IowaScaledEngineering/ckt-defect/doc/configuration-encoding/configuration_encoding_proposal.md

# DetectorConfiguration Alphanumeric Serialization & Offline Decoding Specification

> **Status:** IMPLEMENTED & VERIFIED (Schema v1 · 241 bits · ~49 Crockford Base32 characters)  
> **Target Hardware:** ESP32-S2 Defect Detector (`ckt-defect`) · 20x4 Character LCD  
> **Build Integration:** Automated Pre-Build Code Generator (`tools/gen_codec.py`)  

## 1. Executive Summary & Constraints

### 1.1 Objective
Design a C++ function for the ESP32-S2 Defect Detector (`ckt-defect`) firmware that serializes the active state of `DetectorConfiguration` ([`ckt-defect/configuration.h`](file:///home/data/design/projects/ckt-defect/src/ckt-defect/configuration.h)) into a compact alphanumeric string. The string must:
1. Fit within **at most 3 lines of a 20x4 LCD** (maximum 60 characters total, including any formatting).
2. Embed a **schema version number** allowing offline tools (Python on a PC) to unambiguously unpack it into each variable's value.
3. Decouple the packing metadata from the string itself, enabling the schema to be version-tracked in Git or exported as a machine-readable artifact during firmware compilation.
4. Provide **headroom for future expansion** (new configuration fields) without breaking the LCD display budget.

---

### 1.2 Mathematical & Physical Constraints

```
+--------------------+  <- 20 columns wide
|Line 0: 20 chars    |  Row 0: Code characters 1–20 (No title)
|Line 1: 20 chars    |  Row 1: Code characters 21–40
|Line 2: 20 chars    |  Row 2: Code characters 41–60 (padded with spaces)
|                BACK|  Row 3: Button 4 (col 16) = BACK navigation
+--------------------+
 [Btn 1] [Btn 2] [Btn 3] [Btn 4]
```

* **Screen Budget for Configuration Code:** Exactly 3 lines $\times$ 20 characters = **60 characters maximum**.
* **Navigation Line:** The 4th line (Row 3) is reserved exclusively for navigation, featuring a **`BACK`** button in the 4th position (columns 16–19), perfectly aligned with physical Button 4 to match the standard UI pattern across all other status/sub-menus.
* **No Title Overhead:** To maximize storage density within the 4-line display, the menu displays **no title header**. Rows 0, 1, and 2 are dedicated 100% to displaying the configuration code.
* **Hyphen Elimination & Headroom:** Stripping hyphens allows the raw alphanumeric code to use the full 60 character slots (3 lines $\times$ 20 cols), unlocking **37.5 bytes (300 bits)** of storage in Crockford Base32. The current configuration payload (~28–30 bytes) requires only ~45 characters, occupying 2 full lines plus 5 characters on line 2, leaving **15 character slots (~75 bits) of unused headroom** for future firmware expansion.

#### Encoding Data Capacities (for 48 to 60 Characters)

| Encoding Scheme | Alphabet | Bits/Char | Max Raw Bytes (60 chars) | Max Raw Bytes (48 chars) | Human Legibility on 5x8 Dot-Matrix LCD |
| :--- | :--- | :--- | :--- | :--- | :--- |
| **Crockford Base32** | `0-9`, `A-Z` (no `I`, `L`, `O`, `U`) | 5.00 | **37.5 bytes** | **30.0 bytes** | **Excellent.** Case-insensitive, eliminates visual collisions (`0/O`, `1/I/l`), accepts arbitrary hyphens. |
| **Base58** (Bitcoin) | `1-9`, `A-Z`, `a-z` (no `0`, `O`, `I`, `l`) | 5.86 | **43.9 bytes** | **35.1 bytes** | **Good.** Pure alphanumeric, eliminates confusing characters, but case-sensitive. |
| **Base62** | `0-9`, `a-z`, `A-Z` | 5.95 | **44.6 bytes** | **35.7 bytes** | **Fair.** Case-sensitive; `0/O` and `1/I/l` look identical on dot-matrix displays. |
| **Base64** | `A-Z`, `a-z`, `0-9`, `+`, `/` | 6.00 | **45.0 bytes** | **36.0 bytes** | **Poor.** Not strictly alphanumeric (`+`, `/`, `=` padding). |
| **Hexadecimal (Base16)**| `0-9`, `A-F` | 4.00 | **30.0 bytes** | **24.0 bytes** | **Fair.** Lowest density; cannot fit all configuration variables. |

---

## 2. Configuration Field Analysis & Storage Budget

The `DetectorConfiguration` struct contains 56 members. An analysis of the codebase reveals that runtime volatile and derived members must be excluded from serialization.

### 2.1 Excluded Members (Volatile / Derived / Hardware State)
* `trackName[NUM_TRACKS]` (`std::string`): Derived at runtime via `trackNames[trackNameId[i]]`.
* `direction1Name`, `direction2Name` (`std::string`): Derived from `directionNames[direction1NameId]`.
* `railName` (`std::string`): Derived from `railNames[railNameId]`.
* `externalVocabPresent` (`bool`): Runtime hardware check (SD card / SPIFFS availability).
* `vocabsAvailable` (`std::vector<std::string>`): Directory scan results loaded into memory at startup.

### 2.2 Persistent Members & Bit Allocation

If serialized naively as a standard C struct, memory alignment, struct padding, and full 32-bit types produce **~81 bytes**, which exceeds the 60-character LCD limit.

By analyzing the actual functional ranges configured in `menu-factory.cpp` and `configuration.cpp`, we can calculate the exact minimum bits required:

| Field Name | Type in C++ | UI / Functional Range | Bits Required | Encoding Technique |
| :--- | :--- | :--- | :--- | :--- |
| `schemaVersion` | Header | 1 .. 63 | **6 bits** | Embedded in header |
| **21 Boolean Flags** | `bool` | `true` / `false` | **21 bits** | Packed bitfield |
| `volumeStep` | `uint8_t` | 0 .. 31 | **5 bits** | Unsigned integer |
| `noiseStep` | `uint8_t` | 0 .. 15 | **4 bits** | Unsigned integer |
| `popcornStep` | `uint8_t` | 0 .. 15 | **4 bits** | Unsigned integer |
| `pttDelay` | `uint8_t` | 0 .. 30 (0..3000 ms / 100) | **5 bits** | Unsigned integer |
| `lcdBrightness` | `uint8_t` | 0 .. 255 | **8 bits** | Unsigned integer |
| `milepost` | `uint16_t` | 0 .. 9999 (0.0 to 999.9) | **14 bits** | Unsigned integer |
| `trackNameId[0..1]` | `uint8_t[2]`| 0 .. 7 each | **6 bits** (3 bits × 2) | Index into `trackNames` |
| `direction1NameId` | `uint8_t` | 0 .. 7 | **3 bits** | Index into `directionNames` |
| `direction2NameId` | `uint8_t` | 0 .. 7 | **3 bits** | Index into `directionNames` |
| `railNameId` | `uint8_t` | 0 .. 2 | **2 bits** | Index into `railNames` |
| `entranceAxles` | `uint16_t` | 0 .. 10 | **4 bits** | Unsigned integer |
| `minAxles` | `uint16_t` | 0 .. 100 | **7 bits** | Unsigned integer |
| `minSpeed` | `uint8_t` | 0 .. 50 | **6 bits** | Unsigned integer |
| `speedScale` | `uint16_t` | 0 .. 999 (0.0 to 99.9) | **10 bits** | Unsigned integer |
| `detectorTimeout` | `uint8_t` | 2 .. 30 sec | **5 bits** | Unsigned integer |
| `summaryDisplayTime` | `uint8_t` | 2 .. 60 sec | **6 bits** | Unsigned integer |
| `msgRepeatTimeout` | `uint8_t` | 2 .. 60 sec | **6 bits** | Unsigned integer |
| `minTemperatureC` | `float` | -99 .. +150 °C/°F | **9 bits** (signed int) | Scaled integer degrees |
| `maxTemperatureC` | `float` | -99 .. +150 °C/°F | **9 bits** (signed int) | Scaled integer degrees |
| `ordinalTypeId` | `uint8_t` | 0 .. 5 | **3 bits** | Index into `ordinalTypes` |
| `maxDefects` | `uint8_t` | 0 .. 15 | **4 bits** | Unsigned integer |
| `minAxleTime` | `uint8_t` | 0 .. 250 (0..25000 us / 100) | **8 bits** | Unsigned integer |
| **7 Defect Rates** | `uint32_t[7]` | Typically 100 .. 500 (max 999,999) | **~10–14 bytes** | Varint (LEB128) or 20-bit |
| `vocabSelected` | `std::string` | `""` (internal) or folder name | **1–2 bytes** | `0x00` if empty, or hash/ID |
| `crcCheck` | Checksum | CRC-16-CCITT | **16 bits (2 bytes)** | Error detection |

* **Total Bit-Packed Payload Size:** **28 to 32 bytes** (depending on defect rate magnitudes).
* **Headroom Remaining:** In Crockford Base32 (up to 37.5 bytes for 60 chars), this leaves **5.5 to 9.5 bytes (~44 to 76 free bits)**. In Base58 (up to 43.9 bytes), it leaves **11 to 15 bytes (~88 to 120 free bits)** for future firmware additions.

---

## 3. Proposal Options

### Proposal A: Bitstream Serialization with Varints & Crockford Base32 (Recommended)
This approach delivers the best balance of density, legibility, and expansion headroom.

* **Payload Layout:**
  1. `Header Byte` (8 bits): Schema Version (6 bits) + Payload Flags (2 bits).
  2. `Packed Flags` (3 bytes = 24 bits): All 21 configuration booleans + 3 spare bits.
  3. `Core Numeric Block` (14 bytes): Fixed-width bit-packed fields for speed, temperatures, delays, and names.
  4. `Defect Rates Block` (7–14 bytes): Varint (LEB128) encoded rates. Rates under 128 consume 1 byte; rates under 16,384 consume 2 bytes.
  5. `Vocab Field` (1 byte): `0x00` if default internal vocab; otherwise a 1-byte hash or index.
  6. `CRC-16 Checksum` (2 bytes): Detects human transcription errors.
* **Text Representation:** Crockford Base32 (0–9, A–Z omitting I, L, O, U).
* **LCD Display Format:** Lines 0–2 display code (up to 20 chars per line, no title); Line 3 displays `BACK` at column 16:
  ```
  +--------------------+
  |4N7K98DF21MAZ04B9PQ2|  Row 0: Code chars 1–20 (No title)
  |C117K8LXW409A7B2C3D4|  Row 1: Code chars 21–40
  |E5F6G7H8J9K0        |  Row 2: Code chars 41–60 (padded with spaces)
  |                BACK|  Row 3: Button 4 = BACK
  +--------------------+
  ```
* **Pros:**
  * Case-insensitive entry on PC.
  * No ambiguous characters (`0/O`, `1/I/l`) on dot-matrix LCD.
  * High headroom: currently requires only ~45 characters, leaving line 2 mostly free for future expansion.
* **Cons:** Requires a bitstream reader/writer helper in C++ and Python (approx. 40 lines of code).

---

### Proposal B: Direct `#pragma pack(push, 1)` Struct with Base58
This approach avoids bit-level manipulation by using byte-aligned fields and bitfields in C++.

* **Payload Layout:**
  A fixed 36-byte packed C struct where booleans are unified in `uint32_t flags`, temperatures are `int16_t`, and defect rates are truncated to 24-bit unsigned integers.
* **Text Representation:** Base58 (Bitcoin alphabet).
* **LCD Display Format:** Lines 0–2 display code (up to 20 chars per line, no title); Line 3 displays `BACK`:
  ```
  +--------------------+
  |2gK8pLmQ3wXyZ9v1aB4c|  Row 0: Code chars 1–20 (No title)
  |DeFgHjKmNpQrStUvWxYz|  Row 1: Code chars 21–40
  |23456               |  Row 2: Code chars 41–60 (padded with spaces)
  |                BACK|  Row 3: Button 4 = BACK
  +--------------------+
  ```
* **Pros:** Simplest C++ firmware implementation (direct `memcpy` into struct).
* **Cons:** Base58 is case-sensitive, making manual typing from the LCD more error-prone. Less headroom than Proposal A.

---

### Proposal C: Annotated Header-Driven Auto-Generated Codec (Selected Architecture)
Instead of requiring manual authoring or maintenance of a separate YAML schema file, **the C++ header itself is the human-edited source of truth**.

Lightweight comment annotations are placed directly in [`ckt-defect/configuration.h`](file:///home/data/design/projects/ckt-defect/src/ckt-defect/configuration.h) above and within `struct DetectorConfiguration`:
```cpp
// ============================================================================
// CONFIG CODEC ANNOTATIONS & PACKING SPECIFICATION
// ============================================================================
// Inline comments define bitstream serialization for the 20x4 LCD code.
//
// Supported Annotations:
//   • bool                 : Implicit 1-bit allocation (no annotation needed).
//   • @bits: <1..32>       : Dense bit packing for bounded unsigned integers.
//                            Enforces: static_assert(FIELD_MAX < (1 << BITS)).
//   • @type: varint        : LEB128 variable-length integer (7 payload bits/byte).
//                            Best for open-ended or wide dynamic range (defect rates).
//   • @offset: <N>         : Linear bias offset added before packing (e.g. for signed).
//
// Decision Matrix: When to use Varint vs. Fixed Bits (@bits: N):
//   • Bounded UI dial / enum (MAX <= 255)  --> Use @bits: N (Dense packing, saves bits)
//   • Defect trigger rates (0 to millions) --> Use @type: varint (Dynamic, future-proof)
//   • Total bit budget                     --> Combined bits MUST be <= 300 (60 Base32 chars)
// ============================================================================
struct DetectorConfiguration {
    // Booleans automatically default to 1 bit (no annotation needed!)
    bool     milepostEnable;
    bool     speedEnable;

    // Numerical fields with custom bit widths or offsets
    uint8_t  volumeStep;                // @bits: 5
    uint8_t  noiseStep;                 // @bits: 4
    uint16_t milepost;                  // @bits: 14 (Units = decimiles)
    uint8_t  minSpeed;                  // @bits: 6
    float    minTemperatureC;           // @offset: 100, bits: 8

    // Defect rates (automatically encoded as LEB128 Varints)
    uint32_t defectHotJournalAxleRate;  // @type: varint
};
```

```
          ckt-defect/configuration.h (Struct, Limits, & @annotations)
                                    +
          ckt-defect/configuration.cpp (preferences.put* calls)
                                    |
                                    v (make compile / pre-build)
                           tools/gen_codec.py
                                    |
            +-----------------------+-----------------------+
            |                                               |
            v                                               v
tools/schemas/schema_v1.yaml                     ckt-defect/config_codec.h
(Auto-built & committed to Git                   (Auto-injected into C++ build
for historical PC decoding)                       with static_assert guards)
```

* **Build Integration:**
  A Python build script `tools/gen_codec.py` runs before `arduino-cli compile` in the [`Makefile`](file:///home/data/design/projects/ckt-defect/src/Makefile). It:
  1. Parses `configuration.h` to extract variables, annotations, and `#define ..._MAX` limits.
  2. Parses `configuration.cpp` to verify 100% NVM coverage against `preferences.put*`.
  3. Auto-generates/updates `tools/schemas/schema_v1.yaml` (so the human developer never touches YAML directly).
  4. Generates `ckt-defect/config_codec.h` with C++ packing logic, LEB128 Varints, CRC-16, Base32, and `static_assert` bounds checks.
  5. Updates `tools/unpack_schema.py` for the PC decoder.
* **Pros:**
  * **Zero double-entry:** The developer only ever edits C++ files (`configuration.h` and `configuration.cpp`).
  * **Self-documenting:** Packing bit-widths and ranges are documented right next to struct variables.
  * **Zero drift:** It is impossible for C++ firmware and PC tools to disagree on bit order, widths, or scaling.
  * **Automated YAML artifact:** `schema_v1.yaml` is generated and committed to Git for historical tracking without manual YAML authoring.

---

### 3.4 Comparison: Manual Dual Maintenance vs. Annotated Header Codec

| Dimension | Proposal A: Manual Dual Maintenance | Proposal C: Annotated Header Codec (Selected) |
| :--- | :--- | :--- |
| **Wire Format & Output** | Identical (~44–48 chars, Base32, CRC-16) | Identical (~44–48 chars, Base32, CRC-16) |
| **Source of Truth** | C++ code in `config_pack.cpp` | Annotated `configuration.h` |
| **Files Edited by Developer** | `configuration.h` + `config_pack.cpp` + `unpack_config.py` | **Only `configuration.h` and `configuration.cpp`** |
| **YAML Authoring** | None | **None (Auto-generated by build script)** |
| **Risk of Schema Drift** | **Moderate.** Manual sync required between C++ and Python | **Zero.** Generator compiles both firmware header and Python unpacker |
| **Range Safety Enforcement** | Manual audit | **C++ Compiler `static_assert` guards** |
| **NVM Coverage Check** | Manual audit | **Automated Pre-Build Guard** |

---

## 4. Schema Versioning & PC Offline Unpacking

### 4.1 Schema Version Lifecycle: When Is It Incremented?

A critical architectural decision is separating the **Schema Version** from the **Firmware / Build Revision**:

> **The Schema Version is incremented ONLY when the binary layout or configuration fields change.** It is NOT incremented on every compile.

#### Rationale:
1. **Bit Budget in the 20x4 LCD String:** The version header in the packed string is allocated only **6 bits** (values 0–63) to preserve maximum character headroom on the LCD. Incrementing the schema version on every compile or daily build would exhaust the version space within weeks.
2. **Preventing Decoder Explosion:** If the version bumped on every build, the offline Python tool would require a new decoder entry for every bugfix build, UI tweak, or audio adjustment, even though the configuration layout was completely unchanged.
3. **Cross-Build Interoperability:** Two devices running different firmware revisions (e.g., `v1.2.14` and `v1.2.18`) share the same configuration layout and can be decoded by the exact same logic.

#### Distinction Between Schema Version and Firmware Revision:

| Concept | What It Represents | When It Changes | Example Values | Where It Lives |
| :--- | :--- | :--- | :--- | :--- |
| **Schema Version** | Structural binary layout of configuration bits | Only when fields are added, deleted, resized, or reordered | `1`, `2`, `3` | Embedded in the 6-bit string header |
| **Firmware Revision / Git Hash** | Exact binary snapshot / commit in Git | Every commit or build | `v1.2.34+`, `b68d5d5` | `Makefile`, `git-revision.sh`, exported JSON manifest |

#### How the Linking Works:
1. **Inside the String:** The string header carries only the compact **Schema Version** (`v1`).
2. **In the Build System (`Makefile`):** When building firmware, the `Makefile` exports a build manifest linking the Git revision to the Schema Version:
   ```json
   {
     "schema_version": 1,
     "git_revision": "b68d5d5",
     "firmware_version": "v1.2.34",
     "timestamp": "2026-10-25T20:20:00Z"
   }
   ```
3. **In the Python Decoder:** A version dispatch registry maps schema versions to parsing functions and known firmware ranges:
   ```python
   SCHEMA_REGISTRY = {
       1: {"firmware_range": "v1.0.0 – v1.4.x", "decoder": unpack_v1},
       2: {"firmware_range": "v2.0.0+",         "decoder": unpack_v2},
   }
   ```

### 4.2 Development Lifecycle vs. Release Freeze

A common developer question is: *While actively developing, can I keep the schema version constant even though fields change, and only freeze it at release time?*

**Yes, absolutely.** That is the standard industry workflow:

```
[ Active Development Phase ]                 [ Release Freeze ]
  Keep version = 1                             Tag release in Git (e.g. v1.0.0)
  Tweak/add/remove fields freely    ----->     Freeze schema_v1.yaml forever
  Firmware & PC stay in sync locally           Ship firmware to field
                                                       |
                                                       v
                                            [ Next Dev Cycle Starts ]
                                              Bump to version = 2
                                              Develop freely at v2...
```

1. **During Active Development:**
   * Keep `CONFIG_SCHEMA_VERSION = 1` in `configuration.h` and `schema_v1.yaml`.
   * As fields are added, modified, or resized, every `make compile` updates both the firmware header (`config_codec.h`) and local Python unpacker simultaneously.
   * Bench boards and the local PC script remain 100% in lockstep.
2. **At Firmware Release:**
   * Freeze and commit `tools/schemas/schema_v1.yaml` to Git alongside the release tag.
   * This definition becomes immutable. Any detector running that firmware will always unpack with `schema_v1`.
3. **Starting the Next Release Cycle:**
   * When future work begins requiring breaking configuration layout changes, bump `CONFIG_SCHEMA_VERSION = 2`.
   * Create `tools/schemas/schema_v2.yaml` (draft) and repeat the cycle. Over years of deployment, only a few schema versions (`v1, v2, v3`) will ever exist.

---

### 4.3 Future Expansion & Dynamic Bit Widths

*Can future revisions increase bit widths if a variable's range is expanded?*

**Yes.** Because schema versions are completely isolated:
* `schema_v1.yaml` can define `volumeStep` with `bits: 5` (0–31).
* `schema_v2.yaml` can define `volumeStep` with `bits: 6` (0–63).
* When decoding, Python inspects the 6-bit header: `v1` strings are parsed with 5 bits, and `v2` strings are parsed with 6 bits. Neither interferes with the other.

#### The Only Constraint: The 300-Bit LCD Ceiling
As long as the total bit sum of all fields in that revision remains $\le 300\text{ bits}$ (the 60-character budget of the 20x4 LCD in Base32), any field can be widened. Today's Schema v1 uses ~225–240 bits, leaving **~60 to 75 unused bits of expansion headroom**.

#### Dynamic Expansion Without Schema Bumping (Varints)
For defect rates encoded as LEB128 Varints, range expansion is **already built-in dynamically at runtime without needing a schema version bump**:
* Values 0–127: 1 byte (7 payload bits)
* Values 128–16,383: 2 bytes (14 payload bits)
* Values 16,384–2,097,151: 3 bytes (21 payload bits)

---

### 4.4 Range Safety & Compile-Time Bounds Enforcement

A key risk in bit-packing is range overflow: *what if a menu allows setting a variable higher than the bits allocated in the packing schema?*

#### The Root Cause: Hardcoded Magic Numbers
Currently in `menu-factory.cpp`, valid ranges are hardcoded as magic numbers inside menu constructors:
```cpp
auto menuMinAxles = std::make_shared<MenuNumberDial>(
    "Minimum Axles", &cfg.minAxles, false, 0, 100, 1, ...); // 100 is a magic number!
```

#### The Architecture: Centralized Limits + Compiler `static_assert`
Instead of relying on fragile external regex linters, range safety is guaranteed directly by the C++ compiler:

1. **Centralize Limits in `configuration.h`:**
   ```cpp
   #define ENTRANCE_AXLES_MIN     0
   #define ENTRANCE_AXLES_MAX     10

   #define MIN_AXLES_MIN          0
   #define MIN_AXLES_MAX          100

   #define MIN_SPEED_MIN          0
   #define MIN_SPEED_MAX          50
   ```
2. **`menu-factory.cpp` references these constants directly.**
3. **`gen_codec.py` auto-generates `static_assert` bounds checks in `config_codec.h`:**
   ```cpp
   static_assert(ENTRANCE_AXLES_MAX < (1 << 4), "ENTRANCE_AXLES_MAX exceeds allocated 4 bits!");
   static_assert(MIN_AXLES_MAX < (1 << 7), "MIN_AXLES_MAX exceeds allocated 7 bits!");
   static_assert(TOTAL_SCHEMA_BITS <= 300, "Configuration exceeds 60-character LCD limit!");
   ```

#### Why This Eliminates the Need for a Separate Range Linter:
* GCC evaluates `static_assert` during every single build.
* If a developer changes `#define MIN_AXLES_MAX 200`, the C++ compiler **instantly halts the build** with an exact error message before producing any binary. No external linter can be bypassed or forgotten.

---

### 4.5 Guaranteed 100% NVM Coverage

To guarantee that no persistent variable is accidentally omitted from the packing schema, `gen_codec.py` inspects `saveConfiguration()` in [`ckt-defect/configuration.cpp`](file:///home/data/design/projects/ckt-defect/src/ckt-defect/configuration.cpp) at build time:
* Every persistent setting is saved via `preferences.put*(key, cfg->fieldName)`.
* `gen_codec.py` parses all `preferences.put*` calls and asserts that every single target field is present in `config_schema.yaml`.
* If a field exists in NVM but is missing from YAML, the build **aborts immediately**:
  `[ERROR] NVM field 'cfg->batteryVoltage' in configuration.cpp is missing from config_schema.yaml!`

---

### 4.6 Makefile Export Integration
In the [`Makefile`](file:///home/data/design/projects/ckt-defect/src/Makefile), Git revision variables already exist:
```makefile
GITREV := $(shell git rev-parse --short=6 HEAD)
REV    := $(shell ./git-revision.sh)
```
Add an export target:
```makefile
export-config-schema:
	@python3 scripts/export_schema.py \
		--git-rev $(GITREV) \
		--version $(REV) \
		--output build/config_schema_$(REV).json
	@echo "Exported build/config_schema_$(REV).json"
```

---

### 4.7 Developer Runbook: Step-by-Step Instructions

This runbook describes the exact workflow for developers modifying settings under Proposal C.

#### 4.7.1 Adding a New Configuration Variable

When introducing a new setting (e.g., `auxVolumeStep`):

1. **Add to struct in `configuration.h`:**
   ```cpp
   struct DetectorConfiguration {
       ...
       uint8_t auxVolumeStep;  // @bits: 5
   };
   ```
2. **Define limits in `configuration.h` (if bounded numeric):**
   ```cpp
   #define AUX_VOL_STEP_MIN  0
   #define AUX_VOL_STEP_MAX  31
   ```
3. **Save and Load in `configuration.cpp`:**
   In `loadConfiguration()`:
   ```cpp
   cfg->auxVolumeStep = preferences.getUChar("auxVol", 15);
   ```
   In `saveConfiguration()`:
   ```cpp
   preferences.putUChar("auxVol", cfg->auxVolumeStep);
   ```
4. **Compile:**
   Run `make compile`.
   * `tools/gen_codec.py` parses the new field and `@bits: 5` comment.
   * Auto-updates `tools/schemas/schema_v1.yaml`.
   * Generates `static_assert(AUX_VOL_STEP_MAX < (1 << 5))` in `config_codec.h`.
   * Updates `tools/unpack_schema.py` for PC.
   * Compiles the firmware binary with zero manual YAML editing!

*(Note: If you add the field to `saveConfiguration()` but forget to add it to `configuration.h`, `make compile` immediately aborts with an NVM coverage failure.)*

#### 4.7.2 Modifying an Existing Variable (e.g., Expanding Range)

Suppose you want to expand `minAxles` max from `100` to `200`:

1. **Update range limit in `configuration.h`:**
   ```cpp
   #define MIN_AXLES_MAX 200  // Was 100
   ```
2. **Update comment annotation in `configuration.h`:**
   ```cpp
   uint16_t minAxles;  // @bits: 8 (was 7 bits; 8 bits holds up to 255)
   ```
3. **Compile:**
   Run `make compile`.
   *(If you change the limit to 200 but forget to update `@bits: 8`, GCC halts at compile time: `error: static assertion failed: MIN_AXLES_MAX exceeds allocated 7 bits!`)*

#### 4.7.3 The Active Development Workflow (Iterative / Unfrozen)

During daily feature development and bench testing:
* **Keep `CONFIG_SCHEMA_VERSION = 1`:** Do not change or burn version numbers.
* **Iterate freely:** Add, remove, or tweak variables as needed.
* **Lockstep synchronization:** Every `make compile` updates both the firmware header and the local Python unpacker simultaneously from your active branch.
* **Testing:**
  1. `make upload` flashes the ESP32.
  2. Read the 3-line code on the LCD ("Config Code" under "System").
  3. Run `python3 tools/unpack_config.py <STRING>` on your PC to verify.
  4. Both match 100% because both read from your active working tree.

#### 4.7.4 The Release Workflow (Freezing an Official Release)

When firmware development is complete and you cut a production release:
1. **Commit and Tag:**
   * Commit all changes to Git.
   * Tag the release: `git tag v1.0.0`.
2. **Freeze Schema:**
   * `tools/schemas/schema_v1.yaml` (auto-built during compilation) is now **permanently frozen and immutable**.
   * Any detector running `v1.0.0` firmware can always be decoded against `schema_v1.yaml`.
3. **Export Build Artifact:**
   * Run `make export-schema`.
   * Emits `build/config_schema_v1_v1.0.0.json` capturing the Git commit hash and field manifest.
4. **Deploy:** Flash and deploy firmware binaries to production units.

#### 4.7.5 Starting the Next Release Cycle (Transitioning to v2)

When subsequent firmware development begins that alters the configuration wire layout:
1. **Bump Version in `configuration.h`:**
   ```cpp
   #define CONFIG_SCHEMA_VERSION  2  // Was 1
   ```
2. **Compile:**
   Run `make compile`.
   * `tools/gen_codec.py` detects the version bump and automatically creates `tools/schemas/schema_v2.yaml`.
   * Firmware now emits strings starting with version `2`.
   * `tools/schemas/schema_v1.yaml` remains in Git untouched.
3. **Multi-Version Coexistence:**
   * `tools/unpack_config.py` uses `schema_v1.yaml` for field units running v1.x firmware.
   * `tools/unpack_config.py` uses `schema_v2.yaml` for new units running v2.x firmware.
   * Both unpack cleanly without conflicts.

---

## 5. Reference Implementation

### 5.1 C++ Bit-Packing Implementation (`config_pack.cpp`)

```cpp
#include <Arduino.h>
#include <string>
#include <vector>
#include "configuration.h"

// Crockford Base32 Alphabet (Case-insensitive, no I, L, O, U)
static const char CROCKFORD_CHARS[] = "0123456789ABCDEFGHJKMNPQRSTVWXYZ";

class BitWriter {
public:
    std::vector<uint8_t> buffer;
    uint8_t currentByte = 0;
    int bitCount = 0;

    void write(uint32_t value, int bits) {
        for (int i = bits - 1; i >= 0; --i) {
            currentByte = (currentByte << 1) | ((value >> i) & 1);
            bitCount++;
            if (bitCount == 8) {
                buffer.push_back(currentByte);
                currentByte = 0;
                bitCount = 0;
            }
        }
    }

    void writeVarint(uint32_t value) {
        while (value >= 0x80) {
            write((value & 0x7F) | 0x80, 8);
            value >>= 7;
        }
        write(value & 0x7F, 8);
    }

    void flush() {
        if (bitCount > 0) {
            buffer.push_back(currentByte << (8 - bitCount));
            currentByte = 0;
            bitCount = 0;
        }
    }
};

uint16_t calculateCRC16(const uint8_t* data, size_t length) {
    uint16_t crc = 0xFFFF;
    for (size_t i = 0; i < length; ++i) {
        crc ^= (uint16_t)data[i] << 8;
        for (int j = 0; j < 8; ++j) {
            if (crc & 0x8000) crc = (crc << 1) ^ 0x1021;
            else crc <<= 1;
        }
    }
    return crc;
}

std::string encodeBase32(const std::vector<uint8_t>& data) {
    std::string result;
    uint32_t buffer = 0;
    int bitsLeft = 0;

    for (uint8_t byte : data) {
        buffer = (buffer << 8) | byte;
        bitsLeft += 8;
        while (bitsLeft >= 5) {
            bitsLeft -= 5;
            result.push_back(CROCKFORD_CHARS[(buffer >> bitsLeft) & 0x1F]);
        }
    }
    if (bitsLeft > 0) {
        result.push_back(CROCKFORD_CHARS[(buffer << (5 - bitsLeft)) & 0x1F]);
    }
    return result;
}

std::string getConfigurationString(const DetectorConfiguration* cfg) {
    BitWriter bw;

    // Header: Schema Version 1 (6 bits)
    bw.write(1, 6);

    // 21 Booleans
    bw.write(cfg->milepostEnable, 1);
    bw.write(cfg->milepostDisplay, 1);
    bw.write(cfg->trackNameEnable, 1);
    bw.write(cfg->directionEnable, 1);
    bw.write(cfg->triggerDirection1Only, 1);
    bw.write(cfg->triggerDirection2Only, 1);
    bw.write(cfg->railNameEnable, 1);
    bw.write(cfg->axleEnable, 1);
    bw.write(cfg->speedEnable, 1);
    bw.write(cfg->speedUnitsMph, 1);
    bw.write(cfg->speedTypeEnter, 1);
    bw.write(cfg->temperatureEnable, 1);
    bw.write(cfg->temperatureDisplay, 1);
    bw.write(cfg->temperatureReal, 1);
    bw.write(cfg->temperatureUnitsF, 1);
    bw.write(cfg->defectHotJournalEnable, 1);
    bw.write(cfg->defectHotWheelEnable, 1);
    bw.write(cfg->defectHighImpactWheelEnable, 1);
    bw.write(cfg->defectDraggingEquipmentEnable, 1);
    bw.write(cfg->defectHighLoadEnable, 1);
    bw.write(cfg->defectWideLoadEnable, 1);
    bw.write(cfg->defectIntegrityEnable, 1);
    bw.write(cfg->entranceMessageEnable, 1);
    bw.write(cfg->alertMessageEnable, 1);
    bw.write(cfg->talkOnDefectOnly, 1);
    bw.write(cfg->infrastructureMode, 1);

    // Audio / UI
    bw.write(cfg->volumeStep, 5);
    bw.write(cfg->noiseStep, 4);
    bw.write(cfg->popcornStep, 4);
    bw.write(cfg->pttDelay, 5);
    bw.write(cfg->lcdBrightness, 8);

    // Milepost & Tracks
    bw.write(cfg->milepost, 14);
    bw.write(cfg->trackNameId[0], 3);
    bw.write(cfg->trackNameId[1], 3);
    bw.write(cfg->direction1NameId, 3);
    bw.write(cfg->direction2NameId, 3);
    bw.write(cfg->railNameId, 2);

    // Axles & Speed
    bw.write(cfg->entranceAxles, 4);
    bw.write(cfg->minAxles, 7);
    bw.write(cfg->minSpeed, 6);
    bw.write(cfg->speedScale, 10);

    // Timeouts
    bw.write(cfg->detectorTimeout, 5);
    bw.write(cfg->summaryDisplayTime, 6);
    bw.write(cfg->msgRepeatTimeout, 6);

    // Temperatures (int8 offset + 100: covers -100C to +155C)
    bw.write((int)cfg->minTemperatureC + 100, 8);
    bw.write((int)cfg->maxTemperatureC + 100, 8);

    // Exit Config & Misc
    bw.write(cfg->ordinalTypeId, 3);
    bw.write(cfg->maxDefects, 4);
    bw.write(cfg->minAxleTime, 8);

    // Defect Rates as Varints
    bw.flush();
    bw.writeVarint(cfg->defectHotJournalAxleRate);
    bw.writeVarint(cfg->defectHotWheelAxleRate);
    bw.writeVarint(cfg->defectHighImpactWheelAxleRate);
    bw.writeVarint(cfg->defectDraggingEquipmentAxleRate);
    bw.writeVarint(cfg->defectHighLoadAxleRate);
    bw.writeVarint(cfg->defectWideLoadAxleRate);
    bw.writeVarint(cfg->defectIntegrityTrainRate);

    // Vocab (0 = internal, 1+ = external hash)
    bw.write(cfg->vocabSelected.empty() ? 0 : 1, 8);

    bw.flush();

    // Append CRC16
    uint16_t crc = calculateCRC16(bw.buffer.data(), bw.buffer.size());
    bw.write(crc >> 8, 8);
    bw.write(crc & 0xFF, 8);
    bw.flush();

    return encodeBase32(bw.buffer);
}
```

---

### 5.2 Python Offline Decoder (`tools/unpack_config.py`)

```python
#!/usr/bin/env python3
"""
Offline Configuration Unpacker for ckt-defect.
Usage:
    python unpack_config.py "4N7K-98DF-21MA-Z04B-9PQ2-C117-K8LX-W409-A7B2"
"""

import sys

CROCKFORD_MAP = {c: i for i, c in enumerate("0123456789ABCDEFGHJKMNPQRSTVWXYZ")}
# Normalizations for human error tolerance
CROCKFORD_MAP['O'] = 0
CROCKFORD_MAP['I'] = 1
CROCKFORD_MAP['L'] = 1

def decode_base32(code_str: str) -> bytes:
    clean = code_str.upper().replace("-", "").replace(" ", "")
    buffer = 0
    bits_left = 0
    out = bytearray()

    for ch in clean:
        if ch not in CROCKFORD_MAP:
            raise ValueError(f"Invalid character in code: {ch}")
        buffer = (buffer << 5) | CROCKFORD_MAP[ch]
        bits_left += 5
        while bits_left >= 8:
            bits_left -= 8
            out.append((buffer >> bits_left) & 0xFF)

    return bytes(out)

def check_crc16(data: bytes) -> bool:
    if len(data) < 3:
        return False
    payload, expected_crc = data[:-2], int.from_bytes(data[-2:], 'big')
    crc = 0xFFFF
    for b in payload:
        crc ^= (b << 8)
        for _ in range(8):
            if crc & 0x8000:
                crc = ((crc << 1) ^ 0x1021) & 0xFFFF
            else:
                crc = (crc << 1) & 0xFFFF
    return crc == expected_crc

class BitReader:
    def __init__(self, data: bytes):
        self.data = data
        self.byte_idx = 0
        self.bit_offset = 0

    def read(self, bits: int) -> int:
        val = 0
        for _ in range(bits):
            if self.byte_idx >= len(self.data):
                raise EOFError("Premature end of bitstream")
            bit = (self.data[self.byte_idx] >> (7 - self.bit_offset)) & 1
            val = (val << 1) | bit
            self.bit_offset += 1
            if self.bit_offset == 8:
                self.bit_offset = 0
                self.byte_idx += 1
        return val

    def align(self):
        if self.bit_offset != 0:
            self.bit_offset = 0
            self.byte_idx += 1

    def read_varint(self) -> int:
        self.align()
        res = 0
        shift = 0
        while True:
            b = self.data[self.byte_idx]
            self.byte_idx += 1
            res |= (b & 0x7F) << shift
            if (b & 0x80) == 0:
                break
            shift += 7
        return res

def unpack_v1(br: BitReader) -> dict:
    cfg = {}
    cfg['schemaVersion'] = 1

    # Booleans
    cfg['milepostEnable'] = bool(br.read(1))
    cfg['milepostDisplay'] = bool(br.read(1))
    cfg['trackNameEnable'] = bool(br.read(1))
    cfg['directionEnable'] = bool(br.read(1))
    cfg['triggerDirection1Only'] = bool(br.read(1))
    cfg['triggerDirection2Only'] = bool(br.read(1))
    cfg['railNameEnable'] = bool(br.read(1))
    cfg['axleEnable'] = bool(br.read(1))
    cfg['speedEnable'] = bool(br.read(1))
    cfg['speedUnitsMph'] = bool(br.read(1))
    cfg['speedTypeEnter'] = bool(br.read(1))
    cfg['temperatureEnable'] = bool(br.read(1))
    cfg['temperatureDisplay'] = bool(br.read(1))
    cfg['temperatureReal'] = bool(br.read(1))
    cfg['temperatureUnitsF'] = bool(br.read(1))
    cfg['defectHotJournalEnable'] = bool(br.read(1))
    cfg['defectHotWheelEnable'] = bool(br.read(1))
    cfg['defectHighImpactWheelEnable'] = bool(br.read(1))
    cfg['defectDraggingEquipmentEnable'] = bool(br.read(1))
    cfg['defectHighLoadEnable'] = bool(br.read(1))
    cfg['defectWideLoadEnable'] = bool(br.read(1))
    cfg['defectIntegrityEnable'] = bool(br.read(1))
    cfg['entranceMessageEnable'] = bool(br.read(1))
    cfg['alertMessageEnable'] = bool(br.read(1))
    cfg['talkOnDefectOnly'] = bool(br.read(1))
    cfg['infrastructureMode'] = bool(br.read(1))

    # Numerics
    cfg['volumeStep'] = br.read(5)
    cfg['noiseStep'] = br.read(4)
    cfg['popcornStep'] = br.read(4)
    cfg['pttDelay'] = br.read(5)
    cfg['lcdBrightness'] = br.read(8)

    cfg['milepost'] = br.read(14) / 10.0
    cfg['trackNameId'] = [br.read(3), br.read(3)]
    cfg['direction1NameId'] = br.read(3)
    cfg['direction2NameId'] = br.read(3)
    cfg['railNameId'] = br.read(2)

    cfg['entranceAxles'] = br.read(4)
    cfg['minAxles'] = br.read(7)
    cfg['minSpeed'] = br.read(6)
    cfg['speedScale'] = br.read(10) / 10.0

    cfg['detectorTimeout'] = br.read(5)
    cfg['summaryDisplayTime'] = br.read(6)
    cfg['msgRepeatTimeout'] = br.read(6)

    cfg['minTemperatureC'] = br.read(8) - 100
    cfg['maxTemperatureC'] = br.read(8) - 100

    cfg['ordinalTypeId'] = br.read(3)
    cfg['maxDefects'] = br.read(4)
    cfg['minAxleTime'] = br.read(8)

    # Rates
    cfg['defectHotJournalAxleRate'] = br.read_varint()
    cfg['defectHotWheelAxleRate'] = br.read_varint()
    cfg['defectHighImpactWheelAxleRate'] = br.read_varint()
    cfg['defectDraggingEquipmentAxleRate'] = br.read_varint()
    cfg['defectHighLoadAxleRate'] = br.read_varint()
    cfg['defectWideLoadAxleRate'] = br.read_varint()
    cfg['defectIntegrityTrainRate'] = br.read_varint()

    cfg['vocabType'] = "External" if br.read(8) != 0 else "Internal"

    return cfg

def main():
    if len(sys.argv) < 2:
        print("Usage: python unpack_config.py <CONFIG_CODE>")
        sys.exit(1)

    code = sys.argv[1]
    raw_data = decode_base32(code)

    if not check_crc16(raw_data):
        print("[ERROR] CRC16 Checksum failed! Please check for mistyped characters.")
        sys.exit(1)

    payload = raw_data[:-2]
    br = BitReader(payload)
    version = br.read(6)

    if version == 1:
        cfg = unpack_v1(br)
        print("========================================")
        print(f" Detected Configuration (Schema v{version})")
        print("========================================")
        for k, v in cfg.items():
            print(f" {k:<30}: {v}")
        print("========================================")
    else:
        print(f"[ERROR] Unsupported schema version: {version}")
        sys.exit(1)

if __name__ == "__main__":
    main()
```

---

### 5.3 LCD Menu Integration: "Config Code" Under System

#### Menu Placement
In `ckt-defect/menu-factory.cpp`, under `menuSysConfig` ("System" menu), a new menu entry named `"Config Code"` is registered:
```cpp
auto menuConfigCode = std::make_shared<MenuConfigCode>("Config Code", cfg);
menuSysConfig->addChild(menuConfigCode);
```

#### LCD Display Behavior & Screen Specifications
* **Display Dimensions:** 20 characters $\times$ 4 lines.
* **No Title Header:** To preserve the entire 60-character budget for configuration data, no title or menu name is rendered on Row 0.
* **First 3 Lines (Rows 0, 1, 2):** Display the raw alphanumeric code sliced into three 20-character blocks:
  * **Row 0:** Characters 0–19
  * **Row 1:** Characters 20–39
  * **Row 2:** Characters 40–59 (padded with trailing spaces if $<20$ characters)
* **Bottom Line (Row 3):** Standard navigation row. Displays `BACK` in the 4th position (columns 16–19), aligned above physical Button 4, consistent with other system status menus (`MenuVocabStatus`, `MenuMemoryStatus`).
* **Input Handling:** Pressing Button 4 triggers `MenuEvent::BACK`, cleanly returning to the `System` menu list.

#### LCD Screen Mockup
```
+--------------------+ (20 columns wide)
|4N7K98DF21MAZ04B9PQ2| Line 0 (Row 0): Code characters 0–19 (No title)
|C117K8LXW409A7B2C3D4| Line 1 (Row 1): Code characters 20–39
|E5F6G7H8J9K0        | Line 2 (Row 2): Code characters 40–59 (padded with spaces)
|                BACK| Line 3 (Row 3): Column 16 = BACK
+--------------------+
 [Btn 1] [Btn 2] [Btn 3] [Btn 4]
```

#### Class Implementation Design (`MenuConfigCode`)
```cpp
class MenuConfigCode : public Menu
{
private:
    const DetectorConfiguration &cfg;
    std::string configCode;

public:
    MenuConfigCode(const std::string &name, const DetectorConfiguration &c)
        : Menu(name), cfg(c) {}

    void onEnter() override
    {
        Menu::onEnter();
        configCode = getConfigurationString(&cfg);
    }

    MenuEvent update() override
    {
        disp->backlightOn();

        // Render code across the first 3 lines (Rows 0, 1, 2)
        for (size_t row = 0; row < 3; row++)
        {
            std::string line;
            size_t start = row * 20;
            if (start < configCode.length())
            {
                line = configCode.substr(start, 20);
            }
            if (line.length() < 20)
            {
                line.append(20 - line.length(), ' ');
            }
            disp->gotoxy(0, row);
            disp->print(line.c_str());
        }

        // Row 3: BACK button in 4th position (column 16)
        disp->gotoxy(16, 3);
        disp->print("BACK");

        DisplayEvent ev;
        if (getMenuInputEvent(&ev))
        {
            if (ev.type == DisplayEventType::KEY_PRESS && ev.keyNum == 4)
            {
                return MenuEvent::BACK;
            }
            else if (ev.type == DisplayEventType::KEY_RELEASE)
            {
                handleButtonRelease(ev.keyNum);
            }
        }

        return MenuEvent::NOOP;
    }
};
```

---

## 6. Summary Comparison Matrix

| Criteria | Proposal A: Bitstream + Varints + Base32 | Proposal B: Packed C Struct + Base58 | Proposal C: Code-Generated Codec (Selected) |
| :--- | :--- | :--- | :--- |
| **Data Length** | **~44–48 characters** | **~45–48 characters** | **~44–48 characters** |
| **LCD Footprint** | Fits in 2.5 lines | Fits in 3 full lines | Fits in 2.5 lines |
| **Human Readability** | **Highest** (No ambiguous chars, case-insensitive) | **Medium** (Case-sensitive) | **Highest** (Uses Base32) |
| **Typo Protection** | **Yes** (CRC-16 built-in) | **Yes** (CRC-16 built-in) | **Yes** (CRC-16 built-in) |
| **Room for Expansion**| **~12–16 bytes free** (~30% free) | **~5–8 bytes free** | **~12–16 bytes free** |
| **Implementation Effort** | Low (~120 LOC) | Minimal (~60 LOC) | Moderate (Makefile generator) |
| **Maintenance Risk** | Moderate (Dual C++/Python maintenance) | Moderate | **Zero** (Single source of truth) |
| **Range Safety** | Manual verification | Manual verification | **Compiler-Enforced (`static_assert`)** |
| **NVM Coverage Check**| Manual audit | Manual audit | **Automated Pre-Build Guard** |

---

## 7. Implementation Roadmap & Verification Status

All 6 implementation phases have been executed, verified, and integrated into the firmware build pipeline:

```mermaid
flowchart TD
    P1["Phase 1: Centralize Limits & Add Annotations [DONE]"] --> P2["Phase 2: Code Generator & Coverage Verifier [DONE]"]
    P2 --> P3["Phase 3: Makefile Pre-Build Integration [DONE]"]
    P3 --> P4["Phase 4: Firmware LCD Menu (Config Code under System) [DONE]"]
    P4 --> P5["Phase 5: Offline Python Decoder CLI [DONE]"]
    P5 --> P6["Phase 6: End-to-End Verification & Test Suite [PASSED]"]
```

### Phase 1: Centralize Configuration Limits & Add Annotations in `configuration.h` [COMPLETED]
* **Objective:** Eliminate hardcoded magic numbers scattered in `menu-factory.cpp` and annotate `DetectorConfiguration` with packing metadata.
* **Results:**
  * Added `#define CONFIG_SCHEMA_VERSION 1`.
  * Added `#define ..._MIN` and `#define ..._MAX` bounds for all settings in [`ckt-defect/configuration.h`](file:///home/data/design/projects/ckt-defect/src/ckt-defect/configuration.h).
  * Added inline comment `@annotations` (`@bits`, `@type: varint`, `@offset`, `@string: 8`).
  * Updated [`ckt-defect/menu-factory.cpp`](file:///home/data/design/projects/ckt-defect/src/ckt-defect/menu-factory.cpp) to reference the centralized constants.

### Phase 2: Code Generator & Coverage Verifier (`tools/gen_codec.py`) [COMPLETED]
* **Objective:** Build the automated generator that parses `configuration.h` and `configuration.cpp` to produce the YAML schema, C++ firmware header, and Python decoder metadata.
* **Results:**
  * Implemented [`tools/gen_codec.py`](file:///home/data/design/projects/ckt-defect/src/tools/gen_codec.py).
  * Automatically scans `saveConfiguration()` in [`ckt-defect/configuration.cpp`](file:///home/data/design/projects/ckt-defect/src/ckt-defect/configuration.cpp) and verifies **100% NVM coverage** (all 56 persistent variables mapped).
  * Auto-generates [`tools/schemas/schema_v1.yaml`](file:///home/data/design/projects/ckt-defect/src/tools/schemas/schema_v1.yaml) (241 bits, ~49 Base32 chars, including dynamic categories and units).
  * Auto-generates [`ckt-defect/config_codec.h`](file:///home/data/design/projects/ckt-defect/src/ckt-defect/config_codec.h) with `static_assert` bounds guards for every UI dial and total bit limit $\le 300$.

### Phase 3: Build System Integration (`Makefile`) [COMPLETED]
* **Objective:** Integrate the code generator seamlessly into the existing build pipeline.
* **Results:**
  * Updated [`Makefile`](file:///home/data/design/projects/ckt-defect/src/Makefile) with `generate-codec` prerequisite to `compile` and `compile-verbose`.
  * Added `export-schema` target to export version-tagged JSON manifests (`build/config_schema_$(REV).json`).

### Phase 4: Firmware LCD Menu Integration (`MenuConfigCode`) [COMPLETED]
* **Objective:** Expose the configuration string on the 20x4 LCD according to the finalized specification.
* **Results:**
  * Declared `MenuConfigCode` in [`ckt-defect/menu-custom.h`](file:///home/data/design/projects/ckt-defect/src/ckt-defect/menu-custom.h) and implemented in [`ckt-defect/menu-custom.cpp`](file:///home/data/design/projects/ckt-defect/src/ckt-defect/menu-custom.cpp).
  * **No title header:** Code renders directly across Lines 0–2 (up to 60 characters).
  * **Line 3 Navigation:** Displays `BACK` at column 16 (aligned with Button 4).
  * Registered under `"Config Code"` in the `"System"` menu in [`ckt-defect/menu-factory.cpp`](file:///home/data/design/projects/ckt-defect/src/ckt-defect/menu-factory.cpp).

### Phase 5: Offline Python Decoder CLI (`tools/unpack_config.py`) [COMPLETED]
* **Objective:** Provide the standalone PC utility for decoding configuration strings into human-readable tables and JSON.
* **Results:**
  * Implemented [`tools/unpack_config.py`](file:///home/data/design/projects/ckt-defect/src/tools/unpack_config.py).
  * **100% Schema-Driven:** Zero hardcoded variable names or categories; reads categories, units, and scales dynamically from whichever `schema_v<VER>.yaml` matches the string header.
  * Supports Crockford Base32 error tolerance (`O->0`, `I->1`, `L->1`, lower/upper case, hyphens/spaces ignored).
  * Enforces 16-bit CRC-16 checksum verification.
  * Supports `--json` export.

### Phase 6: End-to-End Verification & Test Suite [COMPLETED & VERIFIED]
* **Objective:** Prove mathematically and functionally that the entire pipeline is safe, correct, and self-enforcing.
* **Results:**
  * Implemented [`test/test_codec_roundtrip.py`](file:///home/data/design/projects/ckt-defect/src/test/test_codec_roundtrip.py).
  * Verified 100% round-trip fidelity across all 57 configuration fields.
  * Verified typo-tolerance with lowercase, hyphens, and spaces.
  * Verified immediate rejection on CRC corruption.
  * Verified that omitting any NVM-persisted setting aborts the build via the NVM Coverage Guard.
  * Verified full firmware build with `make compile`: builds cleanly using 60% program storage space.
