IowaScaledEngineering/ckt-defect/doc/configuration-encoding/configuration_encoding_proposal.pdf

# DetectorConfiguration Serialization Proposal

### Proposal C: Code-Generated Architecture, 20x4 LCD Display, and Plan of Attack

Hardware: ESP32-S2 | Display: 20x4 Character LCD | Source: configuration.h | Project: ckt-defect

## 1. Problem Statement & Constraints

The objective is to implement a C++ function returning an alphanumeric string that fully encapsulates the active configuration of the Defect Detector (DetectorConfiguration in configuration.h). The string must be unpackable on a PC using Python, displayable on at most 3 lines of a 20x4 LCD, embed a schema version for offline decoding, and preserve substantial headroom for future firmware extensions.

- LCD Screen Budget: Lines 0–2 are dedicated 100% to the code (60 characters max). No title header is displayed.
- Navigation: Line 3 (Row 3) features a BACK button at column 16 (Button 4 position), consistent with other system menus.
- Information Budget Paradox: The raw unaligned struct comprises ~81 bytes. Even dense Base62 can only fit 44 bytes in 60 chars. Dense bit-packing is mandatory to reduce the payload to ~28–32 bytes.

## 2. Alphanumeric Encoding Comparison

Scheme | Alphabet | Bits/Ch | Max (60 ch) | Max (48 ch) | LCD Dot-Matrix Legibility & Human Usability
Crockford Base32 (Selected) | 0-9, A-Z (no I,L,O,U) | 5.00 | 37.5 B | 30.0 B | Highest. Case-insensitive; eliminates visual confusion (0/O, 1/I/l); hyphens/spaces ignored by decoder.
Base58 (Bitcoin) | 1-9, A-Z, a-z (no 0,O,I,l) | 5.86 | 43.9 B | 35.1 B | Good. High density, avoids 0/O/I/l, but case-sensitive manual entry.
Base62 | 0-9, a-z, A-Z | 5.95 | 44.6 B | 35.7 B | Fair. Case-sensitive; severe visual glyph confusion on dot-matrix displays.
Hexadecimal | 0-9, A-F | 4.00 | 30.0 B | 24.0 B | Poor. Cannot fit all configuration fields within the 60-character budget.

Hyphen Flexibility & Error Detection: Hyphens are purely visual formatting. Stripping hyphens expands capacity from 48 to 60 characters (+7.5 bytes in Base32). The Python decoder strips hyphens/spaces automatically. Appending a 2-byte CRC-16 guarantees that any mistyped character on the PC is immediately caught before decoding.

Confidential - Engineering Architectural Proposal | Page 1 of 4

## 3. Field Breakdown & Bit Allocation

Of the 56 members in DetectorConfiguration, runtime and derived members are excluded: trackName[], direction1Name, direction2Name, railName (derived from IDs), externalVocabPresent, and vocabsAvailable (loaded from storage at boot).

Category | Configuration Variables Included | Raw Size | Optimized Size | Optimization Technique
Booleans (21) | Milepost, Track, Dir, Rail, Axles, Spd, Temp, 7 Defects, Messages, Infra | 21 Bytes | 3 Bytes (21 bits) | Bitfield packing (saves 18 bytes)
UI & Audio | pttDelay, lcdBrightness volumeStep, noiseStep, popcornStep, | 5 Bytes | 3.5 Bytes (26 bits) | 5-bit & 4-bit range bounded values
Track / Rail IDs | trackNameId[2], direction1/2NameId, railNameId | 5 Bytes | 1.75 Bytes (14 bits) | 3-bit indices into 8-item lookup tables
Axles & Speed | milepost (0.1 mi), min/entranceAxles, minSpeed, speedScale | 9 Bytes | 5.25 Bytes (41 bits) | Bounded integers (milepost 14b, speedScale 10b)
Temperatures | minTemperatureC, maxTemperatureC (-99° to +150°) | 8 Bytes (float) | 2 Bytes (16 bits) | Signed integer degrees Celsius (offset +100)
Defect Rates (7) | Hot Journal, Hot Wheel, HIW, Dragging Equip, High/Wide Load, Integrity | 28 Bytes (uint32) | ~9–12 Bytes | LEB128 Varints (rates 100–500 use 1–2B each)
Header & CRC | Schema Version (6 bits) + CRC-16-CCITT checksum | — | 2.75 Bytes | Embedded versioning + mistype detection
TOTALS | Complete DetectorConfiguration State | ~81 Bytes | ~28–32 Bytes | Leaves ~12–16 Bytes Headroom for Future Use

## 4. Architectural Selection: Proposal C

Proposal C (Code-Generated from Declarative Schema) was selected as the optimal architecture. A declarative YAML file serves as the single source of truth, from which the pre-build script generates both the C++ firmware encoder (config_codec.h) and the Python offline decoder (unpack_schema.py).

Why Proposal C vs. Proposal A: Both produce identical wire output (~44–48 chars, Base32, CRC-16). In Proposal A, packing is hand-coded in C++ and manually mirrored in Python (dual-maintenance risk of silent drift). In Proposal C, packing is defined declaratively before compilation (config_schema.yaml) and injected into both C++ and Python, guaranteeing zero schema drift and automatic build exports.
- Initial Bootstrapping: You do not write YAML manually; a script generates it from configuration.h.
- 100% NVM Coverage Guarantee: The generator verifies all preferences.put* calls in configuration.cpp.
Defect Detector | Configuration Serialization & Offline Decoding Proposal (Proposal C)
Confidential - Engineering Architectural Proposal | Page 2 of 4

### Proposals Comparison Matrix

Feature / Metric | Proposal A (Bitstream/Base32) | Proposal B (Packed/Base58) | Proposal C (Selected: Schema Code-Gen)
Encoded Length | 44–48 chars (2.5 lines) | 46–50 chars (3 full lines) | 44–48 chars (2.5 lines)
Readability & Entry | Highest (Case-insensitive, no I/L/O/U) | Medium (Case-sensitive) | Highest (Uses Base32)
Typo Protection | CRC-16-CCITT (Instant alert) | CRC-16-CCITT | CRC-16-CCITT
Expansion Headroom | High (~14 Bytes free) | Medium (~6 Bytes free) | High (~14 Bytes free)
Maintenance Risk | Moderate (Dual C++/Python edits) | Moderate | Zero (Single source of truth)
Range Safety | Manual check | Manual check | Compiler Enforced (static_assert)
NVM Coverage Check | Manual check | Manual check | Automated Pre-Build Guard

## 5. 20x4 LCD Layout & Schema Versioning

'Config Code' LCD Menu Interface:
- Location: Submenu named 'Config Code' registered under System.
- Display Format (No Title): Displays no title header. Code is placed across the first 3 lines (Rows 0–2), up to 20 chars/line.
- Navigation: Bottom line (Row 3) displays BACK at column 16 (Button 4 position), consistent with other system status menus.

+--------------------+
|4N7K98DF21MAZ04B9PQ2|
|C117K8LXW409A7B2C3D4|
|E5F6G7H8J9K0 |
| BACK|
+--------------------+

### Schema Version Lifecycle & Compiler Bounds Safety

- Development vs. Release Lifecycle: The 6-bit Schema Version is kept constant (v1) during active development. Firmware and PC remain 100% in sync on every build. The schema is frozen permanently only at official release tags (e.g. v1.0.0).
- Dynamic Bit Widths: Future revisions can increase/decrease bit widths freely (e.g., volume 5b -> 6b). Python inspects the 6-bit header and dispatches to the matching schema version automatically.
- Compiler-Enforced Safety (static_assert): UI range limits are centralized as #define ..._MAX in configuration.h. The generator emits static_assert(MAX < (1 << BITS)) and static_assert(TOTAL <= 300) in C++. The C++ compiler itself stops the build on any overflow, making a separate runtime range linter redundant.
Confidential - Engineering Architectural Proposal | Page 3 of 4

## 6. Implementation Roadmap & Verification Status

All 6 implementation phases have been executed, verified, and integrated into the firmware build pipeline. Comment annotations in configuration.h serve as the single source of truth.
Phase 1: Centralize Limits & Add Annotations [COMPLETED]
- Added named constants for all bounded settings (e.g. ENTRANCE_AXLES_MAX 10, MIN_AXLES_MAX 100, MIN_SPEED_MAX 50, TEMPERATURE_MIN -99, TEMPERATURE_MAX 150) in configuration.h.
- Added comment annotations (// @bits: N, // @type: varint, // @string: 8) to struct members.
- Replaced hardcoded magic numbers in menu-factory.cpp with these constants.
Phase 2: Code Generator & Coverage Verifier [COMPLETED]
- NVM Coverage Check: Parses configuration.cpp for all preferences.put* calls and asserts 100% inclusion in the struct (verified all 56 settings).
- YAML Schema Generation: Auto-emits tools/schemas/schema_v1.yaml from configuration.h annotations with categories and units.
- C++ Codec: Emits ckt-defect/config_codec.h with getConfigurationString(), LEB128 Varints, CRC-16, Base32, and static_assert bounds checks.
Phase 3: Makefile Pre-Build Integration [COMPLETED]
- Added pre-compile rule in Makefile: generate-codec runs gen_codec.py before arduino-cli compile.
- Added make export-schema to export version-tagged build manifests (build/config_schema_$(REV).json).
Phase 4: Firmware LCD Menu Integration [COMPLETED]
- Declared class MenuConfigCode : public Menu in menu-custom.h.
- Implemented MenuConfigCode in menu-custom.cpp: Lines 0–2 code (no title), Line 3 column 16 BACK button (Button 4).
- Registered MenuConfigCode('Config Code', cfg) under menuSysConfig (System menu) in menu-factory.cpp.
Phase 5: Offline Python Decoder CLI [COMPLETED]
- Implemented tools/unpack_config.py: 100% schema-driven with zero hardcoded field names; dynamically formats categories and units directly from YAML.
- Validates Crockford Base32 with typo forgiveness, checks CRC-16, loads matching schema version, and prints formatted table or JSON.
Phase 6: End-to-End Verification & Test Suite [PASSED & VERIFIED]
- Round-Trip Fidelity: 100% match across all 57 configuration fields.
- Compile-Time Safety: Verified static_assert trips on bounds violation and NVM guard halts on unpersisted/omitted settings.
- Firmware Build: Clean compile with make compile (using 60% program flash).

Implementation Status & Verification Sign-Off:
- Status: FULLY IMPLEMENTED & VERIFIED (Schema v1 · 241 bits · ~49 Crockford Base32 characters).
- Zero-Maintenance PC Tool: Adding or modifying fields in configuration.h automatically propagates through schema_v1.yaml to unpack_config.py without editing python scripts.
- Release Workflow: Commit working tree at Git tag (v1.0.0) to freeze schema_v1.yaml.
Confidential - Engineering Architectural Proposal | Page 4 of 4
