IowaScaledEngineering/ckt-defect/src/ckt-defect/sfx/wav/PneumaticHornDouble3.pdf

## Pneumatic Horn, Double #3 Sound Effect - Free Download WAV, MP3 - BigSoundBank

Joseph SARDIN

Two presses on a pneumatic horn.

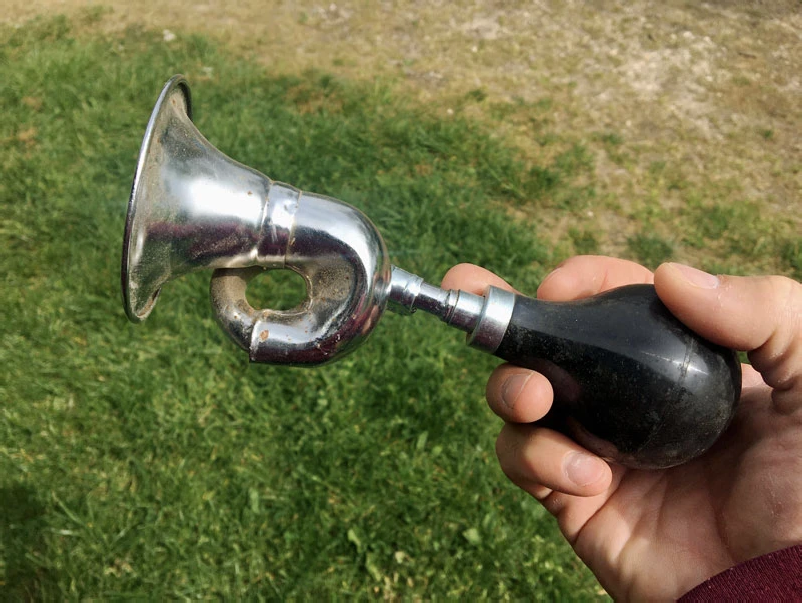
[picture p1: figure]

## Technical details

Length: 00:01
UCS Category: (https://bigsoundbank.com/categories.html) Cartoon / Horn (TOONHorn) (https://bigsoundbank.com/search?CatID=TOONHorn) Type: Alone sound (https://bigsoundbank.com/search?type=ss)
Channels: Monophonic (https://bigsoundbank.com/search?mode=m)
Conditions: Studio
Realism: Realistic
Sampling Rate: 48,000 Hz (https://bigsoundbank.com/search?frequence=48000)
Bit Depth: 24 bits (https://bigsoundbank.com/search?resolution=24)
Equipment: SoundDevices MixPre-3 (https://bigsoundbank.com/thomann/) + Sennheiser ME66 Author: Joseph SARDIN (https://josephsardin.fr/)

Sound number: 1,832

## Other interesting files

## FAQ about this sound

▸
Is this sound free?

Yes, because I intentionally release it under the CC0 license (public-domain equivalent). You can download and use it without paying, without creating an account, and without asking for permission.

In return, the site is funded by ads, donations, (https://bigsoundbank.com/donation.html) Thomann affiliate links, (https://bigsoundbank.com/thomann/) and a few sales (shop). (https://bigsoundbank.com/shop/) If you find this project useful, a small donation really helps keep it going.

▸
Can I edit or redistribute this sound?

Yes. You can edit, process, remix, transform, and redistribute this sound, including in your own music, podcasts, audiobooks, games, apps, or videos, without asking for permission.

▸
Is this sound free for commercial use?

Yes. You can use this sound in any project, including commercial ones, anywhere in the world, without paying a license fee.

▸
Do I have to credit LaSonotheque or the author?

No. Attribution isn't required, but it's always appreciated when your project includes a credits page or end credits. It costs nothing, and it's respectful of my work.

▸
What exactly is the license?

These sounds are released under a "public-domain equivalent" license (CC0 / WTFPL / public domain). For more details, see the licenses page. (https://bigsoundbank.com/licenses.html)

## Rate & Comment
