IowaScaledEngineering/ckt-defect/pg/ckt-defect-array-v1.2-b68d5d5/ckt-defect.pdf

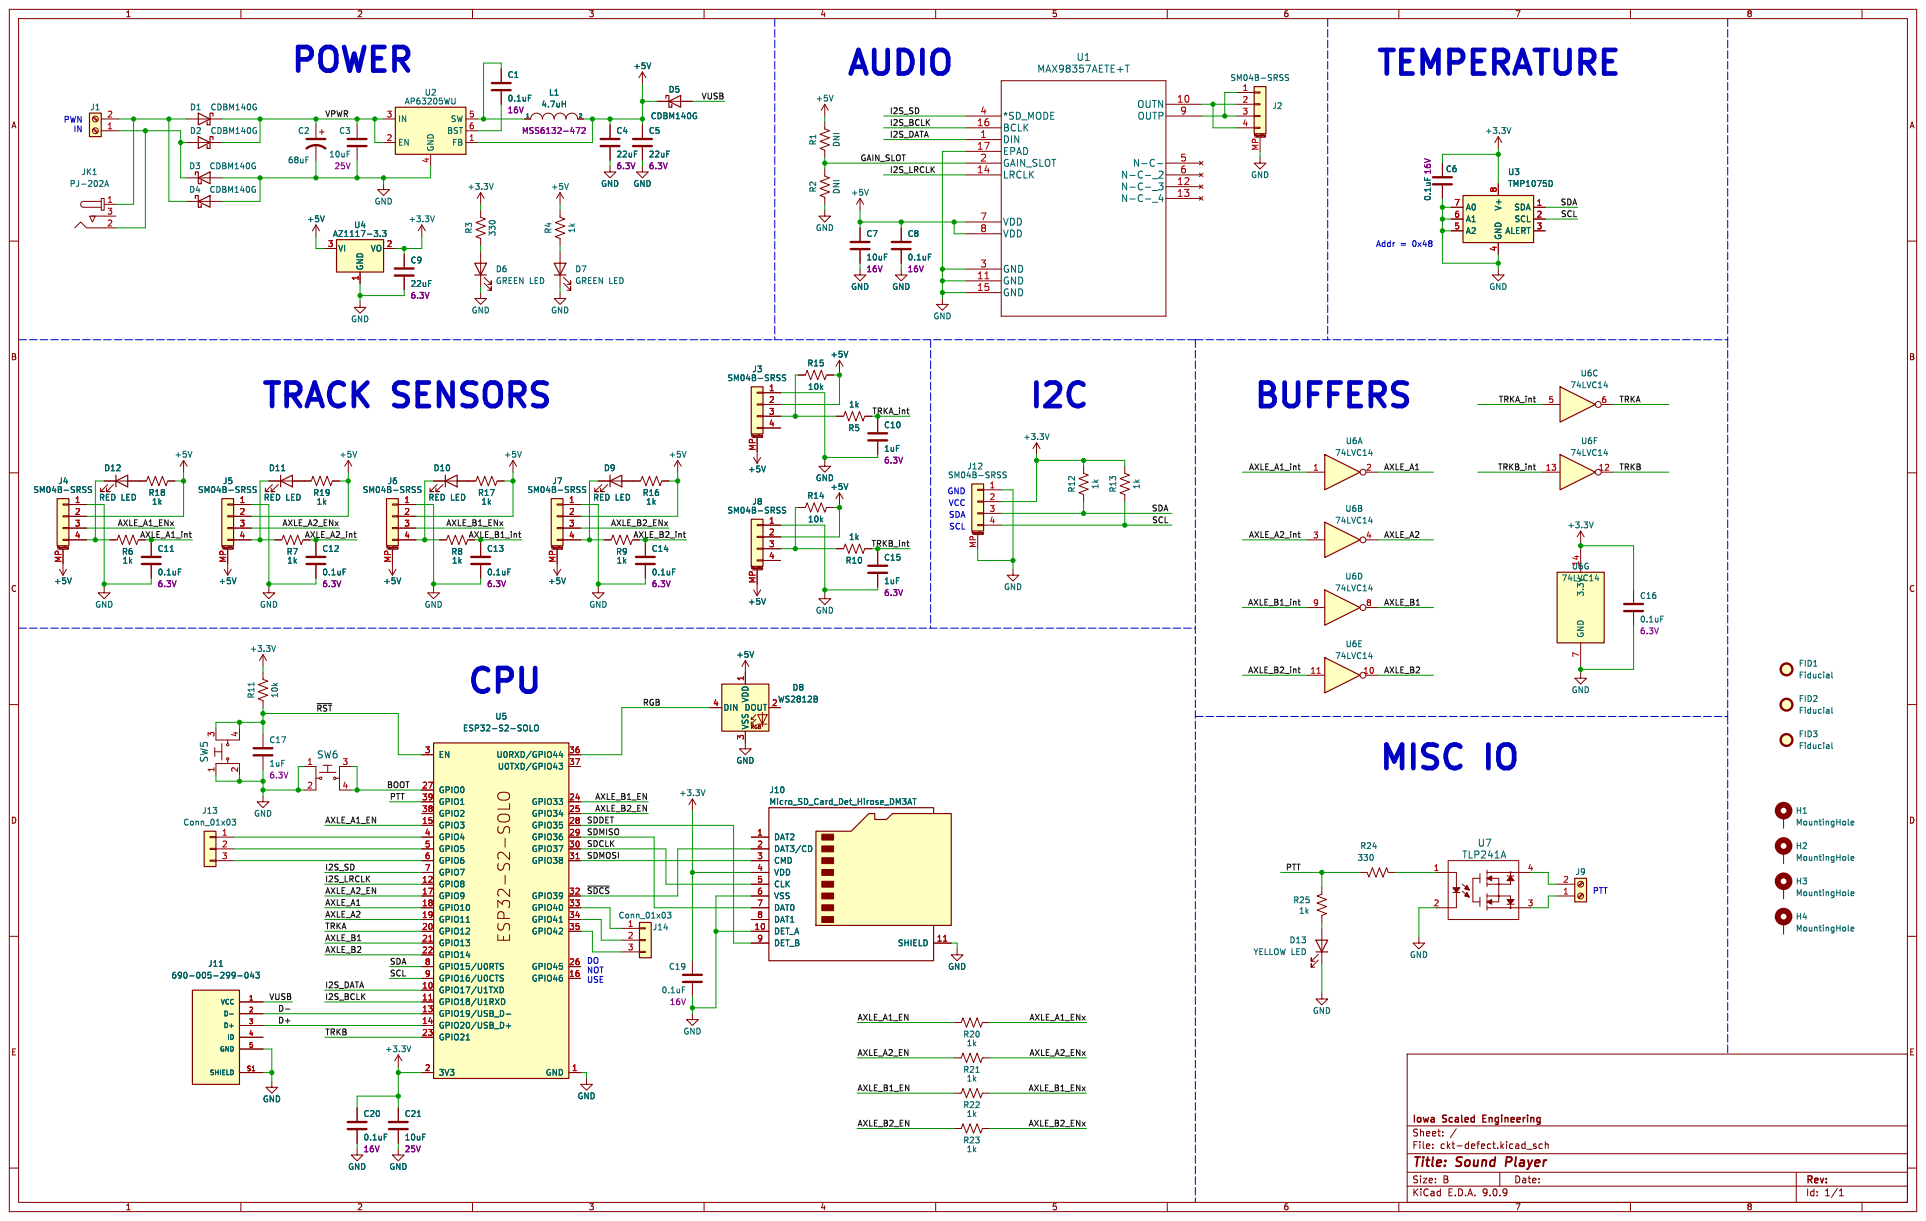
[picture p2: page 1]

H4 MountingHole FID2 Fiducial FID3 Fiducial FID1 Fiducial H2 MountingHole H3 MountingHole GND
EN 3 GPIO0 27 GPIO1 39 GPIO2 38 GPIO3 15 GPIO4 4 GPIO5 5 GPIO6 6 GPIO7 7 GPIO8 12 GPIO9 17 GPIO10 18 GPIO11 19 GPIO12 20 GPIO13 21 GPIO14 22 GPIO15/U0RTS 8 GPIO16/U0CTS 9 GPIO17/U1TXD 10 GPIO18/U1RXD 11 GPIO19/USB_D- 13 GPIO20/USB_D+ 14 GPIO21 23

Id: 1/1 Title: Sound Player File: ckt-defect.kicad_sch Sheet: /
