IowaScaledEngineering/ckt-defect/pg/ckt-defect-v1.1-272b43a/ckt-defect.pdf

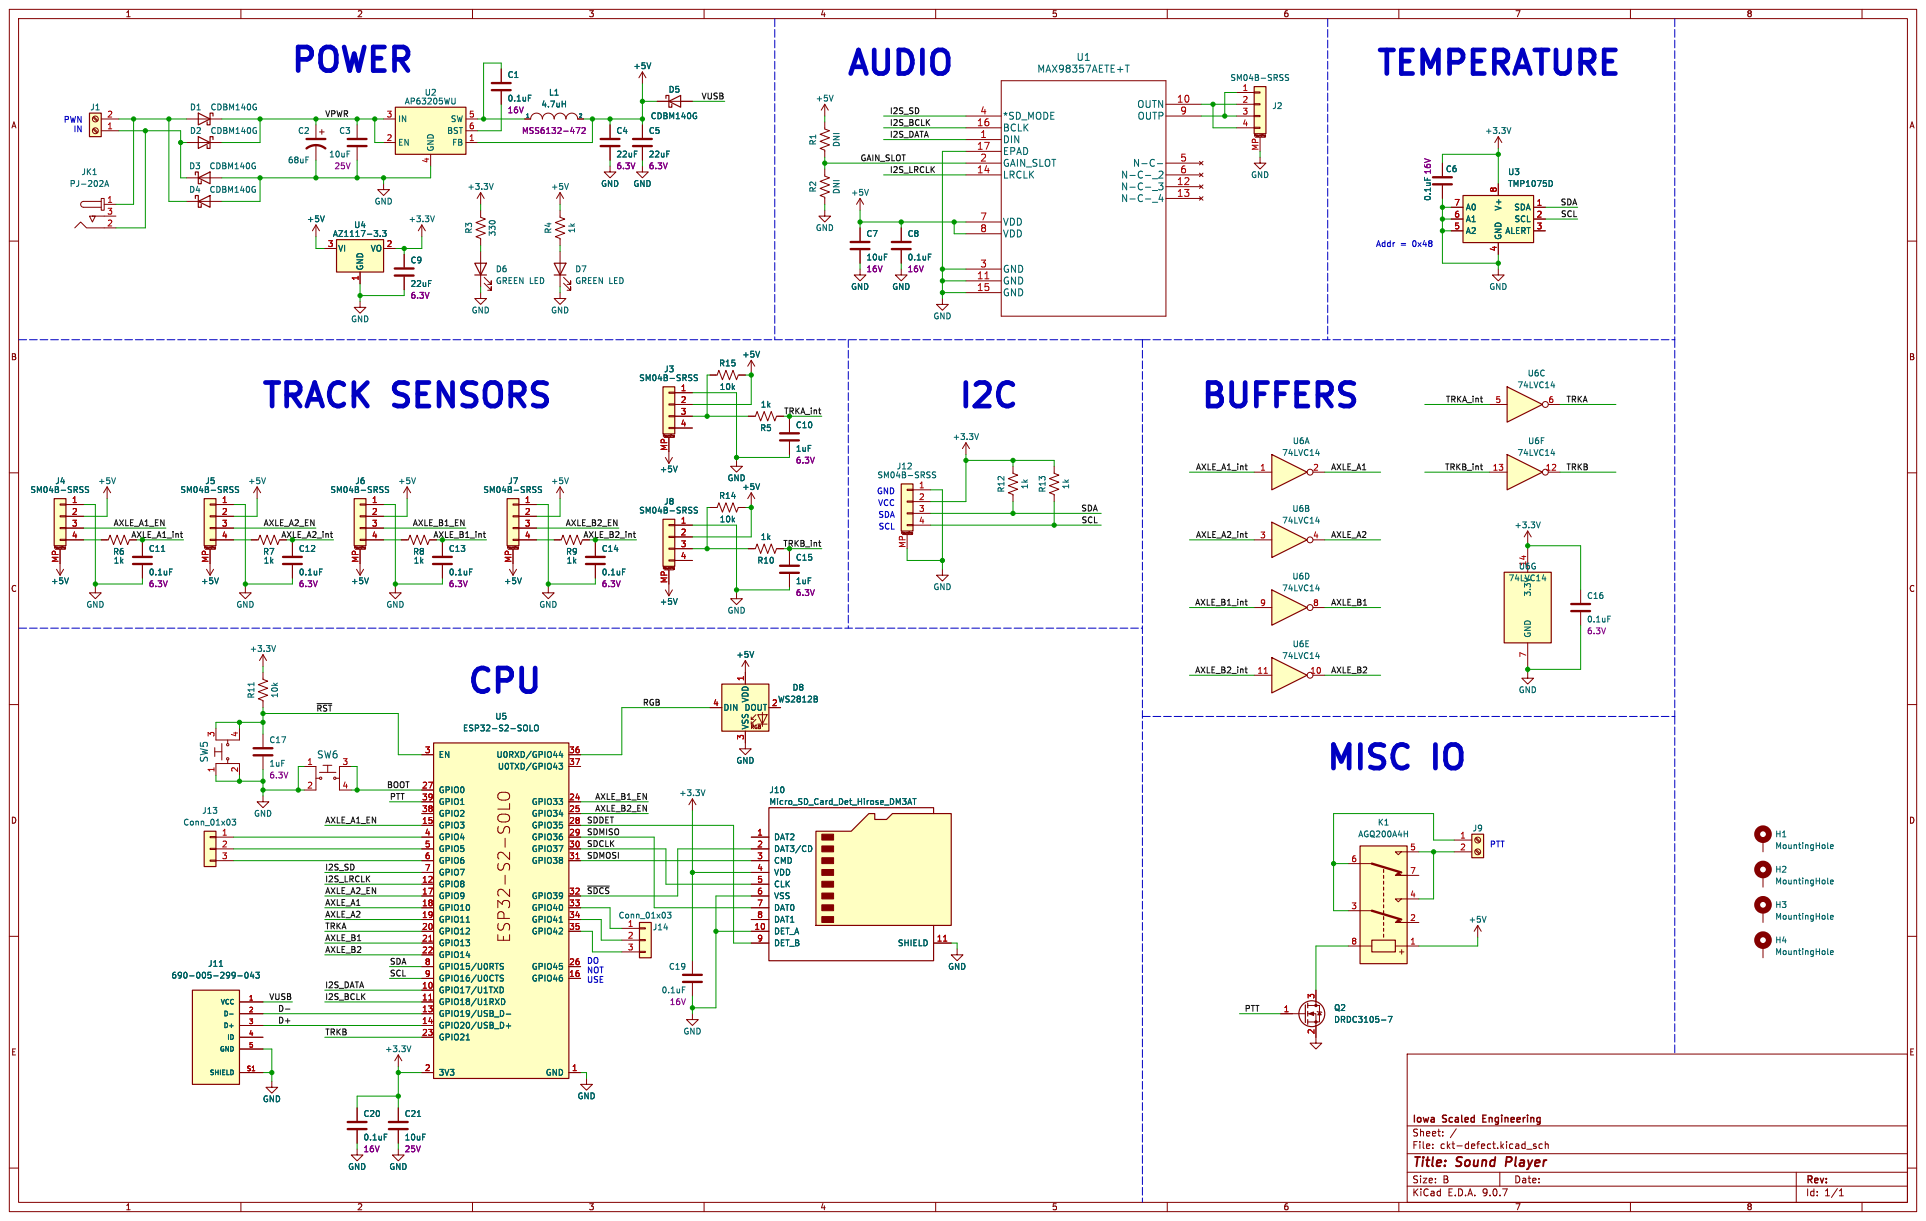
[picture p3: page 1]

Id: 1/1 Title: Sound Player File: ckt-defect.kicad_sch Sheet: /
