IowaScaledEngineering/ckt-defect/pg/snd-defect-v1.0-cc51602/snd-defect.pdf

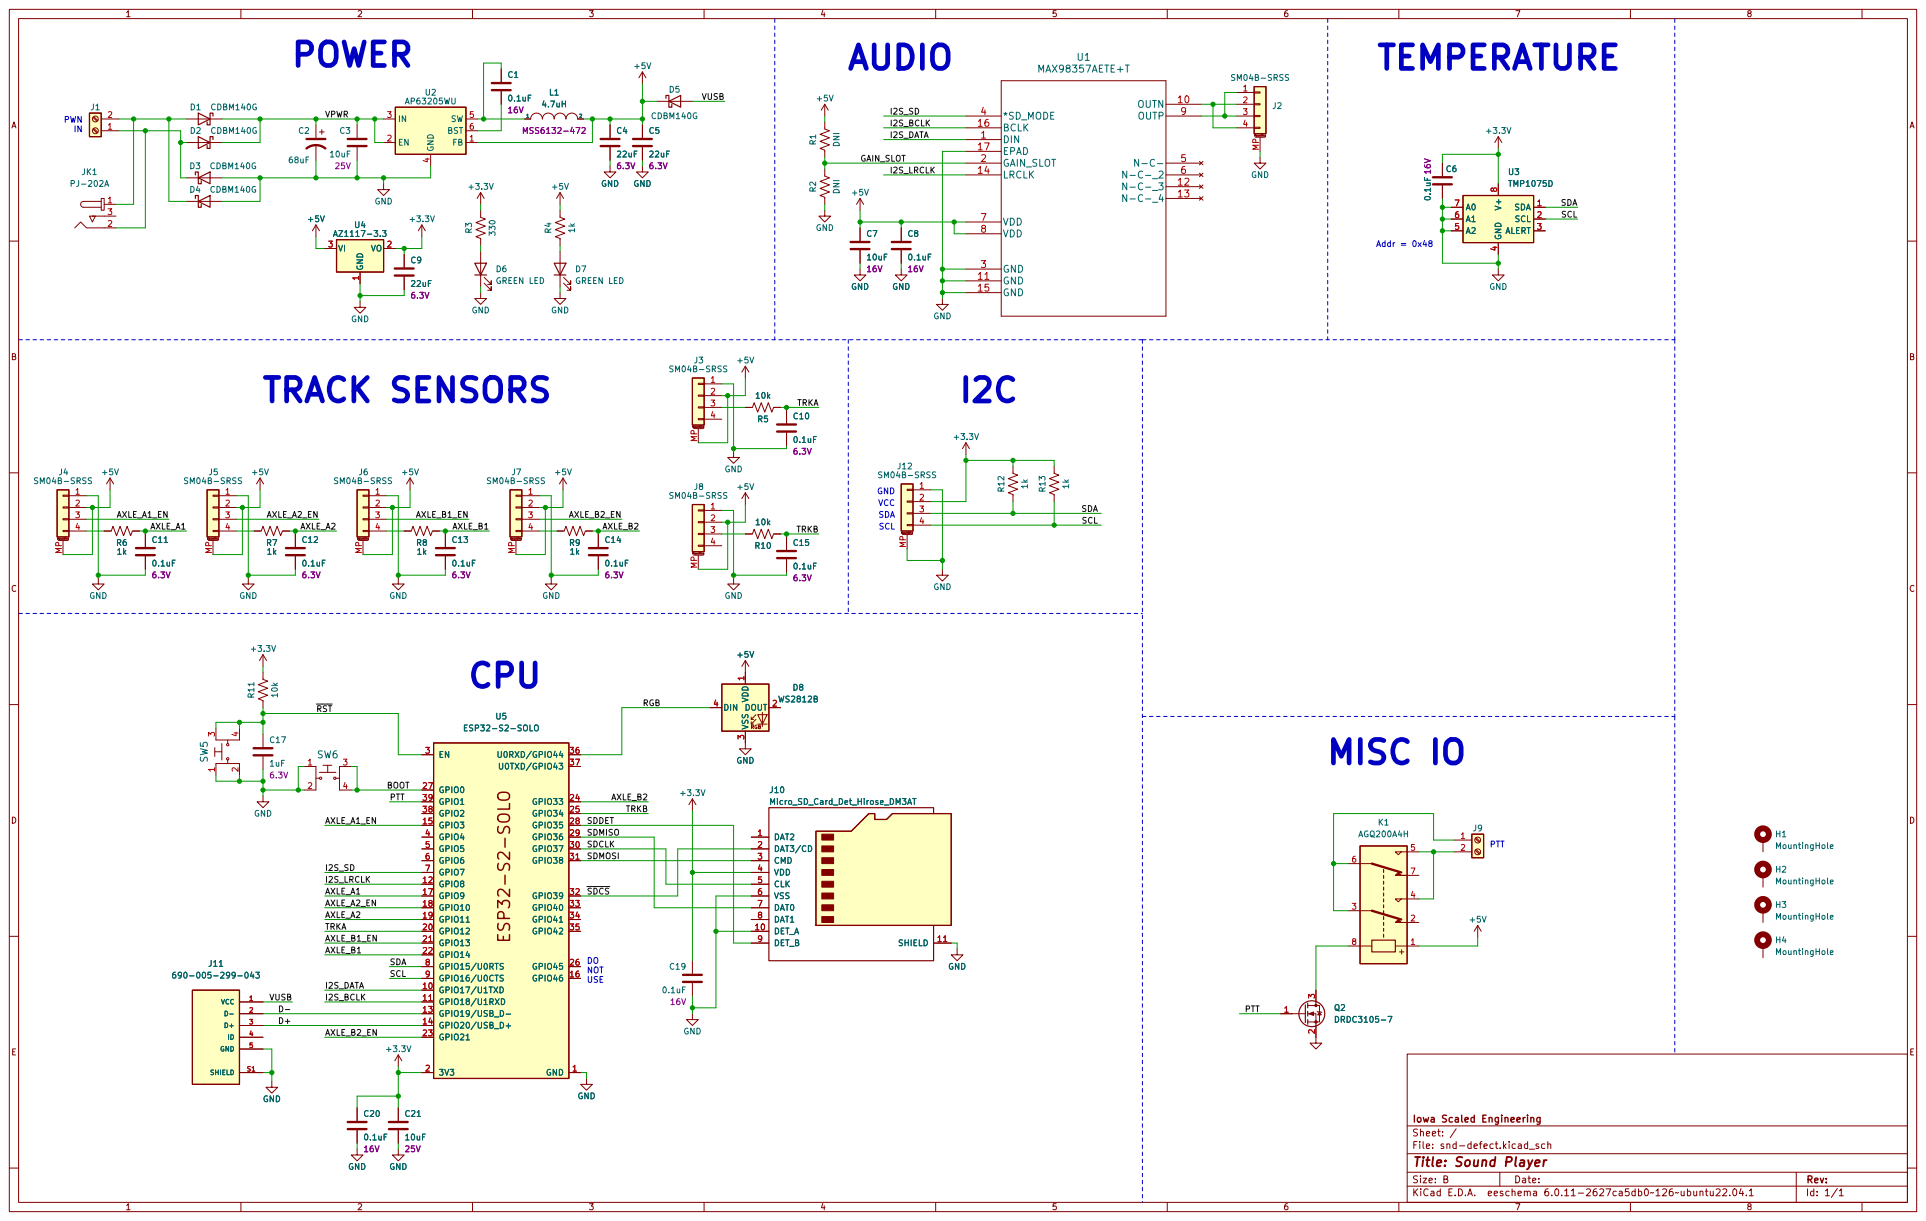
[picture p4: page 1]

1 VO 2 VI 3 U4 AZ1117-3.3 +5V R41k D7 GREEN LED GND GND

1 VO 2 VI 3 GND GND

Id: 1/1 Title: Sound Player File: snd-defect.kicad_sch Sheet: /
