IowaScaledEngineering/ckt-defect/src/ckt-defect/state-machine.cpp

/*************************************************************************
Title:    State Machine Functions
Authors:  Michael Petersen <railfan@drgw.net>
File:     state-machine.cpp
License:  GNU General Public License v3

LICENSE:
    Copyright (C) 2026 Michael Petersen & Nathan Holmes

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
*************************************************************************/

#include <Arduino.h>
#include "common.h"
#include "state-machine.h"

// ==========================================
// IrStateMachine Implementation
// ==========================================

IrStateMachine::IrStateMachine(DetectorConfiguration* config, DataBundle* dataBundle)
	: BaseStateMachine<IrState>(config, dataBundle, IrState::IDLE, "IR")
{ }

const char* IrStateMachine::getStateName(IrState state) const
{
	switch (state)
	{
		case IrState::IDLE:   return "IDLE";
		case IrState::DETECT: return "DETECT";
		case IrState::TIMER:  return "TIMER";
		default:              return "UNKNOWN";
	}
}

void IrStateMachine::update()
{
	currentState = nextState;
	switch (currentState)
	{
		case IrState::IDLE:
			data->irDetect = false;
			if (data->irInput)
			{
				transitionTo(IrState::DETECT);
			}
			break;

		case IrState::DETECT:
			data->irDetect = true;
			lastStateTime = millis();
			if (!data->irInput)
			{
				transitionTo(IrState::TIMER);
			}
			break;

		case IrState::TIMER:
			if (data->irInput)
			{
				transitionTo(IrState::DETECT);
			}
			else if (((millis() - lastStateTime) / 1000) >= cfg->detectorTimeout)
			{
				transitionTo(IrState::IDLE);
			}
			break;
		default:
			transitionTo(IrState::IDLE);
			break;
	}
}

// ==========================================
// AxleStateMachine Implementation
// ==========================================

AxleStateMachine::AxleStateMachine(DetectorConfiguration* config, DataBundle* dataBundle)
	: BaseStateMachine<AxleState>(config, dataBundle, AxleState::RESET, "Axle")
{ }

const char* AxleStateMachine::getStateName(AxleState state) const
{
	switch (state)
	{
		case AxleState::RESET:   return "RESET";
		case AxleState::IDLE:    return "IDLE";
		case AxleState::DETECT:  return "DETECT";
		case AxleState::TIMEOUT: return "TIMEOUT";
		default:                 return "UNKNOWN";
	}
}

void AxleStateMachine::update()
{
	currentState = nextState;
	switch (currentState)
	{
		case AxleState::RESET:
			data->axleCount = 0;
			data->newAxle = false;
			data->axleDetect = false;
			transitionTo(AxleState::IDLE);
			break;

		case AxleState::IDLE:
			data->newAxle = false;
			if (data->axleCountLive > data->axleCount)
			{
				// If this is the first axle, clear the previous speed/direction; used in main loop to detect first axle
				if (0 == data->axleCount)
				{
					data->speed = 0;
					data->direction = 0;
				}
				transitionTo(AxleState::DETECT);
			}
			else if (data->axleDetect && (((millis() - lastStateTime) / 1000) >= cfg->detectorTimeout))
			{
				transitionTo(AxleState::TIMEOUT);
			}
			break;

		case AxleState::DETECT:
			data->axleCount = data->axleCountLive;
			data->newAxle = true;
			data->axleDetect = true;
			lastStateTime = millis();
			transitionTo(AxleState::IDLE);
			break;

		case AxleState::TIMEOUT:
			data->totalAxles = data->axleCount;
			transitionTo(AxleState::RESET);
			break;
		default:
			transitionTo(AxleState::IDLE);
			break;
	}
}

// ==========================================
// DetectorStateMachine Implementation
// ==========================================

DetectorStateMachine::DetectorStateMachine(DetectorConfiguration* config, DataBundle* dataBundle, MessageBundle* messageBundle, uint8_t track)
	: BaseStateMachine<DetectorState>(config, dataBundle, DetectorState::RESET, "Detector"), msgs(messageBundle), trackNum(track)
{ }

const char* DetectorStateMachine::getStateName(DetectorState state) const
{
	switch (state)
	{
		case DetectorState::RESET:                   return "RESET";
		case DetectorState::IDLE:                    return "IDLE";
		case DetectorState::ENTRANCE_AXLES:          return "ENTRANCE_AXLES";
		case DetectorState::ENTRANCE_DEFECT:         return "ENTRANCE_DEFECT";
		case DetectorState::ENTRANCE_SPEED:          return "ENTRANCE_SPEED";
		case DetectorState::ENTRANCE_QUEUE:          return "ENTRANCE_QUEUE";
		case DetectorState::INFRASTRUCTURE_WAIT:     return "INFRASTRUCTURE_WAIT";
		case DetectorState::MINIMUM_AXLES:           return "MINIMUM_AXLES";
		case DetectorState::AXLE_COUNT:              return "AXLE_COUNT";
		case DetectorState::AXLE_DEFECT:             return "AXLE_DEFECT";
		case DetectorState::EXIT_SPEED:              return "EXIT_SPEED";
		case DetectorState::EXIT_QUEUE:              return "EXIT_QUEUE";
		case DetectorState::TOO_SLOW_QUEUE:          return "TOO_SLOW_QUEUE";
		case DetectorState::MIN_AXLE_QUEUE:          return "MIN_AXLE_QUEUE";
		case DetectorState::INTEGRITY_DEFECT_QUEUE:  return "INTEGRITY_DEFECT_QUEUE";
		case DetectorState::BLOCKED_DEFECT_QUEUE:    return "BLOCKED_DEFECT_QUEUE";
		case DetectorState::WAIT_NO_EXIT:            return "WAIT_NO_EXIT";
		default:                                     return "UNKNOWN";
	}
}

void DetectorStateMachine::enqueueMessageInternal(const std::string& spokenMsg, const std::string* dispMsg)
{
	ParserObject* obj = new ParserObject();
	
	// Spoken message processing
	transformMessage(spokenMsg, obj->msg, *cfg, *data, trackNum, true);
	toLowercase(obj->msg);  // lowercase before parsing

	// Save pre-transformed spoken message for RPT playback
	data->lastSpokenMsg = obj->msg;

	// Conditional display message processing
	if (dispMsg != nullptr)
	{
		transformMessage(*dispMsg, obj->displayMsg, *cfg, *data, trackNum, false);
	}

	parserQueuePush(obj);

	Serial.print("--> ");
	Serial.println(obj->msg.c_str());
	if (dispMsg != nullptr)
	{
		Serial.println("--------------------");
		Serial.println(obj->displayMsg.c_str());
		Serial.println("--------------------");
	}
	printMemoryUsage();
}

void DetectorStateMachine::enqueueMessage(const std::string& spokenMsg)
{
	enqueueMessageInternal(spokenMsg, nullptr);
}

void DetectorStateMachine::enqueueMessage(const std::string& spokenMsg, const std::string& dispMsg)
{
	enqueueMessageInternal(spokenMsg, &dispMsg);
}

void DetectorStateMachine::update()
{
	currentState = nextState;
	switch (currentState)
	{
		case DetectorState::RESET:
			// Cleanup
			data->defects.clear();
			defectCount = 0;
			transitionTo(DetectorState::IDLE);
			break;

		case DetectorState::IDLE:
			if( !cfg->infrastructureMode && data->axleDetect )
			{
				if(!cfg->triggerDirection1Only && !cfg->triggerDirection2Only)
				{
					// Trigger any direction
					transitionTo(DetectorState::ENTRANCE_AXLES);
				}
				else if((cfg->triggerDirection1Only) && (1 == data->direction))
				{
					// Trigger direction 1 only
					transitionTo(DetectorState::ENTRANCE_AXLES);
				}
				else if((cfg->triggerDirection2Only) && (2 == data->direction))
				{
					// Trigger direction 2 only
					transitionTo(DetectorState::ENTRANCE_AXLES);
				}
			}
			else if( cfg->infrastructureMode && data->irDetect )
			{
				transitionTo(DetectorState::ENTRANCE_DEFECT);
			}
			break;

		case DetectorState::ENTRANCE_AXLES:
			if( !data->axleDetect && !data->irDetect )
			{
				// We didn't get enough axles and everything has timed out (maybe a hand waved over the sensor)
				transitionTo(DetectorState::RESET);
			}
			else if( data->axleCount >= cfg->entranceAxles )
			{
				// We have enough axles, so let's continue
				transitionTo(DetectorState::ENTRANCE_DEFECT);
			}
			break;

		case DetectorState::ENTRANCE_DEFECT:
			// Roll the dice
			if( (cfg->defectIntegrityEnable) && (rollDice() < (PROBABILITY_MAX / (msgs->integrityTrainRate == 0 ? 1 : msgs->integrityTrainRate))) )
			{
				// Integrity defect
				transitionTo(DetectorState::INTEGRITY_DEFECT_QUEUE);
			}
			else
			{
				// No defect (or not enabled)
				if(!cfg->infrastructureMode && (cfg->speedTypeEnter))
				{
					// Not infrastructure mode and entrance speed enabled
					transitionTo(DetectorState::ENTRANCE_SPEED);
				}
				else
				{
					transitionTo(DetectorState::ENTRANCE_QUEUE);
				}
			}
			break;

		case DetectorState::ENTRANCE_SPEED:
			if(data->speed > 0)
			{
				// We have a valid speed
				if(data->speed >= cfg->minSpeed)
				{
					transitionTo(DetectorState::ENTRANCE_QUEUE);
				}
				else
				{
					transitionTo(DetectorState::TOO_SLOW_QUEUE);
				}
			}
			else if(!data->axleDetect && !data->irDetect)
			{
				// State machines have timed out.  IR is part of the logic to allow an IR sensor to keep the detector alive.
				if(data->axleInput1 || data->axleInput2)
				{
					// Debounced axle inputs are high, assume they are blocked
					transitionTo(DetectorState::BLOCKED_DEFECT_QUEUE);
				}
				else
				{
					transitionTo(DetectorState::TOO_SLOW_QUEUE);
				}
			}
			break;
			
		case DetectorState::ENTRANCE_QUEUE:
			enqueueMessage(msgs->entranceMsg);
			if(!cfg->infrastructureMode)
			{
				// Not infrastructure mode
				transitionTo(DetectorState::MINIMUM_AXLES);
			}
			else
			{
				// Infrastructure mode
				transitionTo(DetectorState::INFRASTRUCTURE_WAIT);
			}
			break;
			
		case DetectorState::MINIMUM_AXLES:
			if( data->axleCount >= cfg->minAxles )
			{
				// We have enough axles, so let's continue
				transitionTo(DetectorState::AXLE_COUNT);
			}
			else if(!data->axleDetect)
			{
				// Timed out before min axles
				if(data->axleInput1 || data->axleInput2)
				{
					// Something is blocking one of the axle counters
					transitionTo(DetectorState::BLOCKED_DEFECT_QUEUE);
				}
				else
				{
					transitionTo(DetectorState::MIN_AXLE_QUEUE);
				}
			}
			break;
			
		case DetectorState::AXLE_COUNT:
			if( data->newAxle )
			{
				Serial.print("Axle Count: ");
				Serial.print(data->axleCount);
				Serial.print(" - ");
				Serial.println(data->axleTime);
				transitionTo(DetectorState::AXLE_DEFECT);
			}
			else if(!data->axleDetect && !data->irDetect)
			{
				// Timed out
				if(data->axleInput1 || data->axleInput2)
				{
					// Something is blocking one of the axle counters
					transitionTo(DetectorState::BLOCKED_DEFECT_QUEUE);
				}
				else if(!cfg->speedTypeEnter)
				{
					// Exit speed enabled
					transitionTo(DetectorState::EXIT_SPEED);
				}
				else
				{
					transitionTo(DetectorState::EXIT_QUEUE);
				}
			}
			break;
			
		case DetectorState::AXLE_DEFECT:
			if(defectCount < MAX_DEFECTS)
			{
				for (uint32_t i = 0; i < msgs->defects.size(); i++)
				{
					if (rollDice() < (PROBABILITY_MAX / (msgs->defects[i].axleRate == 0 ? 1 : msgs->defects[i].axleRate)))
					{
						// We have a defect
						std::string temporaryMsg;
						
						data->rail = rollDice() % 2;  // Randomly pick a rail for the defect

						defectCount++;  // Yes, this can in theory roll over but we're not going to worry about 4 billion defects...
						Serial.print("\nDefect #");
						Serial.println(defectCount);
						if(defectCount <= cfg->maxDefects)
						{
							// Create and store detail message for listing later
							transformMessage(msgs->defects[i].detailMsg, temporaryMsg, *cfg, *data, trackNum, true);
							data->defects.push_back(temporaryMsg);
						}
						else if(defectCount == cfg->maxDefects + 1)
						{
							// On the next defect after max, insert excessive alarms message
							data->defects.push_back(msgs->excessAlarmsMsg);
						}
						
						// Play alert message (and send along display message)
						enqueueMessage(msgs->defects[i].alertMsg, msgs->defects[i].displayMsg);
						break;
					}
				}
			}
			transitionTo(DetectorState::AXLE_COUNT);
			break;
			
		case DetectorState::EXIT_SPEED:
			if(data->speed >= cfg->minSpeed)
			{
				transitionTo(DetectorState::EXIT_QUEUE);
			}
			else
			{
				transitionTo(DetectorState::TOO_SLOW_QUEUE);
			}
			break;
			
		case DetectorState::EXIT_QUEUE:
			if(data->defects.size() > 0)
			{
				// We have defects
				enqueueMessage(msgs->exitDefectMsg, msgs->exitDefectDisplayMsg);
			}
			else
			{
				enqueueMessage(msgs->exitCleanMsg, msgs->exitCleanDisplayMsg);
			}
			transitionTo(DetectorState::RESET);
			break;
			
		case DetectorState::INFRASTRUCTURE_WAIT:
			if(!data->irDetect)
			{
				transitionTo(DetectorState::EXIT_QUEUE);
			}
			break;
			
		case DetectorState::TOO_SLOW_QUEUE:
			enqueueMessage(msgs->tooSlowMsg, msgs->tooSlowDisplayMsg);
			transitionTo(DetectorState::WAIT_NO_EXIT);
			break;
			
		case DetectorState::MIN_AXLE_QUEUE:
			enqueueMessage(msgs->minAxleMsg, msgs->minAxleDisplayMsg);
			transitionTo(DetectorState::WAIT_NO_EXIT);
			break;
			
		case DetectorState::INTEGRITY_DEFECT_QUEUE:
			enqueueMessage(msgs->integrityMsg, msgs->integrityDisplayMsg);
			transitionTo(DetectorState::WAIT_NO_EXIT);
			break;
			
		case DetectorState::BLOCKED_DEFECT_QUEUE:
			enqueueMessage(msgs->detectorBlockedMsg, msgs->detectorBlockedDisplayMsg);
			transitionTo(DetectorState::WAIT_NO_EXIT);
			break;
			
		case DetectorState::WAIT_NO_EXIT:
			if(!data->axleDetect && !data->irDetect && !data->axleInput1 && !data->axleInput2)
			{
				transitionTo(DetectorState::RESET);
			}
			break;
		default:
			transitionTo(DetectorState::IDLE);
			break;
			
	}
}
