IowaScaledEngineering/ckt-defect/src/ckt-defect/configuration.cpp

/*************************************************************************
Title:    Defect Detector Configuration
Authors:  Michael Petersen <railfan@drgw.net>
File:     configuration.cpp
License:  GNU General Public License v3

LICENSE:
    Copyright (C) 2026 Michael Petersen & Nathan Holmes

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
*************************************************************************/

#include <Arduino.h>
#include <Preferences.h>
#include <math.h>
#include <string>

#include "common.h"
#include "configuration.h"

#define VOL_STEP_DEFAULT                  15
#define NOISE_STEP_DEFAULT                0
#define POPCORN_STEP_DEFAULT              0
#define PTT_DELAY_DEFAULT                 2

#define LCD_BRIGHT_DEFAULT                128

#define MILEPOST_EN_DEFAULT               true
#define MILEPOST_DISP_DEFAULT             true
#define MILEPOST_DEFAULT                  3469

#define TRACK_NAME_EN_DEFAULT             true
#define RAIL_NAME_EN_DEFAULT              true

#define AXLE_EN_DEFAULT                   true
#define ENTRANCE_AXLES_DEFAULT            4
#define MIN_AXLES_DEFAULT                 8

#define SPEED_EN_DEFAULT                  true
#define SPEED_UNITS_MPH_DEFAULT           true
#define SPEED_TYPE_ENTER_DEFAULT          true
#define MIN_SPEED_DEFAULT                 10
#define SPEED_SCALE_DEFAULT               871

#define DETECTOR_TIMEOUT_DEFAULT          5
#define SUMMARY_DISPLAY_TIME_DEFAULT      7
#define MSG_REPEAT_TIMEOUT_DEFAULT        30

#define TEMPERATURE_EN_DEFAULT            true
#define TEMPERATURE_DISP_DEFAULT          true
#define TEMPERATURE_REAL_DEFAULT          true
#define TEMPERATURE_UNITS_F_DEFAULT       true
#define MIN_TEMPERATURE_F_DEFAULT         50.0f
#define MAX_TEMPERATURE_F_DEFAULT         70.0f

#define DIRECTION_EN_DEFAULT              true
#define TRIGGER_DIR1_ONLY_DEFAULT         false
#define TRIGGER_DIR2_ONLY_DEFAULT         false

#define DEFECT_HJ_EN_DEFAULT              true
#define DEFECT_HJ_RATE_DEFAULT            125
#define DEFECT_HW_EN_DEFAULT              true
#define DEFECT_HW_RATE_DEFAULT            125
#define DEFECT_HIW_EN_DEFAULT             true
#define DEFECT_HIW_RATE_DEFAULT           150
#define DEFECT_DE_EN_DEFAULT              true
#define DEFECT_DE_RATE_DEFAULT            250
#define DEFECT_HL_EN_DEFAULT              false
#define DEFECT_HL_RATE_DEFAULT            500
#define DEFECT_WL_EN_DEFAULT              false
#define DEFECT_WL_RATE_DEFAULT            500
#define DEFECT_INTEGRITY_EN_DEFAULT       true
#define DEFECT_INTEGRITY_RATE_DEFAULT     100

#define ENTRANCE_MSG_EN_DEFAULT           true
#define ALERT_MSG_EN_DEFAULT              true
#define TALK_DEFECT_ONLY_DEFAULT          false

#define MAX_DEFECTS_DEFAULT               3
#define ORDINAL_TYPE_ID_DEFAULT           2

#define INFRASTRUCTURE_MODE_DEFAULT       false

#define VOCAB_IN_USE_DEFAULT              ""

#define MIN_AXLE_TIME_DEFAULT             50

#define PREF_NAMESPACE   "defectdetector"

Preferences preferences;

void loadConfiguration(DetectorConfiguration* cfg)
{
	std::string key;

	preferences.begin(PREF_NAMESPACE, true);  // Open in read-only mode

	cfg->volumeStep = preferences.getUChar("vol", VOL_STEP_DEFAULT);
	cfg->noiseStep = preferences.getUChar("noise", NOISE_STEP_DEFAULT);
	cfg->pttDelay = preferences.getUChar("pttDelay", PTT_DELAY_DEFAULT);
	cfg->popcornStep = preferences.getUChar("popcorn", POPCORN_STEP_DEFAULT);

	cfg->lcdBrightness = preferences.getUChar("lcd", LCD_BRIGHT_DEFAULT);

	cfg->milepostEnable = preferences.getBool("mpEn", MILEPOST_EN_DEFAULT);
	cfg->milepostDisplay = preferences.getBool("mpDisp", MILEPOST_DISP_DEFAULT);
	cfg->milepost = preferences.getUShort("mp", MILEPOST_DEFAULT);

	cfg->trackNameEnable = preferences.getBool("trkNameEn", TRACK_NAME_EN_DEFAULT);
	for(uint32_t i=0; i<NUM_TRACKS; i++)
	{
		key = "trkNameId" + std::to_string(i);
		uint8_t loadedId = preferences.getUChar(key.c_str(), i);
		
		// Bounds check protection against trackNames array size
		if (loadedId >= trackNames.size())
		{
			cfg->trackNameId[i] = 0; // Default fallback to index 0 safely
		}
		else
		{
			cfg->trackNameId[i] = loadedId;
		}
	}

	cfg->directionEnable = preferences.getBool("dirEn", DIRECTION_EN_DEFAULT);
	
	uint8_t loadedDir1Id = preferences.getUChar("dir1Id", 0);
	cfg->direction1NameId = (loadedDir1Id >= directionNames.size()) ? 0 : loadedDir1Id;
	
	uint8_t loadedDir2Id = preferences.getUChar("dir2Id", 1); // fallback default to 1 if available
	cfg->direction2NameId = (loadedDir2Id >= directionNames.size()) ? 0 : loadedDir2Id;

	cfg->triggerDirection1Only = preferences.getBool("trigDir1", TRIGGER_DIR1_ONLY_DEFAULT);
	cfg->triggerDirection2Only = preferences.getBool("trigDir2", TRIGGER_DIR2_ONLY_DEFAULT);

	cfg->railNameEnable = preferences.getBool("railNameEn", RAIL_NAME_EN_DEFAULT);

	uint8_t loadedRailId = preferences.getUChar("railId", 0);
	cfg->railNameId = (loadedRailId >= railNames.size()) ? 0 : loadedRailId;

	// Axles
	cfg->axleEnable = preferences.getBool("axleEn", AXLE_EN_DEFAULT);
	cfg->entranceAxles = preferences.getUShort("entAxle", ENTRANCE_AXLES_DEFAULT);
	cfg->minAxles = preferences.getUShort("minAxle", MIN_AXLES_DEFAULT);

	// Speed
	cfg->speedEnable = preferences.getBool("spdEn", SPEED_EN_DEFAULT);
	cfg->speedUnitsMph = preferences.getBool("spdUnit", SPEED_UNITS_MPH_DEFAULT);
	cfg->speedTypeEnter = preferences.getBool("spdTyp", SPEED_TYPE_ENTER_DEFAULT);
	cfg->minSpeed = preferences.getUChar("minSpd", MIN_SPEED_DEFAULT);
	cfg->speedScale = preferences.getUShort("spdScale", SPEED_SCALE_DEFAULT);

	// Other
	cfg->detectorTimeout = preferences.getUChar("detTo", DETECTOR_TIMEOUT_DEFAULT);
	cfg->summaryDisplayTime = preferences.getUChar("sumDispTime", SUMMARY_DISPLAY_TIME_DEFAULT);
	cfg->msgRepeatTimeout = preferences.getUChar("msgRepTo", MSG_REPEAT_TIMEOUT_DEFAULT);

	// Temperature
	cfg->temperatureEnable = preferences.getBool("tmpEn", TEMPERATURE_EN_DEFAULT);
	cfg->temperatureDisplay = preferences.getBool("tmpDisp", TEMPERATURE_DISP_DEFAULT);
	cfg->temperatureReal = preferences.getBool("tmpReal", TEMPERATURE_REAL_DEFAULT);
	cfg->temperatureUnitsF = preferences.getBool("tmpUnitF", TEMPERATURE_UNITS_F_DEFAULT);
	cfg->minTemperatureC = preferences.getFloat("tmpMin", (MIN_TEMPERATURE_F_DEFAULT - 32.0f) / 1.8f);
	cfg->maxTemperatureC = preferences.getFloat("tmpMax", (MAX_TEMPERATURE_F_DEFAULT - 32.0f) / 1.8f);

	// Defects
	cfg->defectHotJournalEnable = preferences.getBool("hjEn", DEFECT_HJ_EN_DEFAULT);
	cfg->defectHotJournalAxleRate = preferences.getUInt("hjRate", DEFECT_HJ_RATE_DEFAULT);

	cfg->defectHotWheelEnable = preferences.getBool("hwEn", DEFECT_HW_EN_DEFAULT);
	cfg->defectHotWheelAxleRate = preferences.getUInt("hwRate", DEFECT_HW_RATE_DEFAULT);

	cfg->defectHighImpactWheelEnable = preferences.getBool("hiwEn", DEFECT_HIW_EN_DEFAULT);
	cfg->defectHighImpactWheelAxleRate = preferences.getUInt("hiwRate", DEFECT_HIW_RATE_DEFAULT);

	cfg->defectDraggingEquipmentEnable = preferences.getBool("deEn", DEFECT_DE_EN_DEFAULT);
	cfg->defectDraggingEquipmentAxleRate = preferences.getUInt("deRate", DEFECT_DE_RATE_DEFAULT);

	cfg->defectHighLoadEnable = preferences.getBool("hlEn", DEFECT_HL_EN_DEFAULT);
	cfg->defectHighLoadAxleRate = preferences.getUInt("hlRate", DEFECT_HL_RATE_DEFAULT);

	cfg->defectWideLoadEnable = preferences.getBool("wlEn", DEFECT_WL_EN_DEFAULT);
	cfg->defectWideLoadAxleRate = preferences.getUInt("wlRate", DEFECT_WL_RATE_DEFAULT);

	cfg->defectIntegrityEnable = preferences.getBool("intgEn", DEFECT_INTEGRITY_EN_DEFAULT);
	cfg->defectIntegrityTrainRate = preferences.getUInt("intgRate", DEFECT_INTEGRITY_RATE_DEFAULT);

	// Messages
	cfg->entranceMessageEnable = preferences.getBool("entMsgEn", ENTRANCE_MSG_EN_DEFAULT);
	cfg->alertMessageEnable = preferences.getBool("altMsgEn", ALERT_MSG_EN_DEFAULT);
	cfg->talkOnDefectOnly = preferences.getBool("talkDefOnly", TALK_DEFECT_ONLY_DEFAULT);

	// Exit Config
	cfg->ordinalTypeId = preferences.getUChar("ordTypeId", ORDINAL_TYPE_ID_DEFAULT);
	cfg->maxDefects = preferences.getUChar("maxDef", MAX_DEFECTS_DEFAULT);

	// Operation Mode
	cfg->infrastructureMode = preferences.getBool("infra", INFRASTRUCTURE_MODE_DEFAULT);

	// Vocab
	String loadedVocab = preferences.getString("vocab", VOCAB_IN_USE_DEFAULT);
	cfg->vocabSelected = loadedVocab.c_str();

	// Misc. Stuff
	cfg->minAxleTime = preferences.getUChar("minAxTime", MIN_AXLE_TIME_DEFAULT);

	preferences.end();
}



void saveConfiguration(DetectorConfiguration* cfg)
{
	std::string key;

	preferences.begin(PREF_NAMESPACE, false);  // Open in read-write mode

	// Using inverted values as defaults forces
	// preferences.get*() to return a non-matching value if the key does not exist in NVS yet.

	if(cfg->volumeStep != preferences.getUChar("vol", ~cfg->volumeStep))
		preferences.putUChar("vol", cfg->volumeStep);

	if(cfg->noiseStep != preferences.getUChar("noise", ~cfg->noiseStep))
		preferences.putUChar("noise", cfg->noiseStep);

	if(cfg->pttDelay != preferences.getUChar("pttDelay", ~cfg->pttDelay))
		preferences.putUChar("pttDelay", cfg->pttDelay);

	if(cfg->popcornStep != preferences.getUChar("popcorn", ~cfg->popcornStep))
		preferences.putUChar("popcorn", cfg->popcornStep);

	if(cfg->lcdBrightness != preferences.getUChar("lcd", ~cfg->lcdBrightness))
		preferences.putUChar("lcd", cfg->lcdBrightness);

	if(cfg->milepostEnable != preferences.getBool("mpEn", !cfg->milepostEnable))
		preferences.putBool("mpEn", cfg->milepostEnable);

	if(cfg->milepostDisplay != preferences.getBool("mpDisp", !cfg->milepostDisplay))
		preferences.putBool("mpDisp", cfg->milepostDisplay);

	if(cfg->milepost != preferences.getUShort("mp", ~cfg->milepost))
		preferences.putUShort("mp", cfg->milepost);

	if(cfg->trackNameEnable != preferences.getBool("trkNameEn", !cfg->trackNameEnable))
		preferences.putBool("trkNameEn", cfg->trackNameEnable);

	for(uint32_t i=0; i<NUM_TRACKS; i++)
	{
		if (cfg->trackNameId[i] >= trackNames.size()) {
			cfg->trackNameId[i] = 0; 
		}

		key = "trkNameId" + std::to_string(i);
		if(cfg->trackNameId[i] != preferences.getUChar(key.c_str(), ~cfg->trackNameId[i]))
			preferences.putUChar(key.c_str(), cfg->trackNameId[i]);
	}

	if(cfg->directionEnable != preferences.getBool("dirEn", !cfg->directionEnable))
		preferences.putBool("dirEn", cfg->directionEnable);

	if (cfg->direction1NameId >= directionNames.size()) cfg->direction1NameId = 0;
	if(cfg->direction1NameId != preferences.getUChar("dir1Id", ~cfg->direction1NameId))
		preferences.putUChar("dir1Id", cfg->direction1NameId);

	if (cfg->direction2NameId >= directionNames.size()) cfg->direction2NameId = 0;
	if(cfg->direction2NameId != preferences.getUChar("dir2Id", ~cfg->direction2NameId))
		preferences.putUChar("dir2Id", cfg->direction2NameId);

	if(cfg->triggerDirection1Only != preferences.getBool("trigDir1", !cfg->triggerDirection1Only))
		preferences.putBool("trigDir1", cfg->triggerDirection1Only);

	if(cfg->triggerDirection2Only != preferences.getBool("trigDir2", !cfg->triggerDirection2Only))
		preferences.putBool("trigDir2", cfg->triggerDirection2Only);

	if(cfg->railNameEnable != preferences.getBool("railNameEn", !cfg->railNameEnable))
		preferences.putBool("railNameEn", cfg->railNameEnable);

	if (cfg->railNameId >= railNames.size()) cfg->railNameId = 0;
	if(cfg->railNameId != preferences.getUChar("railId", ~cfg->railNameId))
		preferences.putUChar("railId", cfg->railNameId);

	// Axles
	if(cfg->axleEnable != preferences.getBool("axleEn", !cfg->axleEnable))
		preferences.putBool("axleEn", cfg->axleEnable);

	if(cfg->entranceAxles != preferences.getUShort("entAxle", ~cfg->entranceAxles))
		preferences.putUShort("entAxle", cfg->entranceAxles);

	if(cfg->minAxles != preferences.getUShort("minAxle", ~cfg->minAxles))
		preferences.putUShort("minAxle", cfg->minAxles);

	// Speed
	if(cfg->speedEnable != preferences.getBool("spdEn", !cfg->speedEnable))
		preferences.putBool("spdEn", cfg->speedEnable);

	if(cfg->speedUnitsMph != preferences.getBool("spdUnit", !cfg->speedUnitsMph))
		preferences.putBool("spdUnit", cfg->speedUnitsMph);

	if(cfg->speedTypeEnter != preferences.getBool("spdTyp", !cfg->speedTypeEnter))
		preferences.putBool("spdTyp", cfg->speedTypeEnter);

	if(cfg->minSpeed != preferences.getUChar("minSpd", ~cfg->minSpeed))
		preferences.putUChar("minSpd", cfg->minSpeed);

	if(cfg->speedScale != preferences.getUShort("spdScale", ~cfg->speedScale))
		preferences.putUShort("spdScale", cfg->speedScale);

	// Other
	if(cfg->detectorTimeout != preferences.getUChar("detTo", ~cfg->detectorTimeout))
		preferences.putUChar("detTo", cfg->detectorTimeout);

	if(cfg->summaryDisplayTime != preferences.getUChar("sumDispTime", ~cfg->summaryDisplayTime))
		preferences.putUChar("sumDispTime", cfg->summaryDisplayTime);

	if(cfg->msgRepeatTimeout != preferences.getUChar("msgRepTo", ~cfg->msgRepeatTimeout))
		preferences.putUChar("msgRepTo", cfg->msgRepeatTimeout);

	// Temperature
	if(cfg->temperatureEnable != preferences.getBool("tmpEn", !cfg->temperatureEnable))
		preferences.putBool("tmpEn", cfg->temperatureEnable);

	if(cfg->temperatureDisplay != preferences.getBool("tmpDisp", !cfg->temperatureDisplay))
		preferences.putBool("tmpDisp", cfg->temperatureDisplay);

	if(cfg->temperatureReal != preferences.getBool("tmpReal", !cfg->temperatureReal))
		preferences.putBool("tmpReal", cfg->temperatureReal);

	if(cfg->temperatureUnitsF != preferences.getBool("tmpUnitF", !cfg->temperatureUnitsF))
		preferences.putBool("tmpUnitF", cfg->temperatureUnitsF);

	if(cfg->minTemperatureC != preferences.getFloat("tmpMin", NAN))
		preferences.putFloat("tmpMin", cfg->minTemperatureC);

	if(cfg->maxTemperatureC != preferences.getFloat("tmpMax", NAN))
		preferences.putFloat("tmpMax", cfg->maxTemperatureC);

	// Defects
	if(cfg->defectHotJournalEnable != preferences.getBool("hjEn", !cfg->defectHotJournalEnable))
		preferences.putBool("hjEn", cfg->defectHotJournalEnable);

	if(cfg->defectHotJournalAxleRate != preferences.getUInt("hjRate", ~cfg->defectHotJournalAxleRate))
		preferences.putUInt("hjRate", cfg->defectHotJournalAxleRate);

	if(cfg->defectHotWheelEnable != preferences.getBool("hwEn", !cfg->defectHotWheelEnable))
		preferences.putBool("hwEn", cfg->defectHotWheelEnable);

	if(cfg->defectHotWheelAxleRate != preferences.getUInt("hwRate", ~cfg->defectHotWheelAxleRate))
		preferences.putUInt("hwRate", cfg->defectHotWheelAxleRate);

	if(cfg->defectHighImpactWheelEnable != preferences.getBool("hiwEn", !cfg->defectHighImpactWheelEnable))
		preferences.putBool("hiwEn", cfg->defectHighImpactWheelEnable);

	if(cfg->defectHighImpactWheelAxleRate != preferences.getUInt("hiwRate", ~cfg->defectHighImpactWheelAxleRate))
		preferences.putUInt("hiwRate", cfg->defectHighImpactWheelAxleRate);

	if(cfg->defectDraggingEquipmentEnable != preferences.getBool("deEn", !cfg->defectDraggingEquipmentEnable))
		preferences.putBool("deEn", cfg->defectDraggingEquipmentEnable);

	if(cfg->defectDraggingEquipmentAxleRate != preferences.getUInt("deRate", ~cfg->defectDraggingEquipmentAxleRate))
		preferences.putUInt("deRate", cfg->defectDraggingEquipmentAxleRate);

	if(cfg->defectHighLoadEnable != preferences.getBool("hlEn", !cfg->defectHighLoadEnable))
		preferences.putBool("hlEn", cfg->defectHighLoadEnable);

	if(cfg->defectHighLoadAxleRate != preferences.getUInt("hlRate", ~cfg->defectHighLoadAxleRate))
		preferences.putUInt("hlRate", cfg->defectHighLoadAxleRate);

	if(cfg->defectWideLoadEnable != preferences.getBool("wlEn", !cfg->defectWideLoadEnable))
		preferences.putBool("wlEn", cfg->defectWideLoadEnable);

	if(cfg->defectWideLoadAxleRate != preferences.getUInt("wlRate", ~cfg->defectWideLoadAxleRate))
		preferences.putUInt("wlRate", cfg->defectWideLoadAxleRate);

	if(cfg->defectIntegrityEnable != preferences.getBool("intgEn", !cfg->defectIntegrityEnable))
		preferences.putBool("intgEn", cfg->defectIntegrityEnable);

	if(cfg->defectIntegrityTrainRate != preferences.getUInt("intgRate", ~cfg->defectIntegrityTrainRate))
		preferences.putUInt("intgRate", cfg->defectIntegrityTrainRate);

	// Messages
	if(cfg->entranceMessageEnable != preferences.getBool("entMsgEn", !cfg->entranceMessageEnable))
		preferences.putBool("entMsgEn", cfg->entranceMessageEnable);

	if(cfg->alertMessageEnable != preferences.getBool("altMsgEn", !cfg->alertMessageEnable))
		preferences.putBool("altMsgEn", cfg->alertMessageEnable);

	if(cfg->talkOnDefectOnly != preferences.getBool("talkDefOnly", !cfg->talkOnDefectOnly))
		preferences.putBool("talkDefOnly", cfg->talkOnDefectOnly);

	// Exit Config
	if(cfg->ordinalTypeId != preferences.getUChar("ordTypeId", ~cfg->ordinalTypeId))
		preferences.putUChar("ordTypeId", cfg->ordinalTypeId);

	if(cfg->maxDefects != preferences.getUChar("maxDef", ~cfg->maxDefects))
		preferences.putUChar("maxDef", cfg->maxDefects);

	// Operation Mode
	if(cfg->infrastructureMode != preferences.getBool("infra", !cfg->infrastructureMode))
		preferences.putBool("infra", cfg->infrastructureMode);

	// Vocab
	std::string storedVocab = preferences.getString("vocab", (cfg->vocabSelected + "_").c_str()).c_str();
	if(cfg->vocabSelected != storedVocab)
		preferences.putString("vocab", cfg->vocabSelected.c_str());

	// Misc. Stuff
	if(cfg->minAxleTime != preferences.getUChar("minAxTime", ~cfg->minAxleTime))
		preferences.putUChar("minAxTime", cfg->minAxleTime);

	preferences.end();
}



void printConfiguration(DetectorConfiguration* cfg)
{
	Serial.print("Volume: ");
	Serial.println(cfg->volumeStep);

	Serial.print("Noise Step: ");
	Serial.println(cfg->noiseStep);

	Serial.print("PTT Delay: ");
	Serial.println(cfg->pttDelay);

	Serial.print("Popcorn Step: ");
	Serial.println(cfg->popcornStep);

	Serial.print("Lcd Brightness: ");
	Serial.println(cfg->lcdBrightness);

	Serial.print("Milepost Enable: ");
	Serial.println(cfg->milepostEnable);

	Serial.print("Milepost Display: ");
	Serial.println(cfg->milepostDisplay);

	Serial.print("Milepost: ");
	Serial.println(cfg->milepost / 10.0);

	Serial.print("Track Name Enable: ");
	Serial.println(cfg->trackNameEnable);

	for(uint32_t i=0; i<NUM_TRACKS; i++)
	{
		Serial.print('\n');

		Serial.print("Track ");
		Serial.println(i+1);

		Serial.print("   Track Name ID: ");
		Serial.println(cfg->trackNameId[i]);
		
		Serial.print("   Track Name: ");
		Serial.println(cfg->trackName[i].c_str());
	}

	Serial.print("Direction Enable: ");
	Serial.println(cfg->directionEnable);
	Serial.print("   Direction 1 Name ID: ");
	Serial.println(cfg->direction1NameId);
	Serial.print("   Direction 1 Name: ");
	Serial.println(cfg->direction1Name.c_str());
	Serial.print("   Direction 2 Name ID: ");
	Serial.println(cfg->direction2NameId);
	Serial.print("   Direction 2 Name: ");
	Serial.println(cfg->direction2Name.c_str());
	Serial.print("   Trigger Direction 1 Only: ");
	Serial.println(cfg->triggerDirection1Only);
	Serial.print("   Trigger Direction 2 Only: ");
	Serial.println(cfg->triggerDirection2Only);

	Serial.print("Rail Name Enable: ");
	Serial.println(cfg->railNameEnable);
	Serial.print("   Rail Name ID: ");
	Serial.println(cfg->railNameId);
	Serial.print("   Rail Name: ");
	Serial.println(cfg->railName.c_str());

	Serial.print("Axle Enable: ");
	Serial.println(cfg->axleEnable);

	Serial.print("Entrance Axles: ");
	Serial.println(cfg->entranceAxles);

	Serial.print("Minimum Axles: ");
	Serial.println(cfg->minAxles);

	Serial.print("Speed Enable: ");
	Serial.println(cfg->speedEnable);

	Serial.print("Speed Units: ");
	if(cfg->speedUnitsMph)
		Serial.println("mph");
	else
		Serial.println("kph");

	Serial.print("Min Speed Type: ");
	if(cfg->speedTypeEnter)
		Serial.println("Entrance");
	else
		Serial.println("Exit");

	Serial.print("Min Speed: ");
	Serial.println(cfg->minSpeed);

	Serial.print("Speed Scale: ");
	Serial.println(cfg->speedScale / 10.0);

	// Other
	Serial.print("Detector Timeout: ");
	Serial.println(cfg->detectorTimeout);

	Serial.print("Summary Display Time: ");
	Serial.println(cfg->summaryDisplayTime);

	Serial.print("Message Repeat Timeout: ");
	Serial.println(cfg->msgRepeatTimeout);

	Serial.print("Temperature Enable: ");
	Serial.println(cfg->temperatureEnable);

	Serial.print("Temperature Display: ");
	Serial.println(cfg->temperatureDisplay);

	Serial.print("Temperature Mode: ");
	if(cfg->temperatureReal)
		Serial.println("Real");
	else
		Serial.println("Simulated");

	Serial.print("Temperature Units: ");
	if(cfg->temperatureUnitsF)
		Serial.println("Fahrenheit (F)");
	else
		Serial.println("Celsius (C)");

	Serial.print("Min Temperature Limit: ");
	Serial.println(cfg->minTemperatureC);

	Serial.print("Max Temperature Limit: ");
	Serial.println(cfg->maxTemperatureC);

	// Defects
	Serial.print("Hot Journal Enable: ");
	Serial.println(cfg->defectHotJournalEnable);
	Serial.print("Hot Journal Axle Rate: ");
	Serial.println(cfg->defectHotJournalAxleRate);

	Serial.print("Hot Wheel Enable: ");
	Serial.println(cfg->defectHotWheelEnable);
	Serial.print("Hot Wheel Axle Rate: ");
	Serial.println(cfg->defectHotWheelAxleRate);

	Serial.print("High Impact Wheel Enable: ");
	Serial.println(cfg->defectHighImpactWheelEnable);
	Serial.print("High Impact Wheel Axle Rate: ");
	Serial.println(cfg->defectHighImpactWheelAxleRate);

	Serial.print("Dragging Equipment Enable: ");
	Serial.println(cfg->defectDraggingEquipmentEnable);
	Serial.print("Dragging Equipment Axle Rate: ");
	Serial.println(cfg->defectDraggingEquipmentAxleRate);

	Serial.print("High Load Enable: ");
	Serial.println(cfg->defectHighLoadEnable);
	Serial.print("High Load Axle Rate: ");
	Serial.println(cfg->defectHighLoadAxleRate);

	Serial.print("Wide Load Enable: ");
	Serial.println(cfg->defectWideLoadEnable);
	Serial.print("Wide Load Axle Rate: ");
	Serial.println(cfg->defectWideLoadAxleRate);

	Serial.print("Integrity Enable: ");
	Serial.println(cfg->defectIntegrityEnable);
	Serial.print("Integrity Train Rate: ");
	Serial.println(cfg->defectIntegrityTrainRate);

	Serial.print("Entrance Message Enable: ");
	Serial.println(cfg->entranceMessageEnable);

	Serial.print("Alert Message Enable: ");
	Serial.println(cfg->alertMessageEnable);

	Serial.print("Talk On Defect Only: ");
	Serial.println(cfg->talkOnDefectOnly);

	// Exit Config
	Serial.print("Ordinal Type ID: ");
	Serial.println(cfg->ordinalTypeId);

	Serial.print("Max Defects: ");
	Serial.println(cfg->maxDefects);

	// Operation Mode
	Serial.print("Operation Mode: ");
	if(cfg->infrastructureMode)
		Serial.println("Infrastructure");
	else
		Serial.println("Defect Detect");

	// Vocab
	Serial.print("Vocab Selected: ");
	Serial.println(cfg->vocabSelected.c_str());

	// Misc. Stuff
	Serial.print("Minimum Axle Time: ");
	Serial.println(cfg->minAxleTime);
}



void resetConfiguration(void)
{
	preferences.begin(PREF_NAMESPACE, false);  // Open in read-write mode
	preferences.clear();
	preferences.end();
}



void updateTrackNames(DetectorConfiguration* cfg)
{
	for(uint32_t i=0; i<NUM_TRACKS; i++)
	{
		cfg->trackName[i] = trackNames[cfg->trackNameId[i]];
	}
}

void updateTrackNames(DetectorConfiguration* cfg, std::string trackA, std::string trackB)
{
	cfg->trackName[0] = trackA;
	cfg->trackName[1] = trackB;
}

void updateDirectionNames(DetectorConfiguration* cfg)
{
	cfg->direction1Name = cfg->directionEnable ? directionNames[cfg->direction1NameId] : "";
	cfg->direction2Name = cfg->directionEnable ? directionNames[cfg->direction2NameId] : "";
}

void updateDirectionNames(DetectorConfiguration* cfg, std::string dir1, std::string dir2)
{
	cfg->direction1Name = dir1;
	cfg->direction2Name = dir2;
}

void updateRailNames(DetectorConfiguration* cfg)
{
	cfg->railName = railNames[cfg->railNameId];
}

void updateRailNames(DetectorConfiguration* cfg, std::string rail)
{
	cfg->railName = rail;
}

int16_t getMinTemperature(DetectorConfiguration* cfg)
{
	if (cfg->temperatureUnitsF)
	{
		return static_cast<int16_t>(std::round((cfg->minTemperatureC * 1.8f) + 32.0f));
	}
	return static_cast<int16_t>(std::round(cfg->minTemperatureC));
}

int16_t getMaxTemperature(DetectorConfiguration* cfg)
{
	if (cfg->temperatureUnitsF)
	{
		return static_cast<int16_t>(std::round((cfg->maxTemperatureC * 1.8f) + 32.0f));
	}
	return static_cast<int16_t>(std::round(cfg->maxTemperatureC));
}

void setMinTemperature(DetectorConfiguration* cfg, int16_t temperature)
{
	if (cfg->temperatureUnitsF)
	{
		cfg->minTemperatureC = (static_cast<float>(temperature) - 32.0f) / 1.8f;
	}
	else
	{
		cfg->minTemperatureC = static_cast<float>(temperature);
	}
}

void setMaxTemperature(DetectorConfiguration* cfg, int16_t temperature)
{
	if (cfg->temperatureUnitsF)
	{
		cfg->maxTemperatureC = (static_cast<float>(temperature) - 32.0f) / 1.8f;
	}
	else
	{
		cfg->maxTemperatureC = static_cast<float>(temperature);
	}
}
