IowaScaledEngineering/ckt-defect/src/ckt-defect/vocab/include/alarm.h

const unsigned char vocab_alarm[] = {
  0x00, 0x00, 0x01, 0x00, 0x03, 0x00, 0x06, 0x00, 0x06, 0x00, 0x03, 0x00,
  0x00, 0x00, 0xfd, 0xff, 0xf8, 0xff, 0xf4, 0xff, 0xef, 0xff, 0xf5, 0xff,
  0xf6, 0xff, 0xf6, 0xff, 0x09, 0x00, 0x15, 0x00, 0x05, 0x00, 0xf9, 0xff,
  0xfb, 0xff, 0xf5, 0xff, 0xdb, 0xff, 0xc6, 0xff, 0xc7, 0xff, 0xcf, 0xff,
  0xbb, 0xff, 0xc4, 0xff, 0xf5, 0xff, 0x00, 0x00, 0xe6, 0xff, 0x10, 0x00,
  0x5d, 0x00, 0x67, 0x00, 0x3e, 0x00, 0x46, 0x00, 0x6f, 0x00, 0x7c, 0x00,
  0x39, 0x00, 0x11, 0x00, 0x28, 0x00, 0x31, 0x00, 0xfe, 0xff, 0x12, 0x00,
  0x31, 0x00, 0x11, 0x00, 0x01, 0x00, 0x33, 0x00, 0x51, 0x00, 0x2c, 0x00,
  0xf3, 0xff, 0xe6, 0xff, 0xf4, 0xff, 0xc5, 0xff, 0x70, 0xff, 0x3f, 0xff,
  0x28, 0xff, 0xf1, 0xfe, 0xd5, 0xfe, 0xf3, 0xfe, 0x29, 0xff, 0x1f, 0xff,
  0x5e, 0xff, 0xa4, 0xff, 0xe6, 0xff, 0x66, 0xff, 0xb0, 0xff, 0x85, 0x00,
  0x7f, 0x00, 0x84, 0x00, 0x9f, 0x00, 0x37, 0x01, 0x40, 0x01, 0x45, 0x01,
  0x73, 0x01, 0x25, 0x01, 0x23, 0x01, 0xdb, 0x00, 0x8e, 0x00, 0xd5, 0xff,
  0x0f, 0xff, 0x33, 0xff, 0x3c, 0xff, 0xb4, 0xfe, 0xd2, 0xfd, 0x29, 0xfe,
  0x3a, 0xff, 0xf8, 0xff, 0xbe, 0xff, 0x57, 0xff, 0x3f, 0x00, 0x40, 0x01,
  0x27, 0x01, 0x77, 0x00, 0x97, 0xff, 0x3c, 0xff, 0xcc, 0xff, 0x20, 0x00,
  0xb4, 0x00, 0x83, 0x00, 0x26, 0x01, 0x5d, 0x04, 0x10, 0x09, 0x89, 0x0a,
  0x93, 0x08, 0x6a, 0x09, 0xa1, 0x0e, 0x07, 0x10, 0xc8, 0x07, 0x8a, 0xfe,
  0xfe, 0xfd, 0x59, 0xff, 0x91, 0xf6, 0xb6, 0xe9, 0x08, 0xe8, 0xa7, 0xef,
  0x16, 0xf1, 0xa5, 0xea, 0xfc, 0xea, 0x42, 0xf5, 0xe2, 0xfb, 0x87, 0xf9,
  0xb3, 0xf9, 0xbf, 0x01, 0x5d, 0x05, 0x8c, 0xff, 0x6c, 0xfc, 0x00, 0x03,
  0xaa, 0x07, 0x43, 0x02, 0x2a, 0xfd, 0x9b, 0x03, 0x2b, 0x0e, 0xd3, 0x10,
  0xea, 0x0d, 0x7f, 0x10, 0xd5, 0x17, 0x03, 0x1b, 0x80, 0x17, 0x7f, 0x13,
  0x23, 0x11, 0x43, 0x0c, 0x9a, 0x03, 0xad, 0xfc, 0x31, 0xf8, 0xe7, 0xf1,
  0x2e, 0xe9, 0x0f, 0xe6, 0x44, 0xea, 0xa3, 0xed, 0xea, 0xea, 0xc4, 0xea,
  0xe1, 0xf2, 0xb6, 0xfb, 0xf3, 0xfc, 0xe9, 0xfa, 0xd1, 0xfc, 0xb9, 0x00,
  0x9f, 0x00, 0x62, 0xfe, 0x59, 0xfe, 0xab, 0xff, 0xd0, 0xff, 0xca, 0x01,
  0xc5, 0x07, 0x52, 0x0e, 0xa6, 0x10, 0x53, 0x11, 0x8a, 0x15, 0x1b, 0x1b,
  0x25, 0x1a, 0xd7, 0x12, 0xb4, 0x0b, 0x39, 0x08, 0xfd, 0x02, 0xf6, 0xf9,
  0xab, 0xf0, 0xa2, 0xeb, 0x66, 0xe9, 0x4f, 0xe8, 0x35, 0xe8, 0x5d, 0xea,
  0xd6, 0xed, 0x8f, 0xf2, 0x4a, 0xf8, 0x9a, 0xfe, 0xe9, 0x02, 0xd3, 0x04,
  0x22, 0x06, 0x14, 0x09, 0x5c, 0x0a, 0x15, 0x08, 0x51, 0x03, 0x0d, 0x02,
  0xc8, 0x05, 0xcf, 0x08, 0x16, 0x08, 0x71, 0x02, 0xc3, 0x03, 0x28, 0x0c,
  0xba, 0x12, 0x05, 0x0f, 0xdf, 0x03, 0x41, 0x02, 0xa2, 0x02, 0x7d, 0x01,
  0x29, 0xfa, 0xea, 0xee, 0x1f, 0xe8, 0x56, 0xe8, 0xf3, 0xec, 0x96, 0xed,
  0x2d, 0xec, 0xe6, 0xee, 0x96, 0xf4, 0xef, 0xfd, 0x7e, 0x06, 0x43, 0x0a,
  0x7c, 0x0a, 0x12, 0x0b, 0xe5, 0x0f, 0x49, 0x12, 0xc0, 0x0e, 0xf5, 0x08,
  0xea, 0x03, 0xf0, 0x03, 0x05, 0x06, 0x89, 0x06, 0x79, 0x02, 0x85, 0x00,
  0x12, 0x03, 0xde, 0x05, 0xfa, 0x04, 0x1c, 0x04, 0xb1, 0x01, 0xc7, 0xfe,
  0x68, 0xfc, 0x82, 0xf8, 0x5e, 0xf7, 0x29, 0xf7, 0xa1, 0xf2, 0x37, 0xf0,
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
};
const unsigned int vocab_alarm_len = 19292;
