IowaScaledEngineering/ckt-defect/src/ckt-defect/vocab/include/wheel.h

const unsigned char vocab_wheel[] = {
  0x00, 0x00, 0x03, 0x00, 0x07, 0x00, 0x0a, 0x00, 0x0b, 0x00, 0x12, 0x00,
  0x16, 0x00, 0x12, 0x00, 0x0c, 0x00, 0x09, 0x00, 0x02, 0x00, 0xf4, 0xff,
  0xdf, 0xff, 0xd2, 0xff, 0xc4, 0xff, 0xb4, 0xff, 0xa3, 0xff, 0x9d, 0xff,
  0x9d, 0xff, 0xa5, 0xff, 0xa8, 0xff, 0xae, 0xff, 0xb5, 0xff, 0xc8, 0xff,
  0xdf, 0xff, 0xf2, 0xff, 0xfc, 0xff, 0x0e, 0x00, 0x31, 0x00, 0x4a, 0x00,
  0x46, 0x00, 0x48, 0x00, 0x5b, 0x00, 0x75, 0x00, 0x60, 0x00, 0x38, 0x00,
  0x22, 0x00, 0x2a, 0x00, 0x11, 0x00, 0xe1, 0xff, 0xc1, 0xff, 0xde, 0xff,
  0x07, 0x00, 0x0b, 0x00, 0x05, 0x00, 0x35, 0x00, 0x86, 0x00, 0xbc, 0x00,
  0xb9, 0x00, 0xc2, 0x00, 0xe8, 0x00, 0x06, 0x01, 0xcb, 0x00, 0x86, 0x00,
  0x59, 0x00, 0x3f, 0x00, 0xff, 0xff, 0x98, 0xff, 0x43, 0xff, 0x1c, 0xff,
  0xf3, 0xfe, 0xc4, 0xfe, 0x97, 0xfe, 0x92, 0xfe, 0xaa, 0xfe, 0xcf, 0xfe,
  0xe0, 0xfe, 0x11, 0xff, 0x53, 0xff, 0xb0, 0xff, 0xf9, 0xff, 0x35, 0x00,
  0x74, 0x00, 0xc6, 0x00, 0xfa, 0x00, 0x0c, 0x01, 0x0a, 0x01, 0x01, 0x01,
  0xe9, 0x00, 0xc3, 0x00, 0x75, 0x00, 0x3a, 0x00, 0x11, 0x00, 0xff, 0xff,
  0xd4, 0xff, 0xb8, 0xff, 0xb0, 0xff, 0xc2, 0xff, 0xca, 0xff, 0xe0, 0xff,
  0xe6, 0xff, 0xea, 0xff, 0x07, 0x00, 0x4a, 0x00, 0x64, 0x00, 0x69, 0x00,
  0x59, 0x00, 0x9b, 0x00, 0x74, 0x00, 0x4b, 0x00, 0xd5, 0xff, 0xe4, 0xff,
  0xbf, 0xff, 0x80, 0xff, 0xe0, 0xfe, 0xc8, 0xfe, 0x0c, 0xff, 0x3b, 0xff,
  0xf3, 0xfe, 0x10, 0xff, 0xc5, 0xff, 0xb4, 0x00, 0x07, 0x01, 0xdb, 0x01,
  0x6c, 0x03, 0x06, 0x05, 0x01, 0x05, 0x06, 0x04, 0x80, 0x03, 0xe5, 0x03,
  0x3e, 0x03, 0x2c, 0x01, 0x05, 0xff, 0xf4, 0xfd, 0x0e, 0xfd, 0x77, 0xfb,
  0x05, 0xfa, 0xdf, 0xf9, 0x81, 0xfa, 0xf2, 0xfa, 0xfc, 0xfa, 0xb4, 0xfb,
  0x06, 0xfd, 0x91, 0xfe, 0x61, 0xff, 0xb3, 0xff, 0xef, 0xff, 0xb1, 0x00,
  0x4f, 0x01, 0x49, 0x01, 0xa1, 0x00, 0x3e, 0x00, 0x6b, 0x00, 0x4d, 0x00,
  0x7c, 0xff, 0xb9, 0xfe, 0xde, 0xfe, 0x61, 0xff, 0x3f, 0xff, 0xc8, 0xfe,
  0x16, 0xff, 0x9b, 0x00, 0xa6, 0x01, 0xbb, 0x01, 0xc1, 0x01, 0x1e, 0x03,
  0xc4, 0x04, 0x42, 0x05, 0xc8, 0x04, 0xf2, 0x04, 0xcb, 0x05, 0xee, 0x05,
  0xa4, 0x04, 0x5b, 0x03, 0xfd, 0x02, 0xaf, 0x02, 0x4d, 0x01, 0x9c, 0xff,
  0x80, 0xfe, 0x2c, 0xfe, 0x8a, 0xfd, 0xb8, 0xfc, 0xf9, 0xfb, 0x02, 0xfc,
  0x65, 0xfc, 0xf9, 0xfc, 0x70, 0xfd, 0xf5, 0xfd, 0x8b, 0xfe, 0x32, 0xff,
  0x93, 0xff, 0xa3, 0xff, 0x7b, 0xff, 0x79, 0xff, 0x30, 0xff, 0x88, 0xfe,
  0x36, 0xfd, 0x29, 0xfc, 0xa9, 0xfb, 0x91, 0xfb, 0xf6, 0xfa, 0x66, 0xfa,
  0xc3, 0xfa, 0x68, 0xfc, 0xca, 0xfd, 0xeb, 0xfe, 0x68, 0x00, 0xdd, 0x02,
  0xc4, 0x04, 0x00, 0x06, 0xbf, 0x06, 0xd8, 0x07, 0x44, 0x08, 0x91, 0x07,
  0xf8, 0x05, 0xb8, 0x04, 0xaf, 0x03, 0x41, 0x02, 0x2c, 0x00, 0x80, 0xfe,
  0x9e, 0xfd, 0x15, 0xfd, 0x43, 0xfc, 0x64, 0xfc, 0x60, 0xfd, 0xad, 0xfe,
  0xef, 0xfe, 0x46, 0xff, 0x71, 0x00, 0xe0, 0x01, 0x26, 0x02, 0x4a, 0x01,
  0x46, 0x00, 0x97, 0xff, 0x0f, 0xfe, 0xa5, 0xfc, 0xcc, 0xfb, 0xba, 0xfc,
  0x11, 0xfc, 0x0b, 0xfb, 0xbe, 0xf9, 0xa0, 0xfc, 0x78, 0xff, 0xd3, 0x01,
  0xa6, 0x01, 0xa9, 0x02, 0xae, 0x03, 0xeb, 0x04, 0xd2, 0x04, 0xe3, 0x06,
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
};
const unsigned int vocab_wheel_len = 16000;
