IowaScaledEngineering/ckt-defect/src/ckt-defect/menu-factory.cpp

#include "menu-factory.h"
#include <vector>
#include <string>

// Include the specific menu implementation headers
#include "src/menu/menu-mgr.h"
#include "menu-custom.h"
#include "audio.h"
#include "axle.h"

namespace {
// File-scoped menu references restricted to this translation unit
std::shared_ptr<Menu> menuHotJournalRate;
std::shared_ptr<Menu> menuHotWheelRate;
std::shared_ptr<Menu> menuHighImpactWheelRate;
std::shared_ptr<Menu> menuDraggingEquipmentRate;
std::shared_ptr<Menu> menuHighLoadRate;
std::shared_ptr<Menu> menuWideLoadRate;
std::shared_ptr<Menu> menuRandomIntegrityRate;
} // namespace

void updateAllMenuVisibility(const DetectorConfiguration &cfg)
{
	// Defect Rate Visibilities
	if (cfg.defectHotJournalEnable) {
		if (menuHotJournalRate) menuHotJournalRate->unhide();
	} else {
		if (menuHotJournalRate) menuHotJournalRate->hide();
	}

	if (cfg.defectHotWheelEnable) {
		if (menuHotWheelRate) menuHotWheelRate->unhide();
	} else {
		if (menuHotWheelRate) menuHotWheelRate->hide();
	}

	if (cfg.defectHighImpactWheelEnable) {
		if (menuHighImpactWheelRate) menuHighImpactWheelRate->unhide();
	} else {
		if (menuHighImpactWheelRate) menuHighImpactWheelRate->hide();
	}

	if (cfg.defectDraggingEquipmentEnable) {
		if (menuDraggingEquipmentRate) menuDraggingEquipmentRate->unhide();
	} else {
		if (menuDraggingEquipmentRate) menuDraggingEquipmentRate->hide();
	}

	if (cfg.defectHighLoadEnable) {
		if (menuHighLoadRate) menuHighLoadRate->unhide();
	} else {
		if (menuHighLoadRate) menuHighLoadRate->hide();
	}

	if (cfg.defectWideLoadEnable) {
		if (menuWideLoadRate) menuWideLoadRate->unhide();
	} else {
		if (menuWideLoadRate) menuWideLoadRate->hide();
	}

	if (cfg.defectIntegrityEnable) {
		if (menuRandomIntegrityRate) menuRandomIntegrityRate->unhide();
	} else {
		if (menuRandomIntegrityRate) menuRandomIntegrityRate->hide();
	}
}

std::shared_ptr<Menu> createAppMenu(DetectorConfiguration &cfg, DisplayLcd *lcd, DataBundle* data, MessageBundle &trackMessages)
{
	// Create the root home menu and main branch
	auto home = std::make_shared<MenuHome>("Home", cfg, data);
	auto mainSel = std::make_shared<MenuListSelector>("Main");
	home->addChild(mainSel);

	// Milepost
	auto menuMilepost = std::make_shared<MenuDigitThumbwheel>(
		"Milepost",
		&cfg.milepost,
		false,
		4,
		1,
		true,
		[&cfg]() { saveConfiguration(&cfg); }
	);

	// Track
	auto menuTrackConfig = std::make_shared<MenuListSelector>("Track");
	auto menuTrackNameA = std::make_shared<MenuOptionSelector>(
		"Track A Name", 
		&cfg.trackNameId[0],
		false,
		trackNames,
		[&cfg]() { saveConfiguration(&cfg); updateTrackNames(&cfg); }
	);

	auto menuTrackNameB = std::make_shared<MenuOptionSelector>(
		"Track B Name", 
		&cfg.trackNameId[1],
		false,
		trackNames,
		[&cfg]() { saveConfiguration(&cfg); updateTrackNames(&cfg); }
	);
	
	// Axle
	auto menuAxleConfig = std::make_shared<MenuListSelector>("Axles");
	auto menuEntranceAxles = std::make_shared<MenuNumberDial>(
		"Entrance Axles",
		&cfg.entranceAxles,
		false,
		ENTRANCE_AXLES_MIN,
		ENTRANCE_AXLES_MAX,
		1,
		"",
		[&cfg]() { saveConfiguration(&cfg); }
	);
	auto menuMinAxles = std::make_shared<MenuNumberDial>(
		"Minimum Axles",
		&cfg.minAxles,
		false,
		MIN_AXLES_MIN,
		MIN_AXLES_MAX,
		1,
		"",
		[&cfg]() { saveConfiguration(&cfg); }
	);

	// Speed
	auto menuSpeedConfig = std::make_shared<MenuListSelector>("Speed");
	auto menuSpeedType = std::make_shared<MenuBoolSelector>(
		"Enter/Exit",
		&cfg.speedTypeEnter,
		false, 
		"Entrance Speed", "ENTR",
		"Exit Speed", "EXIT", 
		[&cfg]() { saveConfiguration(&cfg); }
	);
	auto menuMinSpeed = std::make_shared<MenuNumberDial>(
		"Minimum Speed",
		&cfg.minSpeed,
		false,
		MIN_SPEED_MIN,
		MIN_SPEED_MAX,
		1,
		cfg.speedUnitsMph ? "mph" : "kph",
		[&cfg]() { saveConfiguration(&cfg); }
	);
	auto menuSpeedUnits = std::make_shared<MenuBoolSelector>(
		"Units",
		&cfg.speedUnitsMph,
		false, 
		"Miles/Hour", "MPH",
		"Kilometers/Hour", "KPH", 
		[&cfg, menuMinSpeed]() { saveConfiguration(&cfg); std::static_pointer_cast<MenuNumberDial>(menuMinSpeed)->setUnits(cfg.speedUnitsMph ? "mph" : "kph"); }
	);
	auto menuSpeedScale = std::make_shared<MenuDigitThumbwheel>(
		"Speed Scale",
		&cfg.speedScale,
		false,
		3,
		1,
		true,
		[&cfg]() { saveConfiguration(&cfg); }
	);

	// Direction
	auto menuDirectionConfig = std::make_shared<MenuListSelector>("Direction");
	auto menuDirectionName1 = std::make_shared<MenuOptionSelector>(
		"Direction 1 Name", 
		&cfg.direction1NameId,
		false,
		directionNames,
		[&cfg]() { saveConfiguration(&cfg); updateDirectionNames(&cfg); }
	);
	auto menuDirectionName2 = std::make_shared<MenuOptionSelector>(
		"Direction 2 Name", 
		&cfg.direction2NameId,
		false,
		directionNames,
		[&cfg]() { saveConfiguration(&cfg); updateDirectionNames(&cfg); }
	);
	auto menuTriggerDir1 = std::make_shared<MenuBoolSelector>(
		"Trigger Dir 1 Only",
		&cfg.triggerDirection1Only,
		false,
		"On", "ON",
		"Off", "OFF"
	);
	auto menuTriggerDir2 = std::make_shared<MenuBoolSelector>(
		"Trigger Dir 2 Only",
		&cfg.triggerDirection2Only,
		false,
		"On", "ON",
		"Off", "OFF"
	);

	// Rail Name
	auto menuRailName = std::make_shared<MenuOptionSelector>(
		"Rail Names", 
		&cfg.railNameId,
		false,
		railNames,
		[&cfg]() { saveConfiguration(&cfg); updateRailNames(&cfg); }
	);

	// Temperature
	auto menuTemperatureConfig = std::make_shared<MenuListSelector>("Temperature");
	auto menuTemperatureType = std::make_shared<MenuBoolSelector>(
		"Real/Simulated",
		&cfg.temperatureReal,
		false, 
		"Real", "REAL",
		"Simulated", "SIM",
		[&cfg]() { saveConfiguration(&cfg); }
	);
	std::string degF("\xDF" "F", 2);
	std::string degC("\xDF" "C", 2);
	auto menuMinTemperature = std::make_shared<MenuNumberDial>(
		"Minimum Temp",
		[&cfg]() { return getMinTemperature(&cfg); },
		[&cfg](int16_t val) { setMinTemperature(&cfg, val); },
		false,
		TEMPERATURE_MIN,
		TEMPERATURE_MAX,
		1,
		cfg.temperatureUnitsF ? degF : degC,
		[&cfg]() { saveConfiguration(&cfg); }
	);
	auto menuMaxTemperature = std::make_shared<MenuNumberDial>(
		"Maximum Temp",
		[&cfg]() { return getMaxTemperature(&cfg); },
		[&cfg](int16_t val) { setMaxTemperature(&cfg, val); },
		false,
		TEMPERATURE_MIN,
		TEMPERATURE_MAX,
		1,
		cfg.temperatureUnitsF ? degF : degC,
		[&cfg]() { saveConfiguration(&cfg); }
	);
	auto menuTemperatureUnits = std::make_shared<MenuBoolSelector>(
		"Units",
		&cfg.temperatureUnitsF,
		false, 
		"Fahrenheit", degF,
		"Celsius", degC, 
		[&cfg, degF, degC, menuMinTemperature, menuMaxTemperature]() {
			saveConfiguration(&cfg);
			std::static_pointer_cast<MenuNumberDial>(menuMinTemperature)->setUnits(cfg.temperatureUnitsF ? degF : degC);
			std::static_pointer_cast<MenuNumberDial>(menuMaxTemperature)->setUnits(cfg.temperatureUnitsF ? degF : degC);
		}
	);

	// Defect
	auto menuDefects = std::make_shared<MenuListSelector>("Defects");

	// Hot Journal
	auto menuHotJournal = std::make_shared<MenuListSelector>("Hot Journal");
	auto menuHotJournalEn = std::make_shared<MenuBoolSelector>(
		"Hot Journal Enable",
		&cfg.defectHotJournalEnable,
		false,
		"On", "ON",
		"Off", "OFF"
	);
	menuHotJournalRate = std::make_shared<MenuDigitThumbwheel>(
		"Axle Rate",
		&cfg.defectHotJournalAxleRate,
		false,
		6,
		0,
		true,
		[&cfg, &trackMessages]() {
			if (cfg.defectHotJournalAxleRate == 0) {
				cfg.defectHotJournalAxleRate = 1;
			}
			saveConfiguration(&cfg);
			updateMessages(trackMessages, cfg);
		}
	);

	// Hot Wheel
	auto menuHotWheel = std::make_shared<MenuListSelector>("Hot Wheel");
	auto menuHotWheelEn = std::make_shared<MenuBoolSelector>(
		"Hot Wheel Enable",
		&cfg.defectHotWheelEnable,
		false,
		"On", "ON",
		"Off", "OFF"
	);
	menuHotWheelRate = std::make_shared<MenuDigitThumbwheel>(
		"Axle Rate",
		&cfg.defectHotWheelAxleRate,
		false,
		6,
		0,
		true,
		[&cfg, &trackMessages]() {
			if (cfg.defectHotWheelAxleRate == 0) {
				cfg.defectHotWheelAxleRate = 1;
			}
			saveConfiguration(&cfg);
			updateMessages(trackMessages, cfg);
		}
	);

	// High Impact Wheel
	auto menuHighImpactWheel = std::make_shared<MenuListSelector>("High Impact Wheel");
	auto menuHighImpactWheelEn = std::make_shared<MenuBoolSelector>(
		"High Impact Enable",
		&cfg.defectHighImpactWheelEnable,
		false,
		"On", "ON",
		"Off", "OFF"
	);
	menuHighImpactWheelRate = std::make_shared<MenuDigitThumbwheel>(
		"Axle Rate",
		&cfg.defectHighImpactWheelAxleRate,
		false,
		6,
		0,
		true,
		[&cfg, &trackMessages]() {
			if (cfg.defectHighImpactWheelAxleRate == 0) {
				cfg.defectHighImpactWheelAxleRate = 1;
			}
			saveConfiguration(&cfg);
			updateMessages(trackMessages, cfg);
		}
	);

	// Dragging Equipment
	auto menuDraggingEquipment = std::make_shared<MenuListSelector>("Dragging Equip");
	auto menuDraggingEquipmentEn = std::make_shared<MenuBoolSelector>(
		"Drag Equip Enable",
		&cfg.defectDraggingEquipmentEnable,
		false,
		"On", "ON",
		"Off", "OFF"
	);
	menuDraggingEquipmentRate = std::make_shared<MenuDigitThumbwheel>(
		"Axle Rate",
		&cfg.defectDraggingEquipmentAxleRate,
		false,
		6,
		0,
		true,
		[&cfg, &trackMessages]() {
			if (cfg.defectDraggingEquipmentAxleRate == 0) {
				cfg.defectDraggingEquipmentAxleRate = 1;
			}
			saveConfiguration(&cfg);
			updateMessages(trackMessages, cfg);
		}
	);

	// High Load
	auto menuHighLoad = std::make_shared<MenuListSelector>("High Load");
	auto menuHighLoadEn = std::make_shared<MenuBoolSelector>(
		"High Load Enable",
		&cfg.defectHighLoadEnable,
		false,
		"On", "ON",
		"Off", "OFF"
	);
	menuHighLoadRate = std::make_shared<MenuDigitThumbwheel>(
		"Axle Rate",
		&cfg.defectHighLoadAxleRate,
		false,
		6,
		0,
		true,
		[&cfg, &trackMessages]() {
			if (cfg.defectHighLoadAxleRate == 0) {
				cfg.defectHighLoadAxleRate = 1;
			}
			saveConfiguration(&cfg);
			updateMessages(trackMessages, cfg);
		}
	);

	// Wide Load
	auto menuWideLoad = std::make_shared<MenuListSelector>("Wide Load");
	auto menuWideLoadEn = std::make_shared<MenuBoolSelector>(
		"Wide Load Enable",
		&cfg.defectWideLoadEnable,
		false,
		"On", "ON",
		"Off", "OFF"
	);
	menuWideLoadRate = std::make_shared<MenuDigitThumbwheel>(
		"Axle Rate",
		&cfg.defectWideLoadAxleRate,
		false,
		6,
		0,
		true,
		[&cfg, &trackMessages]() {
			if (cfg.defectWideLoadAxleRate == 0) {
				cfg.defectWideLoadAxleRate = 1;
			}
			saveConfiguration(&cfg);
			updateMessages(trackMessages, cfg);
		}
	);

	// Messages
	auto menuMessages = std::make_shared<MenuListSelector>("Messages");
	auto menuEntranceMessage = std::make_shared<MenuBoolSelector>(
		"Entrance Message",
		&cfg.entranceMessageEnable,
		false, 
		"On", "ON", 
		"Off", "OFF"
	);
	auto menuAlertMessage = std::make_shared<MenuBoolSelector>(
		"Live Defect Msgs",
		&cfg.alertMessageEnable,
		false, 
		"On", "ON", 
		"Off", "OFF"
	);

	// Exit Message
	auto menuExitMessage = std::make_shared<MenuListSelector>("Exit Message");
	auto menuTalkDefectOnly = std::make_shared<MenuBoolSelector>(
		"Talk Defect Only",
		&cfg.talkOnDefectOnly,
		false, 
		"On", "ON", 
		"Off", "OFF"
	);

	auto menuMaxDefects = std::make_shared<MenuNumberDial>(
		"Max Defects",
		&cfg.maxDefects,
		false,
		MAX_DEFECTS_MIN,
		MAX_DEFECTS_MAX,
		1,
		"defects",
		[&cfg]() { saveConfiguration(&cfg); }
	);
	auto menuOrdinalType = std::make_shared<MenuOptionSelector>(
		"Ordinal Type", 
		&cfg.ordinalTypeId,
		false,
		ordinalTypes,
		[&cfg, &trackMessages]() { saveConfiguration(&cfg); updateMessages(trackMessages, cfg); }
	);

	// Random Integrity
	auto menuRandomIntegrity = std::make_shared<MenuListSelector>("Random Integrity");
	auto menuRandomIntegrityEn = std::make_shared<MenuBoolSelector>(
		"Integrity Enable",
		&cfg.defectIntegrityEnable,
		false,
		"On", "ON",
		"Off", "OFF"
	);
	menuRandomIntegrityRate = std::make_shared<MenuDigitThumbwheel>(
		"Train Rate",
		&cfg.defectIntegrityTrainRate,
		false,
		6,
		0,
		true,
		[&cfg, &trackMessages]() {
			if (cfg.defectIntegrityTrainRate == 0) {
				cfg.defectIntegrityTrainRate = 1;
			}
			saveConfiguration(&cfg);
			updateMessages(trackMessages, cfg);
		}
	);

	// Message Bits
	auto menuMilepostEn = std::make_shared<MenuBoolSelector>(
		"Include Milepost",
		&cfg.milepostEnable, 
		false, 
		"On", "ON", 
		"Off", "OFF"
	);
	auto menuTrackNameEn = std::make_shared<MenuBoolSelector>(
		"Include Track Name",
		&cfg.trackNameEnable, 
		false, 
		"On", "ON", 
		"Off", "OFF"
	);
	auto menuAxleEn = std::make_shared<MenuBoolSelector>(
		"Include Axle Count",
		&cfg.axleEnable, 
		false, 
		"On", "ON", 
		"Off", "OFF"
	);
	auto menuSpeedEn = std::make_shared<MenuBoolSelector>(
		"Include Speed",
		&cfg.speedEnable, 
		false, 
		"On", "ON", 
		"Off", "OFF"
	);
	auto menuDirectionEn = std::make_shared<MenuBoolSelector>(
		"Include Direction",
		&cfg.directionEnable, 
		false, 
		"On", "ON", 
		"Off", "OFF"
	);
	auto menuRailNameEn = std::make_shared<MenuBoolSelector>(
		"Include Rail Name",
		&cfg.railNameEnable, 
		false, 
		"On", "ON", 
		"Off", "OFF"
	);
	auto menuTemperatureEn = std::make_shared<MenuBoolSelector>(
		"Include Temp",
		&cfg.temperatureEnable, 
		false, 
		"On", "ON", 
		"Off", "OFF"
	);

	// Operation Mode
	auto menuOperationMode = std::make_shared<MenuBoolSelector>(
		"Operation Mode",
		&cfg.infrastructureMode,
		false,
		"Infrastructure", "INFR",
		"Defect Detect", "DFCT",
		[&cfg]() { saveConfiguration(&cfg); }
	);

	// Timing
	auto menuTimingConfig = std::make_shared<MenuListSelector>("Timing");
	auto menuDetectorTimeout = std::make_shared<MenuNumberDial>(
		"Detector Timeout",
		&cfg.detectorTimeout,
		false,
		DETECTOR_TIMEOUT_MIN,
		DETECTOR_TIMEOUT_MAX,
		1,
		"sec",
		[&cfg]() { saveConfiguration(&cfg); }
	);
	auto menuSummaryDisplayTime = std::make_shared<MenuNumberDial>(
		"Summary Disp Time",
		&cfg.summaryDisplayTime,
		false,
		SUMMARY_DISP_TIME_MIN,
		SUMMARY_DISP_TIME_MAX,
		1,
		"sec",
		[&cfg]() { saveConfiguration(&cfg); }
	);
	auto menuMsgRepeatTimeout = std::make_shared<MenuNumberDial>(
		"Msg Repeat Timeout",
		&cfg.msgRepeatTimeout,
		false,
		MSG_REPEAT_TIMEOUT_MIN,
		MSG_REPEAT_TIMEOUT_MAX,
		1,
		"sec",
		[&cfg]() { saveConfiguration(&cfg); }
	);

	// Audio
	auto menuAudio = std::make_shared<MenuListSelector>("Audio");
	auto menuVolume = std::make_shared<MenuVolume>(
		"Audio Volume",
		5,
		true,
		150,
		audioGetVolumeStep,
		audioSetVolumeStep,
		[lcd, &cfg]() { cfg.volumeStep = audioGetVolumeStep(); saveConfiguration(&cfg); }
	);
	auto menuNoise = std::make_shared<MenuVolume>(
		"White Noise",
		10,
		false,
		100,
		audioGetNoiseStep,
		audioSetNoiseStep,
		[lcd, &cfg]() { cfg.noiseStep = audioGetNoiseStep(); saveConfiguration(&cfg); }
	);
	auto menuPopcorn = std::make_shared<MenuVolume>(
		"Popcorn Noise",
		10,
		false,
		100,
		audioGetPopcornStep,
		audioSetPopcornStep,
		[lcd, &cfg]() { cfg.popcornStep = audioGetPopcornStep(); saveConfiguration(&cfg); }
	);

	auto menuVocabSelect = std::make_shared<MenuVocabSelect>("Vocab Select", cfg);
	
	// System	
	auto menuSysConfig = std::make_shared<MenuListSelector>("System");
	auto menuMilepostDisplay = std::make_shared<MenuBoolSelector>(
		"Milepost Display",
		&cfg.milepostDisplay,
		false,
		"On", "ON",
		"Off", "OFF",
		[&cfg]() { saveConfiguration(&cfg); }
	);
	auto menuTemperatureDisplay = std::make_shared<MenuBoolSelector>(
		"Temp Display",
		&cfg.temperatureDisplay,
		false,
		"On", "ON",
		"Off", "OFF",
		[&cfg]() { saveConfiguration(&cfg); }
	);
	auto menuBacklightLevel = std::make_shared<MenuPercentageBar>(
		"Backlight Level", 
		[lcd]() { return lcd->getBrightness(); },
		[lcd](uint32_t val) { lcd->setBrightness(val); },
		true,
		255, 
		10,
		[lcd, &cfg]() { cfg.lcdBrightness = lcd->getBrightness(); saveConfiguration(&cfg); }
	);
	auto menuPttDelay = std::make_shared<MenuNumberDial>(
		"PTT Delay",
		audioGetPttDelay,
		audioSetPttDelay,
		false,
		PTT_DELAY_MIN,
		PTT_DELAY_MAX,
		PTT_DELAY_STEP_MS,
		"ms",
		[&cfg]() { cfg.pttDelay = audioGetPttDelay()/100; saveConfiguration(&cfg); }
	);
	auto menuMinAxleTime = std::make_shared<MenuNumberDial>(
		"Min Axle Time",
		[&cfg]() { return cfg.minAxleTime * 100; },
		[&cfg](int16_t val) { cfg.minAxleTime = val / 100; },
		false,
		MIN_AXLE_TIME_MIN,
		MIN_AXLE_TIME_MAX,
		MIN_AXLE_TIME_STEP_US,
		"us",
		[&cfg]() { 
			axleSetMinAxleTime(cfg.minAxleTime * 100); 
			saveConfiguration(&cfg); 
		}
	);
	auto menuConfigCode = std::make_shared<MenuConfigCode>("Config Code", cfg);

	// Diagnostic	
	auto menuDiagnostics = std::make_shared<MenuListSelector>("Diagnostics");
	auto menuVocabStatus = std::make_shared<MenuVocabStatus>("Vocab Status", cfg, trackMessages);
	auto menuVocabTest = std::make_shared<MenuVocabTest>("Vocab Test");
	auto menuMemoryStatus = std::make_shared<MenuMemoryStatus>("Memory Status");
	auto menuReset = std::make_shared<MenuReset>("Factory Reset", cfg);

	// ==========================================
	// Assign Button Callbacks
	// ==========================================
	menuMilepostEn->setSaveCallback([&cfg, &trackMessages]() { saveConfiguration(&cfg); updateMessages(trackMessages, cfg); });
	menuTemperatureEn->setSaveCallback([&cfg, &trackMessages]() { saveConfiguration(&cfg); updateMessages(trackMessages, cfg); });
	menuTrackNameEn->setSaveCallback([&cfg, &trackMessages]() { saveConfiguration(&cfg); updateMessages(trackMessages, cfg); });
	menuAxleEn->setSaveCallback([&cfg, &trackMessages]() { saveConfiguration(&cfg); updateMessages(trackMessages, cfg); });
	menuSpeedEn->setSaveCallback([&cfg, &trackMessages]() { saveConfiguration(&cfg); updateMessages(trackMessages, cfg); });
	menuDirectionEn->setSaveCallback([&cfg, &trackMessages]() { saveConfiguration(&cfg); updateMessages(trackMessages, cfg); });
	menuRailNameEn->setSaveCallback([&cfg, &trackMessages]() { saveConfiguration(&cfg); updateMessages(trackMessages, cfg); });
	menuEntranceMessage->setSaveCallback([&cfg, &trackMessages]() { saveConfiguration(&cfg); updateMessages(trackMessages, cfg); });
	menuAlertMessage->setSaveCallback([&cfg, &trackMessages]() { saveConfiguration(&cfg); updateMessages(trackMessages, cfg); });
	menuTalkDefectOnly->setSaveCallback([&cfg, &trackMessages]() { saveConfiguration(&cfg); updateMessages(trackMessages, cfg); });

	// Defect Enable Callbacks
	menuHotJournalEn->setSaveCallback([&cfg, &trackMessages]() { saveConfiguration(&cfg); updateAllMenuVisibility(cfg); updateMessages(trackMessages, cfg); });
	menuHotWheelEn->setSaveCallback([&cfg, &trackMessages]() { saveConfiguration(&cfg); updateAllMenuVisibility(cfg); updateMessages(trackMessages, cfg); });
	menuHighImpactWheelEn->setSaveCallback([&cfg, &trackMessages]() { saveConfiguration(&cfg); updateAllMenuVisibility(cfg); updateMessages(trackMessages, cfg); });
	menuDraggingEquipmentEn->setSaveCallback([&cfg, &trackMessages]() { saveConfiguration(&cfg); updateAllMenuVisibility(cfg); updateMessages(trackMessages, cfg); });
	menuHighLoadEn->setSaveCallback([&cfg, &trackMessages]() { saveConfiguration(&cfg); updateAllMenuVisibility(cfg); updateMessages(trackMessages, cfg); });
	menuWideLoadEn->setSaveCallback([&cfg, &trackMessages]() { saveConfiguration(&cfg); updateAllMenuVisibility(cfg); updateMessages(trackMessages, cfg); });
	menuRandomIntegrityEn->setSaveCallback([&cfg, &trackMessages]() { saveConfiguration(&cfg); updateAllMenuVisibility(cfg); updateMessages(trackMessages, cfg); });

	// Trigger 1 and Trigger 2 mutual-exclusion callbacks
	menuTriggerDir1->setSaveCallback([&cfg]() {
		if (cfg.triggerDirection1Only) {
			cfg.triggerDirection2Only = false;
		}
		saveConfiguration(&cfg);
	});

	menuTriggerDir2->setSaveCallback([&cfg]() {
		if (cfg.triggerDirection2Only) {
			cfg.triggerDirection1Only = false;
		}
		saveConfiguration(&cfg);
	});
		
	// ==========================================
	// Assemble Menus
	// ==========================================
	mainSel->addChild(menuMilepost);

	mainSel->addChild(menuTrackConfig);
	menuTrackConfig->addChild(menuTrackNameA);
	menuTrackConfig->addChild(menuTrackNameB);

	mainSel->addChild(menuAxleConfig);
	menuAxleConfig->addChild(menuMinAxles);
	menuAxleConfig->addChild(menuEntranceAxles);

	mainSel->addChild(menuSpeedConfig);
	menuSpeedConfig->addChild(menuSpeedUnits);
	menuSpeedConfig->addChild(menuSpeedScale);
	menuSpeedConfig->addChild(menuSpeedType);
	menuSpeedConfig->addChild(menuMinSpeed);

	mainSel->addChild(menuDirectionConfig);
	menuDirectionConfig->addChild(menuDirectionName1);
	menuDirectionConfig->addChild(menuDirectionName2);
	menuDirectionConfig->addChild(menuTriggerDir1);
	menuDirectionConfig->addChild(menuTriggerDir2);

	mainSel->addChild(menuRailName);

	mainSel->addChild(menuTemperatureConfig);
	menuTemperatureConfig->addChild(menuTemperatureUnits);
	menuTemperatureConfig->addChild(menuTemperatureType);
	menuTemperatureConfig->addChild(menuMinTemperature);
	menuTemperatureConfig->addChild(menuMaxTemperature);

	mainSel->addChild(menuDefects);
	menuDefects->addChild(menuHotJournal);
	menuHotJournal->addChild(menuHotJournalEn);
	menuHotJournal->addChild(menuHotJournalRate);

	menuDefects->addChild(menuHotWheel);
	menuHotWheel->addChild(menuHotWheelEn);
	menuHotWheel->addChild(menuHotWheelRate);

	menuDefects->addChild(menuHighImpactWheel);
	menuHighImpactWheel->addChild(menuHighImpactWheelEn);
	menuHighImpactWheel->addChild(menuHighImpactWheelRate);

	menuDefects->addChild(menuDraggingEquipment);
	menuDraggingEquipment->addChild(menuDraggingEquipmentEn);
	menuDraggingEquipment->addChild(menuDraggingEquipmentRate);

	menuDefects->addChild(menuHighLoad);
	menuHighLoad->addChild(menuHighLoadEn);
	menuHighLoad->addChild(menuHighLoadRate);

	menuDefects->addChild(menuWideLoad);
	menuWideLoad->addChild(menuWideLoadEn);
	menuWideLoad->addChild(menuWideLoadRate);

	mainSel->addChild(menuMessages);
	menuMessages->addChild(menuEntranceMessage);
	menuMessages->addChild(menuAlertMessage);
	menuMessages->addChild(menuExitMessage);
	menuExitMessage->addChild(menuTalkDefectOnly);
	menuExitMessage->addChild(menuMaxDefects);
	menuExitMessage->addChild(menuOrdinalType);
	menuMessages->addChild(menuRandomIntegrity);
	menuRandomIntegrity->addChild(menuRandomIntegrityEn);
	menuRandomIntegrity->addChild(menuRandomIntegrityRate);
	menuMessages->addChild(menuMilepostEn);
	menuMessages->addChild(menuTrackNameEn);
	menuMessages->addChild(menuAxleEn);
	menuMessages->addChild(menuSpeedEn);
	menuMessages->addChild(menuDirectionEn);
	menuMessages->addChild(menuRailNameEn);
	menuMessages->addChild(menuTemperatureEn);

//	mainSel->addChild(menuOperationMode);

	mainSel->addChild(menuTimingConfig);
	menuTimingConfig->addChild(menuDetectorTimeout);
	menuTimingConfig->addChild(menuSummaryDisplayTime);
	menuTimingConfig->addChild(menuMsgRepeatTimeout);

	mainSel->addChild(menuAudio);
	menuAudio->addChild(menuVolume);
	menuAudio->addChild(menuNoise);
	menuAudio->addChild(menuPopcorn);
	menuAudio->addChild(menuVocabSelect);

	mainSel->addChild(menuSysConfig);
	menuSysConfig->addChild(menuMilepostDisplay);
	menuSysConfig->addChild(menuTemperatureDisplay);
	menuSysConfig->addChild(menuBacklightLevel);
	menuSysConfig->addChild(menuPttDelay);
	menuSysConfig->addChild(menuMinAxleTime);
	menuSysConfig->addChild(menuConfigCode);

	mainSel->addChild(menuDiagnostics);
	menuDiagnostics->addChild(menuVocabStatus);
	menuDiagnostics->addChild(menuVocabTest);
	menuDiagnostics->addChild(menuMemoryStatus);
	menuDiagnostics->addChild(menuReset);

	updateAllMenuVisibility(cfg);
	
	return home;
}
