IowaScaledEngineering/ckt-defect/src/ckt-defect/messages.cpp

/*************************************************************************
Title:    Defect Message Functions
Authors:  Michael Petersen <railfan@drgw.net>
File:     messages.cpp
License:  GNU General Public License v3

LICENSE:
    Copyright (C) 2026 Michael Petersen & Nathan Holmes

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
*************************************************************************/

#include <Arduino.h>
#include <cmath>
#include <cstdlib>
#include <sstream>
#include <algorithm>
#include <cctype>

#include "common.h"
#include "messages.h"
#include "temperature.h"

void printMessages(MessageBundle* msgs)
{
	Serial.print("Entrance: ");
	Serial.println(msgs->entranceMsg.c_str());

	for(uint32_t j=0; j<msgs->defects.size(); j++)
	{
		Serial.print("Alert ");
		Serial.print(j);
		Serial.print(": ");
		Serial.println(msgs->defects[j].alertMsg.c_str());
		Serial.print("Detail ");
		Serial.print(j);
		Serial.print(": ");
		Serial.println(msgs->defects[j].detailMsg.c_str());
		Serial.print("Display ");
		Serial.print(j);
		Serial.print(": ");
		Serial.print(msgs->defects[j].displayMsg.c_str());
		Serial.print(" [1 in ");
		Serial.print(msgs->defects[j].axleRate);
		Serial.println(" axles]");
	}

	Serial.print("Exit Clean: ");
	Serial.println(msgs->exitCleanMsg.c_str());
	Serial.print("Exit Defect: ");
	Serial.println(msgs->exitDefectMsg.c_str());
	Serial.print("Integrity: ");
	Serial.print(msgs->integrityMsg.c_str());
	Serial.print(" [1 in ");
	Serial.print(msgs->integrityTrainRate);
	Serial.println(" trains]");
	Serial.print("Too Slow: ");
	Serial.println(msgs->tooSlowMsg.c_str());
	Serial.print("Blocked: ");
	Serial.println(msgs->detectorBlockedMsg.c_str());
}


void insertNumber(std::string& str, int32_t num, uint32_t integerDigits, uint32_t fractionalDigits, bool breakDigits)
{
	// If breakDigits is true, ignore any specified integer padding width constraints
	if (breakDigits)
	{
		integerDigits = 0;
	}

	std::string rawStr = intToString(num, integerDigits, fractionalDigits);
	
	if (breakDigits)
	{
		for (char c : rawStr)
		{
			str.push_back(c);
			str.push_back(' ');
		}
		if (!rawStr.empty())
		{
			str.pop_back(); // Remove trailing space
		}
	}
	else
	{
		str += rawStr;
	}
}

static void parseModifier(const std::string& token, size_t colonPos, int32_t& outN, int32_t& outM, bool hasFraction) 
{
	std::string mod = token.substr(colonPos + 1);
	if (hasFraction) 
	{
		size_t dotPos = mod.find('.');
		if (dotPos != std::string::npos) 
		{
			outN = std::atoi(mod.substr(0, dotPos).c_str());
			outM = std::atoi(mod.substr(dotPos + 1).c_str());
		} 
		else 
		{
			outN = std::atoi(mod.c_str());
		}
	} 
	else 
	{
		outN = std::atoi(mod.c_str());
	}
}

static void formatStringField(std::string& dest, const std::string& src, int32_t width) 
{
	size_t absWidth = std::abs(width);
	std::string clipped = src.substr(0, absWidth);
	
	if (clipped.length() >= absWidth) 
	{
		dest += clipped;
		return;
	}

	size_t padding = absWidth - clipped.length();
	if (width >= 0) 
	{
		dest.append(padding, ' ');
		dest += clipped;
	} 
	else 
	{
		dest += clipped;
		dest.append(padding, ' ');
	}
}


void transformMessage(const std::string& inputMessage, std::string& outputMessage, const DetectorConfiguration& cfg, const DataBundle& data, uint8_t trackNum, bool breakDigits)
{
	outputMessage.clear();
	outputMessage.reserve(inputMessage.length() * (breakDigits ? 2 : 1));

	size_t i = 0;
	while (i < inputMessage.length())
	{
		// 1. Handle escape characters
		if (inputMessage[i] == '\\')
		{
			// Check if it's a double backslash "\\" representing an escaped literal backslash
			if (i + 1 < inputMessage.length() && inputMessage[i + 1] == '\\')
			{
				outputMessage.push_back('\\');
				i += 2; // Advance past both backslashes
			}
			else
			{
				// Single backslash converts to a newline
				outputMessage.push_back('\n');
				i++;
			}
			continue;
		}

		// 2. Process # tokens
		if (inputMessage[i] == '#')
		{
			// Find the bounds of this token (alphanumeric characters following '#')
			size_t tokenStart = i;
			size_t tokenEnd = i + 1;
			while (tokenEnd < inputMessage.length() && std::isalnum(static_cast<unsigned char>(inputMessage[tokenEnd])))
			{
				tokenEnd++;
			}

			std::string baseToken = inputMessage.substr(tokenStart, tokenEnd - tokenStart);
			std::string fullToken = baseToken;

			// Check for optional modifiers (e.g., :3, :-4.1)
			size_t colonPos = std::string::npos;
			if (tokenEnd < inputMessage.length() && inputMessage[tokenEnd] == ':')
			{
				colonPos = tokenEnd - tokenStart;
				tokenEnd++; // Step past ':'

				// Allow an optional negative sign for padding direction
				if (tokenEnd < inputMessage.length() && inputMessage[tokenEnd] == '-')
				{
					tokenEnd++;
				}
				// Gather remaining format digits/dots
				while (tokenEnd < inputMessage.length() && 
				       (std::isdigit(static_cast<unsigned char>(inputMessage[tokenEnd])) || inputMessage[tokenEnd] == '.'))
				{
					tokenEnd++;
				}
				fullToken = inputMessage.substr(tokenStart, tokenEnd - tokenStart);
			}

			// Process matching base tokens
			if ("#milepost" == baseToken)
			{
				int32_t n = 1, m = 1;
				if (colonPos != std::string::npos) parseModifier(fullToken, colonPos, n, m, true);
				
				if (n < 0) 
				{
					std::string numStr = intToString(cfg.milepost, 0, m);
					std::string formatted;
					if (breakDigits)
					{
						for (char c : numStr) { formatted.push_back(c); formatted.push_back(' '); }
						if (!formatted.empty()) formatted.pop_back();
					}
					else
					{
						formatted = numStr;
					}
					
					outputMessage += formatted;

					if (!breakDigits)
					{
						size_t absN = std::abs(n);
						size_t rawIntLength = numStr.find('.');
						if (rawIntLength == std::string::npos) rawIntLength = numStr.length();

						if (rawIntLength < absN) 
						{
							outputMessage.append(absN - rawIntLength, ' ');
						}
					}
				} 
				else 
				{
					insertNumber(outputMessage, cfg.milepost, n, m, breakDigits);
				}
				i = tokenEnd;
				continue;
			}
			else if ("#track" == baseToken)
			{
				std::string trackName = cfg.trackName[trackNum];
				if (colonPos != std::string::npos) 
				{
					int32_t n = 0, m = 0;
					parseModifier(fullToken, colonPos, n, m, false);
					formatStringField(outputMessage, trackName, n);
				} 
				else 
				{
					outputMessage += trackName;
				}
				i = tokenEnd;
				continue;
			}
			else if ("#direction" == baseToken)
			{
				std::string directionName;
				switch(data.direction)
				{
					case 1:
						directionName = cfg.direction1Name;
						break;
					case 2:
						directionName = cfg.direction2Name;
						break;
					default:
						directionName = "";
						break;
				}
				if (colonPos != std::string::npos) 
				{
					int32_t n = 0, m = 0;
					parseModifier(fullToken, colonPos, n, m, false);
					formatStringField(outputMessage, directionName, n);
				} 
				else 
				{
					outputMessage += directionName;
				}
				i = tokenEnd;
				continue;
			}
			else if ("#rail" == baseToken)
			{
				std::string selectedRail;
				size_t slashPos = cfg.railName.find('/');

				if (slashPos != std::string::npos)
				{
					if (data.rail % 2)
					{
						selectedRail = cfg.railName.substr(0, slashPos);
					}
					else
					{
						selectedRail = cfg.railName.substr(slashPos + 1);
					}
				}
				else
				{
					selectedRail = cfg.railName;
				}

				if (colonPos != std::string::npos) 
				{
					int32_t n = 0, m = 0;
					parseModifier(fullToken, colonPos, n, m, false);
					formatStringField(outputMessage, selectedRail, n);
				} 
				else 
				{
					outputMessage += selectedRail;
				}
				i = tokenEnd;
				continue;
			}
			else if ("#axle" == baseToken || "#axles" == baseToken || "#speed" == baseToken || "#temp" == baseToken)
			{
				int32_t val = 0;
				if ("#axle" == baseToken)       val = data.axleCount;
				else if ("#axles" == baseToken) val = data.totalAxles;
				else if ("#speed" == baseToken) val = data.speed;
				else if ("#temp" == baseToken)  val = TemperatureManager::getInstance()->getTemperature() + 0.5;

				int32_t n = 1;
				if (colonPos != std::string::npos) 
				{
					int32_t m = 0;
					parseModifier(fullToken, colonPos, n, m, false);
				}

				if (n < 0) 
				{
					std::string numStr = intToString(val, 0, 0);
					std::string formatted;
					if (breakDigits)
					{
						for (char c : numStr) { formatted.push_back(c); formatted.push_back(' '); }
						if (!formatted.empty()) formatted.pop_back();
					}
					else
					{
						formatted = numStr;
					}

					outputMessage += formatted;
					if (!breakDigits)
					{
						size_t absN = std::abs(n);
						if (formatted.length() < absN) 
						{
							outputMessage.append(absN - formatted.length(), ' ');
						}
					}
				} 
				else 
				{
					insertNumber(outputMessage, val, n, 0, breakDigits);
				}
				i = tokenEnd;
				continue;
			}
			else if ("#defectlist" == baseToken)
			{
				for (auto const& defect : data.defects)
				{
					outputMessage += defect;
					outputMessage.push_back(' ');
				}
				if (!data.defects.empty())
				{
					outputMessage.pop_back();
				}
				i = tokenEnd;
				continue;
			}
		}

		// 3. Fallback: Print normal characters verbatim
		outputMessage.push_back(inputMessage[i]);
		i++;
	}
}

void updateMessages(MessageBundle& trackMessages, const DetectorConfiguration& cfg)
{
	// FIXME: Check if using SD card.  If not, then set default.
	if(true)
	{
		setDefaultMessages(trackMessages, cfg);
	}
}

void setDefaultMessages(MessageBundle& trackMessages, const DetectorConfiguration& cfg)
{
	std::string tmpEntranceMessage;
	std::string tmpMessage;
	std::string tmpDispMessage;
	std::string tmpTrack = "";

	// Entrance Message
	tmpEntranceMessage = "Equipment Defect Detector";
//	tmpEntranceMessage = "1 #tone 2 #tone= 3 #tone=5 4 #tone=20 5 #tone=10,0 #tone=10,1 #tone=10,2 #tone=10,3";   // Tone Test
//	tmpEntranceMessage = "#tone=1 #pause #tone=1 #pause= #tone=1 #pause=10 #tone=1 #pause=20 #tone";   // Silence Test
	if(cfg.milepostEnable)
	{
		tmpEntranceMessage += " milepost #milepost";
	}

	if(cfg.trackNameEnable)
	{
		tmpEntranceMessage += " #track";
		tmpTrack = "#track";
	}

	if(cfg.directionEnable)
	{
		tmpEntranceMessage += " #direction";
	}

	if(cfg.entranceMessageEnable)
	{
		trackMessages.entranceMsg = tmpEntranceMessage;
	}
	else
	{
		trackMessages.entranceMsg = "";
	}

	// Defect Messages
	if(cfg.axleEnable)
	{
		tmpMessage = "Axle #axle";
	}
	if(cfg.railNameEnable)
	{
		tmpMessage += " #rail Rail";
	}
	trackMessages.defects.clear();
	
	std::string alertMsg, detailMsg, displayMsg;

	if(cfg.defectHotJournalEnable)
	{
		if(cfg.alertMessageEnable)
		{
			alertMsg = "#tone " + tmpTrack + " hot journal " + tmpMessage;
			displayMsg = tmpTrack + "\\Hot Journal\\" + tmpMessage;
		}
		else
		{
			alertMsg = "";
			displayMsg = "";
		}
		detailMsg = ordinalStrings[cfg.ordinalTypeId] + " hot journal " + tmpMessage;
		trackMessages.defects.emplace_back(alertMsg, displayMsg, detailMsg, cfg.defectHotJournalAxleRate);
	}

	if(cfg.defectHotWheelEnable)
	{
		if(cfg.alertMessageEnable)
		{
			alertMsg = "#tone " + tmpTrack + " hot wheel " + tmpMessage;
			displayMsg = tmpTrack + "\\Hot Wheel\\" + tmpMessage;
		}
		else
		{
			alertMsg = "";
			displayMsg = "";
		}
		detailMsg = ordinalStrings[cfg.ordinalTypeId] + " hot wheel " + tmpMessage;
		trackMessages.defects.emplace_back(alertMsg, displayMsg, detailMsg, cfg.defectHotWheelAxleRate);
	}

	if(cfg.defectHighImpactWheelEnable)
	{
		if(cfg.alertMessageEnable)
		{
			alertMsg = "#tone " + tmpTrack + " high impact wheel detected " + tmpMessage;
			displayMsg = tmpTrack + "\\High Impact Wheel\\" + tmpMessage;
		}
		else
		{
			alertMsg = "";
			displayMsg = "";
		}
		detailMsg = ordinalStrings[cfg.ordinalTypeId] + " high impact wheel detected " + tmpMessage;
		trackMessages.defects.emplace_back(alertMsg, displayMsg, detailMsg, cfg.defectHighImpactWheelAxleRate);
	}

	if(cfg.defectDraggingEquipmentEnable)
	{
		if(cfg.alertMessageEnable)
		{
			alertMsg = std::string("#tone " + tmpTrack + " dragging equipment ") + (cfg.axleEnable ? "near " : "") + tmpMessage;
			displayMsg = tmpTrack + "\\Dragging Equipment\\" + tmpMessage;
		}
		else
		{
			alertMsg = "";
			displayMsg = "";
		}
		detailMsg = ordinalStrings[cfg.ordinalTypeId] + std::string(" dragging equipment ") + (cfg.axleEnable ? "near " : "") + tmpMessage;
		trackMessages.defects.emplace_back(alertMsg, displayMsg, detailMsg, cfg.defectDraggingEquipmentAxleRate);
	}

	if(cfg.defectHighLoadEnable)
	{
		if(cfg.alertMessageEnable)
		{
			alertMsg = std::string("#tone " + tmpTrack + " high load ") + (cfg.axleEnable ? "near " : "") + tmpMessage;
			displayMsg = tmpTrack + "\\High Load\\" + tmpMessage;
		}
		else
		{
			alertMsg = "";
			displayMsg = "";
		}
		detailMsg = ordinalStrings[cfg.ordinalTypeId] + " high load " + tmpMessage;
		trackMessages.defects.emplace_back(alertMsg, displayMsg, detailMsg, cfg.defectHighLoadAxleRate);
	}

	if(cfg.defectWideLoadEnable)
	{
		if(cfg.alertMessageEnable)
		{
			alertMsg = std::string("#tone " + tmpTrack + " wide load ") + (cfg.axleEnable ? "near " : "") + tmpMessage;
			displayMsg = tmpTrack + "\\Wide Load\\" + tmpMessage;
		}
		else
		{
			alertMsg = "";
			displayMsg = "";
		}
		detailMsg = ordinalStrings[cfg.ordinalTypeId] + " wide load " + tmpMessage;
		trackMessages.defects.emplace_back(alertMsg, displayMsg, detailMsg, cfg.defectWideLoadAxleRate);
	}

	// Create Footer
	tmpMessage.clear();
	if(cfg.axleEnable)
	{
		tmpMessage += " total axles #axles";
	}

	if(cfg.speedEnable)
	{
		tmpMessage += " train speed #speed";
	}

	if(cfg.temperatureEnable)
	{
		tmpMessage += " temperature #temp degrees";
	}

	// Create display summary line
	tmpDispMessage = "";
	if(cfg.axleEnable)
	{
		tmpDispMessage += "AXLES:#axles:3";
	}
	if(cfg.speedEnable)
	{
		if(cfg.axleEnable)
		{
			tmpDispMessage += "  ";
		}
		tmpDispMessage += "SPEED:#speed:3";
	}

	// Clean Exit Message
	if(cfg.talkOnDefectOnly)
	{
		trackMessages.exitCleanMsg = "";
		trackMessages.exitCleanDisplayMsg = "";
	}
	else
	{
		trackMessages.exitCleanMsg = tmpEntranceMessage + " no defects repeat no defects" + tmpMessage + " detector out";
		trackMessages.exitCleanDisplayMsg = tmpTrack + "\\NO DEFECTS\\" + tmpDispMessage;
	}

	// Defect Exit Message
	trackMessages.exitDefectMsg = tmpEntranceMessage + " you have a defect #defectlist" + tmpMessage + " detector out";
	trackMessages.exitDefectDisplayMsg = tmpTrack + "\\DEFECT DETECTED!\\" + tmpDispMessage;

	// Detector Integrity Message
	trackMessages.integrityMsg = tmpEntranceMessage + " integrity failure";
	trackMessages.integrityDisplayMsg = tmpTrack + "\\INTEGRITY FAILURE\\";
	trackMessages.integrityTrainRate = cfg.defectIntegrityTrainRate;

	// Min Axle Message
	trackMessages.minAxleMsg = tmpEntranceMessage + " integrity failure" + tmpMessage;
	trackMessages.minAxleDisplayMsg = tmpTrack + "\\INTEGRITY FAILURE\\" + tmpDispMessage;

	// Too Slow Message
	trackMessages.tooSlowMsg = tmpEntranceMessage + " train 2 slow";
	trackMessages.tooSlowDisplayMsg = tmpTrack + "\\TRAIN TOO SLOW\\" + tmpDispMessage;

	// Detector Blocked Message
	trackMessages.detectorBlockedMsg = tmpEntranceMessage + " detector blocked";
	trackMessages.detectorBlockedDisplayMsg = tmpTrack + "\\DETECTOR BLOCKED\\" + tmpDispMessage;

	// Excessive Alarms Message
	trackMessages.excessAlarmsMsg = "excessive alarms";
}

// Helper function to insert a unique string into a sorted vector safely on constrained memory
static void insertUniqueSorted(std::vector<std::string>& vec, const std::string& word)
{
	auto it = std::lower_bound(vec.begin(), vec.end(), word);
	if (it == vec.end() || *it != word)
	{
		vec.insert(it, word);
	}
}

// Helper function to process words from an individual string field
static void extractWordsFromString(const std::string& inputStr, std::vector<std::string>& uniqueWords)
{
	// Convert '/' to spaces in a temporary copy of the input string
	std::string modifiedStr = inputStr;
	for (char& c : modifiedStr)
	{
		if (c == '/')
		{
			c = ' ';
		}
	}

	std::istringstream stream(modifiedStr);
	std::string token;

	while (stream >> token)
	{
		if (!token.empty() && token[0] == '#')
		{
			continue;
		}

		for (char& c : token)
		{
			c = static_cast<char>(std::tolower(static_cast<unsigned char>(c)));
		}

		insertUniqueSorted(uniqueWords, token);
	}
}

std::vector<std::string> getUniqueWords(const MessageBundle& msgs)
{
	std::vector<std::string> uniqueWords;
	uniqueWords.reserve(32);

	// Pre-populate with single digits "0" through "9"
	for (char c = '0'; c <= '9'; ++c)
	{
		insertUniqueSorted(uniqueWords, std::string(1, c));
	}

	// Add other words needed by tokens
	insertUniqueSorted(uniqueWords, "point");
	insertUniqueSorted(uniqueWords, "minus");

	// Ordinals
	for (uint32_t i = 1; i < 10; ++i)
	{
		insertUniqueSorted(uniqueWords, getOrdinalWord(i));
	}
	for (const auto& str : ordinalStrings)
	{
		extractWordsFromString(str, uniqueWords);
	}

	// Track, Direction, Rail strings
	for (const auto& str : trackNames)
	{
		extractWordsFromString(str, uniqueWords);
	}
	for (const auto& str : directionNames)
	{
		extractWordsFromString(str, uniqueWords);
	}
	for (const auto& str : railNames)
	{
		extractWordsFromString(str, uniqueWords);
	}

	// Messages (skip display since those words are never spoken)
	extractWordsFromString(msgs.entranceMsg, uniqueWords);
	extractWordsFromString(msgs.exitCleanMsg, uniqueWords);
	//extractWordsFromString(msgs.exitCleanDisplayMsg, uniqueWords);
	extractWordsFromString(msgs.exitDefectMsg, uniqueWords);
	//extractWordsFromString(msgs.exitDefectDisplayMsg, uniqueWords);
	extractWordsFromString(msgs.integrityMsg, uniqueWords);
	//extractWordsFromString(msgs.integrityDisplayMsg, uniqueWords);
	extractWordsFromString(msgs.tooSlowMsg, uniqueWords);
	//extractWordsFromString(msgs.tooSlowDisplayMsg, uniqueWords);
	extractWordsFromString(msgs.detectorBlockedMsg, uniqueWords);
	//extractWordsFromString(msgs.detectorBlockedDisplayMsg, uniqueWords);
	extractWordsFromString(msgs.excessAlarmsMsg, uniqueWords);

	for (const auto& defect : msgs.defects)
	{
		extractWordsFromString(defect.alertMsg, uniqueWords);
		extractWordsFromString(defect.detailMsg, uniqueWords);
		//extractWordsFromString(defect.displayMsg, uniqueWords);
	}

	uniqueWords.shrink_to_fit();
	return uniqueWords;
}
