IowaScaledEngineering/ckt-defect/src/ckt-defect/vocab.cpp

/*************************************************************************
Title:    Defect Detector Vocabulary
Authors:  Michael Petersen <railfan@drgw.net>
File:     vocab.cpp
License:  GNU General Public License v3

LICENSE:
    Copyright (C) 2026 Michael Petersen & Nathan Holmes

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
*************************************************************************/


/***************  WARNING  ***************/
/* This file is auto generated           */
/* Edit vocab/vocab-template.cpp instead */
/***************  WARNING  ***************/


#include <algorithm>
#include <cstring>
#include <Arduino.h>
#include "ff.h"
#include "esp_task_wdt.h"
#include "vocab.h"
#include "display-lcd.h"

std::vector<Sound *> vocab;

void vocabDelete(void)
{
	for(uint32_t i=0; i<vocab.size(); i++)
	{
		delete vocab[i];
	}
	vocab.clear();
}

size_t vocabGetSize(void)
{
	return vocab.size();
}

std::string vocabGetName(uint32_t index)
{
	if(index < vocabGetSize())
	{
		return vocab[index]->getName();
	}
	else
	{
		return "";
	}
}

Sound* vocabGetWord(const std::string& word)
{
	auto it = std::find_if(vocab.begin(), vocab.end(),
		[&word](const Sound* obj)
		{
			return obj->getName() == word;
		}
	);

	if (it != vocab.end())
	{
		return *it;
	}
	else
	{
		return NULL;
	}
}

Sound* vocabGetWord(const uint32_t index)
{
	if(index < vocabGetSize())
	{
		return vocab[index];
	}
	else
	{
		return NULL;
	}
}

void vocabFindAvailable(std::vector<std::string>& vocabsAvailable)
{
	vocabsAvailable.clear();

	FF_DIR *dir = (FF_DIR *)malloc(sizeof(FF_DIR));
	FILINFO *fno = (FILINFO *)malloc(sizeof(FILINFO));

	if (!dir || !fno)
	{
		if (dir) free(dir);
		if (fno) free(fno);
		return;
	}

	FRESULT res = f_opendir(dir, "0:vocab");
	if (res != FR_OK)
	{
		res = f_opendir(dir, "vocab");
	}

	if (res != FR_OK)
	{
		free(dir);
		free(fno);
		return;
	}

	for (;;)
	{
		esp_task_wdt_reset();

		if (f_readdir(dir, fno) != FR_OK || fno->fname[0] == 0)
		{
			break;
		}

		if (fno->fattrib & AM_DIR)
		{
			if (strcmp(fno->fname, ".") != 0 && strcmp(fno->fname, "..") != 0)
			{
				vocabsAvailable.push_back(fno->fname);
			}
		}
	}

	f_closedir(dir);
	free(dir);
	free(fno);
}

// Helper function to perform pattern matching for WAV chunk headers using raw FatFs
static bool fatFsFindChunk(FIL *wavFile, const char* chunkId)
{
	char buffer[4];
	UINT bytesRead;
	
	// Scan through file looking for 4-byte chunk identifier
	while (f_read(wavFile, buffer, 4, &bytesRead) == FR_OK && bytesRead == 4)
	{
		esp_task_wdt_reset();

		if (memcmp(buffer, chunkId, 4) == 0)
		{
			return true;
		}
		// Step back 3 bytes to handle non-aligned pattern matches
		f_lseek(wavFile, f_tell(wavFile) - 3);
	}
	return false;
}

bool validateWavFile(FIL *wavFile, const char* fileName, struct WavData *wavData)
{
	size_t fileNameLength = strlen(fileName);
	if(fileNameLength < 5)
		return false;

	const char *extension = &fileName[fileNameLength - 4];
	if(strcasecmp(extension, ".wav"))
	{
		return false;
	}

	UINT bytesRead;
	uint16_t channels;
	uint16_t bitsPerSample;
	uint32_t sampleRate;
	uint32_t wavDataSize;

	f_lseek(wavFile, 0);

	if(!fatFsFindChunk(wavFile, "fmt "))
	{
		Serial.print("! No fmt section: ");
		Serial.println(fileName);
		return false;
	}

	// Seek to number of channels offset (skip 4 bytes chunk size + 2 bytes format tag)
	f_lseek(wavFile, f_tell(wavFile) + 6);
	f_read(wavFile, &channels, 2, &bytesRead);

	if(channels > 1)
	{
		Serial.print("! Not mono: ");
		Serial.println(fileName);
		return false;
	}

	f_read(wavFile, &sampleRate, 4, &bytesRead);
	wavData->sampleRate = sampleRate;

	if((8000 != sampleRate) && (16000 != sampleRate) && (32000 != sampleRate) && (44100 != sampleRate))
	{
		Serial.print("! Incorrect sample rate: ");
		Serial.println(fileName);
		return false;
	}

	// Seek to bits per sample (skip 6 bytes: ByteRate [4], BlockAlign [2])
	f_lseek(wavFile, f_tell(wavFile) + 6);
	f_read(wavFile, &bitsPerSample, 2, &bytesRead);

	if(16 != bitsPerSample)
	{
		Serial.print("! Not 16-bit: ");
		Serial.println(fileName);
		return false;
	}

	if(!fatFsFindChunk(wavFile, "data"))
	{
		Serial.print("! No data section: ");
		Serial.println(fileName);
		return false;
	}

	f_read(wavFile, &wavDataSize, 4, &bytesRead);
	wavData->wavDataSize = wavDataSize;
	wavData->dataStartPosition = f_tell(wavFile);

	return true;
}

bool loadExternalVocab(DisplayLcd *lcd, const std::string& vocabSelected, const std::vector<std::string>& words)
{
	lcd->clear();

	uint32_t totalStartTime = millis();
	std::string vocabDirName = "0:vocab/" + vocabSelected;
	Serial.print("Attempting to load external vocabulary from: ");
	Serial.println(vocabDirName.c_str());

	FF_DIR *dir = (FF_DIR *)malloc(sizeof(FF_DIR));
	FIL *wavFile = (FIL *)malloc(sizeof(FIL));

	if (!dir || !wavFile)
	{
		Serial.println("! Failed to allocate FatFs buffer memory");
		if (dir) free(dir);
		if (wavFile) free(wavFile);
		return false;
	}

	FRESULT res = f_opendir(dir, vocabDirName.c_str());
	if (res != FR_OK)
	{
		vocabDirName = "vocab/" + vocabSelected;
		res = f_opendir(dir, vocabDirName.c_str());
	}

	if (res != FR_OK)
	{
		Serial.print("! Failed to open vocabulary directory: ");
		Serial.print(vocabDirName.c_str());
		Serial.printf(" (FatFs error code: %d)\n", res);
		free(dir);
		free(wavFile);
		return false;
	}
	f_closedir(dir);
	free(dir);

	uint32_t loadedCount = 0;
	uint32_t openTime = 0;
	uint32_t validateTime = 0;
	uint32_t pushTime = 0;

	int totalWords = (int)words.size();
	int width = std::to_string(totalWords).length();
	
	for (const auto& word : words)
	{
		esp_task_wdt_reset();

		std::string fileName = word + ".wav";
		std::string fullPath = vocabDirName + "/" + fileName;

		uint32_t t1 = micros();
		FRESULT fopen_res = f_open(wavFile, fullPath.c_str(), FA_READ);
		openTime += (micros() - t1);

		bool justLoaded = false;
		
		if (fopen_res == FR_OK)
		{
			WavData wavData;
			uint32_t t2 = micros();
			bool isValid = validateWavFile(wavFile, fileName.c_str(), &wavData);
			validateTime += (micros() - t2);

			if (isValid)
			{
				if (wavData.sampleRate == 16000)
				{
					DWORD startCluster = wavFile->obj.sclust;

					Serial.print("+ Adding external WAV: ");
					Serial.println(fullPath.c_str());

					uint32_t t3 = micros();
					vocab.push_back(new SdSound(fullPath, wavData.wavDataSize, wavData.dataStartPosition, wavData.sampleRate, startCluster));
					pushTime += (micros() - t3);
					loadedCount++;
					justLoaded = true;
				}
			}
			f_close(wavFile);
		}

		char szBuf[32];
		snprintf(szBuf, sizeof(szBuf), "Loading WAV %*u/%u", width, (unsigned int)(loadedCount), (unsigned int)totalWords);
		lcd->gotoxy(0, 0);
		lcd->print(szBuf);
		lcd->gotoxy(0, 1);
		if (justLoaded)
		{
			lcd->print(centerString(word, 20));
		}
	}

	free(wavFile);

	lcd->gotoxy(0, 1);
	lcd->print(std::string(20, ' '));
	lcd->gotoxy(0, 2);
	if (loadedCount > 0)
	{
		lcd->print("Using " + vocabSelected);
	}
	else
	{
		lcd->print("Using Internal Vocab");
	}

	uint32_t totalDuration = millis() - totalStartTime;
	Serial.println("--- Profiling Results for loadExternalVocab ---");
	Serial.printf("Total Time: %lu ms\n", totalDuration);
	Serial.printf("File Open Time: %lu us (%lu ms)\n", openTime, openTime / 1000);
	Serial.printf("Validation Time: %lu us (%lu ms)\n", validateTime, validateTime / 1000);
	Serial.printf("Vector Push Time: %lu us (%lu ms)\n", pushTime, pushTime / 1000);
	Serial.print("External vocabulary load finished. Total valid words loaded: ");
	Serial.println(loadedCount);

	return (loadedCount > 0);
}

#include "vocab/include/0.h"
#include "vocab/include/1.h"
#include "vocab/include/2.h"
#include "vocab/include/3.h"
#include "vocab/include/4.h"
#include "vocab/include/5.h"
#include "vocab/include/6.h"
#include "vocab/include/7.h"
#include "vocab/include/8.h"
#include "vocab/include/9.h"
#include "vocab/include/a.h"
#include "vocab/include/alarm.h"
#include "vocab/include/alarms.h"
#include "vocab/include/axle.h"
#include "vocab/include/axles.h"
#include "vocab/include/blocked.h"
#include "vocab/include/defect.h"
#include "vocab/include/defects.h"
#include "vocab/include/degrees.h"
#include "vocab/include/detected.h"
#include "vocab/include/detector.h"
#include "vocab/include/dragging.h"
#include "vocab/include/east.h"
#include "vocab/include/eastbound.h"
#include "vocab/include/eighth.h"
#include "vocab/include/equipment.h"
#include "vocab/include/excessive.h"
#include "vocab/include/failure.h"
#include "vocab/include/fifth.h"
#include "vocab/include/first.h"
#include "vocab/include/fourth.h"
#include "vocab/include/have.h"
#include "vocab/include/high.h"
#include "vocab/include/hot.h"
#include "vocab/include/impact.h"
#include "vocab/include/integrity.h"
#include "vocab/include/journal.h"
#include "vocab/include/left.h"
#include "vocab/include/main.h"
#include "vocab/include/milepost.h"
#include "vocab/include/minus.h"
#include "vocab/include/near.h"
#include "vocab/include/ninth.h"
#include "vocab/include/no.h"
#include "vocab/include/north.h"
#include "vocab/include/northbound.h"
#include "vocab/include/out.h"
#include "vocab/include/point.h"
#include "vocab/include/rail.h"
#include "vocab/include/repeat.h"
#include "vocab/include/right.h"
#include "vocab/include/second.h"
#include "vocab/include/seventh.h"
#include "vocab/include/sixth.h"
#include "vocab/include/slow.h"
#include "vocab/include/south.h"
#include "vocab/include/southbound.h"
#include "vocab/include/speed.h"
#include "vocab/include/temperature.h"
#include "vocab/include/third.h"
#include "vocab/include/total.h"
#include "vocab/include/track.h"
#include "vocab/include/train.h"
#include "vocab/include/west.h"
#include "vocab/include/westbound.h"
#include "vocab/include/wheel.h"
#include "vocab/include/you.h"

void loadInternalVocab(void)
{
	vocab.push_back(new MemSound("0", vocab_0, vocab_0_len, 16000));
	vocab.push_back(new MemSound("1", vocab_1, vocab_1_len, 16000));
	vocab.push_back(new MemSound("2", vocab_2, vocab_2_len, 16000));
	vocab.push_back(new MemSound("3", vocab_3, vocab_3_len, 16000));
	vocab.push_back(new MemSound("4", vocab_4, vocab_4_len, 16000));
	vocab.push_back(new MemSound("5", vocab_5, vocab_5_len, 16000));
	vocab.push_back(new MemSound("6", vocab_6, vocab_6_len, 16000));
	vocab.push_back(new MemSound("7", vocab_7, vocab_7_len, 16000));
	vocab.push_back(new MemSound("8", vocab_8, vocab_8_len, 16000));
	vocab.push_back(new MemSound("9", vocab_9, vocab_9_len, 16000));
	vocab.push_back(new MemSound("a", vocab_a, vocab_a_len, 16000));
	vocab.push_back(new MemSound("alarm", vocab_alarm, vocab_alarm_len, 16000));
	vocab.push_back(new MemSound("alarms", vocab_alarms, vocab_alarms_len, 16000));
	vocab.push_back(new MemSound("axle", vocab_axle, vocab_axle_len, 16000));
	vocab.push_back(new MemSound("axles", vocab_axles, vocab_axles_len, 16000));
	vocab.push_back(new MemSound("blocked", vocab_blocked, vocab_blocked_len, 16000));
	vocab.push_back(new MemSound("defect", vocab_defect, vocab_defect_len, 16000));
	vocab.push_back(new MemSound("defects", vocab_defects, vocab_defects_len, 16000));
	vocab.push_back(new MemSound("degrees", vocab_degrees, vocab_degrees_len, 16000));
	vocab.push_back(new MemSound("detected", vocab_detected, vocab_detected_len, 16000));
	vocab.push_back(new MemSound("detector", vocab_detector, vocab_detector_len, 16000));
	vocab.push_back(new MemSound("dragging", vocab_dragging, vocab_dragging_len, 16000));
	vocab.push_back(new MemSound("east", vocab_east, vocab_east_len, 16000));
	vocab.push_back(new MemSound("eastbound", vocab_eastbound, vocab_eastbound_len, 16000));
	vocab.push_back(new MemSound("eighth", vocab_eighth, vocab_eighth_len, 16000));
	vocab.push_back(new MemSound("equipment", vocab_equipment, vocab_equipment_len, 16000));
	vocab.push_back(new MemSound("excessive", vocab_excessive, vocab_excessive_len, 16000));
	vocab.push_back(new MemSound("failure", vocab_failure, vocab_failure_len, 16000));
	vocab.push_back(new MemSound("fifth", vocab_fifth, vocab_fifth_len, 16000));
	vocab.push_back(new MemSound("first", vocab_first, vocab_first_len, 16000));
	vocab.push_back(new MemSound("fourth", vocab_fourth, vocab_fourth_len, 16000));
	vocab.push_back(new MemSound("have", vocab_have, vocab_have_len, 16000));
	vocab.push_back(new MemSound("high", vocab_high, vocab_high_len, 16000));
	vocab.push_back(new MemSound("hot", vocab_hot, vocab_hot_len, 16000));
	vocab.push_back(new MemSound("impact", vocab_impact, vocab_impact_len, 16000));
	vocab.push_back(new MemSound("integrity", vocab_integrity, vocab_integrity_len, 16000));
	vocab.push_back(new MemSound("journal", vocab_journal, vocab_journal_len, 16000));
	vocab.push_back(new MemSound("left", vocab_left, vocab_left_len, 16000));
	vocab.push_back(new MemSound("main", vocab_main, vocab_main_len, 16000));
	vocab.push_back(new MemSound("milepost", vocab_milepost, vocab_milepost_len, 16000));
	vocab.push_back(new MemSound("minus", vocab_minus, vocab_minus_len, 16000));
	vocab.push_back(new MemSound("near", vocab_near, vocab_near_len, 16000));
	vocab.push_back(new MemSound("ninth", vocab_ninth, vocab_ninth_len, 16000));
	vocab.push_back(new MemSound("no", vocab_no, vocab_no_len, 16000));
	vocab.push_back(new MemSound("north", vocab_north, vocab_north_len, 16000));
	vocab.push_back(new MemSound("northbound", vocab_northbound, vocab_northbound_len, 16000));
	vocab.push_back(new MemSound("out", vocab_out, vocab_out_len, 16000));
	vocab.push_back(new MemSound("point", vocab_point, vocab_point_len, 16000));
	vocab.push_back(new MemSound("rail", vocab_rail, vocab_rail_len, 16000));
	vocab.push_back(new MemSound("repeat", vocab_repeat, vocab_repeat_len, 16000));
	vocab.push_back(new MemSound("right", vocab_right, vocab_right_len, 16000));
	vocab.push_back(new MemSound("second", vocab_second, vocab_second_len, 16000));
	vocab.push_back(new MemSound("seventh", vocab_seventh, vocab_seventh_len, 16000));
	vocab.push_back(new MemSound("sixth", vocab_sixth, vocab_sixth_len, 16000));
	vocab.push_back(new MemSound("slow", vocab_slow, vocab_slow_len, 16000));
	vocab.push_back(new MemSound("south", vocab_south, vocab_south_len, 16000));
	vocab.push_back(new MemSound("southbound", vocab_southbound, vocab_southbound_len, 16000));
	vocab.push_back(new MemSound("speed", vocab_speed, vocab_speed_len, 16000));
	vocab.push_back(new MemSound("temperature", vocab_temperature, vocab_temperature_len, 16000));
	vocab.push_back(new MemSound("third", vocab_third, vocab_third_len, 16000));
	vocab.push_back(new MemSound("total", vocab_total, vocab_total_len, 16000));
	vocab.push_back(new MemSound("track", vocab_track, vocab_track_len, 16000));
	vocab.push_back(new MemSound("train", vocab_train, vocab_train_len, 16000));
	vocab.push_back(new MemSound("west", vocab_west, vocab_west_len, 16000));
	vocab.push_back(new MemSound("westbound", vocab_westbound, vocab_westbound_len, 16000));
	vocab.push_back(new MemSound("wheel", vocab_wheel, vocab_wheel_len, 16000));
	vocab.push_back(new MemSound("you", vocab_you, vocab_you_len, 16000));
}
