IowaScaledEngineering/ckt-defect/src/ckt-defect/vocab/include/0.h

const unsigned char vocab_0[] = {
  0x00, 0x00, 0x01, 0x00, 0xfe, 0xff, 0xfb, 0xff, 0xf5, 0xff, 0xf5, 0xff,
  0xf4, 0xff, 0xf3, 0xff, 0xfc, 0xff, 0x01, 0x00, 0x0a, 0x00, 0x07, 0x00,
  0x03, 0x00, 0x01, 0x00, 0xfe, 0xff, 0x01, 0x00, 0x0d, 0x00, 0x11, 0x00,
  0x13, 0x00, 0x1d, 0x00, 0x0f, 0x00, 0x1a, 0x00, 0x0d, 0x00, 0x04, 0x00,
  0x07, 0x00, 0xfd, 0xff, 0xfe, 0xff, 0x02, 0x00, 0x00, 0x00, 0x07, 0x00,
  0x04, 0x00, 0xfd, 0xff, 0xf6, 0xff, 0xf4, 0xff, 0xe7, 0xff, 0xf7, 0xff,
  0xef, 0xff, 0xf5, 0xff, 0xf5, 0xff, 0xfd, 0xff, 0xf5, 0xff, 0xf5, 0xff,
  0xf1, 0xff, 0xfa, 0xff, 0x00, 0x00, 0x02, 0x00, 0xf3, 0xff, 0x0a, 0x00,
  0x00, 0x00, 0x02, 0x00, 0xfc, 0xff, 0x09, 0x00, 0xf0, 0xff, 0xee, 0xff,
  0xe8, 0xff, 0xf5, 0xff, 0xfb, 0xff, 0x09, 0x00, 0x03, 0x00, 0x08, 0x00,
  0x00, 0x00, 0x14, 0x00, 0x06, 0x00, 0x1c, 0x00, 0x04, 0x00, 0x0d, 0x00,
  0x0d, 0x00, 0x17, 0x00, 0x00, 0x00, 0x08, 0x00, 0x05, 0x00, 0x1d, 0x00,
  0x07, 0x00, 0x0f, 0x00, 0xfe, 0xff, 0x01, 0x00, 0xfa, 0xff, 0x0e, 0x00,
  0xf3, 0xff, 0x03, 0x00, 0xea, 0xff, 0xf7, 0xff, 0x00, 0x00, 0x04, 0x00,
  0xe1, 0xff, 0x00, 0x00, 0xf6, 0xff, 0xfe, 0xff, 0xf5, 0xff, 0x0c, 0x00,
  0xfb, 0xff, 0x0c, 0x00, 0xea, 0xff, 0xf9, 0xff, 0xe9, 0xff, 0x03, 0x00,
  0xf1, 0xff, 0x0a, 0x00, 0xf2, 0xff, 0x0b, 0x00, 0xf2, 0xff, 0x0a, 0x00,
  0x00, 0x00, 0xf8, 0xff, 0xfb, 0xff, 0x15, 0x00, 0xfd, 0xff, 0x04, 0x00,
  0xec, 0xff, 0x10, 0x00, 0x18, 0x00, 0x29, 0x00, 0xfd, 0xff, 0x0f, 0x00,
  0xf9, 0xff, 0x0e, 0x00, 0xe8, 0xff, 0xeb, 0xff, 0xda, 0xff, 0xfa, 0xff,
  0x03, 0x00, 0x26, 0x00, 0x02, 0x00, 0x11, 0x00, 0x01, 0x00, 0x09, 0x00,
  0xdb, 0xff, 0xe4, 0xff, 0xf3, 0xff, 0x0c, 0x00, 0xf5, 0xff, 0x07, 0x00,
  0xf3, 0xff, 0xff, 0xff, 0xe0, 0xff, 0xee, 0xff, 0xc8, 0xff, 0xf8, 0xff,
  0x12, 0x00, 0x4b, 0x00, 0x1f, 0x00, 0x1e, 0x00, 0xfa, 0xff, 0x07, 0x00,
  0xcc, 0xff, 0xee, 0xff, 0xf4, 0xff, 0x2a, 0x00, 0x28, 0x00, 0x2c, 0x00,
  0xff, 0xff, 0x03, 0x00, 0xf2, 0xff, 0x13, 0x00, 0xd9, 0xff, 0xf9, 0xff,
  0x00, 0x00, 0x4c, 0x00, 0x3a, 0x00, 0x3d, 0x00, 0xf3, 0xff, 0xf7, 0xff,
  0xd2, 0xff, 0xeb, 0xff, 0xdf, 0xff, 0x12, 0x00, 0x0f, 0x00, 0x1c, 0x00,
  0xda, 0xff, 0xe6, 0xff, 0xd3, 0xff, 0xf4, 0xff, 0xd0, 0xff, 0xf3, 0xff,
  0xe7, 0xff, 0x18, 0x00, 0x0c, 0x00, 0x1d, 0x00, 0xea, 0xff, 0xeb, 0xff,
  0xc4, 0xff, 0xfb, 0xff, 0xdc, 0xff, 0x1c, 0x00, 0x06, 0x00, 0x2a, 0x00,
  0xfe, 0xff, 0x1a, 0x00, 0xed, 0xff, 0xfe, 0xff, 0xdb, 0xff, 0x17, 0x00,
  0x09, 0x00, 0x45, 0x00, 0x26, 0x00, 0x30, 0x00, 0xf6, 0xff, 0x11, 0x00,
  0xf5, 0xff, 0x1d, 0x00, 0x05, 0x00, 0x40, 0x00, 0x0d, 0x00, 0x2d, 0x00,
  0xf9, 0xff, 0x0c, 0x00, 0xda, 0xff, 0xea, 0xff, 0xbb, 0xff, 0xd2, 0xff,
  0xb4, 0xff, 0xe9, 0xff, 0xdc, 0xff, 0xeb, 0xff, 0xbe, 0xff, 0xed, 0xff,
  0xde, 0xff, 0x16, 0x00, 0xf6, 0xff, 0x25, 0x00, 0x0f, 0x00, 0x2c, 0x00,
  0xff, 0xff, 0x2c, 0x00, 0x2c, 0x00, 0x69, 0x00, 0x39, 0x00, 0x4f, 0x00,
  0x06, 0x00, 0x1b, 0x00, 0xef, 0xff, 0xff, 0xff, 0xca, 0xff, 0xee, 0xff,
  0xce, 0xff, 0x0c, 0x00, 0xe6, 0xff, 0x05, 0x00, 0xcf, 0xff, 0xe9, 0xff,
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
};
const unsigned int vocab_0_len = 21702;
