IowaScaledEngineering/ckt-defect/src/ckt-defect/vocab/include/1.h

const unsigned char vocab_1[] = {
  0x00, 0x00, 0xfe, 0xff, 0xfc, 0xff, 0xf8, 0xff, 0xf4, 0xff, 0xef, 0xff,
  0xea, 0xff, 0xe5, 0xff, 0xe0, 0xff, 0xdc, 0xff, 0xda, 0xff, 0xdb, 0xff,
  0xdb, 0xff, 0xdd, 0xff, 0xe2, 0xff, 0xe8, 0xff, 0xef, 0xff, 0xfb, 0xff,
  0x00, 0x00, 0x0c, 0x00, 0x16, 0x00, 0x25, 0x00, 0x33, 0x00, 0x3c, 0x00,
  0x45, 0x00, 0x57, 0x00, 0x61, 0x00, 0x67, 0x00, 0x6e, 0x00, 0x6f, 0x00,
  0x76, 0x00, 0x78, 0x00, 0x70, 0x00, 0x6b, 0x00, 0x63, 0x00, 0x55, 0x00,
  0x4e, 0x00, 0x48, 0x00, 0x36, 0x00, 0x2f, 0x00, 0x21, 0x00, 0x0f, 0x00,
  0x09, 0x00, 0xff, 0xff, 0xf1, 0xff, 0xe3, 0xff, 0xd6, 0xff, 0xd0, 0xff,
  0xcf, 0xff, 0xc0, 0xff, 0xb3, 0xff, 0xaf, 0xff, 0xab, 0xff, 0xab, 0xff,
  0xa6, 0xff, 0x9e, 0xff, 0x8f, 0xff, 0x9d, 0xff, 0xab, 0xff, 0xa8, 0xff,
  0xa1, 0xff, 0x99, 0xff, 0xb1, 0xff, 0xc8, 0xff, 0xba, 0xff, 0xbd, 0xff,
  0xcc, 0xff, 0xe4, 0xff, 0xef, 0xff, 0xe8, 0xff, 0xf0, 0xff, 0x18, 0x00,
  0x29, 0x00, 0x2f, 0x00, 0x2b, 0x00, 0x4e, 0x00, 0x70, 0x00, 0x65, 0x00,
  0x52, 0x00, 0x59, 0x00, 0x6c, 0x00, 0x72, 0x00, 0x58, 0x00, 0x38, 0x00,
  0x50, 0x00, 0x2d, 0x00, 0x13, 0x00, 0xfe, 0xff, 0xd0, 0xff, 0xdf, 0xff,
  0x02, 0x00, 0xca, 0xff, 0xbf, 0xff, 0xa8, 0xff, 0x98, 0xff, 0x99, 0xff,
  0x6f, 0xff, 0xae, 0xff, 0xb1, 0xff, 0x69, 0xff, 0x94, 0xff, 0xd7, 0xff,
  0xe1, 0xff, 0xc3, 0xff, 0xc9, 0xff, 0x14, 0x00, 0x01, 0x00, 0x4d, 0x00,
  0x87, 0x00, 0x5c, 0x00, 0x29, 0x00, 0x2e, 0x00, 0x49, 0x00, 0x67, 0x00,
  0x5e, 0x00, 0x58, 0x00, 0x6d, 0x00, 0x88, 0x00, 0x56, 0x00, 0x6d, 0x00,
  0x8d, 0x00, 0xc0, 0x00, 0xcb, 0x00, 0xe1, 0x00, 0x3b, 0x01, 0x46, 0x01,
  0x14, 0x01, 0x10, 0x01, 0x2a, 0x01, 0x28, 0x01, 0x2a, 0x01, 0xf6, 0x00,
  0xed, 0x00, 0xcc, 0x00, 0x99, 0x00, 0x64, 0x00, 0x01, 0x00, 0xc1, 0xff,
  0x67, 0xff, 0x02, 0xff, 0xab, 0xfe, 0x47, 0xfe, 0xfd, 0xfd, 0x7a, 0xfd,
  0xfb, 0xfc, 0xac, 0xfc, 0x53, 0xfc, 0x23, 0xfc, 0x09, 0xfc, 0x30, 0xfc,
  0x26, 0xfc, 0x4c, 0xfc, 0xbd, 0xfc, 0x3e, 0xfd, 0xa1, 0xfd, 0x4a, 0xfe,
  0xf7, 0xfe, 0xa3, 0xff, 0x28, 0x00, 0xba, 0x00, 0x42, 0x01, 0xc4, 0x01,
  0x6d, 0x02, 0xf7, 0x02, 0x39, 0x03, 0x6d, 0x03, 0xca, 0x03, 0xf1, 0x03,
  0xf4, 0x03, 0x14, 0x04, 0x05, 0x04, 0xab, 0x03, 0x56, 0x03, 0x11, 0x03,
  0xb0, 0x02, 0x5c, 0x02, 0xab, 0x01, 0x53, 0x01, 0xc1, 0x00, 0x3c, 0x00,
  0x09, 0x00, 0x95, 0xff, 0x2c, 0xff, 0xf9, 0xfe, 0xad, 0xfe, 0x84, 0xfe,
  0x8d, 0xfe, 0x25, 0xfe, 0xeb, 0xfd, 0x04, 0xfe, 0x0e, 0xfe, 0x56, 0xfe,
  0x67, 0xfe, 0x72, 0xfe, 0xbe, 0xfe, 0xc5, 0xfe, 0x00, 0xff, 0x6e, 0xff,
  0x5e, 0xff, 0x81, 0xff, 0xd8, 0xff, 0xbe, 0xff, 0x4c, 0x00, 0x25, 0x00,
  0x14, 0x00, 0x7e, 0x00, 0x2c, 0x00, 0x54, 0x00, 0x48, 0x00, 0x2c, 0x00,
  0x77, 0x00, 0x9c, 0x00, 0x0d, 0x00, 0x27, 0x00, 0x94, 0x00, 0x9b, 0x00,
  0x5d, 0x00, 0xad, 0xff, 0xb4, 0xff, 0x53, 0x00, 0x41, 0x00, 0xa7, 0xff,
  0x6c, 0xff, 0x2f, 0x00, 0x5b, 0x00, 0xca, 0xff, 0x4f, 0xff, 0xd3, 0xff,
  0xe5, 0xff, 0xe4, 0xff, 0xa3, 0xff, 0xf1, 0xfe, 0xd7, 0xff, 0xe7, 0xff,
  0x55, 0xff, 0x8c, 0xff, 0xa4, 0xff, 0xed, 0xff, 0xff, 0xff, 0x5c, 0x00,
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
};
const unsigned int vocab_1_len = 16000;
