IowaScaledEngineering/ckt-defect/src/ckt-defect/vocab/include/2.h

const unsigned char vocab_2[] = {
  0x00, 0x00, 0xff, 0xff, 0x01, 0x00, 0x00, 0x00, 0xff, 0xff, 0xfe, 0xff,
  0x04, 0x00, 0x05, 0x00, 0x04, 0x00, 0xfd, 0xff, 0x00, 0x00, 0xfb, 0xff,
  0x06, 0x00, 0xfd, 0xff, 0x02, 0x00, 0xf7, 0xff, 0x00, 0x00, 0xfa, 0xff,
  0x06, 0x00, 0xff, 0xff, 0x08, 0x00, 0xfe, 0xff, 0x06, 0x00, 0xf5, 0xff,
  0x01, 0x00, 0xf6, 0xff, 0x08, 0x00, 0xfc, 0xff, 0x0b, 0x00, 0xfc, 0xff,
  0x0f, 0x00, 0xff, 0xff, 0x0c, 0x00, 0xf1, 0xff, 0x02, 0x00, 0xf2, 0xff,
  0x08, 0x00, 0xf2, 0xff, 0x08, 0x00, 0xf7, 0xff, 0x0f, 0x00, 0xf8, 0xff,
  0x07, 0x00, 0xf0, 0xff, 0x0c, 0x00, 0xf3, 0xff, 0x0e, 0x00, 0xf5, 0xff,
  0x14, 0x00, 0xfb, 0xff, 0x12, 0x00, 0xf0, 0xff, 0x0b, 0x00, 0xec, 0xff,
  0x0c, 0x00, 0xed, 0xff, 0x0e, 0x00, 0xed, 0xff, 0x0d, 0x00, 0xec, 0xff,
  0x11, 0x00, 0xeb, 0xff, 0x12, 0x00, 0xf1, 0xff, 0x19, 0x00, 0xf3, 0xff,
  0x1b, 0x00, 0xed, 0xff, 0x18, 0x00, 0xeb, 0xff, 0x0b, 0x00, 0xdf, 0xff,
  0x11, 0x00, 0xeb, 0xff, 0x12, 0x00, 0xe9, 0xff, 0x1a, 0x00, 0xf3, 0xff,
  0x2a, 0x00, 0xed, 0xff, 0x17, 0x00, 0xf2, 0xff, 0x1f, 0x00, 0xea, 0xff,
  0x1f, 0x00, 0xed, 0xff, 0x1c, 0x00, 0xe0, 0xff, 0x10, 0x00, 0xd3, 0xff,
  0x0a, 0x00, 0xd3, 0xff, 0x0a, 0x00, 0xde, 0xff, 0x1f, 0x00, 0xe0, 0xff,
  0x1c, 0x00, 0xe6, 0xff, 0x1d, 0x00, 0xd8, 0xff, 0x1c, 0x00, 0xdf, 0xff,
  0x23, 0x00, 0xee, 0xff, 0x3b, 0x00, 0xfb, 0xff, 0x3d, 0x00, 0xed, 0xff,
  0x2e, 0x00, 0xe6, 0xff, 0x2a, 0x00, 0xf0, 0xff, 0x2a, 0x00, 0xc0, 0xff,
  0x07, 0x00, 0xbf, 0xff, 0x0f, 0x00, 0xc0, 0xff, 0x0c, 0x00, 0xc5, 0xff,
  0x23, 0x00, 0xe6, 0xff, 0x48, 0x00, 0xe8, 0xff, 0x33, 0x00, 0xe0, 0xff,
  0x30, 0x00, 0xd4, 0xff, 0x1b, 0x00, 0xc8, 0xff, 0x2a, 0x00, 0xdd, 0xff,
  0x34, 0x00, 0xd2, 0xff, 0x28, 0x00, 0xeb, 0xff, 0x3e, 0x00, 0xcc, 0xff,
  0x20, 0x00, 0xc5, 0xff, 0x21, 0x00, 0xc3, 0xff, 0x23, 0x00, 0xde, 0xff,
  0x43, 0x00, 0xea, 0xff, 0x46, 0x00, 0xd6, 0xff, 0x30, 0x00, 0xbc, 0xff,
  0x1f, 0x00, 0xc4, 0xff, 0x2d, 0x00, 0xce, 0xff, 0x3e, 0x00, 0xdd, 0xff,
  0x50, 0x00, 0xd2, 0xff, 0x2a, 0x00, 0xb2, 0xff, 0x21, 0x00, 0xa8, 0xff,
  0x24, 0x00, 0xb9, 0xff, 0x4f, 0x00, 0xdb, 0xff, 0x55, 0x00, 0xca, 0xff,
  0x44, 0x00, 0xb5, 0xff, 0x3e, 0x00, 0xc3, 0xff, 0x44, 0x00, 0xc4, 0xff,
  0x37, 0x00, 0xbd, 0xff, 0x42, 0x00, 0xb1, 0xff, 0x35, 0x00, 0xba, 0xff,
  0x4a, 0x00, 0xcb, 0xff, 0x53, 0x00, 0xc7, 0xff, 0x49, 0x00, 0xb5, 0xff,
  0x47, 0x00, 0xc1, 0xff, 0x51, 0x00, 0xbc, 0xff, 0x49, 0x00, 0xb4, 0xff,
  0x39, 0x00, 0xb6, 0xff, 0x58, 0x00, 0xac, 0xff, 0x45, 0x00, 0xa2, 0xff,
  0x3b, 0x00, 0xb6, 0xff, 0x4d, 0x00, 0xb0, 0xff, 0x57, 0x00, 0xb6, 0xff,
  0x52, 0x00, 0xbb, 0xff, 0x49, 0x00, 0xbb, 0xff, 0x5b, 0x00, 0xa0, 0xff,
  0x58, 0x00, 0x9d, 0xff, 0x48, 0x00, 0xa8, 0xff, 0x54, 0x00, 0xa8, 0xff,
  0x66, 0x00, 0x9f, 0xff, 0x5a, 0x00, 0xaf, 0xff, 0x5b, 0x00, 0xb3, 0xff,
  0x65, 0x00, 0x97, 0xff, 0x61, 0x00, 0xa7, 0xff, 0x5b, 0x00, 0xa2, 0xff,
  0x52, 0x00, 0x98, 0xff, 0x68, 0x00, 0x98, 0xff, 0x5b, 0x00, 0xa4, 0xff,
  0x6d, 0x00, 0xb2, 0xff, 0x76, 0x00, 0xa0, 0xff, 0x6f, 0x00, 0x95, 0xff,
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
};
const unsigned int vocab_2_len = 16000;
