IowaScaledEngineering/ckt-defect/src/ckt-defect/vocab/include/5.h

const unsigned char vocab_5[] = {
  0x00, 0x00, 0x00, 0x00, 0x00, 0x00, 0x01, 0x00, 0xff, 0xff, 0xff, 0xff,
  0xfe, 0xff, 0x03, 0x00, 0xfe, 0xff, 0xfe, 0xff, 0x06, 0x00, 0xfd, 0xff,
  0xfd, 0xff, 0x07, 0x00, 0xfe, 0xff, 0x00, 0x00, 0x06, 0x00, 0x00, 0x00,
  0x02, 0x00, 0xf5, 0xff, 0xf2, 0xff, 0x27, 0x00, 0xea, 0xff, 0x0c, 0x00,
  0x02, 0x00, 0xed, 0xff, 0x0f, 0x00, 0x03, 0x00, 0xd8, 0xff, 0x19, 0x00,
  0xf6, 0xff, 0xfa, 0xff, 0xfa, 0xff, 0x34, 0x00, 0xea, 0xff, 0x13, 0x00,
  0x01, 0x00, 0xd6, 0xff, 0x10, 0x00, 0xfe, 0xff, 0x25, 0x00, 0xf3, 0xff,
  0xf7, 0xff, 0xd3, 0xff, 0x15, 0x00, 0xf5, 0xff, 0x18, 0x00, 0xff, 0xff,
  0xbe, 0xff, 0x4b, 0x00, 0xea, 0xff, 0xd1, 0xff, 0x78, 0x00, 0xaa, 0xff,
  0x08, 0x00, 0xe1, 0xff, 0x0a, 0x00, 0x5f, 0x00, 0xd9, 0xff, 0x2a, 0x00,
  0xe6, 0xff, 0x14, 0x00, 0x37, 0x00, 0xde, 0xff, 0xd4, 0xff, 0x0b, 0x00,
  0xf5, 0xff, 0xd2, 0xff, 0x41, 0x00, 0xf2, 0xff, 0xe6, 0xff, 0xe5, 0xff,
  0x59, 0x00, 0x8d, 0xff, 0xe4, 0xff, 0x5b, 0x00, 0x8f, 0xff, 0x6b, 0x00,
  0x79, 0xff, 0x4b, 0x00, 0x26, 0x00, 0xf9, 0xff, 0xbd, 0xff, 0xcc, 0xff,
  0x58, 0x00, 0x14, 0x00, 0xc7, 0xff, 0x6e, 0x00, 0xeb, 0xff, 0xba, 0xff,
  0xa0, 0x00, 0x7a, 0xff, 0x70, 0x00, 0xd9, 0xff, 0xb9, 0xff, 0x17, 0x00,
  0x6c, 0x00, 0xd9, 0xff, 0xd9, 0xff, 0x97, 0x00, 0x49, 0xff, 0xda, 0x00,
  0x65, 0xff, 0xf3, 0xff, 0x03, 0x00, 0xe9, 0xff, 0x24, 0x00, 0xd1, 0xff,
  0x60, 0x00, 0xd9, 0xff, 0x46, 0xff, 0x63, 0x00, 0x11, 0x00, 0xc7, 0xff,
  0x15, 0x00, 0xc5, 0xff, 0x46, 0x00, 0xb0, 0xff, 0x82, 0x00, 0x53, 0x00,
  0xdb, 0xff, 0x22, 0x00, 0x95, 0xff, 0x4f, 0x00, 0xc2, 0xff, 0x3c, 0xff,
  0xd9, 0x00, 0xad, 0xff, 0x7f, 0x00, 0xa2, 0xff, 0xe6, 0x00, 0x65, 0xff,
  0xa2, 0xff, 0x4b, 0x00, 0x96, 0xff, 0xed, 0xff, 0x14, 0x00, 0xfd, 0xfe,
  0xc0, 0x01, 0x3b, 0xff, 0x3f, 0x00, 0xe1, 0xff, 0x05, 0x01, 0xf2, 0xfe,
  0x62, 0x00, 0xcf, 0xff, 0x58, 0x00, 0xf3, 0xff, 0xba, 0xff, 0xb3, 0xff,
  0xfb, 0xff, 0x9f, 0x00, 0x1c, 0x00, 0xdc, 0xff, 0x4e, 0xff, 0x79, 0x00,
  0x5b, 0xff, 0x7a, 0x00, 0xb4, 0xff, 0x15, 0xff, 0xe7, 0x00, 0x8b, 0x00,
  0x50, 0xff, 0xcb, 0x01, 0x79, 0xff, 0x58, 0xff, 0x61, 0x00, 0xb4, 0xff,
  0xc4, 0xff, 0xc7, 0x00, 0x60, 0xff, 0x30, 0x01, 0x60, 0xff, 0xf5, 0x00,
  0xcf, 0xfd, 0x53, 0x01, 0xdd, 0xff, 0x73, 0x00, 0x28, 0x00, 0xb4, 0xff,
  0xd0, 0xff, 0x13, 0xff, 0x16, 0x00, 0x93, 0xff, 0xea, 0xff, 0x1d, 0xff,
  0xaa, 0x00, 0x2a, 0x00, 0x5e, 0x00, 0x9c, 0xfe, 0xc3, 0x00, 0x2a, 0x00,
  0x48, 0x00, 0x03, 0x00, 0x81, 0x01, 0xb2, 0xff, 0xcf, 0xff, 0xe6, 0xff,
  0xff, 0xff, 0x5c, 0xff, 0x63, 0xff, 0xdd, 0xff, 0xb8, 0xff, 0xed, 0x00,
  0x52, 0x00, 0x9e, 0x00, 0x07, 0x00, 0x07, 0xff, 0x33, 0x00, 0x8a, 0x00,
  0xcf, 0xff, 0x7c, 0xff, 0xb9, 0xff, 0x0a, 0x00, 0x4b, 0x01, 0xd4, 0xff,
  0x1c, 0x01, 0x62, 0xff, 0x17, 0x00, 0xf1, 0xff, 0x39, 0xff, 0x81, 0x00,
  0x6c, 0x00, 0xc2, 0xff, 0x1b, 0x00, 0x1d, 0xff, 0x4e, 0xff, 0x70, 0x00,
  0xc6, 0xff, 0x59, 0x00, 0x0b, 0x00, 0x26, 0xff, 0x8d, 0x00, 0x64, 0xfe,
  0xe7, 0x02, 0x2a, 0xff, 0x41, 0xff, 0xc7, 0x00, 0x15, 0x00, 0x0f, 0x00,
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
};
const unsigned int vocab_5_len = 18696;
