IowaScaledEngineering/ckt-defect/src/ckt-defect/vocab/include/6.h

const unsigned char vocab_6[] = {
  0x00, 0x00, 0x00, 0x00, 0xfb, 0xff, 0xfe, 0xff, 0x05, 0x00, 0xfc, 0xff,
  0xf9, 0xff, 0x0a, 0x00, 0x12, 0x00, 0x07, 0x00, 0xf4, 0xff, 0xfd, 0xff,
  0x01, 0x00, 0xfc, 0xff, 0xe5, 0xff, 0x00, 0x00, 0x0b, 0x00, 0x12, 0x00,
  0x02, 0x00, 0x09, 0x00, 0x06, 0x00, 0xea, 0xff, 0xeb, 0xff, 0xf3, 0xff,
  0x09, 0x00, 0xfb, 0xff, 0xeb, 0xff, 0x00, 0x00, 0x33, 0x00, 0xf4, 0xff,
  0xe4, 0xff, 0x1a, 0x00, 0x0a, 0x00, 0xc2, 0xff, 0xef, 0xff, 0x1e, 0x00,
  0x1d, 0x00, 0xf0, 0xff, 0x15, 0x00, 0x2d, 0x00, 0x09, 0x00, 0xd2, 0xff,
  0xce, 0xff, 0x13, 0x00, 0x08, 0x00, 0x04, 0x00, 0x0a, 0x00, 0x3a, 0x00,
  0x6c, 0x00, 0xff, 0xff, 0x9c, 0xff, 0xbf, 0xff, 0xac, 0xff, 0x06, 0x00,
  0x1e, 0x00, 0x7a, 0x00, 0x02, 0x00, 0xe7, 0xff, 0x34, 0x00, 0x29, 0x00,
  0xb5, 0xff, 0x69, 0xff, 0x2c, 0x00, 0xea, 0xff, 0x74, 0xff, 0x46, 0x00,
  0x97, 0x00, 0x65, 0x00, 0xa0, 0xff, 0x0b, 0x00, 0x09, 0x00, 0x0b, 0x00,
  0x62, 0xff, 0x92, 0x00, 0xe4, 0xff, 0x2a, 0xff, 0x01, 0x00, 0xdf, 0x00,
  0xd7, 0x00, 0xf9, 0xff, 0xae, 0xff, 0x21, 0x00, 0xe0, 0xff, 0x22, 0xff,
  0xa3, 0xff, 0x7a, 0x00, 0xb4, 0xff, 0xb2, 0xff, 0x7e, 0x00, 0xda, 0x00,
  0x1c, 0x00, 0x1f, 0xff, 0x78, 0xff, 0x5b, 0x00, 0xf9, 0xff, 0xd6, 0xfe,
  0xe5, 0x00, 0xe8, 0x01, 0x08, 0x00, 0x29, 0xff, 0x72, 0x00, 0xc5, 0x00,
  0x5d, 0xff, 0xf9, 0xfd, 0xe2, 0xfe, 0xaf, 0x01, 0x0e, 0x01, 0x44, 0xff,
  0x9f, 0x00, 0x7e, 0x01, 0x9e, 0xff, 0x4b, 0xfe, 0x06, 0x00, 0x11, 0x00,
  0x6c, 0xff, 0x79, 0xff, 0xa1, 0xff, 0xf4, 0x01, 0x33, 0x01, 0x57, 0xff,
  0xa2, 0xfe, 0x1b, 0x00, 0x97, 0xff, 0xca, 0xfe, 0x61, 0xff, 0x01, 0x01,
  0xb5, 0x01, 0x16, 0x02, 0xac, 0xff, 0x77, 0xfe, 0x60, 0xfe, 0xd3, 0x00,
  0x07, 0x00, 0xf4, 0xfd, 0x1c, 0xff, 0x37, 0x03, 0x4c, 0x01, 0xa8, 0x01,
  0xdb, 0xff, 0x37, 0xfe, 0x2d, 0x01, 0xe6, 0xff, 0xe4, 0xfd, 0xc3, 0xff,
  0x69, 0xfe, 0x9a, 0xff, 0x04, 0x03, 0x37, 0x02, 0x0e, 0x00, 0x34, 0xfe,
  0x2d, 0xfe, 0xe2, 0xff, 0xbe, 0xfe, 0xe0, 0x00, 0xeb, 0xff, 0x85, 0x00,
  0xaa, 0x00, 0x69, 0x01, 0x85, 0xfe, 0xf7, 0x01, 0xfd, 0xfc, 0x30, 0xff,
  0xe9, 0x01, 0x08, 0xff, 0x49, 0xfd, 0xb5, 0x02, 0x69, 0x02, 0xdb, 0x01,
  0x84, 0xfe, 0x66, 0xfe, 0x44, 0xfe, 0x7c, 0x03, 0xa8, 0xfd, 0x01, 0xfd,
  0xc4, 0x02, 0x1a, 0x02, 0xd3, 0xfe, 0x2b, 0x01, 0xe0, 0x02, 0x80, 0xfe,
  0x1c, 0xf9, 0x5d, 0xff, 0x0a, 0x04, 0xab, 0x00, 0xe0, 0xfd, 0x92, 0x03,
  0x06, 0x03, 0xd9, 0x00, 0xb8, 0xf9, 0x1e, 0x01, 0x1d, 0x02, 0xd3, 0xfa,
  0x82, 0xfa, 0x47, 0x03, 0xf2, 0x07, 0xc9, 0x02, 0xe6, 0xfa, 0x72, 0x00,
  0x2b, 0x03, 0xd6, 0xfc, 0x08, 0xfe, 0xe5, 0xfe, 0x72, 0x01, 0xb7, 0xfe,
  0x9e, 0x01, 0x2e, 0x04, 0xe1, 0x02, 0xbb, 0xf8, 0xaf, 0xff, 0xcd, 0x03,
  0xac, 0xfd, 0x96, 0xf7, 0xd0, 0xfe, 0xad, 0x0c, 0x75, 0x03, 0x24, 0xf8,
  0x3b, 0xfd, 0xbe, 0x06, 0x07, 0x03, 0x21, 0xf5, 0x85, 0xfb, 0x1b, 0x09,
  0x0e, 0x06, 0xeb, 0xf4, 0x28, 0x00, 0x12, 0x0f, 0x83, 0x01, 0x3b, 0xf3,
  0xbb, 0xfa, 0xbd, 0x02, 0xdc, 0x01, 0x9e, 0xfc, 0xfd, 0x01, 0xf1, 0x06,
  0x52, 0xfe, 0x65, 0xfd, 0x91, 0x03, 0x28, 0x04, 0xd7, 0xfb, 0xe3, 0xf9,
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
};
const unsigned int vocab_6_len = 22460;
