IowaScaledEngineering/ckt-defect/src/ckt-defect/vocab/include/7.h

const unsigned char vocab_7[] = {
  0x00, 0x00, 0x00, 0x00, 0xff, 0xff, 0x03, 0x00, 0xff, 0xff, 0xf6, 0xff,
  0x03, 0x00, 0x09, 0x00, 0xf8, 0xff, 0x00, 0x00, 0x15, 0x00, 0x04, 0x00,
  0xfb, 0xff, 0x00, 0x00, 0x00, 0x00, 0xf9, 0xff, 0xfa, 0xff, 0x05, 0x00,
  0x05, 0x00, 0x04, 0x00, 0xee, 0xff, 0xfe, 0xff, 0xff, 0xff, 0xf0, 0xff,
  0xf6, 0xff, 0x01, 0x00, 0xdc, 0xff, 0xf8, 0xff, 0x01, 0x00, 0xff, 0xff,
  0x03, 0x00, 0x0e, 0x00, 0xfb, 0xff, 0x29, 0x00, 0xf2, 0xff, 0xdb, 0xff,
  0x3d, 0x00, 0x28, 0x00, 0xb3, 0xff, 0xe5, 0xff, 0x51, 0x00, 0x14, 0x00,
  0x00, 0x00, 0x33, 0x00, 0x10, 0x00, 0xa0, 0xff, 0x21, 0x00, 0x25, 0x00,
  0xb6, 0xff, 0xf8, 0xff, 0x3b, 0x00, 0x12, 0x00, 0xb6, 0xff, 0x11, 0x00,
  0x28, 0x00, 0x21, 0x00, 0x11, 0x00, 0xa9, 0xff, 0x89, 0xff, 0x56, 0x00,
  0xee, 0xff, 0x78, 0xff, 0x82, 0x00, 0x7c, 0x00, 0x83, 0xff, 0xd6, 0xff,
  0x9d, 0x00, 0xf9, 0xff, 0xbe, 0xff, 0xcf, 0xff, 0xc8, 0xff, 0x18, 0x00,
  0x7d, 0x00, 0xeb, 0xff, 0x95, 0xff, 0xe0, 0x00, 0xed, 0xff, 0x37, 0xff,
  0xeb, 0xff, 0x6f, 0x00, 0xb2, 0xff, 0xb9, 0xff, 0xf6, 0xff, 0x7c, 0x00,
  0x00, 0x00, 0x96, 0xff, 0x74, 0x00, 0x65, 0x00, 0xb4, 0xff, 0x06, 0x00,
  0x07, 0x01, 0x63, 0xff, 0x4e, 0xff, 0x54, 0x01, 0x9f, 0x00, 0x1c, 0xfe,
  0x5a, 0xff, 0x8f, 0x01, 0xb7, 0xff, 0xce, 0xfe, 0xb2, 0x00, 0xca, 0x00,
  0x5a, 0xff, 0xe7, 0xff, 0x10, 0x00, 0x85, 0x00, 0x66, 0xfe, 0x54, 0x00,
  0x17, 0x00, 0x2a, 0x00, 0x84, 0xff, 0x15, 0x00, 0x4a, 0x00, 0xef, 0xff,
  0x1c, 0x00, 0x83, 0xff, 0x61, 0x00, 0x44, 0x00, 0x35, 0xff, 0x78, 0x01,
  0x7a, 0xff, 0xad, 0x00, 0x28, 0x02, 0x06, 0xff, 0x47, 0xfe, 0xd1, 0x01,
  0xc1, 0xff, 0x1b, 0xfe, 0x02, 0x01, 0x10, 0x01, 0xdf, 0xfd, 0x5f, 0x00,
  0xb2, 0x01, 0xd5, 0xfe, 0xf0, 0xfe, 0x08, 0x01, 0x0d, 0xff, 0x66, 0xff,
  0x92, 0xff, 0xb4, 0x01, 0xf6, 0xfe, 0xe6, 0xfe, 0x5b, 0x02, 0x77, 0xff,
  0xb3, 0xfd, 0x96, 0x01, 0x7c, 0xff, 0x2f, 0x00, 0xdd, 0xff, 0x64, 0x00,
  0x5c, 0x01, 0x15, 0x00, 0xdc, 0xff, 0xe0, 0xfe, 0x99, 0xff, 0x7e, 0x02,
  0xc5, 0xff, 0x44, 0xff, 0xe7, 0x00, 0x72, 0x02, 0xcd, 0xfd, 0x59, 0x00,
  0xeb, 0xff, 0xeb, 0xff, 0x9f, 0xfe, 0xe0, 0xff, 0x54, 0x01, 0xa9, 0xff,
  0x4c, 0xfe, 0x50, 0x00, 0x98, 0x00, 0x0e, 0xfd, 0x97, 0xff, 0xb4, 0x02,
  0x44, 0x00, 0xae, 0xfc, 0xcb, 0x01, 0xe0, 0x01, 0x89, 0xfe, 0xa1, 0xff,
  0x03, 0x01, 0xe6, 0x00, 0xaa, 0xfe, 0x1c, 0x00, 0x10, 0x01, 0x03, 0x02,
  0x2c, 0xfe, 0x74, 0x01, 0xee, 0x00, 0x22, 0xfe, 0x07, 0xff, 0xad, 0x00,
  0x0b, 0x02, 0x59, 0xfe, 0xe4, 0xfd, 0xdc, 0xff, 0x1b, 0x01, 0x9a, 0x00,
  0x00, 0xff, 0x1a, 0x00, 0x59, 0xff, 0xd8, 0x00, 0xb6, 0x00, 0x04, 0xff,
  0x66, 0x00, 0xf5, 0x00, 0x0b, 0xff, 0xb7, 0xfd, 0xf1, 0x02, 0xcb, 0xff,
  0xa4, 0xfb, 0xba, 0x02, 0xd3, 0x02, 0xcc, 0xfb, 0xbd, 0x02, 0x3b, 0x01,
  0x26, 0xff, 0x14, 0xfe, 0x05, 0x03, 0x61, 0xfe, 0x2d, 0xff, 0x72, 0x04,
  0x54, 0xfe, 0x80, 0xfd, 0xb0, 0x02, 0xb2, 0x01, 0x26, 0xfb, 0x37, 0x00,
  0x8b, 0x03, 0xb6, 0xfb, 0xf2, 0xfd, 0x18, 0x05, 0xb6, 0xfd, 0x15, 0x02,
  0xc8, 0xfe, 0xcf, 0xfd, 0x74, 0x01, 0x1e, 0xfe, 0x02, 0x02, 0x1f, 0xfe,
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
};
const unsigned int vocab_7_len = 16000;
