IowaScaledEngineering/ckt-defect/src/ckt-defect/vocab/include/8.h

const unsigned char vocab_8[] = {
  0x00, 0x00, 0xfe, 0xff, 0x01, 0x00, 0x08, 0x00, 0x07, 0x00, 0xfc, 0xff,
  0xf2, 0xff, 0xf6, 0xff, 0x01, 0x00, 0x0b, 0x00, 0x12, 0x00, 0x12, 0x00,
  0xf7, 0xff, 0xcf, 0xff, 0xd2, 0xff, 0x1d, 0x00, 0x5f, 0x00, 0x34, 0x00,
  0xc2, 0xff, 0x99, 0xff, 0xe6, 0xff, 0x3e, 0x00, 0x45, 0x00, 0x39, 0x00,
  0x35, 0x00, 0xda, 0xff, 0x38, 0xff, 0x4e, 0xff, 0xc0, 0x00, 0xff, 0x01,
  0xda, 0x00, 0xd3, 0xfd, 0x4d, 0xfd, 0xb2, 0xff, 0x75, 0x01, 0xf5, 0x00,
  0x0a, 0x00, 0xe3, 0xff, 0x69, 0xff, 0x34, 0xff, 0x60, 0x00, 0x5d, 0x01,
  0x34, 0x00, 0xc2, 0xfe, 0xaa, 0xff, 0x0c, 0x02, 0x9c, 0x01, 0x26, 0xff,
  0x66, 0xfe, 0x94, 0xff, 0x92, 0x00, 0x87, 0x00, 0xe9, 0x00, 0xef, 0x00,
  0xa7, 0xff, 0x04, 0xfe, 0x09, 0xfe, 0x0c, 0x00, 0x9a, 0x01, 0x3e, 0x01,
  0xd7, 0xff, 0xaf, 0xfe, 0x5c, 0xfe, 0xc8, 0xfe, 0xaf, 0xff, 0x4c, 0x01,
  0x59, 0x02, 0x5f, 0x01, 0x3c, 0xfe, 0x4c, 0xfc, 0x6c, 0xff, 0xc9, 0x05,
  0xc7, 0x07, 0x39, 0x02, 0x9f, 0xfb, 0x10, 0xfb, 0xde, 0xfe, 0x41, 0x01,
  0x76, 0x01, 0x67, 0x01, 0x4f, 0x00, 0x83, 0xfd, 0xf1, 0xfc, 0xe6, 0xff,
  0xb2, 0x00, 0xac, 0xfd, 0x09, 0xfd, 0xd0, 0x01, 0x08, 0x04, 0xac, 0xff,
  0x6a, 0xfb, 0xa4, 0xfc, 0x79, 0xff, 0x01, 0x01, 0x0a, 0x03, 0x20, 0x04,
  0xf8, 0xff, 0x72, 0xfa, 0xc5, 0xfb, 0x49, 0x03, 0x87, 0x07, 0xab, 0x04,
  0x9d, 0xff, 0x4a, 0xfd, 0x42, 0xfe, 0x37, 0x01, 0x46, 0x03, 0xc7, 0x02,
  0x4c, 0x00, 0x2f, 0xfe, 0xfe, 0xfd, 0x78, 0xff, 0xef, 0x00, 0x06, 0x00,
  0x8f, 0xfd, 0x6d, 0xfd, 0x52, 0x00, 0xb3, 0x01, 0x06, 0xff, 0x1f, 0xfc,
  0x39, 0xfd, 0x07, 0x00, 0xe9, 0x00, 0x2c, 0x00, 0xe6, 0xff, 0x98, 0xff,
  0x80, 0xfe, 0xd0, 0xfe, 0x18, 0x01, 0x06, 0x02, 0x15, 0x00, 0xf2, 0xfe,
  0x5f, 0x01, 0x9c, 0x03, 0xb8, 0x01, 0x62, 0xfe, 0x8a, 0xfe, 0x6d, 0x01,
  0xab, 0x02, 0xb6, 0x01, 0xc4, 0x00, 0x52, 0x00, 0x4f, 0xff, 0xd3, 0xfe,
  0x43, 0x00, 0xaf, 0x01, 0x51, 0x00, 0x55, 0xfd, 0xca, 0xfc, 0xb7, 0xff,
  0xcc, 0x02, 0x2d, 0x02, 0x47, 0xfe, 0x38, 0xfb, 0x8d, 0xfc, 0xbf, 0x00,
  0x2c, 0x03, 0x38, 0x02, 0x00, 0xff, 0x06, 0xfd, 0x67, 0xfc, 0xde, 0xfd,
  0xb9, 0x01, 0x02, 0x06, 0x00, 0x05, 0xd3, 0xfd, 0x08, 0xf8, 0x24, 0xfc,
  0xe4, 0x05, 0x7a, 0x09, 0x41, 0x03, 0x35, 0xfc, 0xc2, 0xfa, 0xc3, 0xfb,
  0x71, 0xfd, 0x89, 0x03, 0x0d, 0x0c, 0xfe, 0x09, 0x95, 0xf8, 0xcc, 0xeb,
  0xe3, 0xf5, 0xdd, 0x0d, 0xc4, 0x13, 0x86, 0x02, 0x79, 0xf0, 0x4c, 0xf2,
  0x8c, 0xfc, 0xcd, 0x01, 0xe3, 0x08, 0xa9, 0x16, 0x06, 0x14, 0x73, 0xee,
  0x80, 0xd1, 0x9c, 0xf4, 0x66, 0x3c, 0x17, 0x45, 0x79, 0x03, 0x6c, 0xc8,
  0x4b, 0xd9, 0xea, 0x07, 0x9d, 0x0b, 0x6b, 0xfb, 0xb7, 0x01, 0xc7, 0x06,
  0x05, 0xea, 0x92, 0xd7, 0x93, 0xf0, 0xb5, 0x0f, 0x58, 0x01, 0x9b, 0xea,
  0x8a, 0xfc, 0xd9, 0x18, 0x36, 0x0b, 0xb7, 0xe7, 0x01, 0xe4, 0x6c, 0x00,
  0xbd, 0x18, 0xd7, 0x1d, 0x67, 0x14, 0x8a, 0x00, 0x19, 0xec, 0xa6, 0xef,
  0xd2, 0x0d, 0x94, 0x26, 0x03, 0x22, 0x84, 0x05, 0x35, 0xee, 0x7e, 0xed,
  0x5c, 0xfd, 0xd6, 0x0b, 0xc0, 0x0f, 0x2c, 0x09, 0xb7, 0xfa, 0x69, 0xec,
  0xe0, 0xe9, 0xfc, 0xf6, 0xdd, 0x05, 0x98, 0x05, 0x47, 0xf8, 0x0a, 0xef,
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
};
const unsigned int vocab_8_len = 16000;
