IowaScaledEngineering/ckt-defect/src/ckt-defect/vocab/include/9.h

const unsigned char vocab_9[] = {
  0x00, 0x00, 0x02, 0x00, 0x05, 0x00, 0x09, 0x00, 0x0d, 0x00, 0x11, 0x00,
  0x16, 0x00, 0x1a, 0x00, 0x1d, 0x00, 0x20, 0x00, 0x20, 0x00, 0x1c, 0x00,
  0x15, 0x00, 0x0b, 0x00, 0x00, 0x00, 0xf2, 0xff, 0xe4, 0xff, 0xd2, 0xff,
  0xc1, 0xff, 0xac, 0xff, 0x97, 0xff, 0x7c, 0xff, 0x63, 0xff, 0x4c, 0xff,
  0x3d, 0xff, 0x2e, 0xff, 0x2a, 0xff, 0x2c, 0xff, 0x34, 0xff, 0x3c, 0xff,
  0x4b, 0xff, 0x5e, 0xff, 0x77, 0xff, 0x8e, 0xff, 0xac, 0xff, 0xd2, 0xff,
  0xff, 0xff, 0x29, 0x00, 0x55, 0x00, 0x82, 0x00, 0xb0, 0x00, 0xd4, 0x00,
  0xef, 0x00, 0x09, 0x01, 0x22, 0x01, 0x30, 0x01, 0x3a, 0x01, 0x47, 0x01,
  0x50, 0x01, 0x4b, 0x01, 0x3a, 0x01, 0x26, 0x01, 0x0f, 0x01, 0xe9, 0x00,
  0xbe, 0x00, 0x98, 0x00, 0x7c, 0x00, 0x5d, 0x00, 0x3a, 0x00, 0x21, 0x00,
  0x0b, 0x00, 0xf0, 0xff, 0xc2, 0xff, 0x9c, 0xff, 0x81, 0xff, 0x6a, 0xff,
  0x55, 0xff, 0x4b, 0xff, 0x4b, 0xff, 0x43, 0xff, 0x35, 0xff, 0x31, 0xff,
  0x28, 0xff, 0x1f, 0xff, 0x13, 0xff, 0x12, 0xff, 0x24, 0xff, 0x3e, 0xff,
  0x5b, 0xff, 0x71, 0xff, 0x8d, 0xff, 0xa0, 0xff, 0xb1, 0xff, 0xbb, 0xff,
  0xcc, 0xff, 0xe4, 0xff, 0xfd, 0xff, 0x16, 0x00, 0x43, 0x00, 0x67, 0x00,
  0x83, 0x00, 0x83, 0x00, 0x8c, 0x00, 0x88, 0x00, 0x8a, 0x00, 0x81, 0x00,
  0x7c, 0x00, 0x75, 0x00, 0x73, 0x00, 0x79, 0x00, 0x83, 0x00, 0x76, 0x00,
  0x65, 0x00, 0x3d, 0x00, 0x13, 0x00, 0xf0, 0xff, 0xe7, 0xff, 0xdb, 0xff,
  0xd1, 0xff, 0xc3, 0xff, 0xbf, 0xff, 0xb6, 0xff, 0xa1, 0xff, 0x84, 0xff,
  0x69, 0xff, 0x52, 0xff, 0x41, 0xff, 0x4d, 0xff, 0x66, 0xff, 0x8d, 0xff,
  0x8e, 0xff, 0x92, 0xff, 0xa2, 0xff, 0xb0, 0xff, 0xb1, 0xff, 0xbc, 0xff,
  0xe0, 0xff, 0x07, 0x00, 0x36, 0x00, 0x4d, 0x00, 0x7c, 0x00, 0xa0, 0x00,
  0xac, 0x00, 0xa1, 0x00, 0xb8, 0x00, 0xb8, 0x00, 0xde, 0x00, 0xdd, 0x00,
  0x27, 0x01, 0x4f, 0x01, 0x76, 0x01, 0xa4, 0x01, 0x52, 0x02, 0xb2, 0x02,
  0xd6, 0x02, 0x84, 0x02, 0x6b, 0x02, 0x3c, 0x02, 0xe6, 0x01, 0xc7, 0x01,
  0xe5, 0x01, 0x19, 0x02, 0xe9, 0x01, 0x92, 0x01, 0x5d, 0x01, 0xce, 0x00,
  0xe5, 0xff, 0xe0, 0xfe, 0x3b, 0xfe, 0xe1, 0xfd, 0x7b, 0xfd, 0x30, 0xfd,
  0xda, 0xfc, 0x64, 0xfc, 0x93, 0xfb, 0xc0, 0xfa, 0x41, 0xfa, 0xc2, 0xf9,
  0x48, 0xf9, 0x33, 0xf9, 0x9d, 0xf9, 0x6a, 0xfa, 0x03, 0xfb, 0xa8, 0xfb,
  0x3d, 0xfc, 0xb0, 0xfc, 0x02, 0xfd, 0x70, 0xfd, 0x4c, 0xfe, 0x27, 0xff,
  0xde, 0xff, 0xcf, 0x00, 0x06, 0x02, 0x09, 0x03, 0x77, 0x03, 0xeb, 0x03,
  0x64, 0x04, 0x8a, 0x04, 0x5f, 0x04, 0x83, 0x04, 0xed, 0x04, 0x03, 0x05,
  0xe1, 0x04, 0xff, 0x04, 0x40, 0x05, 0x09, 0x05, 0x5b, 0x04, 0xf4, 0x03,
  0xa0, 0x03, 0x02, 0x03, 0x4a, 0x02, 0xf7, 0x01, 0xd1, 0x01, 0x70, 0x01,
  0x04, 0x01, 0xf4, 0x00, 0xea, 0x00, 0x8d, 0x00, 0xc6, 0xff, 0x41, 0xff,
  0xdf, 0xfe, 0xac, 0xfe, 0x4d, 0xfe, 0x16, 0xfe, 0x39, 0xfe, 0x57, 0xfe,
  0x22, 0xfe, 0xca, 0xfd, 0xa5, 0xfd, 0x92, 0xfd, 0x1f, 0xfd, 0xd0, 0xfc,
  0xc8, 0xfc, 0x02, 0xfd, 0xf1, 0xfc, 0xe7, 0xfc, 0x3b, 0xfd, 0x5e, 0xfd,
  0x48, 0xfd, 0x01, 0xfd, 0x77, 0xfd, 0xdb, 0xfd, 0x15, 0xfe, 0x4e, 0xfe,
  0x14, 0xff, 0xf8, 0xff, 0x61, 0x00, 0xbd, 0x00, 0x6c, 0x01, 0x04, 0x02,
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
};
const unsigned int vocab_9_len = 18824;
