IowaScaledEngineering/ckt-defect/src/ckt-defect/vocab/include/a.h

const unsigned char vocab_a[] = {
  0x00, 0x00, 0x00, 0x00, 0xff, 0xff, 0x00, 0x00, 0x01, 0x00, 0x03, 0x00,
  0x00, 0x00, 0x00, 0x00, 0x00, 0x00, 0x00, 0x00, 0x01, 0x00, 0x00, 0x00,
  0x04, 0x00, 0x01, 0x00, 0x00, 0x00, 0xfe, 0xff, 0xfe, 0xff, 0xff, 0xff,
  0xfd, 0xff, 0xff, 0xff, 0xfd, 0xff, 0x00, 0x00, 0x04, 0x00, 0xff, 0xff,
  0x02, 0x00, 0x00, 0x00, 0x01, 0x00, 0x01, 0x00, 0x01, 0x00, 0x04, 0x00,
  0x05, 0x00, 0x04, 0x00, 0x03, 0x00, 0x00, 0x00, 0xff, 0xff, 0x00, 0x00,
  0x01, 0x00, 0x00, 0x00, 0x04, 0x00, 0xfe, 0xff, 0x03, 0x00, 0x01, 0x00,
  0xfe, 0xff, 0xff, 0xff, 0xff, 0xff, 0xff, 0xff, 0x00, 0x00, 0xfe, 0xff,
  0x03, 0x00, 0x00, 0x00, 0xff, 0xff, 0x01, 0x00, 0xfe, 0xff, 0xfd, 0xff,
  0x03, 0x00, 0xf8, 0xff, 0x01, 0x00, 0x00, 0x00, 0xfb, 0xff, 0x02, 0x00,
  0xfe, 0xff, 0x00, 0x00, 0xfe, 0xff, 0xfd, 0xff, 0xfd, 0xff, 0x03, 0x00,
  0xfe, 0xff, 0x00, 0x00, 0x03, 0x00, 0x01, 0x00, 0x01, 0x00, 0x05, 0x00,
  0xfe, 0xff, 0x02, 0x00, 0xfe, 0xff, 0x00, 0x00, 0xff, 0xff, 0x00, 0x00,
  0x00, 0x00, 0x01, 0x00, 0xfd, 0xff, 0x00, 0x00, 0x01, 0x00, 0xff, 0xff,
  0x01, 0x00, 0x00, 0x00, 0x00, 0x00, 0x01, 0x00, 0x00, 0x00, 0x00, 0x00,
  0x00, 0x00, 0xfe, 0xff, 0x00, 0x00, 0x01, 0x00, 0x06, 0x00, 0x01, 0x00,
  0xfe, 0xff, 0xfc, 0xff, 0x00, 0x00, 0x00, 0x00, 0x01, 0x00, 0x01, 0x00,
  0x02, 0x00, 0xfe, 0xff, 0x05, 0x00, 0xfe, 0xff, 0xfd, 0xff, 0x01, 0x00,
  0x03, 0x00, 0x00, 0x00, 0x00, 0x00, 0x00, 0x00, 0x02, 0x00, 0xff, 0xff,
  0x01, 0x00, 0x02, 0x00, 0xfb, 0xff, 0xfe, 0xff, 0x01, 0x00, 0xfe, 0xff,
  0x03, 0x00, 0xff, 0xff, 0x00, 0x00, 0x01, 0x00, 0x01, 0x00, 0xf9, 0xff,
  0x01, 0x00, 0x00, 0x00, 0x01, 0x00, 0x00, 0x00, 0x00, 0x00, 0xfd, 0xff,
  0xfe, 0xff, 0x00, 0x00, 0x00, 0x00, 0x00, 0x00, 0x02, 0x00, 0xfe, 0xff,
  0x01, 0x00, 0x02, 0x00, 0xfe, 0xff, 0x04, 0x00, 0x01, 0x00, 0x03, 0x00,
  0x01, 0x00, 0xfe, 0xff, 0xff, 0xff, 0xfb, 0xff, 0xfe, 0xff, 0x02, 0x00,
  0x06, 0x00, 0xfb, 0xff, 0xfe, 0xff, 0x00, 0x00, 0x00, 0x00, 0x04, 0x00,
  0x00, 0x00, 0x00, 0x00, 0x00, 0x00, 0x01, 0x00, 0x00, 0x00, 0x00, 0x00,
  0x00, 0x00, 0xff, 0xff, 0xfd, 0xff, 0xff, 0xff, 0xff, 0xff, 0xfd, 0xff,
  0xfd, 0xff, 0xff, 0xff, 0x00, 0x00, 0x02, 0x00, 0x00, 0x00, 0x02, 0x00,
  0x09, 0x00, 0x00, 0x00, 0x00, 0x00, 0xff, 0xff, 0xff, 0xff, 0x00, 0x00,
  0xff, 0xff, 0x00, 0x00, 0x00, 0x00, 0x01, 0x00, 0x04, 0x00, 0xfe, 0xff,
  0xfc, 0xff, 0x00, 0x00, 0xff, 0xff, 0x04, 0x00, 0x02, 0x00, 0x01, 0x00,
  0x05, 0x00, 0x00, 0x00, 0xfc, 0xff, 0xf8, 0xff, 0x01, 0x00, 0x04, 0x00,
  0x04, 0x00, 0xfe, 0xff, 0x03, 0x00, 0x01, 0x00, 0x00, 0x00, 0xfe, 0xff,
  0x01, 0x00, 0xff, 0xff, 0x00, 0x00, 0xfd, 0xff, 0xfe, 0xff, 0x02, 0x00,
  0x02, 0x00, 0x04, 0x00, 0xff, 0xff, 0xfd, 0xff, 0xff, 0xff, 0xff, 0xff,
  0xfa, 0xff, 0xfb, 0xff, 0x06, 0x00, 0x00, 0x00, 0x02, 0x00, 0x00, 0x00,
  0x00, 0x00, 0x03, 0x00, 0x01, 0x00, 0x02, 0x00, 0x04, 0x00, 0xfe, 0xff,
  0x00, 0x00, 0x04, 0x00, 0x04, 0x00, 0xfd, 0xff, 0xff, 0xff, 0xff, 0xff,
  0x01, 0x00, 0xf9, 0xff, 0x01, 0x00, 0x02, 0x00, 0x00, 0x00, 0xfe, 0xff,
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
};
const unsigned int vocab_a_len = 16000;
