IowaScaledEngineering/ckt-defect/src/ckt-defect/vocab/include/axle.h

const unsigned char vocab_axle[] = {
  0x00, 0x00, 0x03, 0x00, 0x08, 0x00, 0x09, 0x00, 0x01, 0x00, 0xf2, 0xff,
  0xea, 0xff, 0xf2, 0xff, 0x00, 0x00, 0xf9, 0xff, 0xe6, 0xff, 0xec, 0xff,
  0x16, 0x00, 0x30, 0x00, 0x1a, 0x00, 0xea, 0xff, 0xca, 0xff, 0xb3, 0xff,
  0xaf, 0xff, 0xe1, 0xff, 0x68, 0x00, 0xd8, 0x00, 0xad, 0x00, 0xf0, 0xff,
  0x73, 0xff, 0xa1, 0xff, 0x0b, 0x00, 0x00, 0x00, 0x92, 0xff, 0x62, 0xff,
  0xfa, 0xff, 0xc0, 0x00, 0xbd, 0x00, 0xeb, 0xff, 0x6e, 0xff, 0x7f, 0xff,
  0x3f, 0xff, 0xee, 0xfe, 0x32, 0x00, 0x69, 0x02, 0xf1, 0x02, 0xc0, 0x00,
  0x4e, 0xfe, 0xa0, 0xfe, 0x40, 0x01, 0x3c, 0x02, 0xb3, 0xff, 0x1e, 0xfd,
  0x16, 0xfe, 0x7d, 0x00, 0xf9, 0x00, 0xdb, 0xff, 0x22, 0xff, 0xfb, 0xfd,
  0x73, 0xfc, 0xa8, 0xfc, 0x72, 0xff, 0x08, 0x02, 0xd2, 0x01, 0xbe, 0xff,
  0x2b, 0xff, 0xca, 0x00, 0x86, 0x02, 0x8d, 0x02, 0x25, 0x02, 0xba, 0x02,
  0x32, 0x03, 0xf2, 0x01, 0xc3, 0xff, 0x22, 0xfe, 0x18, 0xfe, 0xce, 0xfe,
  0x6b, 0xff, 0xb6, 0xff, 0xff, 0xff, 0x98, 0xff, 0x65, 0xfe, 0x10, 0xfd,
  0x4a, 0xfd, 0xf4, 0xfe, 0xde, 0x00, 0x40, 0x02, 0xf4, 0x02, 0xaa, 0x02,
  0x41, 0x02, 0x82, 0x01, 0x6b, 0x01, 0xd4, 0x01, 0x2b, 0x02, 0x9e, 0x01,
  0x23, 0x01, 0xb7, 0x00, 0x43, 0x00, 0x03, 0xff, 0x45, 0xfd, 0xa0, 0xfc,
  0x40, 0xfd, 0x73, 0xfd, 0xed, 0xfd, 0xb6, 0xfe, 0xff, 0xfe, 0xb6, 0xfd,
  0x3d, 0xfc, 0xd3, 0xfb, 0xb0, 0xfd, 0x69, 0xff, 0xe0, 0xff, 0x17, 0x00,
  0x25, 0x01, 0xd8, 0x01, 0x95, 0x01, 0x52, 0x00, 0x68, 0xff, 0x7d, 0xff,
  0xb6, 0x00, 0x9b, 0x01, 0xee, 0x01, 0xfe, 0x00, 0x1e, 0x00, 0x7b, 0xff,
  0xf1, 0xfe, 0x70, 0xfe, 0x5f, 0xff, 0x56, 0x01, 0xc9, 0x02, 0x25, 0x02,
  0x05, 0x01, 0x28, 0x01, 0x61, 0x02, 0xd7, 0x01, 0x95, 0x00, 0x2d, 0x00,
  0x63, 0x01, 0xed, 0x02, 0x3d, 0x03, 0x2a, 0x01, 0x34, 0xff, 0xad, 0xfe,
  0xcd, 0xfe, 0x38, 0xfe, 0xb1, 0xfd, 0xfb, 0xfd, 0x4b, 0xff, 0xcf, 0xff,
  0x31, 0xff, 0x06, 0xfe, 0xb9, 0xfd, 0x1f, 0xfe, 0x28, 0xff, 0x8f, 0xff,
  0x3f, 0x00, 0x99, 0x01, 0xb0, 0x02, 0xec, 0x01, 0x78, 0x00, 0x96, 0xff,
  0x02, 0x00, 0x12, 0x00, 0x92, 0x00, 0x4a, 0x01, 0x94, 0x01, 0xd3, 0x00,
  0xd8, 0xff, 0x0c, 0xff, 0xbc, 0xfe, 0xdf, 0xfd, 0xc9, 0xfc, 0x57, 0xfd,
  0x28, 0x00, 0x65, 0x02, 0xbf, 0x02, 0xfe, 0x00, 0x75, 0xff, 0xf2, 0xfe,
  0xe1, 0xff, 0xa3, 0x00, 0x68, 0x00, 0x62, 0xff, 0x75, 0xff, 0xa0, 0x00,
  0x1e, 0x03, 0xa5, 0x02, 0xac, 0xfe, 0x91, 0xfa, 0x32, 0xfb, 0x7d, 0xfe,
  0xa8, 0xff, 0x29, 0xff, 0xd3, 0xfe, 0x92, 0xff, 0x26, 0x00, 0x3b, 0x00,
  0x8b, 0x00, 0x31, 0x00, 0x66, 0x00, 0xf6, 0x01, 0xa6, 0x05, 0x64, 0x07,
  0xc8, 0x07, 0x10, 0x04, 0x09, 0xfd, 0x77, 0xf7, 0x75, 0xf8, 0xec, 0xfc,
  0x98, 0x02, 0x33, 0x0b, 0x2c, 0x16, 0x82, 0x1d, 0x54, 0x1f, 0x2a, 0x1a,
  0xf7, 0x07, 0xf5, 0xe5, 0x50, 0xcc, 0x5a, 0xd5, 0x68, 0xfd, 0xec, 0x17,
  0x43, 0x08, 0x0b, 0xe5, 0x8a, 0xd6, 0x49, 0xe0, 0x7d, 0xea, 0xa3, 0xe6,
  0x55, 0xe4, 0xe3, 0xf3, 0x82, 0x0d, 0x08, 0x1d, 0xe6, 0x1c, 0x60, 0x14,
  0xd9, 0x0e, 0x30, 0x0d, 0xf0, 0x08, 0xed, 0x00, 0x58, 0x02, 0x37, 0x13,
  0xd1, 0x24, 0xd7, 0x24, 0x06, 0x14, 0xd6, 0xff, 0xed, 0xf3, 0xdd, 0xee,
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
};
const unsigned int vocab_axle_len = 16418;
