IowaScaledEngineering/ckt-defect/src/ckt-defect/vocab/include/blocked.h

const unsigned char vocab_blocked[] = {
  0x00, 0x00, 0x02, 0x00, 0x06, 0x00, 0x0b, 0x00, 0x0f, 0x00, 0x0d, 0x00,
  0x0f, 0x00, 0x19, 0x00, 0x1d, 0x00, 0xf0, 0xff, 0xc9, 0xff, 0xbb, 0xff,
  0xbe, 0xff, 0xc4, 0xff, 0xe0, 0xff, 0xef, 0xff, 0xe7, 0xff, 0xee, 0xff,
  0xdf, 0xff, 0x81, 0xff, 0x61, 0xff, 0x5e, 0xff, 0x29, 0xff, 0xef, 0xfe,
  0x3f, 0xff, 0x7f, 0xff, 0x56, 0xff, 0x6b, 0xff, 0x9b, 0xff, 0xa3, 0xff,
  0xd7, 0xff, 0xb4, 0x00, 0xf5, 0x00, 0xbd, 0x00, 0xd2, 0x00, 0x3a, 0x01,
  0x80, 0x01, 0xbb, 0x01, 0x1b, 0x02, 0x24, 0x02, 0x0f, 0x02, 0x5d, 0x02,
  0xa7, 0x02, 0x83, 0x02, 0xf3, 0x01, 0x5f, 0x01, 0x03, 0x01, 0xbd, 0x00,
  0x63, 0x00, 0xd5, 0xff, 0xfe, 0xfe, 0x55, 0xfe, 0x29, 0xfe, 0x29, 0xfe,
  0xc3, 0xfd, 0x3d, 0xfd, 0xe4, 0xfc, 0x0e, 0xfd, 0x78, 0xfd, 0xd4, 0xfd,
  0xe5, 0xfd, 0xf0, 0xfd, 0x40, 0xfe, 0xb9, 0xfe, 0x17, 0xff, 0x71, 0xff,
  0xdb, 0xff, 0x2d, 0x00, 0x60, 0x00, 0xc3, 0x00, 0xf5, 0x00, 0x41, 0x01,
  0x91, 0x01, 0xb1, 0x01, 0x46, 0x01, 0x48, 0x01, 0xcb, 0x01, 0x18, 0x02,
  0x87, 0x01, 0xfa, 0x00, 0xf9, 0x00, 0x2b, 0x01, 0x2d, 0x01, 0xf3, 0x00,
  0x86, 0x00, 0x0c, 0x00, 0x16, 0x00, 0x6c, 0x00, 0x05, 0x00, 0x59, 0xff,
  0x30, 0xff, 0x5e, 0xff, 0x18, 0xff, 0xd2, 0xfe, 0xe1, 0xfe, 0xee, 0xfe,
  0xaf, 0xfe, 0x81, 0xfe, 0xb3, 0xfe, 0xf9, 0xfe, 0x02, 0xff, 0xe8, 0xfe,
  0xd7, 0xfe, 0xde, 0xfe, 0x2c, 0xff, 0xaa, 0xff, 0x98, 0xff, 0x42, 0xff,
  0x60, 0xff, 0x0c, 0x00, 0x89, 0x00, 0x65, 0x00, 0x18, 0x00, 0x41, 0x00,
  0xc4, 0x00, 0x1a, 0x01, 0x4c, 0x01, 0x23, 0x01, 0xc8, 0x00, 0xb7, 0x00,
  0x09, 0x01, 0x47, 0x01, 0xd9, 0x00, 0x57, 0x00, 0x50, 0x00, 0x8f, 0x00,
  0x85, 0x00, 0x8e, 0x00, 0x72, 0x00, 0xea, 0xff, 0xa0, 0xff, 0x20, 0x00,
  0x68, 0x00, 0x16, 0x00, 0xc0, 0xff, 0xb7, 0xff, 0xa0, 0xff, 0xa6, 0xff,
  0xe3, 0xff, 0xc4, 0xff, 0xf3, 0xfe, 0x7d, 0xfe, 0x0e, 0xff, 0x94, 0xff,
  0x51, 0xff, 0xfb, 0xfe, 0x06, 0xff, 0x40, 0xff, 0x8f, 0xff, 0x1e, 0x00,
  0x58, 0x00, 0xf1, 0xff, 0xee, 0xff, 0x3d, 0x00, 0x68, 0x00, 0x8f, 0x00,
  0xd9, 0x00, 0xcd, 0x00, 0x22, 0x00, 0xe3, 0xff, 0xa8, 0x00, 0x49, 0x01,
  0xfc, 0x00, 0x18, 0x00, 0x07, 0x00, 0x9d, 0x00, 0x17, 0x01, 0xd2, 0x00,
  0x0b, 0x00, 0xaf, 0xff, 0x1d, 0x00, 0x63, 0x00, 0x04, 0x00, 0xc7, 0xff,
  0x11, 0x00, 0xda, 0xff, 0x56, 0xff, 0x99, 0xff, 0x7b, 0x00, 0x94, 0x00,
  0xfd, 0xff, 0xb5, 0xff, 0x4b, 0x00, 0xdd, 0x00, 0xaa, 0x00, 0x61, 0x00,
  0x45, 0x00, 0x43, 0x00, 0xe9, 0x00, 0x33, 0x01, 0x77, 0x00, 0xba, 0xff,
  0xdc, 0xff, 0x59, 0x00, 0x78, 0x00, 0x00, 0x00, 0xf4, 0xff, 0xb1, 0xff,
  0x46, 0xff, 0x4d, 0xff, 0x74, 0xff, 0x7d, 0xfe, 0x6a, 0xfe, 0x58, 0xfe,
  0x0d, 0xff, 0xb3, 0xfe, 0xff, 0xfe, 0xd8, 0xff, 0xfe, 0x00, 0xcd, 0x00,
  0xb4, 0xff, 0x20, 0xff, 0x11, 0xff, 0x9b, 0xfe, 0x14, 0xfc, 0x92, 0xfa,
  0xe6, 0xf8, 0x60, 0xf9, 0x55, 0xfc, 0x44, 0x00, 0x76, 0x01, 0xb3, 0x01,
  0xf9, 0x08, 0x1c, 0x18, 0x45, 0x20, 0x00, 0x1b, 0x38, 0x15, 0xbf, 0x1a,
  0x24, 0x21, 0x49, 0x1a, 0xac, 0x0a, 0xaf, 0x01, 0xab, 0xff, 0x53, 0xfa,
  0xc4, 0xef, 0xb8, 0xe8, 0x9b, 0xe4, 0xbe, 0xdd, 0x1b, 0xd7, 0xae, 0xd7,
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
};
const unsigned int vocab_blocked_len = 18518;
