IowaScaledEngineering/ckt-defect/src/ckt-defect/vocab/include/defect.h

const unsigned char vocab_defect[] = {
  0x00, 0x00, 0xfe, 0xff, 0x00, 0x00, 0x04, 0x00, 0x0b, 0x00, 0x08, 0x00,
  0x05, 0x00, 0x08, 0x00, 0xef, 0xff, 0xbe, 0xff, 0xf7, 0xff, 0x9e, 0x00,
  0x22, 0x01, 0x82, 0x00, 0x1e, 0xfe, 0xda, 0xfe, 0xb2, 0x00, 0x40, 0xff,
  0x5b, 0xff, 0xdd, 0xff, 0x98, 0x01, 0x8d, 0xff, 0x5d, 0xff, 0xd7, 0x00,
  0xa2, 0x01, 0x8b, 0xff, 0x16, 0xff, 0xcb, 0x01, 0xe8, 0xff, 0xe1, 0xfd,
  0x77, 0xfe, 0x87, 0x00, 0x12, 0x01, 0x7b, 0xff, 0xce, 0x00, 0xfa, 0x00,
  0xae, 0xff, 0x7b, 0xfe, 0xdf, 0xfe, 0xa9, 0x00, 0xf2, 0x00, 0xbd, 0x00,
  0x4e, 0x01, 0x0e, 0xff, 0x6d, 0xfd, 0xc9, 0x00, 0x77, 0x00, 0xec, 0xfe,
  0x7c, 0x00, 0x52, 0x00, 0xbf, 0x00, 0xc2, 0x00, 0x8b, 0xff, 0x30, 0x01,
  0x0a, 0xfe, 0xae, 0xff, 0xf1, 0x01, 0xff, 0x00, 0x31, 0x02, 0x0a, 0xff,
  0x31, 0xfc, 0x4c, 0x01, 0x0c, 0x01, 0x5b, 0xff, 0xee, 0x01, 0xf6, 0x00,
  0xcf, 0xff, 0xbe, 0xff, 0xff, 0xfd, 0xd7, 0xfe, 0x20, 0x00, 0x88, 0x03,
  0x2a, 0xfd, 0x9c, 0xfe, 0x2e, 0x02, 0xfe, 0xfd, 0x2d, 0xfc, 0x13, 0x00,
  0x38, 0x01, 0x5f, 0x00, 0x71, 0x02, 0x66, 0xfe, 0xae, 0xfe, 0x9b, 0x00,
  0x81, 0x00, 0x77, 0xff, 0x40, 0x01, 0x50, 0xff, 0x08, 0x03, 0x1b, 0x01,
  0xcb, 0xfc, 0x3f, 0x02, 0x29, 0x01, 0x3f, 0xfe, 0x73, 0x03, 0xca, 0x02,
  0x29, 0xfa, 0x6e, 0x00, 0x8c, 0x02, 0x7c, 0xfe, 0x43, 0x02, 0x48, 0x02,
  0xa2, 0xfc, 0xb9, 0xfd, 0x2c, 0x02, 0xc1, 0xff, 0xc3, 0xfc, 0xbb, 0x02,
  0x4d, 0xfd, 0x9b, 0xfe, 0x22, 0x05, 0x1d, 0x00, 0xb8, 0xf7, 0x0e, 0x04,
  0x3b, 0x01, 0x5e, 0x00, 0x9b, 0x00, 0xa3, 0xfb, 0x7b, 0xff, 0x32, 0x03,
  0x64, 0x00, 0xad, 0xfe, 0xcc, 0xfe, 0x71, 0xff, 0x51, 0x03, 0x20, 0xfb,
  0x9d, 0x00, 0x02, 0x03, 0x2e, 0x01, 0xc1, 0xf9, 0x6f, 0xfe, 0x10, 0x04,
  0x56, 0x06, 0xb4, 0xfd, 0x9f, 0xfa, 0xa6, 0xff, 0x9d, 0x03, 0xf5, 0x04,
  0xf8, 0xf8, 0x70, 0xfd, 0x18, 0x03, 0x73, 0x05, 0x2e, 0xfd, 0x1b, 0x02,
  0x62, 0xfe, 0x49, 0xfc, 0x89, 0xff, 0x7a, 0x05, 0x25, 0xff, 0xed, 0xfe,
  0x59, 0x00, 0xfd, 0xfd, 0x2e, 0x00, 0x7d, 0x02, 0x23, 0x03, 0x42, 0xfb,
  0x9b, 0xfa, 0xf6, 0x01, 0x37, 0x05, 0xeb, 0x01, 0x1f, 0xf9, 0xda, 0x00,
  0x6e, 0x04, 0x54, 0xfd, 0x5b, 0xff, 0x55, 0x03, 0xc6, 0xfe, 0x99, 0xfd,
  0x2f, 0x01, 0x75, 0xfd, 0xeb, 0x01, 0xd4, 0x03, 0x0c, 0xfc, 0x68, 0xfa,
  0xa7, 0x06, 0xc6, 0x06, 0xfb, 0xfd, 0x22, 0xfc, 0x74, 0xfa, 0xd9, 0x01,
  0xb6, 0x08, 0x67, 0xfe, 0xf5, 0xf9, 0x51, 0x02, 0x9d, 0x00, 0x7d, 0x00,
  0x8b, 0xfd, 0xa2, 0x00, 0xab, 0x00, 0x60, 0xf8, 0x90, 0x05, 0xaf, 0x08,
  0xb5, 0xfb, 0x60, 0xfa, 0x6c, 0xfc, 0x79, 0x03, 0x7c, 0x05, 0x9b, 0x02,
  0xa5, 0xf9, 0xf2, 0xf8, 0xb6, 0x04, 0x90, 0x03, 0x61, 0xfe, 0x5e, 0x03,
  0x59, 0xfc, 0x35, 0xf7, 0x25, 0x04, 0x3f, 0x05, 0x67, 0x04, 0xbb, 0xf8,
  0x81, 0xff, 0xde, 0x08, 0xb0, 0x02, 0xc8, 0xfb, 0x44, 0x00, 0xb1, 0x04,
  0x3a, 0xfd, 0x07, 0xfe, 0x4b, 0x04, 0xb0, 0x02, 0x18, 0xfc, 0x6e, 0xfe,
  0x06, 0xfd, 0x84, 0xff, 0xc9, 0x0a, 0x3b, 0xfc, 0xee, 0xfa, 0x63, 0xfc,
  0xaf, 0x03, 0xc1, 0xff, 0x92, 0xfb, 0x06, 0x03, 0x08, 0xff, 0xe7, 0x01,
  0x36, 0xfc, 0x21, 0xfe, 0xfa, 0xfc, 0xcb, 0x01, 0x3f, 0xff, 0x7f, 0x03,
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
};
const unsigned int vocab_defect_len = 22332;
