IowaScaledEngineering/ckt-defect/src/ckt-defect/vocab/include/defects.h

const unsigned char vocab_defects[] = {
  0x00, 0x00, 0x01, 0x00, 0x0c, 0x00, 0xf8, 0xff, 0xed, 0xff, 0xf8, 0xff,
  0x07, 0x00, 0x0f, 0x00, 0xfa, 0xff, 0xfe, 0xff, 0x00, 0x00, 0x2f, 0x00,
  0x02, 0x00, 0xc2, 0xff, 0xd8, 0xff, 0x48, 0x00, 0x32, 0x00, 0xd0, 0xff,
  0xbd, 0xff, 0x1e, 0x00, 0x34, 0x00, 0xfd, 0xff, 0xe1, 0xff, 0x39, 0x00,
  0x31, 0x00, 0x43, 0x00, 0xc2, 0xff, 0x49, 0x01, 0xaa, 0x00, 0x22, 0xfd,
  0x73, 0xfc, 0x2d, 0x00, 0x0c, 0x03, 0x22, 0x01, 0xb2, 0xfe, 0x21, 0xff,
  0x83, 0x02, 0xe7, 0x00, 0xfc, 0xfe, 0x5a, 0xff, 0xf1, 0x01, 0x51, 0x01,
  0xde, 0xfe, 0xce, 0x00, 0x8c, 0x00, 0xe1, 0xfd, 0x26, 0xff, 0xd9, 0xff,
  0x27, 0x00, 0x8e, 0x02, 0x97, 0x00, 0xd6, 0xfd, 0x55, 0xfd, 0xab, 0xfc,
  0xdf, 0xfe, 0x82, 0x01, 0x11, 0x01, 0x66, 0xfe, 0x27, 0xff, 0x3a, 0x01,
  0x5a, 0xfc, 0x66, 0xff, 0xf6, 0x00, 0xe8, 0x02, 0x0e, 0x01, 0x6b, 0xfc,
  0x55, 0x00, 0x41, 0x08, 0x76, 0x01, 0x81, 0xf7, 0xcc, 0x05, 0xf9, 0x03,
  0x9f, 0xfe, 0xb2, 0x00, 0x5b, 0xff, 0x18, 0x07, 0x04, 0xff, 0x1c, 0xfa,
  0xfe, 0x01, 0x8a, 0x01, 0x99, 0x07, 0x52, 0xfb, 0xf5, 0xf8, 0x1c, 0xff,
  0xdc, 0x01, 0x66, 0x01, 0x70, 0x00, 0x75, 0xfe, 0x7c, 0xfd, 0x78, 0xfb,
  0x38, 0x04, 0xdc, 0xfb, 0xb8, 0x00, 0xaa, 0x07, 0x40, 0xf9, 0xfd, 0xfa,
  0xe5, 0x01, 0x90, 0x04, 0x76, 0x01, 0x63, 0xfe, 0xc0, 0xf7, 0x19, 0x02,
  0x23, 0x08, 0x0d, 0x05, 0x36, 0xfe, 0x72, 0xf7, 0x65, 0x01, 0xf3, 0xfe,
  0x28, 0x07, 0x80, 0x04, 0xb9, 0xf7, 0xfa, 0xfd, 0x8f, 0x03, 0x78, 0x01,
  0x82, 0xf8, 0xc8, 0x02, 0x8b, 0x0b, 0x06, 0xf7, 0x94, 0xfb, 0xac, 0x05,
  0x5e, 0xf7, 0x97, 0x09, 0x5e, 0x0b, 0xcd, 0xf0, 0xd4, 0xf4, 0x01, 0x11,
  0x9b, 0x04, 0xa4, 0xf7, 0x92, 0x02, 0x8f, 0x03, 0x44, 0xf6, 0x1c, 0x03,
  0x1d, 0x04, 0x23, 0xfb, 0x7a, 0x04, 0x44, 0x08, 0xe3, 0xf2, 0x50, 0xf5,
  0x06, 0x06, 0xca, 0x01, 0x10, 0xfc, 0xcc, 0x03, 0x68, 0x02, 0x90, 0xfa,
  0xbe, 0x02, 0xcf, 0xfa, 0xc9, 0xfa, 0xdb, 0x03, 0xf3, 0x06, 0x05, 0x02,
  0x7d, 0xfd, 0x29, 0xfc, 0x32, 0xfd, 0x81, 0x05, 0x61, 0x04, 0x88, 0xfd,
  0x3e, 0xfe, 0xb2, 0x07, 0x9e, 0x03, 0x4b, 0xfa, 0x87, 0x02, 0x84, 0x08,
  0xa3, 0xf9, 0x94, 0xfd, 0x0b, 0x08, 0xc4, 0x00, 0x2e, 0xf8, 0xd1, 0x04,
  0xad, 0x03, 0xf9, 0xfb, 0x41, 0xf9, 0xef, 0x03, 0x3e, 0x03, 0x91, 0xfa,
  0x9f, 0xff, 0xef, 0x00, 0xd0, 0xf8, 0x09, 0xfd, 0xef, 0x03, 0x56, 0x01,
  0x99, 0x00, 0xe5, 0xf8, 0x32, 0x00, 0xf9, 0x01, 0x1a, 0xfb, 0x21, 0xfe,
  0x1a, 0x03, 0x0b, 0x09, 0x89, 0x00, 0xfb, 0xfb, 0x8c, 0xf7, 0xab, 0xff,
  0x13, 0x0d, 0xa0, 0x03, 0xd8, 0xf9, 0xbd, 0xfb, 0x21, 0xff, 0xc1, 0xff,
  0xad, 0x09, 0x23, 0x04, 0x75, 0xf7, 0x82, 0x00, 0x10, 0x01, 0xb2, 0xfb,
  0xb1, 0x01, 0xa2, 0x10, 0x38, 0x02, 0x6a, 0xee, 0xa6, 0xf9, 0x5c, 0x09,
  0x6d, 0x0a, 0xbd, 0x01, 0x99, 0xfc, 0xdb, 0xfa, 0x26, 0xfa, 0x08, 0x07,
  0x8c, 0xfd, 0xc5, 0xfd, 0xcd, 0x09, 0x21, 0xfa, 0x45, 0xf5, 0xfe, 0x02,
  0xfe, 0x04, 0xd1, 0xfe, 0xc1, 0xfa, 0xef, 0xfd, 0x1a, 0x00, 0x6d, 0xfe,
  0xc9, 0x01, 0xaa, 0x02, 0x26, 0xfa, 0xda, 0xfa, 0x22, 0x03, 0x17, 0x06,
  0x70, 0xfd, 0x74, 0xfb, 0x8d, 0x05, 0xa0, 0xfc, 0x12, 0xfc, 0x09, 0x0a,
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
};
const unsigned int vocab_defects_len = 28338;
