IowaScaledEngineering/ckt-defect/src/ckt-defect/vocab/include/degrees.h

const unsigned char vocab_degrees[] = {
  0x00, 0x00, 0x00, 0x00, 0xfb, 0xff, 0xfe, 0xff, 0x05, 0x00, 0x09, 0x00,
  0xf9, 0xff, 0xfa, 0xff, 0x16, 0x00, 0x1c, 0x00, 0xe2, 0xff, 0xd3, 0xff,
  0x13, 0x00, 0x3a, 0x00, 0xef, 0xff, 0x6f, 0x00, 0xcc, 0x00, 0xc1, 0xfe,
  0xd7, 0xfd, 0x34, 0xff, 0x11, 0x02, 0x86, 0x01, 0xe8, 0xfe, 0x28, 0xfe,
  0x4e, 0x01, 0xc6, 0x02, 0xec, 0xff, 0xb5, 0xfd, 0x11, 0xff, 0xbe, 0x02,
  0x0c, 0x03, 0x56, 0xff, 0xb9, 0xfc, 0xf4, 0xfd, 0x50, 0x00, 0xd5, 0x00,
  0xe2, 0xff, 0x2f, 0x00, 0xf8, 0xfe, 0xfe, 0xff, 0x60, 0x00, 0xf3, 0xff,
  0x16, 0xff, 0x77, 0x00, 0xd0, 0x01, 0x38, 0xff, 0x2e, 0x00, 0xaf, 0x00,
  0xf2, 0x01, 0x26, 0xfb, 0x42, 0xff, 0x22, 0x02, 0x20, 0x07, 0x60, 0xfb,
  0x1d, 0xfc, 0xed, 0x00, 0xa3, 0x01, 0xc2, 0x0a, 0xa5, 0x00, 0x57, 0xfd,
  0xde, 0xfc, 0x1e, 0xfd, 0x23, 0xfe, 0xcf, 0xfe, 0x39, 0xfc, 0x60, 0xfc,
  0x1f, 0x01, 0x85, 0x04, 0x60, 0xff, 0xbc, 0x04, 0x08, 0x03, 0xeb, 0xff,
  0x8f, 0xf9, 0xdf, 0xf9, 0x6f, 0xfe, 0x86, 0x01, 0xfb, 0x05, 0xe4, 0x06,
  0xf1, 0xf5, 0x0b, 0xf4, 0x76, 0x05, 0x3f, 0x0a, 0xf1, 0xff, 0x34, 0xf9,
  0x98, 0x00, 0x74, 0x06, 0xed, 0x07, 0xd5, 0xfc, 0xfe, 0xfa, 0xf9, 0xfc,
  0x1a, 0x09, 0x36, 0x03, 0x09, 0xfe, 0x91, 0xfc, 0xba, 0xfe, 0xd5, 0x09,
  0x7f, 0xfd, 0xda, 0xf9, 0xa1, 0xf6, 0x05, 0x0d, 0x4f, 0x0c, 0x74, 0xfa,
  0x05, 0xf3, 0xdb, 0x01, 0x7b, 0x01, 0x8f, 0x08, 0xb9, 0xf6, 0x8b, 0xfc,
  0x77, 0x00, 0xfb, 0x01, 0x0c, 0xf8, 0x46, 0x00, 0xe9, 0xfb, 0x79, 0xff,
  0xa0, 0x01, 0x52, 0xff, 0x0a, 0x01, 0x7d, 0x03, 0x6b, 0x05, 0xae, 0x07,
  0xd3, 0xf8, 0x1a, 0xf7, 0x22, 0x02, 0x28, 0x02, 0xf7, 0x0c, 0xa9, 0xf9,
  0xd9, 0x03, 0xdf, 0xfd, 0x26, 0xf5, 0x4a, 0x02, 0xa2, 0x0a, 0x9e, 0xfb,
  0x10, 0xfd, 0x2a, 0x04, 0xed, 0x05, 0x18, 0xfb, 0x00, 0xf6, 0x63, 0x07,
  0x12, 0x05, 0x00, 0x00, 0xd1, 0xf0, 0x89, 0x08, 0x81, 0x10, 0x14, 0xfb,
  0xde, 0xf0, 0x09, 0xff, 0xae, 0xfa, 0xa4, 0x0d, 0x6d, 0xef, 0xd6, 0x08,
  0xb2, 0x11, 0xc7, 0xf1, 0xdb, 0xf4, 0xaf, 0xf5, 0x5d, 0x0e, 0xef, 0x0e,
  0xdd, 0xed, 0xbf, 0xfb, 0x6a, 0x0f, 0x54, 0x0a, 0xcb, 0xf3, 0xd4, 0xf8,
  0x33, 0x0d, 0x0f, 0x04, 0x2b, 0xf7, 0x32, 0xfd, 0x69, 0xfa, 0x6c, 0x08,
  0xd5, 0x15, 0x86, 0xf3, 0x33, 0xfc, 0xb7, 0xef, 0x99, 0xf8, 0x4c, 0x0e,
  0xd7, 0x04, 0xfd, 0x20, 0x71, 0xe9, 0x6c, 0xe7, 0x82, 0x01, 0x45, 0x10,
  0x44, 0x12, 0x07, 0xd6, 0x00, 0x0d, 0x2b, 0x1a, 0x80, 0xf2, 0xdb, 0xe8,
  0x3e, 0x12, 0xec, 0x16, 0x45, 0xef, 0x9a, 0xe0, 0x7a, 0xf9, 0x69, 0x26,
  0x73, 0x12, 0xf6, 0xf7, 0x2e, 0xf0, 0xfe, 0xec, 0x09, 0xf1, 0x63, 0x10,
  0xd1, 0x20, 0x60, 0x08, 0x99, 0xdb, 0xc6, 0x0a, 0xe3, 0xf9, 0x12, 0x03,
  0x52, 0xf9, 0xab, 0xeb, 0x94, 0x21, 0xaf, 0xff, 0xc0, 0xff, 0xc1, 0xda,
  0x15, 0x18, 0xb6, 0x2d, 0x85, 0xdb, 0x5b, 0xdf, 0xce, 0x07, 0xdb, 0x22,
  0xcd, 0x18, 0xbe, 0xdc, 0xa0, 0xf4, 0x33, 0x11, 0x41, 0x0c, 0xaf, 0xed,
  0xb4, 0xed, 0x4b, 0x05, 0xf1, 0x1e, 0x79, 0x1e, 0x89, 0xe3, 0x73, 0xeb,
  0x14, 0xdd, 0x61, 0x24, 0x59, 0x11, 0x6c, 0x00, 0x1c, 0xdc, 0x22, 0x10,
  0x60, 0x31, 0x43, 0xdc, 0x24, 0xdf, 0xa7, 0xf0, 0xea, 0x23, 0x78, 0x15,
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
};
const unsigned int vocab_degrees_len = 24542;
