IowaScaledEngineering/ckt-defect/src/ckt-defect/vocab/include/detected.h

const unsigned char vocab_detected[] = {
  0x00, 0x00, 0x00, 0x00, 0x01, 0x00, 0xff, 0xff, 0x00, 0x00, 0xff, 0xff,
  0x01, 0x00, 0x05, 0x00, 0x00, 0x00, 0x01, 0x00, 0x01, 0x00, 0xfb, 0xff,
  0xec, 0xff, 0xfd, 0xff, 0x03, 0x00, 0x0d, 0x00, 0x0a, 0x00, 0xec, 0xff,
  0xfd, 0xff, 0xf2, 0xff, 0xf0, 0xff, 0x0a, 0x00, 0xfd, 0xff, 0x21, 0x00,
  0x31, 0x00, 0xda, 0xff, 0xce, 0xff, 0x16, 0x00, 0xf9, 0xff, 0x03, 0x00,
  0x21, 0x00, 0xe8, 0xff, 0xff, 0xff, 0x1b, 0x00, 0x27, 0x00, 0xc2, 0xff,
  0x13, 0x00, 0xfd, 0xff, 0xf6, 0xff, 0x3f, 0x00, 0x3a, 0x00, 0x00, 0x00,
  0x02, 0x00, 0xd6, 0xff, 0x4b, 0x00, 0xf9, 0xff, 0xc9, 0xff, 0x16, 0x00,
  0xb2, 0xff, 0x13, 0x00, 0xf3, 0xff, 0xf7, 0xff, 0x0d, 0x00, 0xcd, 0xff,
  0xee, 0xff, 0x61, 0xff, 0xd0, 0xff, 0x01, 0x00, 0x0c, 0x00, 0x49, 0x00,
  0x06, 0x00, 0x01, 0x00, 0x08, 0x00, 0x3f, 0x00, 0xee, 0xff, 0xf3, 0xff,
  0xe6, 0xff, 0x28, 0x00, 0x4b, 0x00, 0x75, 0x00, 0xf2, 0xff, 0x45, 0x00,
  0xd5, 0xff, 0xc7, 0xff, 0x76, 0x00, 0xf3, 0xff, 0x7b, 0x00, 0x36, 0x00,
  0x9d, 0xff, 0xb9, 0xff, 0x24, 0xff, 0x9e, 0xff, 0x96, 0xff, 0xd1, 0xff,
  0xf7, 0xff, 0xab, 0xff, 0x09, 0x01, 0x67, 0x00, 0x4d, 0x00, 0xfb, 0xff,
  0x0c, 0xff, 0x2d, 0x00, 0x5e, 0x00, 0xb9, 0x00, 0x74, 0x01, 0x50, 0xff,
  0x27, 0xff, 0x46, 0x00, 0xdc, 0xff, 0x8d, 0xff, 0x34, 0x00, 0xf2, 0xff,
  0x47, 0x00, 0x9e, 0x00, 0xb7, 0xff, 0xbe, 0xff, 0xf7, 0xff, 0x0d, 0xff,
  0xba, 0xff, 0x5b, 0xff, 0x9c, 0x00, 0x5a, 0x01, 0x2e, 0x00, 0xf4, 0xff,
  0x72, 0xff, 0x80, 0xfe, 0x55, 0xff, 0x82, 0x00, 0xcd, 0xff, 0x66, 0x00,
  0x36, 0x01, 0xc3, 0xff, 0xf1, 0x01, 0xfc, 0xff, 0x06, 0xfd, 0x5b, 0x00,
  0x05, 0x00, 0x85, 0xff, 0xce, 0x02, 0x26, 0x00, 0xbc, 0xfe, 0xef, 0x00,
  0x5d, 0xff, 0xd1, 0xfe, 0x10, 0x00, 0x4a, 0x01, 0x45, 0xff, 0x79, 0x00,
  0xd3, 0xff, 0x68, 0xff, 0x1e, 0x01, 0x34, 0x00, 0xf4, 0xfd, 0xe8, 0x00,
  0x0d, 0xff, 0x6f, 0x00, 0xa5, 0x01, 0x2f, 0x00, 0x38, 0x00, 0x63, 0xfe,
  0x6b, 0x00, 0x6b, 0xff, 0x84, 0x01, 0x63, 0x00, 0x28, 0xfe, 0x48, 0x00,
  0xb3, 0x00, 0xee, 0xff, 0xa2, 0xff, 0xba, 0xff, 0xf6, 0xfd, 0x35, 0x00,
  0x7e, 0x02, 0xca, 0x00, 0x6a, 0xfe, 0xec, 0x01, 0xec, 0xfe, 0x41, 0xfe,
  0xe9, 0xfe, 0xc2, 0xff, 0xd7, 0x02, 0xce, 0x00, 0xfd, 0xfe, 0x22, 0xff,
  0x75, 0x00, 0xa6, 0x01, 0xd7, 0xfd, 0x26, 0xfe, 0x87, 0x02, 0x8a, 0x00,
  0x1b, 0xfe, 0x07, 0x02, 0x71, 0xfe, 0x79, 0x00, 0x56, 0x01, 0x16, 0xff,
  0x38, 0xfe, 0x7d, 0x01, 0x41, 0x02, 0x05, 0xff, 0x43, 0x00, 0x11, 0x00,
  0xfc, 0xfe, 0xe2, 0xfe, 0xcd, 0x02, 0xbb, 0xff, 0x05, 0xfd, 0x2e, 0x01,
  0x50, 0xff, 0x42, 0x00, 0xcb, 0xff, 0xc1, 0xff, 0xca, 0x01, 0x3d, 0x00,
  0x76, 0xff, 0xab, 0xff, 0x1e, 0xff, 0x19, 0x02, 0x38, 0x00, 0x91, 0xfc,
  0x3b, 0x03, 0xb0, 0xfc, 0x69, 0xff, 0x40, 0x02, 0x63, 0x02, 0xb2, 0x01,
  0xd7, 0xf9, 0x84, 0x03, 0xdc, 0xfe, 0x07, 0x00, 0xb5, 0xfb, 0x14, 0x01,
  0x67, 0x03, 0xe3, 0xfa, 0x94, 0x01, 0x3f, 0x05, 0xcc, 0xfe, 0x9c, 0xfd,
  0xe3, 0x00, 0x12, 0xfe, 0x1d, 0x01, 0xd6, 0xff, 0xec, 0xfe, 0x57, 0x06,
  0xb3, 0x03, 0x87, 0x00, 0x7c, 0xfe, 0xcc, 0xfc, 0x3b, 0xff, 0xd3, 0xfe,
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
};
const unsigned int vocab_detected_len = 23838;
