IowaScaledEngineering/ckt-defect/src/ckt-defect/vocab/include/detector.h

const unsigned char vocab_detector[] = {
  0x00, 0x00, 0x00, 0x00, 0xfd, 0xff, 0xf9, 0xff, 0xfa, 0xff, 0xfd, 0xff,
  0xfc, 0xff, 0xfb, 0xff, 0xfd, 0xff, 0x00, 0x00, 0x06, 0x00, 0x11, 0x00,
  0x15, 0x00, 0x07, 0x00, 0xf0, 0xff, 0xe7, 0xff, 0x09, 0x00, 0x36, 0x00,
  0x3c, 0x00, 0x10, 0x00, 0xdd, 0xff, 0xe1, 0xff, 0x05, 0x00, 0x23, 0x00,
  0x26, 0x00, 0x15, 0x00, 0x08, 0x00, 0x15, 0x00, 0x2d, 0x00, 0xf6, 0xff,
  0x82, 0xff, 0x42, 0xff, 0x7d, 0xff, 0xee, 0xff, 0x06, 0x00, 0xe6, 0xff,
  0xca, 0xff, 0xf7, 0xff, 0x12, 0x00, 0xe3, 0xff, 0xac, 0xff, 0xe0, 0xff,
  0x51, 0x00, 0x7e, 0x00, 0x60, 0x00, 0x38, 0x00, 0xf2, 0xff, 0x04, 0x00,
  0x38, 0x00, 0x42, 0x00, 0xdc, 0xff, 0xe0, 0xff, 0xc3, 0x00, 0x66, 0x01,
  0x70, 0x00, 0xf9, 0xfe, 0x53, 0xff, 0xae, 0x00, 0xf2, 0x00, 0xcc, 0xff,
  0x27, 0xff, 0x31, 0x00, 0xfb, 0x00, 0x41, 0x00, 0xdd, 0xfe, 0x4e, 0xff,
  0x2f, 0x00, 0xc3, 0xff, 0x21, 0xff, 0x91, 0xff, 0x78, 0x00, 0xbd, 0x00,
  0x21, 0x00, 0x6b, 0xff, 0xb6, 0xfe, 0x4d, 0xff, 0x19, 0x00, 0x70, 0x00,
  0xf2, 0xff, 0x01, 0xff, 0x2a, 0x00, 0x1e, 0x01, 0x47, 0x00, 0x31, 0xff,
  0x13, 0xff, 0x6f, 0x00, 0xff, 0x00, 0x90, 0x00, 0xbf, 0xff, 0x7e, 0x00,
  0xdd, 0x00, 0x1a, 0x00, 0xe0, 0xfe, 0xe7, 0xfe, 0xa0, 0x01, 0x4f, 0x02,
  0xe5, 0xff, 0xa9, 0xfe, 0x13, 0x00, 0x62, 0x01, 0x43, 0x01, 0x55, 0xff,
  0xd3, 0xfd, 0x73, 0xff, 0xd6, 0x01, 0x7e, 0x01, 0x33, 0xff, 0x22, 0xfe,
  0x61, 0xff, 0xca, 0x00, 0x0d, 0x00, 0xa6, 0xfe, 0x0c, 0xff, 0x54, 0x01,
  0x26, 0x01, 0x29, 0xfe, 0x91, 0xfe, 0x11, 0x00, 0x62, 0x00, 0xb9, 0xff,
  0xc1, 0xfe, 0x2d, 0x00, 0xf0, 0x00, 0x22, 0x01, 0xcc, 0xff, 0xe2, 0xfd,
  0x84, 0xfe, 0x36, 0x01, 0xf9, 0x01, 0x57, 0x00, 0x94, 0xff, 0x0f, 0x01,
  0xc9, 0x02, 0x6f, 0x00, 0xdf, 0xfd, 0xa9, 0xfe, 0x3b, 0x01, 0xee, 0x00,
  0x2e, 0xff, 0xe4, 0x00, 0xa1, 0x02, 0x32, 0x01, 0x38, 0xfe, 0x2f, 0xfd,
  0x36, 0x00, 0xa5, 0x01, 0x77, 0xff, 0xa7, 0xff, 0xca, 0x00, 0x5b, 0x00,
  0x5f, 0xff, 0xff, 0xfe, 0x82, 0xfe, 0xb5, 0xfe, 0xc5, 0xff, 0xb3, 0x00,
  0x38, 0x00, 0x2a, 0xff, 0xe0, 0xfe, 0xb2, 0xff, 0xb1, 0xfe, 0x1d, 0xfe,
  0x3d, 0xff, 0xb6, 0x01, 0x33, 0x01, 0xf2, 0xfe, 0xf9, 0xff, 0x96, 0x01,
  0x60, 0x00, 0x0e, 0x00, 0x48, 0xff, 0x52, 0x01, 0x9b, 0x04, 0x54, 0x03,
  0x1f, 0xfe, 0xc7, 0xfc, 0x20, 0x00, 0x2c, 0x02, 0x29, 0x01, 0xb6, 0xff,
  0xe1, 0x01, 0x18, 0x03, 0x12, 0x00, 0x77, 0xfe, 0xc5, 0xff, 0xa6, 0xff,
  0x4c, 0xfd, 0xa5, 0xfd, 0x0f, 0x02, 0x4e, 0x03, 0xe8, 0xfe, 0x71, 0xfc,
  0xab, 0xfd, 0x8e, 0xfd, 0x46, 0xfd, 0xb3, 0xfe, 0x5b, 0x02, 0xe2, 0x01,
  0xab, 0xfe, 0x8e, 0xfe, 0x24, 0x00, 0x8e, 0x00, 0x6a, 0xff, 0x3e, 0xfd,
  0xe6, 0xfe, 0xc7, 0x02, 0x3e, 0x03, 0x4d, 0x00, 0xa2, 0x00, 0x2c, 0xfe,
  0xa1, 0xfe, 0xe2, 0x02, 0x7a, 0x02, 0x44, 0x02, 0x18, 0x03, 0xac, 0x03,
  0xfa, 0xfd, 0xc2, 0xfb, 0xf1, 0x00, 0xf4, 0x02, 0x75, 0x01, 0x46, 0xfd,
  0x16, 0xff, 0x6f, 0x02, 0xc7, 0x00, 0xe6, 0xff, 0x94, 0xfd, 0x1e, 0xfb,
  0x73, 0xfb, 0x83, 0x01, 0x0e, 0x04, 0xd4, 0xff, 0x67, 0xfd, 0x69, 0xff,
  0x71, 0xfe, 0x9f, 0xfc, 0xfd, 0xff, 0x79, 0x02, 0x43, 0x00, 0x5b, 0xfd,
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
};
const unsigned int vocab_detector_len = 22838;
