IowaScaledEngineering/ckt-defect/src/ckt-defect/vocab/include/dragging.h

const unsigned char vocab_dragging[] = {
  0x00, 0x00, 0xff, 0xff, 0xff, 0xff, 0x00, 0x00, 0x04, 0x00, 0x08, 0x00,
  0x0a, 0x00, 0x06, 0x00, 0x00, 0x00, 0xff, 0xff, 0xfe, 0xff, 0xf9, 0xff,
  0xf1, 0xff, 0xf2, 0xff, 0x00, 0x00, 0x08, 0x00, 0x0d, 0x00, 0x0d, 0x00,
  0x04, 0x00, 0xf3, 0xff, 0xf2, 0xff, 0xf0, 0xff, 0x04, 0x00, 0x12, 0x00,
  0x06, 0x00, 0xfd, 0xff, 0x02, 0x00, 0x0a, 0x00, 0x11, 0x00, 0x16, 0x00,
  0xfb, 0xff, 0xe5, 0xff, 0xda, 0xff, 0xe8, 0xff, 0xfd, 0xff, 0xfb, 0xff,
  0xff, 0xff, 0x00, 0x00, 0x0f, 0x00, 0x1c, 0x00, 0x19, 0x00, 0x2c, 0x00,
  0x1a, 0x00, 0xfb, 0xff, 0xe2, 0xff, 0xd4, 0xff, 0xe7, 0xff, 0xef, 0xff,
  0xde, 0xff, 0xee, 0xff, 0x0c, 0x00, 0x27, 0x00, 0x45, 0x00, 0x13, 0x00,
  0xe7, 0xff, 0xd1, 0xff, 0xac, 0xff, 0xcc, 0xff, 0x15, 0x00, 0x66, 0x00,
  0xba, 0x00, 0x8b, 0x00, 0xfc, 0xff, 0x6b, 0xff, 0x3b, 0xff, 0x4f, 0xff,
  0xaf, 0xff, 0x32, 0x00, 0x94, 0x00, 0x8c, 0x00, 0xfd, 0xff, 0xa0, 0xff,
  0xa9, 0xff, 0xe3, 0xff, 0x83, 0x00, 0xb4, 0x00, 0x8e, 0x00, 0x3b, 0x00,
  0x0d, 0x00, 0xdb, 0xff, 0x90, 0xff, 0x5e, 0xff, 0x23, 0xff, 0x8b, 0xff,
  0x29, 0x00, 0xf0, 0x00, 0x64, 0x01, 0x09, 0x01, 0x0a, 0x00, 0xdc, 0xfe,
  0x1b, 0xfe, 0x23, 0xfe, 0x10, 0xff, 0x57, 0x00, 0xa8, 0x01, 0x2f, 0x02,
  0xaf, 0x01, 0x3f, 0x00, 0xf8, 0xfe, 0xfc, 0xfd, 0x0d, 0xfe, 0x0f, 0xff,
  0xb5, 0x00, 0xb9, 0x01, 0x12, 0x02, 0x78, 0x01, 0x5b, 0x00, 0x3b, 0xff,
  0x24, 0xfe, 0x42, 0xfe, 0x71, 0xff, 0x7c, 0x00, 0xec, 0x00, 0xc6, 0x00,
  0x0c, 0x00, 0x43, 0xff, 0x9e, 0xff, 0x57, 0x00, 0xf2, 0x00, 0x91, 0x01,
  0xba, 0x00, 0xc0, 0xff, 0x40, 0xff, 0x80, 0xfe, 0x21, 0xfe, 0xeb, 0xfe,
  0x71, 0xff, 0x23, 0x00, 0x8b, 0x01, 0x2c, 0x02, 0xe2, 0x01, 0x81, 0x00,
  0x7c, 0xfe, 0xdf, 0xfd, 0x67, 0xfe, 0xfe, 0xff, 0xf0, 0x00, 0x08, 0x01,
  0x66, 0x01, 0x39, 0x01, 0x94, 0x00, 0xa5, 0xff, 0x23, 0xff, 0xa8, 0xfe,
  0x90, 0xff, 0xa2, 0xff, 0xdf, 0x00, 0xe6, 0x01, 0xe7, 0x01, 0x6b, 0x00,
  0x94, 0xfd, 0x2c, 0xfc, 0x92, 0xfd, 0x40, 0xff, 0x8e, 0x00, 0x68, 0x01,
  0xd0, 0x01, 0x36, 0x02, 0xc9, 0xff, 0x76, 0xfe, 0x9a, 0xfe, 0x2f, 0xff,
  0x9f, 0xfe, 0x2b, 0x01, 0xfe, 0x02, 0x12, 0x02, 0x0b, 0x00, 0x91, 0xfe,
  0x3d, 0xfe, 0xcc, 0xff, 0x0b, 0x00, 0xc5, 0xff, 0x55, 0x00, 0x71, 0x01,
  0x83, 0x00, 0xf4, 0xfe, 0x84, 0xff, 0x27, 0xfe, 0x05, 0xff, 0xb5, 0x01,
  0xd0, 0x01, 0x74, 0x03, 0x15, 0x03, 0xed, 0x01, 0xb4, 0xfb, 0xd4, 0xfe,
  0xe5, 0xff, 0x7f, 0xfd, 0x5c, 0x03, 0xd8, 0xfd, 0x31, 0xfd, 0x80, 0x00,
  0xd9, 0xfb, 0x16, 0x01, 0xaa, 0x06, 0x91, 0x07, 0x3c, 0x01, 0x30, 0xf8,
  0xa5, 0xf8, 0x27, 0xfa, 0xf4, 0xfe, 0x28, 0x01, 0x84, 0x03, 0xdf, 0x03,
  0x02, 0x05, 0xb8, 0xff, 0x9a, 0xfb, 0xe9, 0xff, 0x7a, 0xf9, 0x8e, 0x00,
  0x74, 0x03, 0xf2, 0x05, 0xa3, 0x05, 0x11, 0xfd, 0x5d, 0xf8, 0x6e, 0xfc,
  0x3b, 0x03, 0x0e, 0x04, 0xb7, 0x04, 0xc6, 0x01, 0x3b, 0xff, 0xd8, 0xff,
  0xbb, 0xfd, 0x15, 0xf6, 0x80, 0xfc, 0xd3, 0x0b, 0xc5, 0x04, 0xe4, 0x01,
  0x94, 0xfd, 0xd0, 0xfe, 0x08, 0xff, 0x24, 0xf7, 0xfd, 0xf5, 0xc4, 0x01,
  0xc1, 0x07, 0x26, 0x10, 0xd7, 0x0e, 0x53, 0xf8, 0xbe, 0xf3, 0x0a, 0xf4,
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
};
const unsigned int vocab_dragging_len = 17302;
