IowaScaledEngineering/ckt-defect/src/ckt-defect/vocab/include/east.h

const unsigned char vocab_east[] = {
  0x00, 0x00, 0x00, 0x00, 0x01, 0x00, 0x00, 0x00, 0x00, 0x00, 0xfd, 0xff,
  0xfb, 0xff, 0xf5, 0xff, 0xf8, 0xff, 0xfa, 0xff, 0x00, 0x00, 0x02, 0x00,
  0x02, 0x00, 0x02, 0x00, 0x04, 0x00, 0x03, 0x00, 0x02, 0x00, 0x00, 0x00,
  0x02, 0x00, 0x02, 0x00, 0x06, 0x00, 0x06, 0x00, 0x05, 0x00, 0x00, 0x00,
  0xff, 0xff, 0xff, 0xff, 0x03, 0x00, 0xff, 0xff, 0x05, 0x00, 0x03, 0x00,
  0x02, 0x00, 0x03, 0x00, 0x04, 0x00, 0x03, 0x00, 0xff, 0xff, 0xfe, 0xff,
  0x05, 0x00, 0x03, 0x00, 0xff, 0xff, 0xfb, 0xff, 0xfc, 0xff, 0xfb, 0xff,
  0x01, 0x00, 0xfd, 0xff, 0xff, 0xff, 0xfc, 0xff, 0xf9, 0xff, 0x08, 0x00,
  0x04, 0x00, 0xf8, 0xff, 0xf7, 0xff, 0xf9, 0xff, 0x07, 0x00, 0x02, 0x00,
  0xf5, 0xff, 0xfc, 0xff, 0xff, 0xff, 0xfe, 0xff, 0x08, 0x00, 0xf8, 0xff,
  0xfa, 0xff, 0x00, 0x00, 0xfe, 0xff, 0x09, 0x00, 0x04, 0x00, 0xf5, 0xff,
  0x00, 0x00, 0x06, 0x00, 0x00, 0x00, 0x04, 0x00, 0x02, 0x00, 0x05, 0x00,
  0x0e, 0x00, 0x05, 0x00, 0x03, 0x00, 0x08, 0x00, 0x02, 0x00, 0x05, 0x00,
  0x05, 0x00, 0x00, 0x00, 0x03, 0x00, 0x03, 0x00, 0x08, 0x00, 0x03, 0x00,
  0xfa, 0xff, 0xfb, 0xff, 0x00, 0x00, 0xf5, 0xff, 0xfc, 0xff, 0xfa, 0xff,
  0xfb, 0xff, 0xf4, 0xff, 0xfc, 0xff, 0xfa, 0xff, 0xf9, 0xff, 0xf4, 0xff,
  0xff, 0xff, 0xfb, 0xff, 0x01, 0x00, 0xfa, 0xff, 0x00, 0x00, 0x00, 0x00,
  0x01, 0x00, 0xff, 0xff, 0x04, 0x00, 0x00, 0x00, 0x03, 0x00, 0x04, 0x00,
  0x09, 0x00, 0x00, 0x00, 0x06, 0x00, 0x08, 0x00, 0x0c, 0x00, 0x08, 0x00,
  0x05, 0x00, 0xff, 0xff, 0x04, 0x00, 0x06, 0x00, 0x07, 0x00, 0x02, 0x00,
  0x01, 0x00, 0x01, 0x00, 0x0d, 0x00, 0x03, 0x00, 0xfa, 0xff, 0xfa, 0xff,
  0x07, 0x00, 0x06, 0x00, 0x06, 0x00, 0xf4, 0xff, 0xf5, 0xff, 0xff, 0xff,
  0xfc, 0xff, 0xf9, 0xff, 0xfc, 0xff, 0xf3, 0xff, 0x00, 0x00, 0xf9, 0xff,
  0xfd, 0xff, 0xfb, 0xff, 0xfc, 0xff, 0xf3, 0xff, 0x01, 0x00, 0xf6, 0xff,
  0xfc, 0xff, 0xfa, 0xff, 0x02, 0x00, 0xfd, 0xff, 0x02, 0x00, 0xfc, 0xff,
  0x0a, 0x00, 0x07, 0x00, 0x08, 0x00, 0xfe, 0xff, 0x09, 0x00, 0x0d, 0x00,
  0x06, 0x00, 0xfc, 0xff, 0x00, 0x00, 0x08, 0x00, 0x0f, 0x00, 0x00, 0x00,
  0x00, 0x00, 0xf4, 0xff, 0x05, 0x00, 0x03, 0x00, 0x05, 0x00, 0xf5, 0xff,
  0xf8, 0xff, 0xfa, 0xff, 0x0d, 0x00, 0xfa, 0xff, 0xf5, 0xff, 0xed, 0xff,
  0x00, 0x00, 0x06, 0x00, 0x0d, 0x00, 0xf8, 0xff, 0xf7, 0xff, 0xee, 0xff,
  0x04, 0x00, 0x0f, 0x00, 0x0e, 0x00, 0xf7, 0xff, 0x00, 0x00, 0x00, 0x00,
  0x13, 0x00, 0x04, 0x00, 0xfd, 0xff, 0xf6, 0xff, 0x0b, 0x00, 0x08, 0x00,
  0x10, 0x00, 0xfb, 0xff, 0x00, 0x00, 0xf6, 0xff, 0x13, 0x00, 0x0b, 0x00,
  0x07, 0x00, 0xe4, 0xff, 0xfc, 0xff, 0x02, 0x00, 0x09, 0x00, 0xf5, 0xff,
  0xf1, 0xff, 0xef, 0xff, 0xf9, 0xff, 0xf9, 0xff, 0xfa, 0xff, 0xf4, 0xff,
  0xf8, 0xff, 0xfd, 0xff, 0x0f, 0x00, 0xfe, 0xff, 0xfd, 0xff, 0x01, 0x00,
  0x15, 0x00, 0x0b, 0x00, 0x09, 0x00, 0xf7, 0xff, 0x0c, 0x00, 0x0a, 0x00,
  0x16, 0x00, 0xfb, 0xff, 0xf9, 0xff, 0xf7, 0xff, 0x0d, 0x00, 0x04, 0x00,
  0x12, 0x00, 0xee, 0xff, 0x06, 0x00, 0x03, 0x00, 0x00, 0x00, 0xf0, 0xff,
  0xfe, 0xff, 0xfa, 0xff, 0x03, 0x00, 0xf2, 0xff, 0xfe, 0xff, 0x03, 0x00,
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
};
const unsigned int vocab_east_len = 21344;
