IowaScaledEngineering/ckt-defect/src/ckt-defect/vocab/include/eighth.h

const unsigned char vocab_eighth[] = {
  0x00, 0x00, 0xfe, 0xff, 0x00, 0x00, 0x07, 0x00, 0x01, 0x00, 0xf0, 0xff,
  0xf5, 0xff, 0x0b, 0x00, 0x0e, 0x00, 0x02, 0x00, 0x0b, 0x00, 0x18, 0x00,
  0x00, 0x00, 0xdf, 0xff, 0xf7, 0xff, 0x2f, 0x00, 0x35, 0x00, 0x01, 0x00,
  0xed, 0xff, 0x08, 0x00, 0x0d, 0x00, 0xd3, 0xff, 0xd8, 0xff, 0x2b, 0x00,
  0x29, 0x00, 0x8e, 0xff, 0x56, 0xff, 0x27, 0x00, 0xe3, 0x00, 0x27, 0x00,
  0x3d, 0xff, 0xa5, 0xff, 0xa2, 0x00, 0xd5, 0xff, 0xa2, 0xfe, 0xf9, 0x00,
  0x56, 0x03, 0xf7, 0xff, 0xe3, 0xfb, 0x2e, 0xfd, 0xc4, 0x00, 0x15, 0x02,
  0x81, 0x01, 0x01, 0x01, 0x09, 0x00, 0x6f, 0xff, 0x58, 0xff, 0xab, 0xff,
  0x09, 0x00, 0x1d, 0x00, 0x50, 0xff, 0x0b, 0xff, 0x92, 0x00, 0x02, 0x02,
  0x48, 0x00, 0x4d, 0xfd, 0x17, 0xfd, 0x54, 0x00, 0x9a, 0x02, 0xad, 0x01,
  0x62, 0xff, 0x6a, 0xff, 0x2f, 0x01, 0xbf, 0x01, 0xd3, 0xff, 0xa9, 0xfe,
  0xc3, 0xff, 0xb1, 0x01, 0xfd, 0x01, 0xa2, 0x00, 0x2a, 0xfe, 0xa9, 0xfc,
  0x07, 0xfd, 0x04, 0x00, 0xd9, 0x02, 0x4d, 0x03, 0x2a, 0x00, 0x2e, 0xfb,
  0xa6, 0xf9, 0xb6, 0xfd, 0x7b, 0x04, 0xee, 0x07, 0x98, 0x03, 0x27, 0xfb,
  0xce, 0xf7, 0xb1, 0xfc, 0x40, 0x03, 0x7d, 0x07, 0x09, 0x0a, 0x47, 0x08,
  0x0f, 0xfd, 0x37, 0xf3, 0x1e, 0xff, 0xdd, 0x1a, 0x6a, 0x1e, 0x7c, 0xfe,
  0x4a, 0xe4, 0x39, 0xed, 0x8d, 0x01, 0x7b, 0x00, 0x14, 0xf4, 0xa2, 0xf5,
  0x2f, 0x00, 0xa1, 0x01, 0xdb, 0xfa, 0xa6, 0xf5, 0xe9, 0xf5, 0xed, 0xf8,
  0x63, 0xff, 0x63, 0x09, 0x33, 0x12, 0xf0, 0x0e, 0x0e, 0xfd, 0x2d, 0xed,
  0x8e, 0xf3, 0xf7, 0x09, 0x41, 0x18, 0xed, 0x11, 0x06, 0x03, 0x6d, 0xfb,
  0x08, 0xfc, 0xb0, 0xfc, 0xfc, 0xfb, 0x06, 0xfe, 0x42, 0x03, 0x25, 0x05,
  0xed, 0x00, 0xa0, 0xfa, 0xc4, 0xf7, 0xdf, 0xf6, 0x9a, 0xf6, 0x48, 0xfa,
  0x11, 0x03, 0x7e, 0x09, 0x2f, 0x06, 0x30, 0xfc, 0xb9, 0xf5, 0x1c, 0xf8,
  0xa3, 0x00, 0x7b, 0x09, 0x24, 0x0e, 0xb7, 0x0b, 0x04, 0x03, 0x76, 0xfb,
  0xa7, 0xfc, 0x59, 0x04, 0xe8, 0x08, 0xcb, 0x05, 0x35, 0x01, 0xcb, 0x00,
  0x9b, 0x01, 0xda, 0xfe, 0xb8, 0xfa, 0x5a, 0xf9, 0xdb, 0xfa, 0xa3, 0xfc,
  0x72, 0xff, 0x5c, 0x01, 0xaa, 0xfd, 0x85, 0xf5, 0x94, 0xf3, 0xe9, 0xfb,
  0x00, 0x06, 0x59, 0x06, 0x00, 0x00, 0x17, 0xfc, 0xca, 0xfe, 0x29, 0x03,
  0x8b, 0x03, 0x80, 0x01, 0x58, 0x03, 0x78, 0x07, 0x0b, 0x06, 0x22, 0x01,
  0x01, 0xff, 0xb1, 0xff, 0x3c, 0xff, 0x46, 0xff, 0xbd, 0x00, 0xd0, 0x01,
  0xa4, 0xff, 0x93, 0xfc, 0xc1, 0xfa, 0xf7, 0xfb, 0xff, 0xfc, 0x35, 0xfd,
  0xba, 0xfd, 0x07, 0x00, 0xf6, 0x00, 0xa5, 0xff, 0x37, 0xfd, 0x8b, 0xfc,
  0xd3, 0xff, 0xb0, 0x05, 0x7d, 0x09, 0x05, 0x07, 0x1e, 0xff, 0xdd, 0xf9,
  0xb9, 0xfa, 0xa0, 0x00, 0x89, 0x06, 0x12, 0x08, 0x47, 0x03, 0x6a, 0xfa,
  0x3a, 0xf5, 0xec, 0xf7, 0xf7, 0x00, 0xb4, 0x07, 0x22, 0x05, 0x1b, 0xfd,
  0xb5, 0xf8, 0x54, 0xfb, 0xfd, 0x01, 0xbc, 0x08, 0x95, 0x0a, 0x17, 0x07,
  0x30, 0xf9, 0x0f, 0xef, 0x59, 0xf8, 0xa4, 0x0d, 0xc5, 0x18, 0x74, 0x06,
  0x43, 0xe7, 0x8b, 0xe3, 0xd3, 0xf7, 0x5f, 0x0d, 0xb8, 0x18, 0xd2, 0x1e,
  0x94, 0x0f, 0x09, 0xdf, 0x26, 0xc2, 0x48, 0x02, 0x9f, 0x5c, 0x34, 0x60,
  0x9d, 0xf0, 0xa1, 0xa0, 0x64, 0xc1, 0x91, 0x13, 0x61, 0x1c, 0x57, 0xf1,
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
};
const unsigned int vocab_eighth_len = 16740;
