IowaScaledEngineering/ckt-defect/src/ckt-defect/vocab/include/excessive.h

const unsigned char vocab_excessive[] = {
  0x00, 0x00, 0x04, 0x00, 0x00, 0x00, 0x01, 0x00, 0xeb, 0xff, 0xfe, 0xff,
  0xf9, 0xff, 0xfb, 0xff, 0xfe, 0xff, 0xb4, 0xff, 0x9f, 0xff, 0x6b, 0xff,
  0x6f, 0xff, 0xdb, 0xff, 0x7d, 0x00, 0x20, 0x00, 0x9d, 0xff, 0x6a, 0xff,
  0xd4, 0xff, 0x30, 0x00, 0xa1, 0x00, 0x81, 0x01, 0xcd, 0x02, 0x7f, 0x03,
  0xc3, 0x02, 0x7e, 0x00, 0xe1, 0xfd, 0x01, 0xfd, 0x10, 0xff, 0xb1, 0x02,
  0x02, 0x04, 0xe8, 0x00, 0xf8, 0xfc, 0x45, 0xfc, 0x0c, 0xff, 0x1e, 0x00,
  0x9b, 0xfd, 0x90, 0xfa, 0xfa, 0xfb, 0xb6, 0x00, 0x6b, 0x03, 0x3b, 0x01,
  0xfe, 0xfc, 0x8d, 0xfa, 0xc2, 0xfb, 0x8e, 0xff, 0xb2, 0x02, 0x02, 0x03,
  0xa3, 0x01, 0x60, 0x01, 0xfa, 0x02, 0x3c, 0x03, 0x50, 0x01, 0x57, 0xff,
  0xab, 0x00, 0x32, 0x04, 0x06, 0x06, 0xaf, 0x04, 0x5e, 0x02, 0x63, 0x01,
  0xfe, 0xff, 0x2a, 0xfd, 0x4c, 0xfb, 0x4d, 0xfd, 0x72, 0x01, 0x06, 0x03,
  0x49, 0x00, 0x94, 0xfb, 0x56, 0xf8, 0x80, 0xf8, 0x1d, 0xfb, 0x17, 0xfe,
  0x11, 0x00, 0x4d, 0x01, 0x69, 0x01, 0xbc, 0xff, 0x62, 0xfc, 0xed, 0xfa,
  0x60, 0xfe, 0xf2, 0x03, 0x8b, 0x05, 0x6a, 0x03, 0xf7, 0x02, 0x94, 0x05,
  0xfe, 0x06, 0x2b, 0x04, 0x64, 0xff, 0x6f, 0xfe, 0x0e, 0x02, 0xb0, 0x05,
  0x2f, 0x05, 0xa8, 0x01, 0xdc, 0xfe, 0x89, 0xfd, 0x68, 0xfc, 0x3f, 0xfa,
  0xbd, 0xf8, 0x25, 0xfb, 0x16, 0xfe, 0xd7, 0xff, 0x49, 0xfd, 0xdb, 0xf9,
  0x01, 0xf9, 0x97, 0xfb, 0x93, 0xfe, 0xf1, 0x00, 0x08, 0x02, 0x6a, 0x02,
  0x5d, 0x02, 0x88, 0x02, 0x29, 0x02, 0x06, 0x03, 0x95, 0x03, 0xb6, 0x04,
  0x7f, 0x05, 0x2b, 0x05, 0x65, 0x03, 0x13, 0x02, 0x97, 0x01, 0x53, 0x01,
  0x71, 0x00, 0xa4, 0xfe, 0xbd, 0xfe, 0x4f, 0x00, 0x97, 0xff, 0x5f, 0xfd,
  0xb8, 0xfa, 0xe3, 0xfa, 0x15, 0xfc, 0xce, 0xfc, 0x38, 0xfd, 0x44, 0xfc,
  0x5c, 0xfd, 0x6d, 0xfd, 0xb0, 0xfd, 0x91, 0xfd, 0x13, 0xfe, 0x08, 0x03,
  0xa5, 0x03, 0xa2, 0x01, 0xe5, 0x02, 0xbc, 0x02, 0xf6, 0x04, 0x79, 0x01,
  0x9f, 0x04, 0x6e, 0x06, 0xcf, 0x04, 0xa6, 0x02, 0xcf, 0xfc, 0x87, 0xfd,
  0xdb, 0xff, 0xd6, 0x03, 0x41, 0x06, 0x64, 0x05, 0x10, 0x02, 0x43, 0xfb,
  0x4b, 0xf4, 0x89, 0x02, 0xf5, 0x24, 0xe8, 0x32, 0x87, 0x0c, 0x52, 0xd0,
  0x3e, 0xc2, 0x99, 0xea, 0xa1, 0x1a, 0xfa, 0x1b, 0xd4, 0x00, 0xfc, 0xf0,
  0x11, 0xf3, 0x74, 0xec, 0x20, 0xde, 0x61, 0xe1, 0xe3, 0xfb, 0x25, 0x12,
  0xb8, 0x0b, 0x95, 0xf7, 0x73, 0xf5, 0xdb, 0x06, 0x67, 0x0f, 0x76, 0xfb,
  0x7e, 0xe0, 0x48, 0xe7, 0x7d, 0x14, 0xb9, 0x3a, 0xcd, 0x36, 0x1b, 0x10,
  0x73, 0xea, 0x25, 0xe5, 0xc4, 0xf6, 0x6c, 0x0d, 0xc6, 0x1d, 0x4a, 0x21,
  0x62, 0x17, 0x36, 0x00, 0x75, 0xe9, 0x5d, 0xe6, 0x9f, 0xf4, 0xe1, 0x00,
  0xaf, 0xfb, 0x7f, 0xf3, 0xaf, 0xf8, 0x41, 0x04, 0x13, 0x01, 0xca, 0xef,
  0xd7, 0xe4, 0xdb, 0xec, 0x09, 0xfd, 0x92, 0x06, 0x87, 0x07, 0x85, 0x0c,
  0xa5, 0x0f, 0x18, 0x05, 0x54, 0xf1, 0x60, 0xef, 0x8f, 0x0a, 0x04, 0x22,
  0xee, 0x1c, 0x12, 0x04, 0x26, 0xf8, 0x3b, 0x01, 0x35, 0x09, 0x7d, 0x01,
  0x46, 0xf5, 0x9d, 0xf8, 0x78, 0x03, 0xa4, 0x04, 0x83, 0xfa, 0x1f, 0xf3,
  0x1b, 0xf2, 0x20, 0xf3, 0x73, 0xf1, 0x42, 0xf3, 0x65, 0xfb, 0xa5, 0x07,
  0x19, 0x09, 0x9b, 0xf8, 0x91, 0xec, 0xd0, 0xf6, 0x0d, 0x10, 0x06, 0x15,
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
};
const unsigned int vocab_excessive_len = 25360;
