IowaScaledEngineering/ckt-defect/src/ckt-defect/vocab/include/failure.h

const unsigned char vocab_failure[] = {
  0x00, 0x00, 0x00, 0x00, 0x00, 0x00, 0x01, 0x00, 0xf6, 0xff, 0x00, 0x00,
  0x0b, 0x00, 0x01, 0x00, 0x0a, 0x00, 0x08, 0x00, 0xf7, 0xff, 0xf7, 0xff,
  0xfc, 0xff, 0xf3, 0xff, 0x05, 0x00, 0x07, 0x00, 0x05, 0x00, 0x0c, 0x00,
  0xff, 0xff, 0xf1, 0xff, 0xe6, 0xff, 0x0d, 0x00, 0x00, 0x00, 0x0d, 0x00,
  0x0d, 0x00, 0xed, 0xff, 0xfa, 0xff, 0x0f, 0x00, 0x03, 0x00, 0xee, 0xff,
  0xd2, 0xff, 0x03, 0x00, 0x09, 0x00, 0x2a, 0x00, 0x04, 0x00, 0x1f, 0x00,
  0xde, 0xff, 0x1f, 0x00, 0xcf, 0xff, 0xe5, 0xff, 0x33, 0x00, 0xe0, 0xff,
  0x00, 0x00, 0x44, 0x00, 0x12, 0x00, 0x03, 0x00, 0xf1, 0xff, 0xb7, 0xff,
  0x09, 0x00, 0xdb, 0xff, 0xde, 0xff, 0x1e, 0x00, 0x3d, 0x00, 0x0d, 0x00,
  0x1c, 0x00, 0x26, 0x00, 0x0f, 0x00, 0xc1, 0xff, 0xe5, 0xff, 0xde, 0xff,
  0xd6, 0xff, 0x14, 0x00, 0x0c, 0x00, 0x28, 0x00, 0x48, 0x00, 0x0b, 0x00,
  0xf9, 0xff, 0xd5, 0xff, 0xe3, 0xff, 0xc8, 0xff, 0xe1, 0xff, 0xcd, 0xff,
  0x23, 0x00, 0x23, 0x00, 0x6b, 0x00, 0xbf, 0xff, 0x32, 0x00, 0xb2, 0xff,
  0x04, 0x00, 0x58, 0x00, 0xc4, 0xff, 0xcc, 0xff, 0x4c, 0x00, 0x04, 0x00,
  0x71, 0x00, 0x08, 0x00, 0xe3, 0xff, 0xaf, 0xff, 0xaa, 0xff, 0xdf, 0xff,
  0x06, 0x00, 0x1b, 0x00, 0x34, 0x00, 0x23, 0x00, 0x92, 0xff, 0x48, 0x00,
  0xee, 0xff, 0x2d, 0x00, 0xb7, 0xff, 0x70, 0x00, 0xf3, 0xff, 0xce, 0xff,
  0x16, 0x00, 0xdf, 0xff, 0x36, 0x00, 0x40, 0x00, 0x82, 0xff, 0x11, 0x00,
  0x57, 0x00, 0xe9, 0xff, 0xd8, 0xff, 0xa5, 0xff, 0xc8, 0x00, 0xd3, 0xff,
  0x39, 0xff, 0x8c, 0xff, 0x37, 0x00, 0x18, 0x01, 0xea, 0x00, 0x64, 0xff,
  0x44, 0xff, 0x9e, 0xff, 0xaf, 0xff, 0x43, 0x00, 0x65, 0x00, 0x78, 0x00,
  0x2b, 0x00, 0x44, 0xff, 0xf0, 0xff, 0x90, 0xff, 0x81, 0x00, 0x4f, 0x00,
  0xf5, 0xfe, 0x2e, 0x00, 0xbd, 0x00, 0xf3, 0xff, 0xe0, 0xff, 0x90, 0x00,
  0xc6, 0xff, 0x2b, 0x00, 0xf2, 0xff, 0x99, 0xff, 0xf4, 0xff, 0x1b, 0x00,
  0x2d, 0x00, 0x02, 0x00, 0xf7, 0xff, 0x6c, 0xff, 0x01, 0x00, 0x7c, 0x01,
  0x62, 0x00, 0x18, 0x00, 0x35, 0xff, 0xea, 0xfe, 0xce, 0xff, 0x80, 0x00,
  0xd6, 0xff, 0x60, 0x00, 0xb3, 0xff, 0x35, 0xff, 0xff, 0x00, 0x67, 0x00,
  0x86, 0xff, 0x84, 0x00, 0xbd, 0x00, 0xc0, 0xfe, 0xf2, 0xff, 0xcf, 0xff,
  0x53, 0xff, 0x1a, 0x01, 0x87, 0xff, 0xed, 0xff, 0x1e, 0x00, 0x82, 0x00,
  0xf2, 0xff, 0xd0, 0xfe, 0x27, 0x00, 0xee, 0x00, 0xff, 0xff, 0x61, 0xff,
  0x62, 0x00, 0xd2, 0x00, 0xae, 0x00, 0xb2, 0x00, 0x2f, 0x00, 0x8a, 0xfe,
  0x85, 0xfe, 0x9a, 0xff, 0x2c, 0x01, 0x8a, 0xff, 0x41, 0xff, 0x3b, 0x00,
  0x75, 0x01, 0x27, 0x00, 0x57, 0xff, 0x06, 0x00, 0x59, 0xff, 0xad, 0x00,
  0x87, 0x00, 0xab, 0xff, 0xf4, 0xff, 0xca, 0x00, 0xa6, 0x00, 0xdf, 0xfe,
  0x90, 0xfe, 0xff, 0xfe, 0xf9, 0xff, 0x92, 0x00, 0xfb, 0xff, 0x25, 0x01,
  0x8d, 0x00, 0x0b, 0x00, 0x38, 0x00, 0x2b, 0x01, 0xb8, 0xff, 0x99, 0x00,
  0x91, 0xfd, 0x6f, 0xfd, 0xd6, 0x00, 0xa6, 0x01, 0x46, 0x01, 0x4c, 0x00,
  0x8c, 0xff, 0x4c, 0x00, 0xca, 0xfe, 0xb9, 0xff, 0x2d, 0x01, 0x6a, 0xff,
  0xdd, 0xfe, 0x2c, 0x02, 0x49, 0xfe, 0x4e, 0x01, 0xdb, 0xff, 0xaf, 0xff,
  0x7f, 0xff, 0xa1, 0xff, 0x12, 0xff, 0x83, 0x01, 0x24, 0x00, 0x0a, 0x00,
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
};
const unsigned int vocab_failure_len = 18364;
