IowaScaledEngineering/ckt-defect/src/ckt-defect/vocab/include/fifth.h

const unsigned char vocab_fifth[] = {
  0x00, 0x00, 0x00, 0x00, 0xff, 0xff, 0x00, 0x00, 0x03, 0x00, 0xfc, 0xff,
  0xfc, 0xff, 0xfc, 0xff, 0x07, 0x00, 0x09, 0x00, 0x00, 0x00, 0xf8, 0xff,
  0x02, 0x00, 0xff, 0xff, 0xf8, 0xff, 0xf3, 0xff, 0x17, 0x00, 0x00, 0x00,
  0xf7, 0xff, 0x08, 0x00, 0x08, 0x00, 0x05, 0x00, 0x07, 0x00, 0xdb, 0xff,
  0xdb, 0xff, 0xfa, 0xff, 0x30, 0x00, 0x12, 0x00, 0x03, 0x00, 0xdc, 0xff,
  0x1b, 0x00, 0x27, 0x00, 0xe3, 0xff, 0xc1, 0xff, 0x3c, 0x00, 0xf9, 0xff,
  0x00, 0x00, 0xf9, 0xff, 0x06, 0x00, 0x08, 0x00, 0xfe, 0xff, 0x3b, 0x00,
  0xf1, 0xff, 0xc6, 0xff, 0xe9, 0xff, 0xeb, 0xff, 0x1d, 0x00, 0x3a, 0x00,
  0xe2, 0xff, 0x0d, 0x00, 0xe3, 0xff, 0x20, 0x00, 0xe4, 0xff, 0xe4, 0xff,
  0x38, 0x00, 0xc4, 0xff, 0x28, 0x00, 0xbd, 0xff, 0x3b, 0x00, 0xfd, 0xff,
  0x08, 0x00, 0xa6, 0xff, 0xcc, 0x00, 0x40, 0x00, 0x78, 0xff, 0xd7, 0xff,
  0x15, 0x00, 0x7e, 0xff, 0xce, 0xff, 0x7e, 0x00, 0xd3, 0xff, 0x36, 0x00,
  0xac, 0xff, 0x77, 0x00, 0x20, 0x00, 0xbf, 0xff, 0x87, 0xff, 0xe4, 0x00,
  0xf5, 0xff, 0xd2, 0xff, 0x34, 0x00, 0x0e, 0x00, 0x19, 0x00, 0x53, 0x00,
  0x6f, 0xff, 0xeb, 0xfe, 0x3b, 0x00, 0x12, 0x01, 0x15, 0x00, 0x24, 0xff,
  0x0c, 0x00, 0xa5, 0x00, 0x34, 0x00, 0xa1, 0xff, 0x55, 0xff, 0xf6, 0xff,
  0x27, 0x01, 0x47, 0xff, 0x73, 0xff, 0x54, 0x00, 0xe2, 0x00, 0x9b, 0xff,
  0x88, 0xff, 0xa8, 0xff, 0x3f, 0x00, 0x57, 0x00, 0x71, 0x00, 0xe8, 0xff,
  0x95, 0x00, 0xff, 0xfe, 0xea, 0xff, 0x77, 0xff, 0xc6, 0x00, 0xec, 0xfe,
  0xa3, 0x00, 0xda, 0x00, 0xf8, 0xff, 0xe7, 0x00, 0x04, 0xff, 0x02, 0x00,
  0x06, 0x00, 0xd0, 0x00, 0x46, 0xfe, 0x2e, 0x00, 0x89, 0xff, 0xb9, 0xff,
  0x9a, 0x00, 0x38, 0x00, 0x97, 0x00, 0xd1, 0xff, 0x74, 0xff, 0xb4, 0xff,
  0x3b, 0x02, 0xfe, 0xfe, 0xcf, 0xff, 0x56, 0x00, 0xc0, 0xff, 0x10, 0xff,
  0x71, 0x00, 0x81, 0x00, 0xc6, 0x00, 0xa9, 0xfe, 0xad, 0xff, 0x81, 0xff,
  0x70, 0x00, 0xa4, 0xff, 0xa6, 0xff, 0xf3, 0x01, 0x6c, 0xfe, 0x3c, 0x01,
  0x8c, 0x01, 0x40, 0xfe, 0x46, 0x00, 0xa2, 0x01, 0x76, 0xff, 0x62, 0xfd,
  0xb0, 0xff, 0xbf, 0x00, 0xac, 0x01, 0x24, 0x00, 0xc9, 0xff, 0xfa, 0xfd,
  0xe0, 0x00, 0x8a, 0x00, 0x95, 0xff, 0x0f, 0x01, 0xf0, 0xfe, 0x00, 0xfe,
  0x1b, 0x00, 0xf2, 0x01, 0xe5, 0x00, 0x5b, 0xfe, 0x07, 0xff, 0xc8, 0xff,
  0x41, 0x01, 0x1e, 0x01, 0xd3, 0x00, 0x72, 0x00, 0xa9, 0x00, 0x59, 0xff,
  0x1d, 0xfe, 0xfb, 0xff, 0xf7, 0x00, 0xc5, 0xfd, 0xfc, 0x01, 0x91, 0xff,
  0x39, 0x02, 0x40, 0xff, 0xc4, 0xfd, 0xea, 0xfe, 0x24, 0xff, 0xc8, 0x03,
  0x26, 0x00, 0x2f, 0x00, 0xe0, 0xfd, 0x3a, 0x03, 0xfc, 0x00, 0x74, 0xfc,
  0xaf, 0xfd, 0x74, 0xff, 0x80, 0x00, 0xaf, 0x01, 0xab, 0xfd, 0x15, 0x03,
  0x11, 0x01, 0xdd, 0xfe, 0x4f, 0x01, 0x6b, 0xff, 0xa9, 0xfd, 0x04, 0x01,
  0x7e, 0x01, 0xe8, 0xfc, 0x89, 0x01, 0x70, 0x00, 0xfb, 0x02, 0x03, 0x02,
  0x2b, 0xfd, 0xf0, 0xfb, 0xc6, 0xfe, 0xe8, 0x02, 0xf6, 0x03, 0x52, 0xfc,
  0xdf, 0xfd, 0xef, 0x03, 0xbf, 0x01, 0x66, 0xfd, 0xc9, 0xfd, 0xa4, 0xff,
  0x17, 0x02, 0xea, 0xfc, 0x14, 0xff, 0x99, 0x05, 0xf1, 0x02, 0x66, 0xff,
  0xd9, 0xfe, 0x76, 0xfd, 0xdf, 0xfd, 0x2c, 0xff, 0x7b, 0xff, 0x33, 0x00,
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
};
const unsigned int vocab_fifth_len = 20220;
