IowaScaledEngineering/ckt-defect/src/ckt-defect/vocab/include/first.h

const unsigned char vocab_first[] = {
  0x00, 0x00, 0x01, 0x00, 0x00, 0x00, 0xff, 0xff, 0xfb, 0xff, 0xfd, 0xff,
  0x00, 0x00, 0xfd, 0xff, 0x00, 0x00, 0x06, 0x00, 0x09, 0x00, 0x02, 0x00,
  0x00, 0x00, 0x05, 0x00, 0xfe, 0xff, 0xf9, 0xff, 0xf6, 0xff, 0xf9, 0xff,
  0xec, 0xff, 0x02, 0x00, 0x12, 0x00, 0x0d, 0x00, 0xfa, 0xff, 0xef, 0xff,
  0x11, 0x00, 0x28, 0x00, 0x02, 0x00, 0xf1, 0xff, 0x00, 0x00, 0xf8, 0xff,
  0xe1, 0xff, 0xf1, 0xff, 0x0e, 0x00, 0xf7, 0xff, 0xef, 0xff, 0x03, 0x00,
  0x01, 0x00, 0x11, 0x00, 0xfd, 0xff, 0x21, 0x00, 0x1c, 0x00, 0x19, 0x00,
  0x09, 0x00, 0x04, 0x00, 0xec, 0xff, 0xe5, 0xff, 0xd6, 0xff, 0xd2, 0xff,
  0xe8, 0xff, 0xf2, 0xff, 0x27, 0x00, 0x32, 0x00, 0x18, 0x00, 0x14, 0x00,
  0x25, 0x00, 0x17, 0x00, 0x2a, 0x00, 0xdb, 0xff, 0xdd, 0xff, 0x9e, 0xff,
  0xb7, 0xff, 0xb4, 0xff, 0x15, 0x00, 0x12, 0x00, 0x67, 0x00, 0x6f, 0x00,
  0x37, 0x00, 0xc2, 0xff, 0xf8, 0xff, 0xf4, 0xff, 0xd8, 0xff, 0x00, 0x00,
  0xdc, 0xff, 0xa8, 0xff, 0xd5, 0xff, 0xb0, 0xff, 0x95, 0x00, 0x65, 0x00,
  0x20, 0x00, 0x63, 0x00, 0x0f, 0x00, 0xe6, 0xff, 0xd2, 0xff, 0xb3, 0xff,
  0x7b, 0xff, 0x4c, 0x00, 0x5e, 0x00, 0xf7, 0xff, 0x45, 0x00, 0x3f, 0x00,
  0x34, 0x00, 0xf4, 0xff, 0xbd, 0xff, 0xc4, 0xff, 0xa2, 0xff, 0xe4, 0xff,
  0xda, 0xff, 0x00, 0x00, 0xf6, 0xff, 0x07, 0x00, 0xe8, 0xff, 0x73, 0xff,
  0x48, 0x00, 0x3e, 0x00, 0x49, 0xff, 0x42, 0x00, 0x6f, 0x00, 0x40, 0x00,
  0x83, 0x00, 0x92, 0xff, 0x69, 0x00, 0x56, 0x00, 0xd4, 0xff, 0x7d, 0xff,
  0xc4, 0xff, 0xaa, 0xff, 0xe9, 0xff, 0xab, 0x00, 0x7f, 0x00, 0xaf, 0x00,
  0x72, 0x00, 0xd3, 0xff, 0xd0, 0xfe, 0x30, 0xff, 0x22, 0x00, 0xa4, 0x00,
  0xa0, 0x00, 0x15, 0xff, 0x87, 0xff, 0x25, 0x00, 0x29, 0x00, 0xa7, 0xff,
  0x0e, 0x00, 0x3c, 0x00, 0xb8, 0x00, 0xbe, 0xff, 0x80, 0xff, 0x0f, 0x00,
  0x95, 0x00, 0xc6, 0x00, 0x79, 0xff, 0x60, 0x00, 0xd0, 0xff, 0xd6, 0xff,
  0x3c, 0x00, 0x73, 0xff, 0xea, 0xff, 0x8d, 0xff, 0xf3, 0xff, 0xd1, 0x00,
  0xe7, 0x00, 0x56, 0xff, 0x81, 0xff, 0xb6, 0xff, 0x1c, 0x00, 0x6e, 0x00,
  0xf2, 0xfe, 0x5b, 0x00, 0x94, 0x00, 0x3c, 0x00, 0x29, 0xff, 0xeb, 0xfe,
  0x33, 0x00, 0x62, 0x00, 0xab, 0x00, 0x8c, 0x00, 0xb5, 0xfe, 0x8d, 0x00,
  0x22, 0x00, 0x07, 0x00, 0x64, 0x00, 0x40, 0xff, 0x4d, 0xff, 0xee, 0x00,
  0xf7, 0x00, 0xcb, 0xff, 0x33, 0xff, 0xa9, 0xfe, 0x6d, 0x01, 0x5a, 0x02,
  0xde, 0xff, 0xa6, 0xff, 0x70, 0xff, 0xf3, 0xff, 0xb0, 0xff, 0x6c, 0xfe,
  0xc3, 0xff, 0x40, 0x01, 0x7a, 0x00, 0x3b, 0xff, 0xa6, 0x00, 0x2e, 0x01,
  0xae, 0x00, 0x2a, 0xfd, 0xfa, 0xfd, 0xa9, 0xff, 0xe4, 0xff, 0xc9, 0x00,
  0xbf, 0x01, 0x67, 0x01, 0xa5, 0x00, 0x61, 0xff, 0x9e, 0x00, 0x0c, 0xff,
  0x95, 0xff, 0x70, 0xfe, 0x12, 0xfe, 0x07, 0x02, 0x41, 0x02, 0x71, 0x00,
  0xdd, 0xff, 0x76, 0x00, 0x4b, 0xfe, 0x80, 0xfe, 0x84, 0xff, 0xfc, 0xfe,
  0x96, 0x00, 0x08, 0x03, 0xf1, 0x01, 0x79, 0xfe, 0xfb, 0xfe, 0x6e, 0x02,
  0x10, 0x03, 0xa8, 0xfd, 0xcd, 0xfd, 0x2a, 0xfe, 0x0b, 0xfe, 0xeb, 0xfe,
  0x82, 0x00, 0x84, 0x02, 0xf1, 0x01, 0xb7, 0x01, 0x4f, 0x00, 0xf4, 0xfe,
  0xea, 0xfc, 0xbe, 0xfe, 0x0c, 0xff, 0xfb, 0x01, 0x64, 0x02, 0x85, 0x00,
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
};
const unsigned int vocab_first_len = 22630;
