IowaScaledEngineering/ckt-defect/src/ckt-defect/vocab/include/have.h

const unsigned char vocab_have[] = {
  0x00, 0x00, 0x01, 0x00, 0x00, 0x00, 0xfe, 0xff, 0xfc, 0xff, 0xf8, 0xff,
  0xf6, 0xff, 0xf7, 0xff, 0xfc, 0xff, 0x05, 0x00, 0x07, 0x00, 0xfd, 0xff,
  0xef, 0xff, 0xe7, 0xff, 0xe5, 0xff, 0xf0, 0xff, 0x03, 0x00, 0x11, 0x00,
  0x16, 0x00, 0x16, 0x00, 0x0a, 0x00, 0x02, 0x00, 0xfd, 0xff, 0xfc, 0xff,
  0xff, 0xff, 0x0b, 0x00, 0x26, 0x00, 0x32, 0x00, 0x28, 0x00, 0x1e, 0x00,
  0x07, 0x00, 0xea, 0xff, 0xe4, 0xff, 0xf1, 0xff, 0x05, 0x00, 0x17, 0x00,
  0x22, 0x00, 0x1a, 0x00, 0x0d, 0x00, 0x09, 0x00, 0xef, 0xff, 0xcf, 0xff,
  0xce, 0xff, 0xde, 0xff, 0xd5, 0xff, 0xc8, 0xff, 0xe5, 0xff, 0x02, 0x00,
  0xf7, 0xff, 0xe0, 0xff, 0xee, 0xff, 0x18, 0x00, 0x25, 0x00, 0x04, 0x00,
  0xdd, 0xff, 0xe8, 0xff, 0x14, 0x00, 0x32, 0x00, 0x2b, 0x00, 0x21, 0x00,
  0x27, 0x00, 0xff, 0xff, 0xcc, 0xff, 0xe2, 0xff, 0xf7, 0xff, 0x17, 0x00,
  0x52, 0x00, 0x69, 0x00, 0x5d, 0x00, 0x54, 0x00, 0x38, 0x00, 0xc8, 0xff,
  0x59, 0xff, 0x41, 0xff, 0x68, 0xff, 0xc7, 0xff, 0x0b, 0x00, 0x46, 0x00,
  0x43, 0x00, 0x0d, 0x00, 0xf3, 0xff, 0xf3, 0xff, 0xc0, 0xff, 0x88, 0xff,
  0xd4, 0xff, 0x87, 0x00, 0xfe, 0x00, 0xd5, 0x00, 0x5d, 0x00, 0x0b, 0x00,
  0xe0, 0xff, 0xb3, 0xff, 0x9b, 0xff, 0xc4, 0xff, 0x26, 0x00, 0x70, 0x00,
  0x5c, 0x00, 0xe6, 0xff, 0x72, 0xff, 0x01, 0xff, 0xc8, 0xfe, 0xf5, 0xfe,
  0x6b, 0xff, 0xe6, 0xff, 0x4a, 0x00, 0xb9, 0x00, 0xf5, 0x00, 0x9d, 0x00,
  0xe9, 0xff, 0x82, 0xff, 0xa5, 0xff, 0x18, 0x00, 0x9f, 0x00, 0xe3, 0x00,
  0x46, 0x01, 0x5b, 0x01, 0xf2, 0x00, 0x53, 0x00, 0x97, 0xff, 0x42, 0xff,
  0x00, 0xff, 0x0a, 0xff, 0x90, 0xff, 0x69, 0x00, 0xbf, 0x00, 0x39, 0x00,
  0xa8, 0xff, 0x3c, 0xff, 0xfe, 0xfe, 0xbc, 0xfe, 0xf6, 0xfe, 0xaa, 0xff,
  0x54, 0x00, 0x91, 0x00, 0xc2, 0x00, 0xd6, 0x00, 0xab, 0x00, 0xf2, 0xff,
  0x61, 0xff, 0x21, 0xff, 0x66, 0xff, 0xec, 0xff, 0x03, 0x00, 0x34, 0x00,
  0x3f, 0x00, 0x4e, 0x00, 0x75, 0x00, 0x8e, 0x00, 0x63, 0x00, 0x36, 0x00,
  0x6c, 0x00, 0xb1, 0x00, 0x7e, 0x00, 0xfb, 0xff, 0x31, 0x00, 0x50, 0x00,
  0x04, 0x00, 0xb6, 0xff, 0x71, 0xff, 0xac, 0xff, 0xee, 0xff, 0x3c, 0x00,
  0x35, 0x00, 0x18, 0x00, 0x3c, 0x00, 0xae, 0x00, 0xa4, 0x00, 0xe7, 0xff,
  0x1d, 0xff, 0x88, 0xfe, 0x4c, 0xfe, 0xab, 0xfe, 0xd4, 0xff, 0x91, 0x00,
  0x9d, 0x00, 0xce, 0x00, 0xe0, 0x00, 0x09, 0x00, 0xd4, 0xfe, 0x51, 0xfe,
  0x7c, 0xfe, 0xa3, 0xff, 0x2b, 0x01, 0xbf, 0x01, 0x7d, 0x01, 0x39, 0x01,
  0x97, 0x00, 0x15, 0xff, 0x43, 0xfe, 0x71, 0xfe, 0x26, 0xff, 0x05, 0x00,
  0x17, 0x01, 0xc6, 0x01, 0x61, 0x01, 0xa8, 0x00, 0x5a, 0xff, 0x31, 0xfe,
  0x42, 0xfe, 0x4b, 0xff, 0x22, 0x00, 0xa4, 0x00, 0x98, 0x01, 0xfd, 0x01,
  0x2b, 0x01, 0x0d, 0x00, 0x03, 0xff, 0x7e, 0xfe, 0xbc, 0xfe, 0xab, 0xff,
  0xc0, 0x00, 0xef, 0x01, 0x00, 0x02, 0x3a, 0x01, 0x4d, 0x00, 0x64, 0xff,
  0xea, 0xfe, 0xcb, 0xfe, 0x02, 0xff, 0x0c, 0x00, 0x5e, 0x01, 0x88, 0x01,
  0x1c, 0x00, 0x5c, 0xff, 0xe4, 0xfe, 0x4c, 0xfe, 0x20, 0xfe, 0x5b, 0xfe,
  0xe3, 0xfe, 0x71, 0xff, 0xa8, 0x00, 0xe1, 0x00, 0xc5, 0xff, 0xd5, 0xfe,
  0x37, 0xff, 0x41, 0xff, 0x5c, 0xff, 0x2c, 0x00, 0x99, 0x01, 0xea, 0x02,
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
};
const unsigned int vocab_have_len = 17162;
