IowaScaledEngineering/ckt-defect/src/ckt-defect/vocab/include/high.h

const unsigned char vocab_high[] = {
  0x00, 0x00, 0x01, 0x00, 0x00, 0x00, 0x00, 0x00, 0x00, 0x00, 0x00, 0x00,
  0xfd, 0xff, 0xf8, 0xff, 0xfd, 0xff, 0x06, 0x00, 0x10, 0x00, 0x09, 0x00,
  0xfc, 0xff, 0xf6, 0xff, 0xf9, 0xff, 0xe7, 0xff, 0xe7, 0xff, 0xf3, 0xff,
  0xf8, 0xff, 0xf7, 0xff, 0x00, 0x00, 0x05, 0x00, 0xfe, 0xff, 0xe4, 0xff,
  0xc6, 0xff, 0xb0, 0xff, 0xd4, 0xff, 0xfb, 0xff, 0x07, 0x00, 0x1d, 0x00,
  0x34, 0x00, 0x49, 0x00, 0x3b, 0x00, 0x65, 0x00, 0x59, 0x00, 0x2e, 0x00,
  0x11, 0x00, 0xe5, 0xff, 0x3d, 0x00, 0x3f, 0x00, 0x33, 0x00, 0x49, 0x00,
  0x45, 0x00, 0x38, 0x00, 0xd6, 0xff, 0xc1, 0xff, 0xd8, 0xff, 0x9b, 0xff,
  0x69, 0xff, 0x8f, 0xff, 0xf1, 0xff, 0xe8, 0xff, 0xfe, 0xff, 0x97, 0xff,
  0x82, 0xff, 0x7c, 0xff, 0x79, 0xff, 0x93, 0xff, 0xce, 0xff, 0xe8, 0xff,
  0xf2, 0xff, 0x83, 0x00, 0xdb, 0x00, 0xbc, 0x00, 0x22, 0x00, 0xe8, 0xff,
  0xd9, 0xff, 0xf4, 0xff, 0x55, 0x00, 0xc5, 0x00, 0xc4, 0x00, 0x8d, 0x00,
  0x6d, 0x00, 0x50, 0x00, 0x08, 0x00, 0x7d, 0xff, 0xe6, 0xfe, 0x49, 0xff,
  0x4e, 0x00, 0xd4, 0x00, 0xf0, 0x00, 0xa9, 0x00, 0xe3, 0xff, 0x65, 0xff,
  0x4f, 0xff, 0x63, 0xff, 0x3b, 0xff, 0x86, 0xff, 0x57, 0x00, 0x7d, 0x00,
  0x54, 0x00, 0x1b, 0x00, 0xb9, 0xff, 0x12, 0xff, 0x63, 0xfe, 0xa2, 0xfe,
  0xad, 0xff, 0x72, 0x00, 0x47, 0x00, 0x48, 0x00, 0x75, 0x00, 0x54, 0x00,
  0xf6, 0xff, 0x09, 0x00, 0x10, 0x00, 0x1c, 0x00, 0xe0, 0x00, 0xf1, 0x00,
  0x21, 0x01, 0x1a, 0x01, 0x59, 0x00, 0x4b, 0x00, 0x10, 0x00, 0xe3, 0xff,
  0xb2, 0xff, 0xf3, 0xff, 0x03, 0x00, 0x96, 0xff, 0x4e, 0x00, 0x6f, 0x00,
  0x2e, 0x00, 0xfc, 0xff, 0x8a, 0xff, 0x37, 0xff, 0x24, 0xff, 0x48, 0xfe,
  0x64, 0xfe, 0x5d, 0xff, 0xb4, 0xff, 0xb3, 0xff, 0xce, 0xff, 0x45, 0x00,
  0xc0, 0xff, 0xa5, 0xff, 0x50, 0xff, 0x96, 0xff, 0x96, 0x00, 0x26, 0x01,
  0xf0, 0x00, 0xe6, 0x01, 0xf6, 0x01, 0x83, 0x01, 0x95, 0x00, 0xb9, 0x00,
  0xe9, 0x00, 0x35, 0x01, 0xdb, 0xff, 0x57, 0x00, 0xf7, 0x00, 0xf2, 0xff,
  0x48, 0xfe, 0x94, 0xfe, 0x66, 0xff, 0xe4, 0xff, 0xbd, 0xff, 0x1d, 0xfe,
  0xf1, 0xfd, 0x6f, 0xfe, 0x27, 0xff, 0x88, 0xfe, 0x7b, 0xfd, 0xfe, 0xfd,
  0x33, 0xff, 0xaa, 0xff, 0xe0, 0xff, 0xa1, 0x00, 0x6e, 0x01, 0x18, 0x01,
  0x83, 0x01, 0xf7, 0x01, 0xa1, 0x02, 0xa6, 0x02, 0xda, 0x01, 0x7e, 0x00,
  0x32, 0x00, 0xc4, 0x01, 0xd5, 0x02, 0x04, 0x02, 0x8b, 0xff, 0x19, 0xff,
  0x79, 0xff, 0xd8, 0xfe, 0x4a, 0xfe, 0xd4, 0xfe, 0x6f, 0xff, 0x6b, 0xfe,
  0x8d, 0xfd, 0xdd, 0xfe, 0x21, 0x01, 0x3e, 0xff, 0xcf, 0xfc, 0x0e, 0xfc,
  0xdc, 0xfd, 0xec, 0xfe, 0xd3, 0xfe, 0x33, 0x00, 0x03, 0x02, 0xed, 0x02,
  0xd5, 0x01, 0xbf, 0x00, 0x53, 0x01, 0xed, 0x00, 0xf5, 0xfe, 0x86, 0xfe,
  0xcb, 0x00, 0x8d, 0x04, 0x6d, 0x05, 0xba, 0x03, 0xf5, 0x02, 0x44, 0x01,
  0xeb, 0xff, 0x8b, 0xfe, 0x3b, 0xfe, 0xa9, 0xfe, 0x8b, 0xfe, 0xbd, 0xfe,
  0xe7, 0xfe, 0x47, 0xff, 0x45, 0xfe, 0x15, 0xfe, 0x6b, 0xfd, 0x99, 0xfc,
  0x12, 0xfd, 0x13, 0xfe, 0x26, 0xff, 0xbf, 0xff, 0x06, 0x01, 0x65, 0x02,
  0x54, 0x02, 0x21, 0x01, 0x68, 0x01, 0x5a, 0x01, 0x25, 0xff, 0x64, 0xff,
  0x68, 0x01, 0x97, 0x03, 0x69, 0x04, 0x12, 0x03, 0x1b, 0x02, 0xab, 0x00,
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
};
const unsigned int vocab_high_len = 16000;
