IowaScaledEngineering/ckt-defect/src/ckt-defect/vocab/include/hot.h

const unsigned char vocab_hot[] = {
  0x00, 0x00, 0xff, 0xff, 0xff, 0xff, 0xfc, 0xff, 0xfa, 0xff, 0xfc, 0xff,
  0xff, 0xff, 0x00, 0x00, 0x00, 0x00, 0x02, 0x00, 0x0a, 0x00, 0x10, 0x00,
  0x10, 0x00, 0x0d, 0x00, 0x0e, 0x00, 0x14, 0x00, 0x1b, 0x00, 0x23, 0x00,
  0x26, 0x00, 0x1d, 0x00, 0x1d, 0x00, 0x18, 0x00, 0x07, 0x00, 0x00, 0x00,
  0xfa, 0xff, 0xe4, 0xff, 0xdc, 0xff, 0xe1, 0xff, 0xdc, 0xff, 0xc9, 0xff,
  0xc4, 0xff, 0xd9, 0xff, 0xda, 0xff, 0xbb, 0xff, 0xa9, 0xff, 0xb4, 0xff,
  0xc5, 0xff, 0xd2, 0xff, 0xe8, 0xff, 0x07, 0x00, 0x1b, 0x00, 0x21, 0x00,
  0x2d, 0x00, 0x3e, 0x00, 0x52, 0x00, 0x51, 0x00, 0x41, 0x00, 0x47, 0x00,
  0x75, 0x00, 0x79, 0x00, 0x4a, 0x00, 0x29, 0x00, 0x1a, 0x00, 0xf5, 0xff,
  0xd8, 0xff, 0xde, 0xff, 0xf2, 0xff, 0xf6, 0xff, 0xf9, 0xff, 0xf9, 0xff,
  0xfd, 0xff, 0xf0, 0xff, 0xe1, 0xff, 0xba, 0xff, 0x7f, 0xff, 0x82, 0xff,
  0xbf, 0xff, 0xbe, 0xff, 0xc0, 0xff, 0xf4, 0xff, 0xff, 0xff, 0xd7, 0xff,
  0xd5, 0xff, 0xf3, 0xff, 0xed, 0xff, 0xd5, 0xff, 0xe9, 0xff, 0x4c, 0x00,
  0xb9, 0x00, 0xb9, 0x00, 0x82, 0x00, 0x3a, 0x00, 0x0f, 0x00, 0x0a, 0x00,
  0x31, 0x00, 0x53, 0x00, 0x6a, 0x00, 0x93, 0x00, 0x73, 0x00, 0x31, 0x00,
  0x37, 0x00, 0x34, 0x00, 0xc4, 0xff, 0x75, 0xff, 0x7a, 0xff, 0xa9, 0xff,
  0xa4, 0xff, 0x74, 0xff, 0x6a, 0xff, 0x88, 0xff, 0x6d, 0xff, 0x26, 0xff,
  0x4d, 0xff, 0xb2, 0xff, 0xfa, 0xff, 0xfc, 0xff, 0x23, 0x00, 0x73, 0x00,
  0x91, 0x00, 0x44, 0x00, 0x8c, 0xff, 0x40, 0xff, 0x9b, 0xff, 0xfc, 0xff,
  0x84, 0x00, 0xf4, 0x00, 0xef, 0x00, 0x99, 0x00, 0x88, 0x00, 0xa2, 0x00,
  0x64, 0x00, 0xdb, 0xff, 0xd6, 0xff, 0x3d, 0x00, 0x97, 0x00, 0xb1, 0x00,
  0x9a, 0x00, 0x72, 0x00, 0x05, 0x00, 0x7b, 0xff, 0x45, 0xff, 0x74, 0xff,
  0x9a, 0xff, 0x4f, 0xff, 0x12, 0xff, 0x1f, 0xff, 0x27, 0xff, 0x15, 0xff,
  0x2b, 0xff, 0x2c, 0xff, 0x6e, 0xff, 0xd9, 0xff, 0x2b, 0x00, 0x61, 0x00,
  0x7f, 0x00, 0x4a, 0x00, 0x09, 0x00, 0x26, 0x00, 0xb5, 0x00, 0x36, 0x01,
  0x9d, 0x01, 0xb3, 0x01, 0x7e, 0x01, 0x32, 0x01, 0xc6, 0x00, 0x93, 0x00,
  0x5d, 0x00, 0xaf, 0xff, 0x72, 0xff, 0xaf, 0xff, 0xde, 0xff, 0xa4, 0xff,
  0x4c, 0xff, 0xfc, 0xfe, 0x28, 0xff, 0x68, 0xff, 0x07, 0xff, 0xc5, 0xfe,
  0x08, 0xff, 0xa6, 0xff, 0x30, 0x00, 0x34, 0x00, 0xf1, 0xff, 0xc5, 0xff,
  0xd5, 0xff, 0xa8, 0xff, 0xa1, 0xff, 0x90, 0xff, 0xf3, 0xff, 0x96, 0x00,
  0xca, 0x00, 0xc4, 0x00, 0xab, 0x00, 0x6d, 0x00, 0xff, 0xff, 0xdd, 0xff,
  0x32, 0x00, 0x8b, 0x00, 0x98, 0x00, 0x43, 0x00, 0x48, 0x00, 0x78, 0x00,
  0x27, 0x00, 0xbc, 0xff, 0xbe, 0xff, 0x00, 0x00, 0xb7, 0xff, 0x52, 0xff,
  0x57, 0xff, 0x5c, 0xff, 0x40, 0xff, 0x38, 0xff, 0x6e, 0xff, 0x1b, 0x00,
  0xab, 0x00, 0xfd, 0x00, 0x8c, 0x00, 0x69, 0x00, 0x64, 0x00, 0x56, 0x00,
  0xe4, 0xff, 0xa8, 0xff, 0xc6, 0xff, 0x75, 0x00, 0x4c, 0x01, 0x40, 0x01,
  0xbc, 0x00, 0x13, 0x00, 0x4d, 0xff, 0xdd, 0xfe, 0xd8, 0xfe, 0x64, 0xff,
  0x6e, 0x00, 0xe0, 0x00, 0xac, 0x00, 0x2f, 0x00, 0xbc, 0xff, 0xea, 0xfe,
  0x3c, 0xfe, 0x0e, 0xfe, 0x8d, 0xfe, 0xd4, 0xfe, 0x2b, 0xff, 0xba, 0xff,
  0xba, 0xff, 0x3b, 0xff, 0x7d, 0xff, 0x65, 0x00, 0xa5, 0x00, 0x8f, 0x00,
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
};
const unsigned int vocab_hot_len = 16000;
