IowaScaledEngineering/ckt-defect/src/ckt-defect/vocab/include/impact.h

const unsigned char vocab_impact[] = {
  0x00, 0x00, 0x00, 0x00, 0x04, 0x00, 0x07, 0x00, 0xfd, 0xff, 0xf3, 0xff,
  0xfa, 0xff, 0x0c, 0x00, 0x09, 0x00, 0xf9, 0xff, 0xf3, 0xff, 0xff, 0xff,
  0xf4, 0xff, 0xe6, 0xff, 0x02, 0x00, 0x54, 0x00, 0x4f, 0x00, 0xca, 0xff,
  0x5e, 0xff, 0x1c, 0x00, 0xb5, 0x00, 0x58, 0x00, 0x37, 0xff, 0x27, 0xff,
  0x3c, 0x00, 0xe8, 0x00, 0x91, 0x00, 0x8f, 0xff, 0x11, 0xff, 0x88, 0xff,
  0x66, 0x00, 0xd5, 0x00, 0x70, 0x00, 0xc3, 0xff, 0x56, 0xff, 0x88, 0xff,
  0x57, 0x00, 0xe6, 0x00, 0x65, 0x00, 0x81, 0xff, 0x41, 0xff, 0x08, 0x00,
  0xa9, 0x00, 0x3a, 0x00, 0x52, 0xff, 0x1e, 0xff, 0x2a, 0x00, 0xe4, 0x00,
  0x8f, 0x00, 0xd1, 0xff, 0xc9, 0xff, 0xb8, 0xff, 0xad, 0xff, 0xf0, 0xff,
  0xaf, 0x00, 0x90, 0x00, 0x90, 0xff, 0x68, 0xff, 0x8c, 0x00, 0x05, 0x01,
  0x73, 0xff, 0xfa, 0xfd, 0xd7, 0xfe, 0x7c, 0x01, 0xdc, 0x01, 0xf0, 0xff,
  0x19, 0x00, 0x79, 0x01, 0x88, 0x00, 0xcc, 0xfc, 0x2a, 0xfd, 0xb1, 0xff,
  0x50, 0x05, 0x59, 0x04, 0x62, 0xfc, 0xa9, 0xf8, 0xad, 0xfe, 0x1f, 0x04,
  0xc6, 0x01, 0xe4, 0xfe, 0xe3, 0xff, 0xc9, 0xff, 0x30, 0xfe, 0xe0, 0x00,
  0x17, 0x04, 0xd9, 0xff, 0xee, 0xfa, 0x95, 0xfd, 0x9a, 0x04, 0xaa, 0x06,
  0x78, 0x02, 0xbf, 0xfd, 0xac, 0xf9, 0x4a, 0xfc, 0x08, 0x05, 0x66, 0x0b,
  0x79, 0x05, 0xbb, 0xfa, 0x06, 0xf6, 0x4f, 0xfa, 0xd7, 0x02, 0x9e, 0x03,
  0x05, 0xfd, 0xeb, 0xf7, 0x86, 0xfa, 0xce, 0x00, 0x43, 0x03, 0x84, 0x00,
  0x42, 0xff, 0x8e, 0xfd, 0x42, 0xfe, 0x2e, 0x03, 0xd6, 0x08, 0xe7, 0x05,
  0x8c, 0xfd, 0x6c, 0xfb, 0xe7, 0x02, 0xd4, 0x08, 0xd0, 0x05, 0xd9, 0xfd,
  0x6f, 0xfa, 0x9c, 0xfd, 0x88, 0x02, 0x03, 0x02, 0x7a, 0x00, 0x22, 0xfe,
  0xa4, 0xfa, 0xe2, 0xf8, 0xec, 0xfe, 0xfc, 0x05, 0x42, 0x04, 0xd8, 0xfa,
  0x89, 0xf7, 0x60, 0xfe, 0x88, 0x04, 0x22, 0x03, 0xfe, 0xfc, 0x16, 0xf9,
  0xd5, 0xfb, 0xcb, 0x02, 0xb0, 0x06, 0x7c, 0x07, 0x40, 0x02, 0x61, 0xfc,
  0x95, 0xfc, 0xb0, 0x02, 0x28, 0x09, 0x93, 0x08, 0xb5, 0x01, 0xc4, 0x00,
  0xec, 0xfa, 0x01, 0xf9, 0x62, 0xfb, 0xf9, 0x01, 0x2c, 0x05, 0x62, 0x05,
  0x3f, 0x06, 0x1d, 0xfd, 0xc3, 0xf0, 0x12, 0xf7, 0x10, 0x19, 0xc8, 0x2e,
  0x3d, 0x12, 0x7b, 0xe1, 0xc4, 0xda, 0x2d, 0x00, 0x23, 0x10, 0xf2, 0xfc,
  0xa3, 0xf3, 0xf6, 0x00, 0x22, 0x00, 0xa3, 0xee, 0xcb, 0xe7, 0x9b, 0xef,
  0xc3, 0xf3, 0x65, 0xf5, 0x2b, 0x00, 0x0c, 0x0b, 0x72, 0x05, 0xb6, 0xf5,
  0xf0, 0xea, 0x71, 0xf1, 0x90, 0x0a, 0x0b, 0x1f, 0xb7, 0x17, 0xf1, 0xff,
  0x05, 0xfc, 0xa9, 0x0c, 0x7c, 0x14, 0x60, 0x09, 0xfb, 0x04, 0x15, 0x0f,
  0xd9, 0x15, 0x05, 0x0b, 0xaf, 0xfe, 0x7d, 0xfd, 0x1d, 0xff, 0x79, 0xf8,
  0xb7, 0xf5, 0x2e, 0x01, 0x76, 0x0c, 0x7d, 0xfd, 0xf9, 0xe1, 0x50, 0xdc,
  0x0a, 0xf3, 0xfc, 0x06, 0x83, 0x02, 0x0e, 0xf4, 0xab, 0xf2, 0x84, 0xf9,
  0x42, 0xfe, 0x29, 0xfe, 0x06, 0x00, 0x79, 0x03, 0x50, 0x08, 0x3b, 0x0d,
  0x4d, 0x11, 0xb7, 0x0d, 0x82, 0x04, 0xfe, 0xfd, 0xe8, 0x04, 0x0d, 0x12,
  0x69, 0x16, 0xe9, 0x0a, 0x46, 0xfc, 0xba, 0xf5, 0x23, 0xfb, 0xee, 0x00,
  0xad, 0xff, 0x22, 0xf8, 0x7c, 0xf4, 0x1d, 0xf5, 0xac, 0xf7, 0x43, 0xf5,
  0xf0, 0xf0, 0xa3, 0xf1, 0x9d, 0xfa, 0xed, 0x02, 0xfd, 0x02, 0x8c, 0xfb,
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
};
const unsigned int vocab_impact_len = 23454;
