IowaScaledEngineering/ckt-defect/src/ckt-defect/vocab/include/integrity.h

const unsigned char vocab_integrity[] = {
  0x00, 0x00, 0x03, 0x00, 0x02, 0x00, 0x02, 0x00, 0x06, 0x00, 0x0a, 0x00,
  0x10, 0x00, 0x2d, 0x00, 0x5b, 0x00, 0x51, 0x00, 0xfb, 0xff, 0xbd, 0xff,
  0xf4, 0xff, 0x50, 0x00, 0x43, 0x00, 0xf1, 0xff, 0xca, 0xff, 0xce, 0xff,
  0x9c, 0xff, 0x62, 0xff, 0x7c, 0xff, 0xb1, 0xff, 0x7a, 0xff, 0x0d, 0xff,
  0x14, 0xff, 0x79, 0xff, 0x7a, 0xff, 0x0f, 0xff, 0xf6, 0xfe, 0x72, 0xff,
  0xe4, 0xff, 0xef, 0xff, 0xd4, 0xff, 0xf2, 0xff, 0x21, 0x00, 0x73, 0x00,
  0xf2, 0x00, 0x73, 0x01, 0x7a, 0x01, 0x0c, 0x01, 0xe7, 0x00, 0x4b, 0x01,
  0xbd, 0x01, 0xbb, 0x01, 0x57, 0x01, 0x0d, 0x01, 0xc8, 0x00, 0xa3, 0x00,
  0x8f, 0x00, 0x73, 0x00, 0x11, 0x00, 0x74, 0xff, 0x2b, 0xff, 0x4f, 0xff,
  0x55, 0xff, 0xdc, 0xfe, 0x43, 0xfe, 0x29, 0xfe, 0x6c, 0xfe, 0xb1, 0xfe,
  0xaf, 0xfe, 0x86, 0xfe, 0x60, 0xfe, 0x81, 0xfe, 0xde, 0xfe, 0x4b, 0xff,
  0x86, 0xff, 0xb6, 0xff, 0xe8, 0xff, 0x13, 0x00, 0x59, 0x00, 0xab, 0x00,
  0xe4, 0x00, 0xed, 0x00, 0x0c, 0x01, 0x9d, 0x01, 0xf0, 0x01, 0x93, 0x01,
  0xff, 0x00, 0x20, 0x01, 0xc7, 0x01, 0xbe, 0x01, 0x10, 0x01, 0xd3, 0x00,
  0x0a, 0x01, 0xc0, 0x00, 0x7b, 0xff, 0x39, 0xff, 0x71, 0x00, 0x8a, 0x01,
  0xd2, 0x00, 0x9f, 0xff, 0xc7, 0xff, 0x1b, 0x00, 0x8f, 0xff, 0x4a, 0x00,
  0xfa, 0x03, 0x0c, 0x06, 0x64, 0x01, 0x97, 0xfa, 0xa1, 0xfa, 0x9b, 0x01,
  0xcc, 0x04, 0x97, 0x00, 0x07, 0xfc, 0x02, 0xfc, 0x21, 0xfd, 0x4e, 0xfc,
  0xcd, 0xfc, 0xf3, 0xfe, 0x3d, 0xfe, 0x5b, 0xfa, 0xae, 0xf9, 0x62, 0xfd,
  0xcf, 0xfe, 0x17, 0xfc, 0x7e, 0xfa, 0x7b, 0xfd, 0x8f, 0x00, 0x5c, 0x00,
  0x00, 0xff, 0x28, 0xff, 0x1d, 0x00, 0x4d, 0x01, 0x52, 0x03, 0x62, 0x05,
  0x30, 0x05, 0x0f, 0x03, 0x66, 0x02, 0x6b, 0x04, 0xeb, 0x06, 0x0f, 0x07,
  0x40, 0x05, 0xbd, 0x03, 0xcd, 0x03, 0x93, 0x04, 0x05, 0x04, 0x76, 0x02,
  0x51, 0x01, 0xfc, 0x00, 0x78, 0x00, 0xbc, 0xff, 0x63, 0xff, 0xb1, 0xfe,
  0xe4, 0xfc, 0x8a, 0xfb, 0xc1, 0xfc, 0x64, 0xfe, 0xad, 0xfc, 0x74, 0xf9,
  0x29, 0xf9, 0xc0, 0xfb, 0xb9, 0xfc, 0x78, 0xfb, 0x48, 0xfb, 0x40, 0xfc,
  0x15, 0xfc, 0x8a, 0xfb, 0x77, 0xfd, 0xe5, 0xff, 0x5e, 0xff, 0x25, 0xfe,
  0xc6, 0xff, 0x94, 0x02, 0xce, 0x02, 0xad, 0x01, 0xdb, 0x01, 0x8f, 0x03,
  0xa0, 0x04, 0xb6, 0x04, 0x4b, 0x04, 0x9c, 0x03, 0x56, 0x03, 0x84, 0x03,
  0x4e, 0x04, 0xcd, 0x04, 0xba, 0x03, 0xd1, 0x01, 0x3a, 0x00, 0x60, 0x00,
  0x38, 0x01, 0xfe, 0x00, 0x4d, 0xff, 0xd6, 0xfd, 0x13, 0xfd, 0x4c, 0xfd,
  0x9a, 0xfd, 0x4c, 0xfd, 0xf3, 0xfc, 0x18, 0xfc, 0xd4, 0xfb, 0x5e, 0xfb,
  0xd8, 0xfb, 0x35, 0xfd, 0x07, 0xff, 0x82, 0xff, 0x2d, 0xff, 0xc1, 0xff,
  0x38, 0x00, 0x1e, 0xff, 0xc9, 0xff, 0x04, 0x07, 0xdc, 0x0e, 0x83, 0x0b,
  0xa5, 0xff, 0xb7, 0xfa, 0x19, 0x04, 0x45, 0x0c, 0x0d, 0x0a, 0x31, 0x03,
  0xcd, 0x01, 0x6e, 0x01, 0x22, 0xfe, 0xf4, 0xfd, 0x4d, 0x02, 0xab, 0x01,
  0x63, 0xf9, 0x2c, 0xf5, 0xbd, 0xfa, 0x73, 0xfd, 0xd2, 0xf7, 0xc1, 0xf2,
  0x76, 0xf5, 0x9d, 0xf9, 0x0b, 0xfa, 0xa9, 0xf8, 0xc4, 0xf7, 0x3e, 0xf6,
  0x9e, 0xf6, 0x56, 0xfc, 0x4c, 0x03, 0xbe, 0x03, 0x7d, 0xfe, 0x06, 0xfc,
  0xb8, 0x00, 0xb7, 0x07, 0xb4, 0x0a, 0xcd, 0x08, 0x4e, 0x06, 0xa7, 0x06,
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
};
const unsigned int vocab_integrity_len = 28010;
