IowaScaledEngineering/ckt-defect/src/ckt-defect/vocab/include/journal.h

const unsigned char vocab_journal[] = {
  0x00, 0x00, 0x03, 0x00, 0x0d, 0x00, 0x0e, 0x00, 0x09, 0x00, 0xe9, 0xff,
  0x92, 0xff, 0x9e, 0xff, 0x1c, 0x00, 0x3a, 0x00, 0xee, 0xff, 0x01, 0x00,
  0x59, 0x00, 0x6b, 0x00, 0xf1, 0xff, 0x8f, 0xff, 0x97, 0xff, 0xf5, 0xff,
  0x47, 0x00, 0x4f, 0x00, 0x42, 0x00, 0xf6, 0xff, 0xcd, 0xff, 0x08, 0x00,
  0x76, 0x00, 0x4c, 0x00, 0xe1, 0xff, 0x8f, 0xff, 0xc2, 0xff, 0x3d, 0x00,
  0x9b, 0x00, 0x5e, 0x00, 0xfd, 0xff, 0x76, 0xff, 0xb8, 0xff, 0x26, 0x00,
  0x78, 0x00, 0x53, 0x00, 0xc4, 0xff, 0x5b, 0xff, 0x78, 0xff, 0x10, 0x00,
  0x33, 0x00, 0x28, 0x00, 0xb5, 0xff, 0x70, 0xff, 0xa7, 0xff, 0x10, 0x00,
  0x52, 0x00, 0x0c, 0x00, 0xf1, 0xff, 0x17, 0x00, 0x01, 0x00, 0xdc, 0xff,
  0xff, 0xff, 0x12, 0x00, 0x62, 0x00, 0x10, 0x00, 0xbc, 0xff, 0xb9, 0xff,
  0x40, 0x00, 0x2c, 0x00, 0x4c, 0x00, 0x47, 0x00, 0xd6, 0xff, 0x1c, 0x00,
  0x19, 0x00, 0x8f, 0xff, 0x5c, 0x00, 0xf7, 0xff, 0xa2, 0xff, 0xfb, 0x00,
  0xed, 0xff, 0x4a, 0xff, 0x61, 0x00, 0xea, 0xfe, 0x09, 0xff, 0xff, 0xff,
  0x6a, 0x01, 0x58, 0x01, 0x63, 0x00, 0xd6, 0xfe, 0xea, 0xfd, 0xdb, 0xfe,
  0xed, 0x01, 0xe4, 0x03, 0x7e, 0xff, 0x89, 0xfb, 0xd2, 0xfe, 0xb1, 0x02,
  0x78, 0x03, 0x46, 0x00, 0x20, 0xfe, 0x18, 0xfd, 0x6c, 0xff, 0x23, 0x01,
  0xcf, 0x02, 0xbc, 0x01, 0x47, 0xff, 0x53, 0xfc, 0x4b, 0xff, 0x55, 0x00,
  0x06, 0xff, 0x37, 0x02, 0x27, 0xff, 0xa1, 0x04, 0x41, 0x01, 0x06, 0xfa,
  0xff, 0x02, 0xf4, 0xfd, 0xde, 0xfd, 0xed, 0x03, 0x14, 0x04, 0xaf, 0xfe,
  0x8e, 0xf9, 0xec, 0xfa, 0xb8, 0x00, 0x0b, 0x04, 0x1e, 0x02, 0x91, 0xfe,
  0x40, 0x02, 0xcf, 0xfc, 0x90, 0xfd, 0xee, 0x00, 0x15, 0x03, 0xc9, 0x00,
  0x3f, 0x01, 0xe1, 0x02, 0x34, 0xfb, 0xb2, 0xfe, 0xb9, 0x01, 0x6f, 0x01,
  0xa3, 0xfc, 0xac, 0x01, 0x5b, 0x01, 0xa9, 0xfd, 0xfc, 0xfd, 0xb9, 0xfc,
  0x2d, 0x01, 0xab, 0x07, 0xc7, 0x00, 0x04, 0xfe, 0xc9, 0xff, 0xcf, 0xfa,
  0xd1, 0x00, 0x47, 0x03, 0x65, 0x05, 0x6f, 0x04, 0x97, 0xf7, 0x92, 0xfc,
  0xa6, 0x05, 0x2c, 0x03, 0xca, 0xfd, 0xda, 0x02, 0xd0, 0xfd, 0x6b, 0xfd,
  0x07, 0x04, 0xdc, 0xfc, 0x64, 0xf9, 0xc1, 0xfe, 0xbe, 0x00, 0xfb, 0x04,
  0xef, 0x05, 0xa6, 0xfd, 0xce, 0xf9, 0x4a, 0xfe, 0x5c, 0x02, 0x67, 0x07,
  0xa3, 0x00, 0x62, 0xfc, 0xc8, 0xf9, 0x20, 0xfe, 0x1f, 0x06, 0xea, 0xfe,
  0x83, 0xff, 0x60, 0xff, 0x0f, 0xfa, 0xd4, 0x03, 0x9e, 0x04, 0x1a, 0xfe,
  0x4a, 0x01, 0x6c, 0xf7, 0x83, 0x00, 0x81, 0x06, 0xf7, 0x01, 0x4e, 0xff,
  0xa6, 0xfa, 0xe8, 0xfe, 0xf4, 0x00, 0x9d, 0x0b, 0x55, 0xff, 0xa2, 0xf8,
  0x98, 0xf6, 0x46, 0x02, 0x5f, 0x06, 0x71, 0x00, 0x51, 0xfc, 0x53, 0x01,
  0xb6, 0x00, 0xbf, 0xf9, 0xe3, 0x05, 0xf0, 0x0c, 0x3d, 0x0c, 0x04, 0xe9,
  0x69, 0xef, 0x63, 0xf9, 0x1a, 0x1e, 0x5a, 0x1b, 0xb0, 0xf5, 0xa2, 0xec,
  0xda, 0xe7, 0xf4, 0x07, 0x74, 0x09, 0x44, 0x0a, 0x18, 0x0b, 0x4d, 0x03,
  0x8c, 0xe3, 0x97, 0xf6, 0x0e, 0x02, 0x1e, 0x0e, 0x89, 0x16, 0x5e, 0xfb,
  0x41, 0xf6, 0x50, 0x07, 0x2c, 0x00, 0x45, 0xea, 0xa1, 0xf1, 0x68, 0x09,
  0x83, 0x0f, 0x99, 0x13, 0xb8, 0xe4, 0xf2, 0xec, 0x63, 0x13, 0x58, 0x04,
  0x25, 0x08, 0x92, 0xf3, 0xd4, 0xf3, 0x3a, 0x08, 0xb0, 0x1a, 0xb0, 0xe8,
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
};
const unsigned int vocab_journal_len = 15340;
