IowaScaledEngineering/ckt-defect/src/ckt-defect/vocab/include/left.h

const unsigned char vocab_left[] = {
  0x00, 0x00, 0x00, 0x00, 0x02, 0x00, 0xf8, 0xff, 0xf9, 0xff, 0x07, 0x00,
  0xfc, 0xff, 0xef, 0xff, 0x07, 0x00, 0x08, 0x00, 0xf3, 0xff, 0x06, 0x00,
  0x11, 0x00, 0x00, 0x00, 0x09, 0x00, 0x0b, 0x00, 0x00, 0x00, 0x0b, 0x00,
  0x11, 0x00, 0xf7, 0xff, 0xfa, 0xff, 0x26, 0x00, 0x0a, 0x00, 0xf0, 0xff,
  0x20, 0x00, 0x27, 0x00, 0xe7, 0xff, 0x01, 0x00, 0x24, 0x00, 0xfc, 0xff,
  0xdf, 0xff, 0xeb, 0xff, 0x0d, 0x00, 0xd9, 0xff, 0xba, 0xff, 0xf7, 0xff,
  0xf9, 0xff, 0xba, 0xff, 0xe7, 0xff, 0x3e, 0x00, 0x00, 0x00, 0xbf, 0xff,
  0x4c, 0x00, 0x60, 0x00, 0xe3, 0xff, 0x0a, 0x00, 0x8a, 0x00, 0x33, 0x00,
  0xda, 0xff, 0x43, 0x00, 0x57, 0x00, 0xef, 0xff, 0x18, 0x00, 0x29, 0x00,
  0xe3, 0xff, 0x16, 0x00, 0x00, 0x00, 0xea, 0xff, 0xe8, 0xff, 0xfa, 0xff,
  0xfe, 0xff, 0xe3, 0xff, 0xf1, 0xff, 0xda, 0xff, 0x24, 0x00, 0x7f, 0x00,
  0x2a, 0x00, 0x4f, 0x00, 0xca, 0x00, 0x80, 0x00, 0xfc, 0xff, 0x4f, 0x00,
  0xb6, 0x00, 0x0c, 0x00, 0xbf, 0xff, 0x56, 0x00, 0x60, 0x00, 0xc4, 0xff,
  0xb8, 0xff, 0x2e, 0x00, 0x0d, 0x00, 0x98, 0xff, 0xaf, 0xff, 0xde, 0xff,
  0x81, 0xff, 0x39, 0xff, 0x55, 0xff, 0x13, 0xff, 0xcc, 0xfe, 0xda, 0xfe,
  0xb9, 0xfe, 0x97, 0xfe, 0x81, 0xfe, 0xc3, 0xfe, 0x0b, 0xff, 0x0d, 0xff,
  0xf2, 0xfe, 0x3a, 0xff, 0xb0, 0xff, 0x8f, 0xff, 0x6a, 0xff, 0xa5, 0xff,
  0x23, 0x00, 0x22, 0x00, 0x86, 0xff, 0xe7, 0xff, 0xc0, 0x00, 0x9b, 0x00,
  0x29, 0x00, 0xbc, 0x00, 0x7b, 0x01, 0x4a, 0x01, 0x11, 0x01, 0x95, 0x01,
  0xf4, 0x01, 0x6d, 0x01, 0xed, 0x00, 0x4c, 0x01, 0x53, 0x01, 0xe5, 0x00,
  0xff, 0x00, 0x10, 0x01, 0xbe, 0x00, 0x0f, 0x01, 0x49, 0x01, 0xa3, 0x00,
  0xc3, 0x00, 0x87, 0x01, 0x0c, 0x01, 0x33, 0x00, 0x75, 0x00, 0xce, 0x00,
  0x61, 0x00, 0x75, 0xff, 0x5a, 0xff, 0x28, 0x00, 0xb2, 0xff, 0x91, 0xfe,
  0x1e, 0xff, 0xac, 0xff, 0x0e, 0xff, 0xc6, 0xfe, 0xf5, 0xfe, 0xdd, 0xfe,
  0xc7, 0xfe, 0xa5, 0xfe, 0xc6, 0xfe, 0xc9, 0xfd, 0xe6, 0xfd, 0x27, 0xff,
  0x2d, 0xfe, 0xd9, 0xfc, 0x12, 0xff, 0xb1, 0x00, 0xdd, 0xfe, 0xeb, 0xfd,
  0x7c, 0xff, 0x2f, 0x01, 0x85, 0x00, 0x96, 0xff, 0xf4, 0xfe, 0xcb, 0x00,
  0xf7, 0x00, 0x90, 0x00, 0x96, 0xff, 0x23, 0x00, 0x70, 0x02, 0xda, 0x00,
  0x07, 0xff, 0x94, 0x02, 0xcf, 0x01, 0xaa, 0xff, 0xee, 0x01, 0x1a, 0x02,
  0x4d, 0x00, 0x7a, 0x00, 0x71, 0x01, 0xc5, 0x01, 0xe5, 0x00, 0x15, 0xff,
  0x23, 0x00, 0x76, 0x01, 0xf5, 0xff, 0x5a, 0xff, 0xc9, 0xff, 0xf6, 0xff,
  0x4b, 0x00, 0x2a, 0xff, 0x62, 0xff, 0x27, 0x01, 0x86, 0xfd, 0xac, 0xfd,
  0xd2, 0x01, 0xfb, 0xfd, 0xa7, 0xfc, 0xb3, 0xff, 0x4b, 0x02, 0xfc, 0xfd,
  0x7b, 0xfc, 0xb4, 0x01, 0xe4, 0x02, 0xc4, 0xfd, 0x41, 0xfd, 0x90, 0x02,
  0xb0, 0x03, 0x1f, 0x01, 0xca, 0x00, 0x39, 0x04, 0x55, 0x07, 0x5d, 0x05,
  0x97, 0x04, 0x80, 0x06, 0xbc, 0x06, 0xad, 0x05, 0xeb, 0x02, 0x04, 0x02,
  0x39, 0x03, 0x10, 0x02, 0x66, 0xfe, 0x39, 0xfd, 0x79, 0xfe, 0xbd, 0xfe,
  0x76, 0xfc, 0x5a, 0xfa, 0x3b, 0xfb, 0x2a, 0xfd, 0x2d, 0xfb, 0x98, 0xf8,
  0xce, 0xf9, 0xed, 0xf9, 0xfa, 0xf7, 0xff, 0xf6, 0xae, 0xf5, 0x7c, 0xf6,
  0x53, 0xf7, 0xb9, 0xf5, 0x79, 0xf5, 0x6b, 0xf9, 0x9f, 0xfb, 0x88, 0xfa,
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
};
const unsigned int vocab_left_len = 19548;
