IowaScaledEngineering/ckt-defect/src/ckt-defect/vocab/include/milepost.h

const unsigned char vocab_milepost[] = {
  0x00, 0x00, 0xfe, 0xff, 0xfd, 0xff, 0xfa, 0xff, 0xf9, 0xff, 0xf7, 0xff,
  0xf8, 0xff, 0xf9, 0xff, 0xfc, 0xff, 0xfc, 0xff, 0xff, 0xff, 0x00, 0x00,
  0x04, 0x00, 0x07, 0x00, 0x0b, 0x00, 0x0c, 0x00, 0x0f, 0x00, 0x13, 0x00,
  0x19, 0x00, 0x19, 0x00, 0x1e, 0x00, 0x23, 0x00, 0x2b, 0x00, 0x2c, 0x00,
  0x2e, 0x00, 0x2f, 0x00, 0x31, 0x00, 0x2c, 0x00, 0x2c, 0x00, 0x26, 0x00,
  0x23, 0x00, 0x20, 0x00, 0x24, 0x00, 0x1a, 0x00, 0x13, 0x00, 0x0c, 0x00,
  0x0f, 0x00, 0x09, 0x00, 0xff, 0xff, 0xf2, 0xff, 0xf0, 0xff, 0xef, 0xff,
  0xed, 0xff, 0xde, 0xff, 0xdb, 0xff, 0xe1, 0xff, 0xed, 0xff, 0xe6, 0xff,
  0xd6, 0xff, 0xd0, 0xff, 0xe1, 0xff, 0xe4, 0xff, 0xe2, 0xff, 0xd8, 0xff,
  0xdb, 0xff, 0xe4, 0xff, 0xf7, 0xff, 0xf5, 0xff, 0xf1, 0xff, 0xec, 0xff,
  0xfb, 0xff, 0xfd, 0xff, 0xf3, 0xff, 0xdc, 0xff, 0xf0, 0xff, 0xf9, 0xff,
  0xeb, 0xff, 0xd2, 0xff, 0xe6, 0xff, 0xfc, 0xff, 0x05, 0x00, 0xf3, 0xff,
  0xf2, 0xff, 0x00, 0x00, 0x13, 0x00, 0x10, 0x00, 0x03, 0x00, 0xe6, 0xff,
  0xea, 0xff, 0xea, 0xff, 0xe6, 0xff, 0xce, 0xff, 0xcc, 0xff, 0xdf, 0xff,
  0x0d, 0x00, 0x13, 0x00, 0x14, 0x00, 0x27, 0x00, 0x46, 0x00, 0x30, 0x00,
  0x13, 0x00, 0x05, 0x00, 0x18, 0x00, 0x05, 0x00, 0xe2, 0xff, 0xc4, 0xff,
  0xe8, 0xff, 0x0c, 0x00, 0x2c, 0x00, 0x34, 0x00, 0x45, 0x00, 0x57, 0x00,
  0x78, 0x00, 0x67, 0x00, 0x3a, 0x00, 0x02, 0x00, 0xfe, 0xff, 0xfa, 0xff,
  0xe1, 0xff, 0xb9, 0xff, 0xbf, 0xff, 0xd5, 0xff, 0x04, 0x00, 0x0f, 0x00,
  0x11, 0x00, 0x16, 0x00, 0x35, 0x00, 0x2d, 0x00, 0x1a, 0x00, 0xf3, 0xff,
  0xec, 0xff, 0xd7, 0xff, 0xc2, 0xff, 0xbb, 0xff, 0xcc, 0xff, 0xc4, 0xff,
  0xdb, 0xff, 0xf4, 0xff, 0x11, 0x00, 0x17, 0x00, 0x2e, 0x00, 0x39, 0x00,
  0x44, 0x00, 0x2d, 0x00, 0x2a, 0x00, 0x30, 0x00, 0x3c, 0x00, 0x1c, 0x00,
  0x09, 0x00, 0x11, 0x00, 0x3d, 0x00, 0x3f, 0x00, 0x4d, 0x00, 0x33, 0x00,
  0x1b, 0x00, 0xe9, 0xff, 0xfe, 0xff, 0x2b, 0x00, 0x67, 0x00, 0x72, 0x00,
  0x8d, 0x00, 0xa0, 0x00, 0x8e, 0x00, 0x35, 0x00, 0xf9, 0xff, 0xd4, 0xff,
  0xd1, 0xff, 0x95, 0xff, 0x93, 0xff, 0xa2, 0xff, 0xdc, 0xff, 0xf6, 0xff,
  0xdc, 0xff, 0xa6, 0xff, 0xa1, 0xff, 0x88, 0xff, 0x5e, 0xff, 0xfc, 0xfe,
  0xc1, 0xfe, 0xaf, 0xfe, 0xf5, 0xfe, 0x02, 0xff, 0x02, 0xff, 0x0d, 0xff,
  0x29, 0xff, 0x27, 0xff, 0x33, 0xff, 0x2d, 0xff, 0x40, 0xff, 0x69, 0xff,
  0xb0, 0xff, 0xbd, 0xff, 0xe4, 0xff, 0xf4, 0xff, 0x30, 0x00, 0x41, 0x00,
  0x50, 0x00, 0x51, 0x00, 0x8d, 0x00, 0xb4, 0x00, 0xdc, 0x00, 0xdf, 0x00,
  0xfa, 0x00, 0x08, 0x01, 0x31, 0x01, 0x2d, 0x01, 0x30, 0x01, 0x10, 0x01,
  0x09, 0x01, 0xf3, 0x00, 0xde, 0x00, 0xb1, 0x00, 0xd6, 0x00, 0xf1, 0x00,
  0xfd, 0x00, 0xca, 0x00, 0xac, 0x00, 0xa5, 0x00, 0xca, 0x00, 0xc0, 0x00,
  0xb6, 0x00, 0x99, 0x00, 0x7e, 0x00, 0x5e, 0x00, 0x58, 0x00, 0x0e, 0x00,
  0xd2, 0xff, 0xa6, 0xff, 0xb9, 0xff, 0xae, 0xff, 0xc1, 0xff, 0xc1, 0xff,
  0xbe, 0xff, 0x76, 0xff, 0x46, 0xff, 0x23, 0xff, 0x16, 0xff, 0xe8, 0xfe,
  0xf1, 0xfe, 0xe1, 0xfe, 0xd7, 0xfe, 0xd1, 0xfe, 0x03, 0xff, 0x04, 0xff,
  0x0e, 0xff, 0xf3, 0xfe, 0x26, 0xff, 0x83, 0xff, 0xc1, 0xff, 0xd3, 0xff,
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
};
const unsigned int vocab_milepost_len = 30600;
