IowaScaledEngineering/ckt-defect/src/ckt-defect/vocab/include/minus.h

const unsigned char vocab_minus[] = {
  0x00, 0x00, 0xff, 0xff, 0x00, 0x00, 0x00, 0x00, 0x02, 0x00, 0x02, 0x00,
  0x02, 0x00, 0xfe, 0xff, 0xfb, 0xff, 0xf6, 0xff, 0xf6, 0xff, 0xf6, 0xff,
  0xfd, 0xff, 0x01, 0x00, 0x08, 0x00, 0x07, 0x00, 0x08, 0x00, 0x05, 0x00,
  0x02, 0x00, 0xfc, 0xff, 0x00, 0x00, 0x00, 0x00, 0x06, 0x00, 0x07, 0x00,
  0x0e, 0x00, 0x0b, 0x00, 0x07, 0x00, 0x04, 0x00, 0x09, 0x00, 0x09, 0x00,
  0x0e, 0x00, 0x0b, 0x00, 0x0b, 0x00, 0x01, 0x00, 0xfb, 0xff, 0xf5, 0xff,
  0xfc, 0xff, 0xf2, 0xff, 0xf0, 0xff, 0xf8, 0xff, 0x09, 0x00, 0x0b, 0x00,
  0x0d, 0x00, 0x03, 0x00, 0xff, 0xff, 0xf5, 0xff, 0xf1, 0xff, 0xf0, 0xff,
  0xf8, 0xff, 0xfe, 0xff, 0x0a, 0x00, 0x09, 0x00, 0x11, 0x00, 0x0a, 0x00,
  0x13, 0x00, 0x0d, 0x00, 0x0f, 0x00, 0x06, 0x00, 0x09, 0x00, 0x02, 0x00,
  0x06, 0x00, 0xf7, 0xff, 0xf5, 0xff, 0xe9, 0xff, 0xeb, 0xff, 0xec, 0xff,
  0xed, 0xff, 0xee, 0xff, 0xf6, 0xff, 0xe8, 0xff, 0xf9, 0xff, 0xfe, 0xff,
  0x0a, 0x00, 0x10, 0x00, 0x15, 0x00, 0x0f, 0x00, 0x0f, 0x00, 0x0d, 0x00,
  0x15, 0x00, 0x0e, 0x00, 0x14, 0x00, 0x00, 0x00, 0x0b, 0x00, 0x05, 0x00,
  0x0c, 0x00, 0xfe, 0xff, 0xfc, 0xff, 0xed, 0xff, 0xf0, 0xff, 0xe1, 0xff,
  0xea, 0xff, 0xef, 0xff, 0xf3, 0xff, 0xf2, 0xff, 0x00, 0x00, 0xfa, 0xff,
  0xff, 0xff, 0xf9, 0xff, 0x13, 0x00, 0x16, 0x00, 0x25, 0x00, 0x23, 0x00,
  0x21, 0x00, 0x1b, 0x00, 0x0a, 0x00, 0xfa, 0xff, 0x0a, 0x00, 0x0d, 0x00,
  0x10, 0x00, 0xff, 0xff, 0xe9, 0xff, 0xd4, 0xff, 0xd9, 0xff, 0xe8, 0xff,
  0xf2, 0xff, 0x06, 0x00, 0x1d, 0x00, 0x10, 0x00, 0x00, 0x00, 0xe2, 0xff,
  0x07, 0x00, 0x02, 0x00, 0x02, 0x00, 0xea, 0xff, 0x14, 0x00, 0x10, 0x00,
  0x1d, 0x00, 0x0c, 0x00, 0x13, 0x00, 0xff, 0xff, 0xeb, 0xff, 0xc8, 0xff,
  0xce, 0xff, 0xc9, 0xff, 0xf7, 0xff, 0x09, 0x00, 0x30, 0x00, 0x3e, 0x00,
  0x5d, 0x00, 0x4c, 0x00, 0x35, 0x00, 0xf9, 0xff, 0x05, 0x00, 0x1e, 0x00,
  0x3c, 0x00, 0x41, 0x00, 0x49, 0x00, 0x4e, 0x00, 0x30, 0x00, 0x07, 0x00,
  0x3b, 0x00, 0x5e, 0x00, 0x77, 0x00, 0x5e, 0x00, 0x52, 0x00, 0x1b, 0x00,
  0xd7, 0xff, 0x80, 0xff, 0x6b, 0xff, 0x50, 0xff, 0x6c, 0xff, 0x8e, 0xff,
  0xac, 0xff, 0x8c, 0xff, 0x96, 0xff, 0x7f, 0xff, 0x58, 0xff, 0x04, 0xff,
  0x01, 0xff, 0xeb, 0xfe, 0xd1, 0xfe, 0xb5, 0xfe, 0xe8, 0xfe, 0x09, 0xff,
  0x23, 0xff, 0x36, 0xff, 0x97, 0xff, 0xb1, 0xff, 0xbf, 0xff, 0x9f, 0xff,
  0xce, 0xff, 0xe0, 0xff, 0x0d, 0x00, 0x21, 0x00, 0x45, 0x00, 0x61, 0x00,
  0x83, 0x00, 0x8f, 0x00, 0x96, 0x00, 0x8b, 0x00, 0xc5, 0x00, 0xcf, 0x00,
  0xe8, 0x00, 0x0c, 0x01, 0x56, 0x01, 0x46, 0x01, 0x40, 0x01, 0x30, 0x01,
  0x59, 0x01, 0x4c, 0x01, 0x2c, 0x01, 0xfc, 0x00, 0xf1, 0x00, 0xb0, 0x00,
  0xa5, 0x00, 0x88, 0x00, 0x9c, 0x00, 0x99, 0x00, 0x97, 0x00, 0x65, 0x00,
  0x5b, 0x00, 0x38, 0x00, 0x38, 0x00, 0x1f, 0x00, 0x1a, 0x00, 0xed, 0xff,
  0xeb, 0xff, 0xba, 0xff, 0xb8, 0xff, 0x8c, 0xff, 0x87, 0xff, 0x8a, 0xff,
  0xb4, 0xff, 0xc5, 0xff, 0xf1, 0xff, 0x00, 0x00, 0x16, 0x00, 0xdd, 0xff,
  0xc1, 0xff, 0x69, 0xff, 0x4f, 0xff, 0x17, 0xff, 0x21, 0xff, 0xfc, 0xfe,
  0x2c, 0xff, 0x2f, 0xff, 0x29, 0xff, 0xd5, 0xfe, 0xb3, 0xfe, 0x6e, 0xfe,
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
};
const unsigned int vocab_minus_len = 23342;
