IowaScaledEngineering/ckt-defect/src/ckt-defect/vocab/include/near.h

const unsigned char vocab_near[] = {
  0x00, 0x00, 0x03, 0x00, 0x05, 0x00, 0x04, 0x00, 0x02, 0x00, 0x00, 0x00,
  0xfe, 0xff, 0xfb, 0xff, 0xfe, 0xff, 0x01, 0x00, 0x00, 0x00, 0xf9, 0xff,
  0xf8, 0xff, 0xf9, 0xff, 0xee, 0xff, 0xd9, 0xff, 0xd3, 0xff, 0xe0, 0xff,
  0xe9, 0xff, 0xe3, 0xff, 0xe3, 0xff, 0xe2, 0xff, 0xc9, 0xff, 0xa7, 0xff,
  0xaa, 0xff, 0xd1, 0xff, 0xe8, 0xff, 0xdf, 0xff, 0xe6, 0xff, 0x00, 0x00,
  0x01, 0x00, 0xe6, 0xff, 0xdb, 0xff, 0xf3, 0xff, 0x00, 0x00, 0xfd, 0xff,
  0x16, 0x00, 0x45, 0x00, 0x51, 0x00, 0x2d, 0x00, 0x10, 0x00, 0x14, 0x00,
  0x1b, 0x00, 0x18, 0x00, 0x25, 0x00, 0x48, 0x00, 0x55, 0x00, 0x46, 0x00,
  0x37, 0x00, 0x3a, 0x00, 0x38, 0x00, 0x20, 0x00, 0x0e, 0x00, 0x1f, 0x00,
  0x40, 0x00, 0x45, 0x00, 0x35, 0x00, 0x2b, 0x00, 0x21, 0x00, 0x04, 0x00,
  0xee, 0xff, 0xff, 0xff, 0x25, 0x00, 0x32, 0x00, 0x2a, 0x00, 0x26, 0x00,
  0x22, 0x00, 0x10, 0x00, 0xf0, 0xff, 0xd4, 0xff, 0xd3, 0xff, 0xda, 0xff,
  0xe5, 0xff, 0xf9, 0xff, 0x19, 0x00, 0x25, 0x00, 0x0c, 0x00, 0xde, 0xff,
  0xd3, 0xff, 0xe6, 0xff, 0xf8, 0xff, 0xf4, 0xff, 0xfc, 0xff, 0x01, 0x00,
  0xed, 0xff, 0xc7, 0xff, 0xc8, 0xff, 0xe3, 0xff, 0xeb, 0xff, 0xd5, 0xff,
  0xdc, 0xff, 0xf6, 0xff, 0xea, 0xff, 0xc2, 0xff, 0xb2, 0xff, 0xc1, 0xff,
  0xd0, 0xff, 0xc9, 0xff, 0xdd, 0xff, 0xf5, 0xff, 0xfb, 0xff, 0xde, 0xff,
  0xce, 0xff, 0xd6, 0xff, 0xe0, 0xff, 0xd5, 0xff, 0xd6, 0xff, 0xe3, 0xff,
  0xec, 0xff, 0xda, 0xff, 0xcf, 0xff, 0xdb, 0xff, 0xf1, 0xff, 0xf7, 0xff,
  0xfd, 0xff, 0x06, 0x00, 0x1a, 0x00, 0x1a, 0x00, 0xf8, 0xff, 0xe3, 0xff,
  0xfe, 0xff, 0x22, 0x00, 0x2e, 0x00, 0x30, 0x00, 0x3d, 0x00, 0x4d, 0x00,
  0x32, 0x00, 0x18, 0x00, 0x2b, 0x00, 0x5b, 0x00, 0x60, 0x00, 0x4c, 0x00,
  0x53, 0x00, 0x7c, 0x00, 0x68, 0x00, 0x36, 0x00, 0x18, 0x00, 0x34, 0x00,
  0x3b, 0x00, 0x3e, 0x00, 0x5a, 0x00, 0x6f, 0x00, 0x4b, 0x00, 0x0e, 0x00,
  0xec, 0xff, 0xe2, 0xff, 0xf9, 0xff, 0x00, 0x00, 0x41, 0x00, 0x75, 0x00,
  0x8e, 0x00, 0x55, 0x00, 0x1f, 0x00, 0xef, 0xff, 0x06, 0x00, 0x7a, 0x00,
  0x22, 0x01, 0x57, 0x01, 0xef, 0x00, 0x34, 0x00, 0xc4, 0xff, 0x7c, 0xff,
  0x90, 0xff, 0xcf, 0xff, 0x36, 0x00, 0x4a, 0x00, 0x15, 0x00, 0xce, 0xff,
  0xa9, 0xff, 0x51, 0xff, 0xe0, 0xfe, 0xbe, 0xfe, 0x31, 0xff, 0xab, 0xff,
  0xc3, 0xff, 0x73, 0xff, 0xfe, 0xfe, 0x73, 0xfe, 0xda, 0xfd, 0xc4, 0xfd,
  0x66, 0xfe, 0x45, 0xff, 0xc2, 0xff, 0xc7, 0xff, 0x92, 0xff, 0x42, 0xff,
  0xab, 0xfe, 0x5a, 0xfe, 0xa9, 0xfe, 0x6b, 0xff, 0x1e, 0x00, 0x7e, 0x00,
  0xc8, 0x00, 0xe2, 0x00, 0x6d, 0x00, 0xca, 0xff, 0x91, 0xff, 0xef, 0xff,
  0x47, 0x00, 0x9d, 0x00, 0x0e, 0x01, 0x67, 0x01, 0x3b, 0x01, 0xbd, 0x00,
  0x91, 0x00, 0xad, 0x00, 0xba, 0x00, 0xbf, 0x00, 0xfd, 0x00, 0x46, 0x01,
  0x31, 0x01, 0xf1, 0x00, 0xb4, 0x00, 0x81, 0x00, 0x57, 0x00, 0x55, 0x00,
  0xd0, 0x00, 0x43, 0x01, 0x6d, 0x01, 0x06, 0x01, 0x8c, 0x00, 0x29, 0x00,
  0xc7, 0xff, 0xa0, 0xff, 0xd3, 0xff, 0x48, 0x00, 0x51, 0x00, 0x0c, 0x00,
  0xe9, 0xff, 0xd9, 0xff, 0xc4, 0xff, 0x9f, 0xff, 0xc1, 0xff, 0xfa, 0xff,
  0xe8, 0xff, 0xb0, 0xff, 0x89, 0xff, 0x7b, 0xff, 0x3b, 0xff, 0x2f, 0xff,
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
};
const unsigned int vocab_near_len = 16000;
