IowaScaledEngineering/ckt-defect/src/ckt-defect/vocab/include/ninth.h

const unsigned char vocab_ninth[] = {
  0x00, 0x00, 0xff, 0xff, 0xfd, 0xff, 0xfb, 0xff, 0xf9, 0xff, 0xf7, 0xff,
  0xf6, 0xff, 0xf5, 0xff, 0xf5, 0xff, 0xf5, 0xff, 0xf5, 0xff, 0xf6, 0xff,
  0xf8, 0xff, 0xfb, 0xff, 0xfe, 0xff, 0x02, 0x00, 0x07, 0x00, 0x0b, 0x00,
  0x10, 0x00, 0x16, 0x00, 0x1a, 0x00, 0x1e, 0x00, 0x23, 0x00, 0x27, 0x00,
  0x29, 0x00, 0x2c, 0x00, 0x2e, 0x00, 0x2f, 0x00, 0x2e, 0x00, 0x2c, 0x00,
  0x29, 0x00, 0x25, 0x00, 0x1f, 0x00, 0x18, 0x00, 0x13, 0x00, 0x0b, 0x00,
  0x04, 0x00, 0xfe, 0xff, 0xf8, 0xff, 0xf2, 0xff, 0xec, 0xff, 0xe3, 0xff,
  0xdc, 0xff, 0xd6, 0xff, 0xd1, 0xff, 0xcc, 0xff, 0xcb, 0xff, 0xcd, 0xff,
  0xcf, 0xff, 0xd0, 0xff, 0xd5, 0xff, 0xda, 0xff, 0xdb, 0xff, 0xdb, 0xff,
  0xe0, 0xff, 0xe6, 0xff, 0xef, 0xff, 0xfa, 0xff, 0x07, 0x00, 0x11, 0x00,
  0x17, 0x00, 0x1a, 0x00, 0x21, 0x00, 0x27, 0x00, 0x2c, 0x00, 0x30, 0x00,
  0x35, 0x00, 0x39, 0x00, 0x3b, 0x00, 0x3b, 0x00, 0x3b, 0x00, 0x33, 0x00,
  0x2b, 0x00, 0x23, 0x00, 0x1d, 0x00, 0x19, 0x00, 0x13, 0x00, 0x07, 0x00,
  0x00, 0x00, 0xf5, 0xff, 0xec, 0xff, 0xe3, 0xff, 0xda, 0xff, 0xcf, 0xff,
  0xc7, 0xff, 0xbe, 0xff, 0xba, 0xff, 0xbb, 0xff, 0xbc, 0xff, 0xbd, 0xff,
  0xbe, 0xff, 0xc0, 0xff, 0xc7, 0xff, 0xcd, 0xff, 0xd5, 0xff, 0xde, 0xff,
  0xe7, 0xff, 0xf0, 0xff, 0xfe, 0xff, 0x0b, 0x00, 0x19, 0x00, 0x20, 0x00,
  0x23, 0x00, 0x25, 0x00, 0x2a, 0x00, 0x2f, 0x00, 0x31, 0x00, 0x31, 0x00,
  0x34, 0x00, 0x35, 0x00, 0x35, 0x00, 0x36, 0x00, 0x36, 0x00, 0x30, 0x00,
  0x24, 0x00, 0x18, 0x00, 0x15, 0x00, 0x10, 0x00, 0x08, 0x00, 0x00, 0x00,
  0xff, 0xff, 0xf9, 0xff, 0xf0, 0xff, 0xe8, 0xff, 0xee, 0xff, 0xf2, 0xff,
  0xed, 0xff, 0xd9, 0xff, 0xcf, 0xff, 0xcc, 0xff, 0xd7, 0xff, 0xe4, 0xff,
  0xfb, 0xff, 0x0d, 0x00, 0x0d, 0x00, 0xf9, 0xff, 0xe7, 0xff, 0xd7, 0xff,
  0xcf, 0xff, 0xda, 0xff, 0x00, 0x00, 0x41, 0x00, 0x97, 0x00, 0xf0, 0x00,
  0x3a, 0x01, 0x4a, 0x01, 0x1a, 0x01, 0xdc, 0x00, 0xbe, 0x00, 0xc6, 0x00,
  0xcf, 0x00, 0xdd, 0x00, 0xe4, 0x00, 0xbf, 0x00, 0x78, 0x00, 0x35, 0x00,
  0x0d, 0x00, 0xda, 0xff, 0x8b, 0xff, 0x43, 0xff, 0x1c, 0xff, 0xfe, 0xfe,
  0xd2, 0xfe, 0x9e, 0xfe, 0x69, 0xfe, 0x18, 0xfe, 0xc1, 0xfd, 0x90, 0xfd,
  0x92, 0xfd, 0xa9, 0xfd, 0xc3, 0xfd, 0xf2, 0xfd, 0x3b, 0xfe, 0x86, 0xfe,
  0xc8, 0xfe, 0xfb, 0xfe, 0x2f, 0xff, 0x5e, 0xff, 0x91, 0xff, 0xdb, 0xff,
  0x42, 0x00, 0x9c, 0x00, 0xdc, 0x00, 0x0f, 0x01, 0x4e, 0x01, 0x79, 0x01,
  0x8d, 0x01, 0xa5, 0x01, 0xcd, 0x01, 0xe2, 0x01, 0xe5, 0x01, 0xef, 0x01,
  0x04, 0x02, 0xfe, 0x01, 0xdb, 0x01, 0xae, 0x01, 0x89, 0x01, 0x4e, 0x01,
  0x0f, 0x01, 0xda, 0x00, 0xbd, 0x00, 0x9f, 0x00, 0x7c, 0x00, 0x57, 0x00,
  0x3a, 0x00, 0x0d, 0x00, 0xd3, 0xff, 0x97, 0xff, 0x72, 0xff, 0x59, 0xff,
  0x49, 0xff, 0x3b, 0xff, 0x38, 0xff, 0x31, 0xff, 0x1d, 0xff, 0xfb, 0xfe,
  0xe0, 0xfe, 0xcd, 0xfe, 0xbe, 0xfe, 0xc0, 0xfe, 0xe5, 0xfe, 0x1c, 0xff,
  0x4e, 0xff, 0x73, 0xff, 0x98, 0xff, 0xac, 0xff, 0xb0, 0xff, 0xb2, 0xff,
  0xcc, 0xff, 0xf7, 0xff, 0x42, 0x00, 0x95, 0x00, 0xd1, 0x00, 0xe4, 0x00,
  0xd7, 0x00, 0xaf, 0x00, 0x87, 0x00, 0x69, 0x00, 0x66, 0x00, 0x6a, 0x00,
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
};
const unsigned int vocab_ninth_len = 18672;
