IowaScaledEngineering/ckt-defect/src/ckt-defect/vocab/include/no.h

const unsigned char vocab_no[] = {
  0x00, 0x00, 0xff, 0xff, 0xfd, 0xff, 0xf9, 0xff, 0xf4, 0xff, 0xf2, 0xff,
  0xf2, 0xff, 0xf0, 0xff, 0xee, 0xff, 0xec, 0xff, 0xe8, 0xff, 0xe8, 0xff,
  0xea, 0xff, 0xea, 0xff, 0xed, 0xff, 0xf1, 0xff, 0xf1, 0xff, 0xf5, 0xff,
  0xff, 0xff, 0x06, 0x00, 0x0d, 0x00, 0x12, 0x00, 0x19, 0x00, 0x20, 0x00,
  0x29, 0x00, 0x31, 0x00, 0x37, 0x00, 0x3d, 0x00, 0x3f, 0x00, 0x40, 0x00,
  0x3f, 0x00, 0x49, 0x00, 0x4f, 0x00, 0x49, 0x00, 0x44, 0x00, 0x39, 0x00,
  0x38, 0x00, 0x3c, 0x00, 0x34, 0x00, 0x2c, 0x00, 0x35, 0x00, 0x27, 0x00,
  0x0d, 0x00, 0x15, 0x00, 0x17, 0x00, 0x00, 0x00, 0xed, 0xff, 0xde, 0xff,
  0xd3, 0xff, 0xcb, 0xff, 0xc7, 0xff, 0xc0, 0xff, 0xbd, 0xff, 0xbe, 0xff,
  0xa8, 0xff, 0xa6, 0xff, 0xbf, 0xff, 0xb5, 0xff, 0xa2, 0xff, 0xb0, 0xff,
  0xa8, 0xff, 0xaa, 0xff, 0xc0, 0xff, 0xc0, 0xff, 0xc5, 0xff, 0xde, 0xff,
  0xd7, 0xff, 0xd6, 0xff, 0x06, 0x00, 0x0c, 0x00, 0x05, 0x00, 0x23, 0x00,
  0x2c, 0x00, 0x2c, 0x00, 0x3b, 0x00, 0x43, 0x00, 0x4b, 0x00, 0x59, 0x00,
  0x54, 0x00, 0x48, 0x00, 0x50, 0x00, 0x4a, 0x00, 0x44, 0x00, 0x3d, 0x00,
  0x3b, 0x00, 0x42, 0x00, 0x45, 0x00, 0x44, 0x00, 0x30, 0x00, 0x0a, 0x00,
  0xfb, 0xff, 0xea, 0xff, 0xe6, 0xff, 0xdf, 0xff, 0xd7, 0xff, 0xcd, 0xff,
  0xd7, 0xff, 0xc9, 0xff, 0xc4, 0xff, 0xe9, 0xff, 0x00, 0x00, 0xf9, 0xff,
  0x03, 0x00, 0x4c, 0x00, 0xb6, 0x00, 0xf1, 0x00, 0xbe, 0x00, 0xb7, 0x00,
  0xd6, 0x00, 0xb5, 0x00, 0x94, 0x00, 0xdd, 0x00, 0x20, 0x01, 0xe6, 0x00,
  0x7e, 0x00, 0x75, 0x00, 0x7d, 0x00, 0x4a, 0x00, 0xd5, 0xff, 0xad, 0xff,
  0xae, 0xff, 0x75, 0xff, 0x25, 0xff, 0x16, 0xff, 0x08, 0xff, 0x9b, 0xfe,
  0x02, 0xfe, 0xdb, 0xfd, 0xf9, 0xfd, 0x30, 0xfe, 0x5f, 0xfe, 0x6f, 0xfe,
  0x60, 0xfe, 0x56, 0xfe, 0x5f, 0xfe, 0x6c, 0xfe, 0x8c, 0xfe, 0xd0, 0xfe,
  0x07, 0xff, 0x30, 0xff, 0x72, 0xff, 0xd2, 0xff, 0x2b, 0x00, 0x5b, 0x00,
  0x72, 0x00, 0xb2, 0x00, 0xff, 0x00, 0x08, 0x01, 0x12, 0x01, 0x57, 0x01,
  0x76, 0x01, 0x59, 0x01, 0x4f, 0x01, 0x83, 0x01, 0xb1, 0x01, 0xa8, 0x01,
  0x97, 0x01, 0x9d, 0x01, 0x7f, 0x01, 0x31, 0x01, 0x04, 0x01, 0x0f, 0x01,
  0x0d, 0x01, 0xe3, 0x00, 0xa4, 0x00, 0xc1, 0x00, 0xcb, 0x00, 0x9a, 0x00,
  0x55, 0x00, 0x31, 0x00, 0x02, 0x00, 0xb4, 0xff, 0x64, 0xff, 0x5e, 0xff,
  0x63, 0xff, 0x3c, 0xff, 0xfe, 0xfe, 0x09, 0xff, 0xfe, 0xfe, 0xf6, 0xfe,
  0xf4, 0xfe, 0xde, 0xfe, 0xee, 0xfe, 0xe3, 0xfe, 0xef, 0xfe, 0xea, 0xfe,
  0x07, 0xff, 0x28, 0xff, 0x0b, 0xff, 0x51, 0xff, 0x86, 0xff, 0x8f, 0xff,
  0xa5, 0xff, 0xc0, 0xff, 0xc4, 0xff, 0xfb, 0xff, 0x25, 0x00, 0x32, 0x00,
  0x9c, 0x00, 0xc2, 0x00, 0x9b, 0x00, 0x04, 0x01, 0xfd, 0x00, 0xb8, 0x00,
  0xc3, 0x00, 0xb2, 0x00, 0x9b, 0x00, 0xd4, 0x00, 0xed, 0x00, 0xba, 0x00,
  0xb0, 0x00, 0x7c, 0x00, 0x54, 0x00, 0x7e, 0x00, 0x50, 0x00, 0x0f, 0x00,
  0xde, 0xff, 0xa0, 0xff, 0xbf, 0xff, 0xde, 0xff, 0xdd, 0xff, 0xb4, 0xff,
  0xa8, 0xff, 0x75, 0xff, 0x64, 0xff, 0x90, 0xff, 0xb4, 0xff, 0x13, 0x00,
  0x2a, 0x00, 0x4b, 0x00, 0xa0, 0x01, 0xdd, 0x02, 0xda, 0x02, 0x43, 0x02,
  0xe3, 0x01, 0x98, 0x01, 0x52, 0x01, 0x3a, 0x01, 0x8f, 0x01, 0x15, 0x02,
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
};
const unsigned int vocab_no_len = 16000;
