IowaScaledEngineering/ckt-defect/src/ckt-defect/vocab/include/northbound.h

const unsigned char vocab_northbound[] = {
  0x00, 0x00, 0xff, 0xff, 0xfd, 0xff, 0xfc, 0xff, 0xfa, 0xff, 0xf7, 0xff,
  0xf6, 0xff, 0xf6, 0xff, 0xf6, 0xff, 0xf4, 0xff, 0xf6, 0xff, 0xf8, 0xff,
  0xf9, 0xff, 0xfa, 0xff, 0xfe, 0xff, 0x03, 0x00, 0x06, 0x00, 0x06, 0x00,
  0x0a, 0x00, 0x10, 0x00, 0x14, 0x00, 0x15, 0x00, 0x17, 0x00, 0x1b, 0x00,
  0x20, 0x00, 0x20, 0x00, 0x20, 0x00, 0x22, 0x00, 0x25, 0x00, 0x20, 0x00,
  0x1b, 0x00, 0x19, 0x00, 0x1c, 0x00, 0x19, 0x00, 0x14, 0x00, 0x11, 0x00,
  0x15, 0x00, 0x12, 0x00, 0x0c, 0x00, 0x06, 0x00, 0x08, 0x00, 0xff, 0xff,
  0xf5, 0xff, 0xf4, 0xff, 0x00, 0x00, 0x00, 0x00, 0xf8, 0xff, 0xef, 0xff,
  0xf8, 0xff, 0xf8, 0xff, 0xef, 0xff, 0xef, 0xff, 0xf9, 0xff, 0xfb, 0xff,
  0xf1, 0xff, 0xe3, 0xff, 0xec, 0xff, 0xf2, 0xff, 0xe5, 0xff, 0xd8, 0xff,
  0xe1, 0xff, 0xf1, 0xff, 0xf8, 0xff, 0xf7, 0xff, 0x0d, 0x00, 0x25, 0x00,
  0x39, 0x00, 0x51, 0x00, 0x7a, 0x00, 0x98, 0x00, 0x9e, 0x00, 0x92, 0x00,
  0xa0, 0x00, 0xb1, 0x00, 0xcc, 0x00, 0xe5, 0x00, 0xf3, 0x00, 0xd2, 0x00,
  0xb2, 0x00, 0xad, 0x00, 0xa3, 0x00, 0x59, 0x00, 0x0a, 0x00, 0xe9, 0xff,
  0xe8, 0xff, 0xb5, 0xff, 0x6e, 0xff, 0x3b, 0xff, 0x18, 0xff, 0xb2, 0xfe,
  0x4b, 0xfe, 0x28, 0xfe, 0x4c, 0xfe, 0x3d, 0xfe, 0xf6, 0xfd, 0xe0, 0xfd,
  0x2d, 0xfe, 0x78, 0xfe, 0x7a, 0xfe, 0x68, 0xfe, 0x9b, 0xfe, 0xea, 0xfe,
  0x17, 0xff, 0x31, 0xff, 0x91, 0xff, 0xf6, 0xff, 0x21, 0x00, 0x0f, 0x00,
  0x3a, 0x00, 0x9e, 0x00, 0xf5, 0x00, 0x03, 0x01, 0x0b, 0x01, 0x2d, 0x01,
  0x5f, 0x01, 0x68, 0x01, 0x65, 0x01, 0x68, 0x01, 0x66, 0x01, 0x34, 0x01,
  0x0d, 0x01, 0x17, 0x01, 0x40, 0x01, 0x2c, 0x01, 0xf5, 0x00, 0xc5, 0x00,
  0xcf, 0x00, 0xce, 0x00, 0xbb, 0x00, 0xa3, 0x00, 0x94, 0x00, 0x73, 0x00,
  0x51, 0x00, 0x4a, 0x00, 0x68, 0x00, 0x5f, 0x00, 0x40, 0x00, 0x0f, 0x00,
  0x02, 0x00, 0xe8, 0xff, 0xd4, 0xff, 0xab, 0xff, 0x8c, 0xff, 0x61, 0xff,
  0x47, 0xff, 0x36, 0xff, 0x38, 0xff, 0x29, 0xff, 0x19, 0xff, 0xf7, 0xfe,
  0xec, 0xfe, 0xdb, 0xfe, 0xe8, 0xfe, 0xf0, 0xfe, 0x01, 0xff, 0x0b, 0xff,
  0x31, 0xff, 0x4a, 0xff, 0x6b, 0xff, 0x78, 0xff, 0x8f, 0xff, 0x99, 0xff,
  0xa7, 0xff, 0xc3, 0xff, 0xf8, 0xff, 0x34, 0x00, 0x5f, 0x00, 0x6a, 0x00,
  0x92, 0x00, 0xbb, 0x00, 0xd9, 0x00, 0xc9, 0x00, 0xd5, 0x00, 0xe6, 0x00,
  0xf5, 0x00, 0xe1, 0x00, 0xd9, 0x00, 0xdd, 0x00, 0xe0, 0x00, 0xae, 0x00,
  0x8d, 0x00, 0x77, 0x00, 0x6e, 0x00, 0x2a, 0x00, 0xf9, 0xff, 0xd5, 0xff,
  0xce, 0xff, 0xb4, 0xff, 0x85, 0xff, 0x61, 0xff, 0x5a, 0xff, 0x31, 0xff,
  0x06, 0xff, 0xf8, 0xfe, 0x22, 0xff, 0x27, 0xff, 0x22, 0xff, 0x49, 0xff,
  0xd8, 0xff, 0x5d, 0x00, 0xc2, 0x00, 0x33, 0x01, 0xe3, 0x01, 0x76, 0x02,
  0x77, 0x02, 0x11, 0x02, 0x24, 0x02, 0x65, 0x02, 0xba, 0x02, 0xda, 0x02,
  0xfa, 0x02, 0xf4, 0x02, 0x8b, 0x02, 0xf4, 0x01, 0x83, 0x01, 0x24, 0x01,
  0xb0, 0x00, 0xed, 0xff, 0x93, 0xff, 0x3f, 0xff, 0xe6, 0xfe, 0x15, 0xfe,
  0x4d, 0xfd, 0x87, 0xfc, 0xe1, 0xfb, 0x4b, 0xfb, 0x1e, 0xfb, 0x4d, 0xfb,
  0x71, 0xfb, 0x54, 0xfb, 0x69, 0xfb, 0xa9, 0xfb, 0xff, 0xfb, 0xff, 0xfb,
  0x54, 0xfc, 0xd4, 0xfc, 0x5a, 0xfd, 0xba, 0xfd, 0x38, 0xfe, 0xf9, 0xfe,
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
};
const unsigned int vocab_northbound_len = 30962;
