IowaScaledEngineering/ckt-defect/src/ckt-defect/vocab/include/rail.h

const unsigned char vocab_rail[] = {
  0x00, 0x00, 0x02, 0x00, 0x03, 0x00, 0x03, 0x00, 0x02, 0x00, 0x01, 0x00,
  0xfe, 0xff, 0xfc, 0xff, 0xfa, 0xff, 0xf9, 0xff, 0xf7, 0xff, 0xf4, 0xff,
  0xf1, 0xff, 0xf0, 0xff, 0xf1, 0xff, 0xf2, 0xff, 0xf2, 0xff, 0xf3, 0xff,
  0xf3, 0xff, 0xf1, 0xff, 0xe9, 0xff, 0xe4, 0xff, 0xe1, 0xff, 0xe4, 0xff,
  0xe4, 0xff, 0xe6, 0xff, 0xe5, 0xff, 0xe7, 0xff, 0xe5, 0xff, 0xe0, 0xff,
  0xdb, 0xff, 0xdc, 0xff, 0xe0, 0xff, 0xe4, 0xff, 0xe8, 0xff, 0xef, 0xff,
  0xf8, 0xff, 0x00, 0x00, 0x04, 0x00, 0x0a, 0x00, 0x11, 0x00, 0x1f, 0x00,
  0x29, 0x00, 0x33, 0x00, 0x38, 0x00, 0x42, 0x00, 0x49, 0x00, 0x49, 0x00,
  0x44, 0x00, 0x3f, 0x00, 0x3e, 0x00, 0x3a, 0x00, 0x35, 0x00, 0x33, 0x00,
  0x35, 0x00, 0x3b, 0x00, 0x3c, 0x00, 0x3e, 0x00, 0x3c, 0x00, 0x40, 0x00,
  0x3c, 0x00, 0x3e, 0x00, 0x38, 0x00, 0x38, 0x00, 0x34, 0x00, 0x2d, 0x00,
  0x24, 0x00, 0x18, 0x00, 0x10, 0x00, 0x07, 0x00, 0xfc, 0xff, 0xeb, 0xff,
  0xd7, 0xff, 0xc7, 0xff, 0xb5, 0xff, 0xa9, 0xff, 0x98, 0xff, 0x8c, 0xff,
  0x80, 0xff, 0x7b, 0xff, 0x76, 0xff, 0x75, 0xff, 0x7d, 0xff, 0x8c, 0xff,
  0x99, 0xff, 0xa0, 0xff, 0xa1, 0xff, 0xa6, 0xff, 0xa9, 0xff, 0xac, 0xff,
  0xad, 0xff, 0xb2, 0xff, 0xb4, 0xff, 0xbe, 0xff, 0xc6, 0xff, 0xd7, 0xff,
  0xee, 0xff, 0x0b, 0x00, 0x27, 0x00, 0x42, 0x00, 0x5e, 0x00, 0x76, 0x00,
  0x86, 0x00, 0x91, 0x00, 0x93, 0x00, 0x92, 0x00, 0x87, 0x00, 0x7b, 0x00,
  0x6e, 0x00, 0x5c, 0x00, 0x46, 0x00, 0x31, 0x00, 0x2b, 0x00, 0x29, 0x00,
  0x26, 0x00, 0x24, 0x00, 0x29, 0x00, 0x2c, 0x00, 0x2f, 0x00, 0x2b, 0x00,
  0x28, 0x00, 0x1f, 0x00, 0x21, 0x00, 0x1a, 0x00, 0x1d, 0x00, 0x20, 0x00,
  0x31, 0x00, 0x50, 0x00, 0x86, 0x00, 0xbb, 0x00, 0xdd, 0x00, 0xec, 0x00,
  0xe0, 0x00, 0xcb, 0x00, 0x99, 0x00, 0x5a, 0x00, 0x19, 0x00, 0xec, 0xff,
  0xbc, 0xff, 0x8e, 0xff, 0x59, 0xff, 0x3b, 0xff, 0x32, 0xff, 0x35, 0xff,
  0x34, 0xff, 0x36, 0xff, 0x3f, 0xff, 0x49, 0xff, 0x42, 0xff, 0x24, 0xff,
  0x03, 0xff, 0xf7, 0xfe, 0x00, 0xff, 0x18, 0xff, 0x20, 0xff, 0x22, 0xff,
  0x1c, 0xff, 0x23, 0xff, 0x25, 0xff, 0x26, 0xff, 0x26, 0xff, 0x3d, 0xff,
  0x70, 0xff, 0xa3, 0xff, 0xb8, 0xff, 0xc6, 0xff, 0xd8, 0xff, 0x00, 0x00,
  0x10, 0x00, 0x26, 0x00, 0x38, 0x00, 0x6d, 0x00, 0x9d, 0x00, 0xca, 0x00,
  0xe4, 0x00, 0xff, 0x00, 0x23, 0x01, 0x3a, 0x01, 0x41, 0x01, 0x37, 0x01,
  0x3b, 0x01, 0x49, 0x01, 0x44, 0x01, 0x39, 0x01, 0x1b, 0x01, 0x13, 0x01,
  0xfd, 0x00, 0xed, 0x00, 0xc4, 0x00, 0xae, 0x00, 0x96, 0x00, 0x83, 0x00,
  0x6c, 0x00, 0x46, 0x00, 0x37, 0x00, 0x14, 0x00, 0x04, 0x00, 0xe0, 0xff,
  0xc8, 0xff, 0xbd, 0xff, 0xb0, 0xff, 0xaa, 0xff, 0x8b, 0xff, 0x81, 0xff,
  0x6b, 0xff, 0x6e, 0xff, 0x59, 0xff, 0x46, 0xff, 0x2e, 0xff, 0x14, 0xff,
  0xfb, 0xfe, 0xd8, 0xfe, 0xc1, 0xfe, 0xa4, 0xfe, 0xa8, 0xfe, 0xbe, 0xfe,
  0xd7, 0xfe, 0xf3, 0xfe, 0x05, 0xff, 0x31, 0xff, 0x4a, 0xff, 0x71, 0xff,
  0x96, 0xff, 0xc7, 0xff, 0xfd, 0xff, 0x3d, 0x00, 0x77, 0x00, 0xa8, 0x00,
  0xbc, 0x00, 0xc3, 0x00, 0xbd, 0x00, 0xb1, 0x00, 0x8e, 0x00, 0x7c, 0x00,
  0x7a, 0x00, 0x8a, 0x00, 0xa3, 0x00, 0xac, 0x00, 0xaa, 0x00, 0xaf, 0x00,
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
};
const unsigned int vocab_rail_len = 18024;
