IowaScaledEngineering/ckt-defect/src/ckt-defect/vocab/include/right.h

const unsigned char vocab_right[] = {
  0x00, 0x00, 0x02, 0x00, 0x05, 0x00, 0x08, 0x00, 0x0a, 0x00, 0x0b, 0x00,
  0x09, 0x00, 0x06, 0x00, 0x01, 0x00, 0xfd, 0xff, 0xf9, 0xff, 0xf6, 0xff,
  0xf3, 0xff, 0xf1, 0xff, 0xed, 0xff, 0xe9, 0xff, 0xe3, 0xff, 0xde, 0xff,
  0xd7, 0xff, 0xd4, 0xff, 0xd1, 0xff, 0xd2, 0xff, 0xd1, 0xff, 0xcf, 0xff,
  0xc9, 0xff, 0xc3, 0xff, 0xb9, 0xff, 0xb0, 0xff, 0xa6, 0xff, 0xa4, 0xff,
  0xab, 0xff, 0xbc, 0xff, 0xd4, 0xff, 0xf0, 0xff, 0x08, 0x00, 0x1e, 0x00,
  0x2e, 0x00, 0x39, 0x00, 0x3b, 0x00, 0x41, 0x00, 0x46, 0x00, 0x50, 0x00,
  0x59, 0x00, 0x62, 0x00, 0x69, 0x00, 0x6e, 0x00, 0x6c, 0x00, 0x67, 0x00,
  0x5f, 0x00, 0x5c, 0x00, 0x5a, 0x00, 0x5f, 0x00, 0x63, 0x00, 0x68, 0x00,
  0x66, 0x00, 0x5e, 0x00, 0x4c, 0x00, 0x36, 0x00, 0x1b, 0x00, 0x03, 0x00,
  0xec, 0xff, 0xdc, 0xff, 0xd0, 0xff, 0xcb, 0xff, 0xc4, 0xff, 0xc1, 0xff,
  0xb9, 0xff, 0xb9, 0xff, 0xb9, 0xff, 0xc2, 0xff, 0xcb, 0xff, 0xd9, 0xff,
  0xe4, 0xff, 0xec, 0xff, 0xe5, 0xff, 0xdb, 0xff, 0xc6, 0xff, 0xbe, 0xff,
  0xba, 0xff, 0xc1, 0xff, 0xd1, 0xff, 0xeb, 0xff, 0xfe, 0xff, 0x0a, 0x00,
  0x09, 0x00, 0x04, 0x00, 0xfc, 0xff, 0xf9, 0xff, 0xf6, 0xff, 0xf9, 0xff,
  0xf7, 0xff, 0xfc, 0xff, 0xf4, 0xff, 0xec, 0xff, 0xe4, 0xff, 0xea, 0xff,
  0xf2, 0xff, 0x06, 0x00, 0x1a, 0x00, 0x37, 0x00, 0x45, 0x00, 0x46, 0x00,
  0x30, 0x00, 0x15, 0x00, 0xf9, 0xff, 0xe8, 0xff, 0xe2, 0xff, 0xe9, 0xff,
  0xf3, 0xff, 0xf9, 0xff, 0xf5, 0xff, 0xfa, 0xff, 0xeb, 0xff, 0xd6, 0xff,
  0xc0, 0xff, 0xbd, 0xff, 0xb6, 0xff, 0xa6, 0xff, 0x98, 0xff, 0x94, 0xff,
  0x87, 0xff, 0x70, 0xff, 0x66, 0xff, 0x7c, 0xff, 0x98, 0xff, 0xc9, 0xff,
  0xf2, 0xff, 0x38, 0x00, 0x6d, 0x00, 0x9e, 0x00, 0xd4, 0x00, 0x23, 0x01,
  0x99, 0x01, 0x37, 0x02, 0xf8, 0x02, 0xcb, 0x03, 0x56, 0x04, 0x88, 0x04,
  0x3d, 0x04, 0xbb, 0x03, 0x03, 0x03, 0x16, 0x02, 0x03, 0x01, 0x16, 0x00,
  0x77, 0xff, 0x19, 0xff, 0xb7, 0xfe, 0x54, 0xfe, 0xf8, 0xfd, 0xab, 0xfd,
  0x4d, 0xfd, 0xe1, 0xfc, 0x72, 0xfc, 0x25, 0xfc, 0xd7, 0xfb, 0x80, 0xfb,
  0x01, 0xfb, 0x7e, 0xfa, 0x0e, 0xfa, 0xd3, 0xf9, 0xc4, 0xf9, 0xf7, 0xf9,
  0x69, 0xfa, 0x39, 0xfb, 0x34, 0xfc, 0x4e, 0xfd, 0x52, 0xfe, 0x4f, 0xff,
  0x32, 0x00, 0x09, 0x01, 0xd0, 0x01, 0x9c, 0x02, 0x74, 0x03, 0x4b, 0x04,
  0xf7, 0x04, 0x78, 0x05, 0xb8, 0x05, 0xd5, 0x05, 0xc3, 0x05, 0xab, 0x05,
  0x90, 0x05, 0x94, 0x05, 0x96, 0x05, 0x91, 0x05, 0x62, 0x05, 0x27, 0x05,
  0xbc, 0x04, 0x25, 0x04, 0x59, 0x03, 0x97, 0x02, 0xe3, 0x01, 0x37, 0x01,
  0x72, 0x00, 0xb6, 0xff, 0x02, 0xff, 0x5f, 0xfe, 0x99, 0xfd, 0xce, 0xfc,
  0x25, 0xfc, 0xd3, 0xfb, 0xc1, 0xfb, 0xcc, 0xfb, 0xe3, 0xfb, 0x2d, 0xfc,
  0x8d, 0xfc, 0xe7, 0xfc, 0x0b, 0xfd, 0x1a, 0xfd, 0x15, 0xfd, 0x2a, 0xfd,
  0x3e, 0xfd, 0x6a, 0xfd, 0x8b, 0xfd, 0xc0, 0xfd, 0x0a, 0xfe, 0x6e, 0xfe,
  0xc0, 0xfe, 0x16, 0xff, 0x51, 0xff, 0xaa, 0xff, 0xfe, 0xff, 0x51, 0x00,
  0x99, 0x00, 0xf9, 0x00, 0x55, 0x01, 0x8c, 0x01, 0x81, 0x01, 0x6e, 0x01,
  0x75, 0x01, 0x85, 0x01, 0x8e, 0x01, 0xb2, 0x01, 0xdf, 0x01, 0x0e, 0x02,
  0x22, 0x02, 0xff, 0x01, 0xd6, 0x01, 0xdd, 0x01, 0xbe, 0x01, 0x9e, 0x01,
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
};
const unsigned int vocab_right_len = 18928;
