IowaScaledEngineering/ckt-defect/src/ckt-defect/vocab/include/second.h

const unsigned char vocab_second[] = {
  0x00, 0x00, 0x00, 0x00, 0x03, 0x00, 0xfe, 0xff, 0xff, 0xff, 0x04, 0x00,
  0x02, 0x00, 0xfb, 0xff, 0x09, 0x00, 0x00, 0x00, 0xf3, 0xff, 0x0f, 0x00,
  0x01, 0x00, 0xea, 0xff, 0x1b, 0x00, 0x05, 0x00, 0xf2, 0xff, 0x13, 0x00,
  0xfe, 0xff, 0x0b, 0x00, 0x0e, 0x00, 0xeb, 0xff, 0xff, 0xff, 0x07, 0x00,
  0xe9, 0xff, 0x08, 0x00, 0xff, 0xff, 0xfd, 0xff, 0x1d, 0x00, 0xfb, 0xff,
  0xe5, 0xff, 0x3d, 0x00, 0xe3, 0xff, 0xc2, 0xff, 0xe9, 0xff, 0x10, 0x00,
  0xbd, 0xff, 0x2f, 0x00, 0x16, 0x00, 0xec, 0xff, 0x2c, 0x00, 0xe5, 0xff,
  0xf8, 0xff, 0xe7, 0xff, 0x00, 0x00, 0xea, 0xff, 0x2f, 0x00, 0xcd, 0xff,
  0x37, 0x00, 0xfc, 0xff, 0x2b, 0x00, 0x44, 0x00, 0x97, 0xff, 0x4f, 0x00,
  0x2e, 0x00, 0x78, 0xff, 0x7c, 0x00, 0xf7, 0xff, 0xc8, 0xff, 0x87, 0x00,
  0xb2, 0xff, 0x20, 0x00, 0xd4, 0xff, 0xa6, 0xff, 0x15, 0x00, 0x1b, 0x00,
  0x9a, 0xff, 0x00, 0x00, 0x13, 0x00, 0x0f, 0x00, 0x3c, 0x00, 0x09, 0x00,
  0x12, 0x00, 0x21, 0x00, 0x9d, 0xff, 0x4a, 0x00, 0xe6, 0xff, 0xc8, 0xff,
  0x86, 0x00, 0x06, 0x00, 0xaf, 0xff, 0xd4, 0x00, 0xad, 0xff, 0xfd, 0xff,
  0x42, 0x00, 0x4e, 0xff, 0x87, 0xff, 0x25, 0x01, 0xe1, 0xfe, 0xa7, 0xff,
  0x07, 0x01, 0xfa, 0xfe, 0x64, 0x00, 0xab, 0xff, 0xa7, 0xff, 0xa8, 0xff,
  0xbe, 0xff, 0x75, 0x00, 0x8c, 0xff, 0xfb, 0x00, 0x01, 0x00, 0xff, 0xff,
  0xc8, 0xff, 0xa3, 0x00, 0xd1, 0xff, 0x1a, 0x00, 0x7e, 0x00, 0x92, 0xff,
  0x17, 0x01, 0x10, 0x00, 0xca, 0xff, 0xf3, 0x00, 0xa9, 0xff, 0x72, 0xff,
  0xe9, 0x00, 0x3e, 0xff, 0x10, 0x00, 0x69, 0x00, 0x20, 0xff, 0x07, 0x00,
  0x34, 0x00, 0x90, 0xff, 0x4c, 0xff, 0x4b, 0x01, 0xf0, 0xfe, 0xd1, 0xff,
  0x6a, 0x00, 0x8b, 0xfe, 0x95, 0x00, 0x0a, 0xff, 0x7e, 0xff, 0x1c, 0x01,
  0x90, 0xff, 0xa3, 0x01, 0x79, 0xff, 0x69, 0xff, 0x5c, 0x02, 0xeb, 0xfd,
  0x5b, 0x00, 0xc3, 0x00, 0x23, 0xff, 0x3d, 0x00, 0x69, 0x01, 0x7e, 0xff,
  0x51, 0xff, 0x32, 0x01, 0x25, 0xff, 0x91, 0x01, 0x7a, 0xfe, 0x5f, 0xff,
  0xbc, 0x01, 0xb9, 0xfd, 0x4b, 0x01, 0xab, 0xfe, 0x8f, 0x00, 0x7c, 0x00,
  0x85, 0xfe, 0xe9, 0xff, 0x27, 0x01, 0xaf, 0xfe, 0x0e, 0x01, 0x83, 0xff,
  0xe2, 0x01, 0x50, 0x00, 0x3d, 0xfe, 0x5c, 0x00, 0xca, 0xff, 0x0c, 0x01,
  0x25, 0x00, 0x3f, 0xfe, 0xa4, 0x02, 0xba, 0xff, 0x47, 0xfe, 0xe8, 0xff,
  0x6b, 0x02, 0x41, 0xfe, 0xe2, 0xff, 0xe3, 0xfd, 0x94, 0x02, 0x0c, 0xff,
  0x00, 0x00, 0xcf, 0xff, 0x35, 0x01, 0x4f, 0xff, 0x76, 0xff, 0xe9, 0x00,
  0x72, 0xfe, 0xb4, 0x01, 0xeb, 0xfe, 0xaa, 0x02, 0xd3, 0xfd, 0x76, 0x00,
  0x2d, 0x01, 0xc7, 0xff, 0xf5, 0xfd, 0x8b, 0x00, 0xc3, 0xfe, 0xb9, 0x02,
  0xb0, 0xfe, 0xd3, 0xff, 0x71, 0x01, 0xa1, 0xfe, 0x79, 0x00, 0x4f, 0x01,
  0xee, 0xfd, 0xd5, 0x00, 0x28, 0x00, 0xc9, 0xfe, 0xf7, 0xfe, 0xf3, 0x01,
  0x59, 0xfe, 0x17, 0x01, 0xea, 0xfd, 0x6d, 0x03, 0x6d, 0xfc, 0xef, 0x00,
  0x34, 0x02, 0xa8, 0xfc, 0x92, 0x00, 0x1e, 0x01, 0x6f, 0x00, 0xab, 0xff,
  0x32, 0x02, 0x55, 0xff, 0xa2, 0xfe, 0x26, 0x03, 0xce, 0xfd, 0x47, 0xff,
  0xc1, 0xff, 0x06, 0x03, 0xbe, 0xfc, 0x6d, 0x01, 0x4e, 0x04, 0x7e, 0xfc,
  0x46, 0xfe, 0x8c, 0x04, 0x5b, 0xfa, 0x7c, 0x03, 0x3e, 0xff, 0x21, 0xff,
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
};
const unsigned int vocab_second_len = 21596;
