IowaScaledEngineering/ckt-defect/src/ckt-defect/vocab/include/seventh.h

const unsigned char vocab_seventh[] = {
  0x00, 0x00, 0x00, 0x00, 0xfd, 0xff, 0x02, 0x00, 0x02, 0x00, 0xfb, 0xff,
  0xfd, 0xff, 0x05, 0x00, 0xff, 0xff, 0xf9, 0xff, 0x02, 0x00, 0x0e, 0x00,
  0xf5, 0xff, 0xfb, 0xff, 0x0e, 0x00, 0xff, 0xff, 0xec, 0xff, 0xfe, 0xff,
  0x15, 0x00, 0xf7, 0xff, 0xf3, 0xff, 0x23, 0x00, 0xff, 0xff, 0xe0, 0xff,
  0x0e, 0x00, 0x14, 0x00, 0xe0, 0xff, 0x00, 0x00, 0x1e, 0x00, 0x07, 0x00,
  0xee, 0xff, 0x17, 0x00, 0x04, 0x00, 0xde, 0xff, 0x0d, 0x00, 0x0e, 0x00,
  0xd2, 0xff, 0xfe, 0xff, 0x11, 0x00, 0x00, 0x00, 0xe4, 0xff, 0x42, 0x00,
  0xf5, 0xff, 0xd6, 0xff, 0x29, 0x00, 0x09, 0x00, 0xd6, 0xff, 0x02, 0x00,
  0x1a, 0x00, 0x0c, 0x00, 0x99, 0xff, 0x14, 0x00, 0x3f, 0x00, 0xbe, 0xff,
  0x21, 0x00, 0x2c, 0x00, 0xed, 0xff, 0x10, 0x00, 0x25, 0x00, 0xf6, 0xff,
  0xdf, 0xff, 0xfc, 0xff, 0xc9, 0xff, 0x01, 0x00, 0x3c, 0x00, 0xff, 0xff,
  0xba, 0xff, 0x80, 0x00, 0xfc, 0xff, 0xcd, 0xff, 0x59, 0x00, 0xc2, 0xff,
  0x7a, 0xff, 0x62, 0x00, 0x3e, 0x00, 0x50, 0xff, 0xe9, 0xff, 0x15, 0x01,
  0x9a, 0xff, 0x41, 0xff, 0x0e, 0x01, 0x82, 0x00, 0xbe, 0xfe, 0x15, 0x00,
  0x99, 0x00, 0x7a, 0xff, 0x66, 0xff, 0xd7, 0x00, 0x8d, 0x00, 0xb7, 0xfe,
  0x6d, 0x00, 0x0c, 0x01, 0xc8, 0xfe, 0xac, 0xff, 0x1a, 0x01, 0xab, 0xff,
  0x5d, 0xff, 0x7a, 0x00, 0x39, 0x00, 0x17, 0x00, 0x15, 0x00, 0x00, 0x00,
  0x59, 0xff, 0xd0, 0xff, 0xcd, 0x00, 0x73, 0xff, 0xc7, 0xff, 0xe4, 0x00,
  0x5e, 0x00, 0x80, 0xff, 0xef, 0xff, 0xf8, 0xff, 0x93, 0xff, 0xbe, 0xff,
  0xb9, 0xff, 0xae, 0x00, 0x2b, 0x00, 0x7d, 0xff, 0x22, 0x01, 0xd9, 0xff,
  0x50, 0xff, 0x61, 0x00, 0x73, 0x00, 0x38, 0xff, 0x7b, 0xff, 0xa1, 0x00,
  0x35, 0x00, 0xe6, 0xff, 0x99, 0xff, 0x45, 0x00, 0x93, 0x00, 0x33, 0x00,
  0x5a, 0xff, 0x16, 0x00, 0xfa, 0xff, 0xca, 0xff, 0xa5, 0xff, 0x02, 0x01,
  0x7f, 0xff, 0xd4, 0xfe, 0x3e, 0x01, 0x43, 0x01, 0xf0, 0xfd, 0x73, 0xff,
  0x79, 0x02, 0x49, 0xff, 0x06, 0xfe, 0xcb, 0x01, 0x1f, 0x00, 0x11, 0xff,
  0x5d, 0xff, 0x9c, 0x01, 0xce, 0x00, 0xa3, 0xfd, 0xfd, 0xff, 0x25, 0x02,
  0xab, 0xfe, 0x96, 0xfe, 0xd6, 0x01, 0x0a, 0x00, 0xfc, 0xfe, 0x6e, 0x00,
  0xc9, 0x00, 0x38, 0x00, 0xbe, 0xfe, 0x76, 0x00, 0x2a, 0x02, 0x69, 0xfe,
  0x92, 0xfd, 0xa6, 0x02, 0xbe, 0x00, 0x48, 0xfe, 0xc7, 0xff, 0x09, 0x01,
  0xdf, 0xff, 0xa3, 0x00, 0xe7, 0xfd, 0x1e, 0x01, 0xc7, 0x01, 0x1c, 0xfe,
  0x24, 0xff, 0x58, 0x02, 0xbd, 0xfe, 0x59, 0xfe, 0x1d, 0x02, 0x9f, 0x00,
  0x34, 0xfd, 0x61, 0x00, 0x9d, 0x03, 0x09, 0xfe, 0x1b, 0xfd, 0x94, 0x02,
  0x57, 0x01, 0xfe, 0xfc, 0xe6, 0xff, 0x07, 0x02, 0xe1, 0xfe, 0x3f, 0x00,
  0xb4, 0x01, 0xc3, 0xfe, 0x4a, 0xfd, 0x98, 0x03, 0xa0, 0x01, 0x1e, 0xfc,
  0x4d, 0xff, 0xaa, 0x04, 0x28, 0xff, 0x11, 0xfc, 0x61, 0x02, 0x37, 0x02,
  0x96, 0xfc, 0xc5, 0xfe, 0x8f, 0x03, 0x32, 0x01, 0x89, 0xfb, 0x42, 0x01,
  0x54, 0x03, 0xd6, 0xff, 0xce, 0xfa, 0x28, 0x01, 0x08, 0x04, 0x06, 0xfe,
  0xea, 0xfe, 0xe9, 0x00, 0xbe, 0x00, 0xc8, 0xfe, 0xfe, 0xff, 0x89, 0xff,
  0xb5, 0xff, 0xcf, 0xff, 0x9e, 0x00, 0xfd, 0xff, 0xd2, 0xfe, 0x03, 0x03,
  0xea, 0xfe, 0x01, 0xfd, 0xe7, 0x02, 0x26, 0x03, 0xbb, 0xfa, 0x2c, 0x00,
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
};
const unsigned int vocab_seventh_len = 17538;
