IowaScaledEngineering/ckt-defect/src/ckt-defect/vocab/include/sixth.h

const unsigned char vocab_sixth[] = {
  0x00, 0x00, 0x00, 0x00, 0x00, 0x00, 0xff, 0xff, 0xff, 0xff, 0xff, 0xff,
  0x00, 0x00, 0xfd, 0xff, 0x0c, 0x00, 0xfd, 0xff, 0x0d, 0x00, 0x00, 0x00,
  0xf7, 0xff, 0xff, 0xff, 0xf4, 0xff, 0x0a, 0x00, 0xfd, 0xff, 0x00, 0x00,
  0x1e, 0x00, 0xfc, 0xff, 0x16, 0x00, 0xf2, 0xff, 0xf1, 0xff, 0x0d, 0x00,
  0xed, 0xff, 0xf4, 0xff, 0x10, 0x00, 0xda, 0xff, 0x18, 0x00, 0xfb, 0xff,
  0x06, 0x00, 0xe8, 0xff, 0x1e, 0x00, 0xeb, 0xff, 0xdc, 0xff, 0x26, 0x00,
  0xde, 0xff, 0xf5, 0xff, 0x09, 0x00, 0xb8, 0xff, 0x33, 0x00, 0x14, 0x00,
  0x3c, 0x00, 0xfa, 0xff, 0xbd, 0xff, 0x6b, 0x00, 0xbf, 0xff, 0xf0, 0xff,
  0x52, 0x00, 0xd8, 0xff, 0xcd, 0xff, 0xa1, 0x00, 0xfa, 0xff, 0x7d, 0xff,
  0x7a, 0x00, 0xd1, 0xff, 0x00, 0x00, 0x1d, 0x00, 0x86, 0xff, 0x57, 0x00,
  0xe1, 0xff, 0xee, 0xff, 0xdb, 0xff, 0xd5, 0xff, 0x39, 0x00, 0xdb, 0xff,
  0xc1, 0xff, 0x32, 0x00, 0xf6, 0xff, 0xbe, 0xff, 0x69, 0x00, 0x46, 0x00,
  0x63, 0x00, 0xd7, 0xff, 0xe4, 0xff, 0xab, 0xff, 0x25, 0x00, 0x18, 0x00,
  0xb3, 0xff, 0x98, 0x00, 0x47, 0x00, 0x33, 0xff, 0x29, 0x00, 0x15, 0x00,
  0xdc, 0xff, 0x4a, 0x00, 0x96, 0xff, 0xbf, 0xff, 0x17, 0x00, 0x38, 0x00,
  0x1d, 0x00, 0xe5, 0xff, 0x4d, 0x00, 0x1e, 0xff, 0xcb, 0x00, 0x2d, 0xff,
  0x20, 0x01, 0x06, 0xff, 0xd3, 0x00, 0xeb, 0xff, 0xf2, 0xff, 0xbd, 0xff,
  0xd4, 0x00, 0x77, 0xfe, 0x91, 0x00, 0x8f, 0xff, 0x3e, 0x00, 0xac, 0x00,
  0x57, 0xff, 0x44, 0x01, 0xa3, 0xff, 0x6f, 0xff, 0x46, 0x01, 0x3f, 0xff,
  0xbc, 0xff, 0xc1, 0x00, 0xf2, 0xff, 0x03, 0xfe, 0xca, 0x01, 0x12, 0xfe,
  0xcb, 0x00, 0x9e, 0xff, 0xd0, 0x00, 0xa0, 0xff, 0x0d, 0x00, 0xb8, 0x00,
  0xf6, 0xfe, 0x7f, 0xff, 0x1d, 0x01, 0x76, 0xff, 0xcc, 0x00, 0x62, 0x00,
  0x2d, 0x00, 0xe3, 0xfe, 0xad, 0x01, 0xf3, 0xfe, 0xc9, 0xff, 0xe7, 0xff,
  0xc0, 0xff, 0x5a, 0x00, 0xf6, 0xfe, 0xc2, 0x02, 0x06, 0x00, 0x0f, 0xfe,
  0xf8, 0x00, 0xf9, 0xfe, 0x2b, 0x00, 0x9b, 0x00, 0x36, 0xff, 0xd7, 0x01,
  0xba, 0xfd, 0xdb, 0x01, 0x73, 0xfe, 0xd3, 0x01, 0x91, 0xfc, 0xf7, 0x00,
  0x1f, 0x00, 0x35, 0xfc, 0x02, 0x05, 0x51, 0xff, 0x37, 0xfe, 0x3b, 0x02,
  0xa2, 0x00, 0x11, 0xfd, 0x23, 0x02, 0x37, 0x00, 0x7a, 0xff, 0x69, 0x03,
  0x62, 0xfd, 0xf6, 0xfe, 0x53, 0x03, 0xa8, 0xfc, 0x03, 0x00, 0x2c, 0x02,
  0x90, 0xfc, 0x17, 0x04, 0x2e, 0x01, 0x92, 0xfb, 0x20, 0x03, 0x39, 0xff,
  0xfc, 0xfb, 0x94, 0x02, 0xa8, 0xfd, 0x1f, 0x02, 0x89, 0x00, 0x81, 0x00,
  0x4a, 0x02, 0xef, 0xfa, 0x55, 0x02, 0xf7, 0x03, 0x52, 0xf9, 0x9d, 0x03,
  0xad, 0xfc, 0x18, 0xff, 0xf7, 0x03, 0xf4, 0xfe, 0x66, 0xfe, 0x4a, 0x07,
  0x3c, 0xfb, 0x64, 0xfa, 0xfe, 0x08, 0xcd, 0xfb, 0xfc, 0x00, 0x51, 0xfd,
  0xd6, 0x03, 0x43, 0xfc, 0x06, 0x02, 0x47, 0xfd, 0xf1, 0x04, 0xc0, 0xfb,
  0x1a, 0xff, 0x32, 0x03, 0x55, 0x00, 0x0a, 0xfc, 0xcd, 0x07, 0x95, 0xf6,
  0x6e, 0x04, 0x63, 0x02, 0xef, 0xf7, 0x43, 0x07, 0xc8, 0x03, 0x1c, 0xf3,
  0xd7, 0x0b, 0x76, 0xff, 0x38, 0xfb, 0xab, 0xff, 0xfd, 0x06, 0xae, 0xf6,
  0xac, 0x02, 0xba, 0x00, 0x2e, 0xff, 0x39, 0x02, 0x32, 0x04, 0x12, 0xfe,
  0x32, 0xfa, 0x17, 0x03, 0xf6, 0xff, 0x9c, 0xfb, 0x00, 0x06, 0x6f, 0xfa,
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
};
const unsigned int vocab_sixth_len = 22870;
