IowaScaledEngineering/ckt-defect/src/ckt-defect/vocab/include/slow.h

const unsigned char vocab_slow[] = {
  0x00, 0x00, 0x00, 0x00, 0x01, 0x00, 0xfe, 0xff, 0xfa, 0xff, 0x04, 0x00,
  0x00, 0x00, 0xfa, 0xff, 0x09, 0x00, 0xfa, 0xff, 0x11, 0x00, 0xf4, 0xff,
  0xff, 0xff, 0xec, 0xff, 0x02, 0x00, 0x09, 0x00, 0x12, 0x00, 0x07, 0x00,
  0xfc, 0xff, 0x08, 0x00, 0xd4, 0xff, 0xe4, 0xff, 0xf6, 0xff, 0x07, 0x00,
  0x44, 0x00, 0x08, 0x00, 0x4a, 0x00, 0xd4, 0xff, 0xff, 0xff, 0xbb, 0xff,
  0xcd, 0xff, 0xdb, 0xff, 0x11, 0x00, 0x4f, 0x00, 0x5c, 0x00, 0xef, 0xff,
  0x71, 0x00, 0xb1, 0xff, 0x72, 0xff, 0xea, 0xff, 0xf4, 0xff, 0x9c, 0xff,
  0x43, 0x00, 0x84, 0x00, 0x43, 0x00, 0x05, 0x00, 0x00, 0x00, 0x93, 0xff,
  0x37, 0x00, 0xb5, 0xff, 0x4b, 0xff, 0xe0, 0x00, 0x4f, 0x00, 0x88, 0xff,
  0x7f, 0x00, 0xda, 0xff, 0x0c, 0x00, 0xe9, 0xff, 0x9e, 0xff, 0xc1, 0xff,
  0x32, 0x00, 0x59, 0xff, 0xb6, 0x00, 0x1f, 0x01, 0x05, 0xff, 0x27, 0x00,
  0x6b, 0x00, 0x1b, 0xff, 0x2a, 0x01, 0x24, 0xff, 0xdc, 0xfe, 0xc7, 0x00,
  0xe9, 0xff, 0x58, 0x00, 0xb2, 0x00, 0xc2, 0xff, 0x66, 0x00, 0xdd, 0xff,
  0xb9, 0xff, 0xcd, 0xff, 0x97, 0xff, 0x4f, 0x00, 0xa8, 0xff, 0xc9, 0x00,
  0x26, 0x00, 0xc1, 0xff, 0xf8, 0x00, 0x55, 0xff, 0x1f, 0xfe, 0x83, 0xff,
  0x19, 0x01, 0xcb, 0xfe, 0xee, 0x01, 0xb7, 0x01, 0xf5, 0xff, 0x17, 0xff,
  0x88, 0x00, 0x0d, 0xfe, 0xa4, 0xff, 0x73, 0x00, 0x0f, 0x00, 0xea, 0xfe,
  0x9a, 0x02, 0x78, 0x00, 0x0c, 0xff, 0xf3, 0x00, 0x91, 0xfd, 0x4e, 0xff,
  0x52, 0xff, 0x2b, 0xff, 0xed, 0x03, 0x05, 0x01, 0x2c, 0xff, 0x35, 0x00,
  0x7b, 0x00, 0xf8, 0xfd, 0x92, 0xfe, 0x5a, 0x01, 0xe6, 0xff, 0xda, 0xfe,
  0x13, 0x02, 0x4b, 0x01, 0xe1, 0xff, 0x24, 0xfe, 0x16, 0x01, 0x80, 0xfe,
  0xfb, 0xfd, 0x50, 0x03, 0xf3, 0xff, 0x43, 0xfd, 0xd7, 0x04, 0xee, 0xfd,
  0xc9, 0xfe, 0xe4, 0x02, 0xf0, 0xfd, 0x63, 0xfd, 0x13, 0x03, 0xb0, 0xff,
  0xe1, 0xfd, 0xf1, 0x01, 0x0d, 0x01, 0x62, 0x00, 0xca, 0xfc, 0x44, 0x02,
  0xc1, 0x00, 0x68, 0xfd, 0x4c, 0x01, 0xcf, 0x00, 0x10, 0xff, 0x2c, 0xff,
  0x07, 0x04, 0x49, 0xfd, 0xde, 0xfd, 0x85, 0x01, 0x05, 0xff, 0xd9, 0xfd,
  0x69, 0x03, 0xf4, 0xff, 0x37, 0x02, 0x36, 0x00, 0xa8, 0xfb, 0xf5, 0x02,
  0x03, 0xfe, 0xdf, 0xfd, 0x39, 0x02, 0xf1, 0xff, 0x1a, 0x01, 0x56, 0x02,
  0x7e, 0xfe, 0xde, 0xff, 0x50, 0x00, 0xa8, 0xfb, 0x78, 0x02, 0xb5, 0xfe,
  0xba, 0x00, 0x08, 0x03, 0xa5, 0x02, 0x50, 0xfb, 0x78, 0x01, 0x6f, 0x00,
  0xbf, 0xfa, 0xda, 0xff, 0x67, 0x01, 0xba, 0xff, 0xd5, 0x00, 0xce, 0x04,
  0xcb, 0xff, 0x84, 0xff, 0x95, 0x03, 0xfa, 0xfc, 0x50, 0xf6, 0xca, 0x01,
  0x04, 0x06, 0x01, 0xfe, 0x6f, 0x01, 0x25, 0x05, 0xf0, 0xfd, 0x64, 0xfd,
  0x08, 0x03, 0x76, 0xf8, 0xb2, 0xfe, 0xdd, 0x00, 0x5d, 0x03, 0x4b, 0xfe,
  0xa4, 0x05, 0xf3, 0xff, 0x8a, 0xff, 0x22, 0xff, 0x93, 0xfb, 0x02, 0xfe,
  0x59, 0x01, 0x17, 0x03, 0x1b, 0x00, 0x56, 0x01, 0x89, 0xfe, 0xb8, 0xfd,
  0xdb, 0x04, 0x15, 0xff, 0x5f, 0xfc, 0x0e, 0x00, 0xd8, 0x02, 0xc6, 0xfd,
  0x6b, 0xff, 0xde, 0x06, 0x7b, 0xfa, 0x57, 0xf9, 0x9b, 0x0d, 0xeb, 0xf8,
  0x4b, 0xfd, 0x18, 0x05, 0xf6, 0xff, 0xc4, 0xfc, 0xe0, 0x0a, 0x8f, 0xf7,
  0xfc, 0xfe, 0x16, 0x04, 0xf0, 0xf7, 0xa1, 0x00, 0x51, 0x07, 0xc3, 0xfc,
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
};
const unsigned int vocab_slow_len = 18044;
