IowaScaledEngineering/ckt-defect/src/ckt-defect/vocab/include/south.h

const unsigned char vocab_south[] = {
  0x00, 0x00, 0x00, 0x00, 0x03, 0x00, 0x01, 0x00, 0xfa, 0xff, 0x00, 0x00,
  0x0d, 0x00, 0x02, 0x00, 0xf7, 0xff, 0xfc, 0xff, 0x0e, 0x00, 0xff, 0xff,
  0xf9, 0xff, 0xf1, 0xff, 0xfc, 0xff, 0x13, 0x00, 0xf8, 0xff, 0xe0, 0xff,
  0x0f, 0x00, 0x15, 0x00, 0xf3, 0xff, 0xe8, 0xff, 0xfb, 0xff, 0x1a, 0x00,
  0xfa, 0xff, 0x0c, 0x00, 0x29, 0x00, 0x15, 0x00, 0xd3, 0xff, 0x01, 0x00,
  0x3d, 0x00, 0x2f, 0x00, 0xb4, 0xff, 0xfb, 0xff, 0x48, 0x00, 0x0f, 0x00,
  0xd5, 0xff, 0xca, 0xff, 0x2b, 0x00, 0x1c, 0x00, 0x8a, 0xff, 0xd3, 0xff,
  0x20, 0x00, 0x37, 0x00, 0xf4, 0xff, 0xbf, 0xff, 0x3b, 0x00, 0x50, 0x00,
  0xb1, 0xff, 0x79, 0xff, 0xee, 0xff, 0x08, 0x00, 0xf7, 0xff, 0x1c, 0x00,
  0x6a, 0x00, 0x58, 0x00, 0xc4, 0xff, 0x1e, 0x00, 0x03, 0x00, 0xcb, 0xff,
  0xc9, 0xff, 0xf1, 0xff, 0x53, 0x00, 0x59, 0x00, 0x32, 0x00, 0x27, 0x00,
  0xe9, 0xff, 0xe5, 0xff, 0xad, 0xff, 0x08, 0x00, 0xcb, 0xff, 0xcd, 0xff,
  0x03, 0x00, 0xa8, 0xff, 0xde, 0xff, 0xbe, 0x00, 0x0e, 0x00, 0xa8, 0xff,
  0x40, 0x00, 0xf5, 0xff, 0xc0, 0xff, 0x7e, 0xff, 0x42, 0x00, 0x53, 0x00,
  0xc2, 0xff, 0xca, 0xff, 0xfd, 0x00, 0xac, 0x00, 0x55, 0xff, 0xc3, 0xff,
  0x5d, 0x00, 0x5e, 0x00, 0x28, 0xff, 0xaf, 0xff, 0x32, 0x01, 0x70, 0x00,
  0xc8, 0xff, 0xb7, 0xff, 0xd4, 0x00, 0xed, 0xff, 0xfb, 0xfe, 0x6a, 0xff,
  0x24, 0x00, 0x2a, 0x00, 0xa3, 0xfe, 0x2b, 0xff, 0x21, 0x01, 0x88, 0x00,
  0xed, 0xfd, 0xdd, 0xff, 0xff, 0x01, 0x4a, 0xff, 0x10, 0xfe, 0x29, 0x01,
  0x2e, 0x00, 0x5e, 0x00, 0xda, 0x00, 0x55, 0xfe, 0xed, 0x00, 0xb1, 0x02,
  0x19, 0x00, 0x82, 0xfe, 0x45, 0x01, 0x4a, 0x01, 0xea, 0xff, 0x08, 0xff,
  0x2f, 0x00, 0xf8, 0x00, 0xc4, 0xff, 0xbe, 0xfe, 0xd0, 0x00, 0x03, 0x01,
  0x5d, 0xff, 0xa5, 0xff, 0x4a, 0x00, 0xd4, 0xfe, 0x2f, 0xfe, 0xee, 0xff,
  0xc4, 0x00, 0x0f, 0xff, 0xd8, 0xff, 0x66, 0x00, 0x7b, 0x00, 0xc3, 0xfd,
  0x99, 0xff, 0x00, 0x01, 0x6a, 0xff, 0x07, 0xfe, 0xd7, 0x00, 0xca, 0x01,
  0xb9, 0xff, 0xf9, 0xff, 0xc0, 0x01, 0x48, 0x00, 0x2f, 0xff, 0x60, 0xff,
  0x1c, 0x01, 0xdd, 0x00, 0x24, 0xff, 0x60, 0x01, 0x33, 0x01, 0xec, 0xfe,
  0x7a, 0xff, 0x16, 0x02, 0x76, 0x01, 0x6c, 0xfd, 0xc3, 0xff, 0x57, 0x01,
  0xe0, 0xff, 0x5a, 0xff, 0xa4, 0xff, 0xc5, 0x01, 0x1a, 0xff, 0x82, 0xfd,
  0x83, 0x00, 0xb8, 0x01, 0x3f, 0xfd, 0xe4, 0xfe, 0x18, 0x01, 0xd6, 0xff,
  0x27, 0xff, 0xb0, 0x00, 0xef, 0xff, 0x20, 0xff, 0x23, 0x01, 0xa3, 0xfe,
  0xa7, 0xff, 0x0f, 0x01, 0x4d, 0x01, 0x11, 0xfc, 0x81, 0xff, 0x61, 0x04,
  0x08, 0x01, 0x6c, 0xfd, 0xd8, 0xff, 0x62, 0x03, 0x25, 0x00, 0x43, 0xfd,
  0x47, 0x01, 0xd9, 0x01, 0x59, 0xff, 0x33, 0xfe, 0x33, 0x00, 0x30, 0x03,
  0x0c, 0xff, 0xb8, 0xff, 0xeb, 0xff, 0xda, 0x00, 0x38, 0x00, 0xef, 0xff,
  0x7c, 0xfe, 0x18, 0xff, 0xf8, 0xfe, 0x77, 0x02, 0xbd, 0x00, 0x25, 0xfd,
  0x13, 0x00, 0x6c, 0x01, 0x21, 0x00, 0xb2, 0xfb, 0x95, 0xff, 0xb0, 0x02,
  0xb9, 0xff, 0x4e, 0x00, 0xfb, 0xfc, 0xd6, 0x02, 0x62, 0xfe, 0x89, 0xff,
  0xe5, 0x00, 0x59, 0x03, 0x56, 0xfc, 0x02, 0xfd, 0x30, 0x06, 0xf6, 0xff,
  0xf2, 0xff, 0xf6, 0xfd, 0x8e, 0x01, 0xfa, 0x02, 0x07, 0xfd, 0x39, 0x02,
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
};
const unsigned int vocab_south_len = 23520;
