IowaScaledEngineering/ckt-defect/src/ckt-defect/vocab/include/southbound.h

const unsigned char vocab_southbound[] = {
  0x00, 0x00, 0xff, 0xff, 0x03, 0x00, 0x02, 0x00, 0xfa, 0xff, 0x00, 0x00,
  0x08, 0x00, 0x04, 0x00, 0xff, 0xff, 0xf9, 0xff, 0x06, 0x00, 0xf8, 0xff,
  0x07, 0x00, 0x0b, 0x00, 0xfe, 0xff, 0xf8, 0xff, 0x07, 0x00, 0x12, 0x00,
  0x19, 0x00, 0xdb, 0xff, 0xdb, 0xff, 0x18, 0x00, 0x24, 0x00, 0xef, 0xff,
  0xcd, 0xff, 0x21, 0x00, 0x28, 0x00, 0xe1, 0xff, 0xb8, 0xff, 0x20, 0x00,
  0x43, 0x00, 0xa8, 0xff, 0xd2, 0xff, 0x60, 0x00, 0x05, 0x00, 0xc5, 0xff,
  0xea, 0xff, 0x3e, 0x00, 0x24, 0x00, 0xa2, 0xff, 0x01, 0x00, 0x31, 0x00,
  0x48, 0x00, 0xc1, 0xff, 0xfd, 0xff, 0x0c, 0x00, 0x3c, 0x00, 0xf8, 0xff,
  0x7c, 0xff, 0x02, 0x00, 0x77, 0x00, 0xec, 0xff, 0x81, 0xff, 0x18, 0x00,
  0xb7, 0x00, 0xd9, 0xff, 0x96, 0xff, 0xfa, 0xff, 0x82, 0x00, 0x89, 0xff,
  0xb4, 0xff, 0x6f, 0x00, 0x71, 0x00, 0x5a, 0xff, 0x38, 0x00, 0x3a, 0x00,
  0x0c, 0x00, 0xe6, 0xff, 0xf3, 0xff, 0x43, 0x00, 0xce, 0xff, 0x91, 0xff,
  0xaf, 0x00, 0x49, 0x00, 0x2b, 0xff, 0x11, 0x00, 0x9c, 0x00, 0xbc, 0xff,
  0x97, 0xff, 0xf6, 0xff, 0xb3, 0x00, 0xe4, 0xff, 0xf7, 0xfe, 0xb8, 0xff,
  0xcb, 0x00, 0x02, 0x00, 0x80, 0xff, 0x43, 0x00, 0x8b, 0xff, 0x61, 0x00,
  0x3c, 0x00, 0x27, 0x00, 0xa5, 0xff, 0xa8, 0xff, 0xbd, 0x00, 0x5e, 0x00,
  0x89, 0xff, 0x6d, 0xff, 0x54, 0x01, 0x11, 0x00, 0xd4, 0xff, 0xbe, 0xfe,
  0xe5, 0x00, 0x25, 0x01, 0x8f, 0xfe, 0x29, 0x00, 0x67, 0x01, 0xc3, 0xfe,
  0xc3, 0xfe, 0x92, 0x01, 0xda, 0x00, 0xfb, 0xfe, 0x6b, 0xff, 0x1a, 0x00,
  0x77, 0x00, 0x25, 0xff, 0x31, 0x00, 0x50, 0xff, 0xff, 0xff, 0x53, 0x01,
  0x27, 0x00, 0x5c, 0xfe, 0x7f, 0xff, 0x17, 0x02, 0xec, 0xff, 0x7a, 0xfd,
  0x08, 0x01, 0x18, 0x02, 0x9a, 0xfe, 0x80, 0xff, 0x00, 0x00, 0x0a, 0x02,
  0x2b, 0x00, 0xe4, 0xfd, 0x8c, 0x00, 0x79, 0x02, 0x0a, 0x00, 0x68, 0xfd,
  0xbd, 0xff, 0x20, 0x02, 0xd8, 0xff, 0x7d, 0xfd, 0x0c, 0x01, 0x07, 0x01,
  0xaa, 0xff, 0x56, 0xff, 0xe8, 0xff, 0x7f, 0x00, 0x81, 0x00, 0xd3, 0xfd,
  0x18, 0xff, 0x89, 0x02, 0xbc, 0xff, 0x96, 0xfd, 0xb6, 0x02, 0xff, 0x00,
  0xdb, 0xfb, 0xae, 0x00, 0x63, 0x02, 0x1d, 0x00, 0x55, 0xfe, 0x20, 0xff,
  0x97, 0x03, 0x52, 0x01, 0x48, 0xfd, 0x6e, 0x00, 0xb9, 0x02, 0x78, 0xfe,
  0x1d, 0xfc, 0xba, 0x00, 0xc6, 0x04, 0x1c, 0xff, 0xa1, 0xfc, 0xd7, 0x00,
  0xe3, 0x03, 0x36, 0xfe, 0x19, 0xfd, 0xe1, 0xfe, 0x70, 0x01, 0x67, 0x01,
  0xcc, 0xfd, 0x2e, 0xfe, 0x98, 0x04, 0x22, 0x01, 0xf0, 0xfd, 0x22, 0xfe,
  0xf2, 0x01, 0x7d, 0xff, 0xdb, 0xfc, 0xd6, 0xff, 0xc0, 0x01, 0xdc, 0x02,
  0x06, 0xfe, 0x84, 0xff, 0x70, 0x03, 0xef, 0xfe, 0xa9, 0xfa, 0x18, 0x03,
  0x87, 0x05, 0x2d, 0xf9, 0x7a, 0xff, 0x5c, 0x06, 0x42, 0x00, 0x7f, 0xfb,
  0xf8, 0xfe, 0xfc, 0x03, 0xd2, 0xff, 0x2c, 0xfc, 0x6e, 0x00, 0xf9, 0x02,
  0xb4, 0x00, 0x0b, 0xff, 0x5c, 0xfe, 0xf2, 0x03, 0x80, 0xff, 0xe1, 0xfd,
  0xa3, 0xfd, 0xc9, 0x00, 0xe2, 0x02, 0x18, 0xfd, 0x90, 0xfe, 0x4e, 0xfd,
  0xc5, 0x05, 0x67, 0x00, 0x02, 0xfa, 0xef, 0x03, 0x49, 0x01, 0x67, 0xff,
  0x60, 0x00, 0x28, 0xfd, 0xd9, 0x01, 0x74, 0x01, 0x7b, 0x00, 0xfe, 0xfd,
  0x03, 0xff, 0x30, 0x00, 0x19, 0x07, 0x1c, 0xfa, 0xba, 0xfb, 0x90, 0x04,
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
};
const unsigned int vocab_southbound_len = 40434;
