IowaScaledEngineering/ckt-defect/src/ckt-defect/vocab/include/speed.h

const unsigned char vocab_speed[] = {
  0x00, 0x00, 0x02, 0x00, 0x01, 0x00, 0x03, 0x00, 0xfe, 0xff, 0xfd, 0xff,
  0xfd, 0xff, 0xf4, 0xff, 0xf2, 0xff, 0xf7, 0xff, 0xf8, 0xff, 0x01, 0x00,
  0xfe, 0xff, 0x08, 0x00, 0x04, 0x00, 0x0a, 0x00, 0x03, 0x00, 0x0a, 0x00,
  0x00, 0x00, 0x0d, 0x00, 0x09, 0x00, 0x10, 0x00, 0x08, 0x00, 0x0f, 0x00,
  0x04, 0x00, 0x07, 0x00, 0xfb, 0xff, 0xff, 0xff, 0xf7, 0xff, 0x02, 0x00,
  0xf4, 0xff, 0x07, 0x00, 0xf5, 0xff, 0x00, 0x00, 0xfa, 0xff, 0x01, 0x00,
  0xf4, 0xff, 0x00, 0x00, 0xf4, 0xff, 0x05, 0x00, 0xef, 0xff, 0xfd, 0xff,
  0xf2, 0xff, 0x00, 0x00, 0xee, 0xff, 0x0a, 0x00, 0xf7, 0xff, 0x09, 0x00,
  0xf9, 0xff, 0x00, 0x00, 0x00, 0x00, 0x0c, 0x00, 0xf6, 0xff, 0x0f, 0x00,
  0xf3, 0xff, 0x11, 0x00, 0xf9, 0xff, 0x0c, 0x00, 0xfb, 0xff, 0x07, 0x00,
  0xf0, 0xff, 0x16, 0x00, 0xf7, 0xff, 0x11, 0x00, 0x00, 0x00, 0x0a, 0x00,
  0xff, 0xff, 0x13, 0x00, 0xec, 0xff, 0x0e, 0x00, 0xec, 0xff, 0x07, 0x00,
  0xf8, 0xff, 0x0c, 0x00, 0xf4, 0xff, 0x13, 0x00, 0xea, 0xff, 0x0d, 0x00,
  0xf1, 0xff, 0x12, 0x00, 0xf1, 0xff, 0x0d, 0x00, 0xef, 0xff, 0x13, 0x00,
  0xf4, 0xff, 0x13, 0x00, 0xea, 0xff, 0x0c, 0x00, 0xea, 0xff, 0x0e, 0x00,
  0xea, 0xff, 0x10, 0x00, 0xeb, 0xff, 0x0c, 0x00, 0xeb, 0xff, 0x14, 0x00,
  0xf2, 0xff, 0x16, 0x00, 0xec, 0xff, 0x0f, 0x00, 0xef, 0xff, 0x19, 0x00,
  0xf0, 0xff, 0x1a, 0x00, 0xeb, 0xff, 0x14, 0x00, 0xf6, 0xff, 0x20, 0x00,
  0xe9, 0xff, 0x1a, 0x00, 0xeb, 0xff, 0x19, 0x00, 0xed, 0xff, 0x12, 0x00,
  0xec, 0xff, 0x12, 0x00, 0xe2, 0xff, 0x19, 0x00, 0xe7, 0xff, 0x10, 0x00,
  0xe1, 0xff, 0x0d, 0x00, 0xe0, 0xff, 0x0d, 0x00, 0xd8, 0xff, 0x11, 0x00,
  0xde, 0xff, 0x19, 0x00, 0xed, 0xff, 0x21, 0x00, 0xf2, 0xff, 0x24, 0x00,
  0xf0, 0xff, 0x24, 0x00, 0xef, 0xff, 0x1f, 0x00, 0xf9, 0xff, 0x28, 0x00,
  0xe5, 0xff, 0x1d, 0x00, 0xe5, 0xff, 0x12, 0x00, 0xdb, 0xff, 0x0c, 0x00,
  0xd2, 0xff, 0x17, 0x00, 0xea, 0xff, 0x20, 0x00, 0xed, 0xff, 0x28, 0x00,
  0xde, 0xff, 0x1f, 0x00, 0xdb, 0xff, 0x12, 0x00, 0xe3, 0xff, 0x1d, 0x00,
  0xe8, 0xff, 0x39, 0x00, 0xde, 0xff, 0x11, 0x00, 0xdf, 0xff, 0x16, 0x00,
  0xe3, 0xff, 0x24, 0x00, 0xe7, 0xff, 0x23, 0x00, 0xd8, 0xff, 0x1e, 0x00,
  0xe4, 0xff, 0x1e, 0x00, 0xd6, 0xff, 0x1c, 0x00, 0xdb, 0xff, 0x29, 0x00,
  0xe1, 0xff, 0x24, 0x00, 0xd2, 0xff, 0x18, 0x00, 0xd6, 0xff, 0x18, 0x00,
  0xdc, 0xff, 0x2a, 0x00, 0xd9, 0xff, 0x1e, 0x00, 0xde, 0xff, 0x2e, 0x00,
  0xe2, 0xff, 0x34, 0x00, 0xf5, 0xff, 0x2a, 0x00, 0xe0, 0xff, 0x2d, 0x00,
  0xdb, 0xff, 0x22, 0x00, 0xd3, 0xff, 0x2b, 0x00, 0xdb, 0xff, 0x17, 0x00,
  0xd3, 0xff, 0x2a, 0x00, 0xd9, 0xff, 0x36, 0x00, 0xd1, 0xff, 0x1e, 0x00,
  0xd1, 0xff, 0x1e, 0x00, 0xc9, 0xff, 0x13, 0x00, 0xd0, 0xff, 0x33, 0x00,
  0xf0, 0xff, 0x35, 0x00, 0xde, 0xff, 0x2b, 0x00, 0xcb, 0xff, 0x25, 0x00,
  0xe4, 0xff, 0x3c, 0x00, 0xda, 0xff, 0x2d, 0x00, 0xe5, 0xff, 0x1d, 0x00,
  0xb7, 0xff, 0x36, 0x00, 0xe1, 0xff, 0x35, 0x00, 0xb7, 0xff, 0x21, 0x00,
  0xd8, 0xff, 0x37, 0x00, 0xc8, 0xff, 0x2a, 0x00, 0xc8, 0xff, 0x31, 0x00,
  0xcc, 0xff, 0x2d, 0x00, 0xc9, 0xff, 0x31, 0x00, 0xdf, 0xff, 0x57, 0x00,
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
};
const unsigned int vocab_speed_len = 25906;
