IowaScaledEngineering/ckt-defect/src/ckt-defect/vocab/include/temperature.h

const unsigned char vocab_temperature[] = {
  0x00, 0x00, 0x00, 0x00, 0xfe, 0xff, 0xfc, 0xff, 0xfc, 0xff, 0x04, 0x00,
  0x01, 0x00, 0x00, 0x00, 0x0f, 0x00, 0x05, 0x00, 0x00, 0x00, 0xf8, 0xff,
  0xf0, 0xff, 0xfa, 0xff, 0x12, 0x00, 0x0d, 0x00, 0x0e, 0x00, 0xf7, 0xff,
  0xeb, 0xff, 0xf8, 0xff, 0x07, 0x00, 0x0c, 0x00, 0x01, 0x00, 0xed, 0xff,
  0xfb, 0xff, 0xfb, 0xff, 0xe9, 0xff, 0xff, 0xff, 0x00, 0x00, 0xe5, 0xff,
  0x27, 0x00, 0x1d, 0x00, 0xe0, 0xff, 0xe0, 0xff, 0xff, 0xff, 0xe0, 0xff,
  0x16, 0x00, 0x21, 0x00, 0x20, 0x00, 0x1d, 0x00, 0x4d, 0x00, 0x29, 0x00,
  0xc8, 0xff, 0xb6, 0xff, 0xe8, 0xff, 0x2a, 0x00, 0x46, 0x00, 0x0d, 0x00,
  0xbc, 0xff, 0xb2, 0xff, 0x37, 0x00, 0x16, 0x00, 0x1c, 0x00, 0x24, 0x00,
  0xf8, 0xff, 0xa7, 0xff, 0xf5, 0xff, 0x19, 0x00, 0x00, 0x00, 0xf4, 0xff,
  0xd5, 0xff, 0xc2, 0xff, 0x2c, 0x00, 0x13, 0x00, 0x67, 0xff, 0xc2, 0xff,
  0x58, 0x00, 0xde, 0xff, 0x1b, 0x00, 0xf0, 0xff, 0x41, 0x00, 0xa5, 0x00,
  0x8d, 0x00, 0xf5, 0xff, 0x33, 0xff, 0xfa, 0xff, 0x0d, 0x00, 0x75, 0x00,
  0x5a, 0x00, 0xf1, 0xff, 0x15, 0x00, 0x0d, 0x00, 0xb2, 0xff, 0xf4, 0xff,
  0x89, 0xff, 0x02, 0x00, 0xb6, 0xff, 0xf4, 0xff, 0x7d, 0x00, 0x6b, 0x00,
  0xed, 0xff, 0x31, 0xff, 0xab, 0xff, 0xe9, 0xfe, 0x8d, 0x00, 0xc2, 0x00,
  0xc5, 0x00, 0xab, 0xff, 0x6c, 0xff, 0x6b, 0x00, 0xca, 0xff, 0x68, 0x00,
  0xae, 0x00, 0x02, 0x00, 0xf6, 0xff, 0x9b, 0xff, 0xc4, 0xff, 0xf1, 0xff,
  0x54, 0x00, 0x9a, 0xff, 0x0c, 0x00, 0xcf, 0xff, 0xea, 0x00, 0xc2, 0xff,
  0x2e, 0x00, 0xa0, 0xff, 0x51, 0xff, 0x26, 0x00, 0xa1, 0x00, 0x7d, 0xff,
  0xe2, 0xff, 0x96, 0x00, 0xbf, 0xff, 0x4c, 0x00, 0x26, 0x00, 0x99, 0xfe,
  0x27, 0x00, 0x3b, 0x01, 0x6a, 0xfe, 0x76, 0xff, 0x49, 0x01, 0x03, 0x00,
  0x28, 0xfe, 0x9a, 0x01, 0xe5, 0x00, 0x97, 0xff, 0xad, 0x00, 0x40, 0xff,
  0x0d, 0x01, 0x0a, 0x01, 0x22, 0xfe, 0x22, 0x00, 0x77, 0x01, 0x2e, 0xfe,
  0x8c, 0xff, 0xc1, 0x01, 0x2b, 0xff, 0xbe, 0xfe, 0xe1, 0xff, 0xfb, 0x02,
  0x56, 0xfe, 0x73, 0xff, 0x88, 0xfe, 0x42, 0x00, 0xc3, 0x00, 0x33, 0x02,
  0xcd, 0x01, 0xd1, 0xfe, 0x57, 0x00, 0xd5, 0xfd, 0x97, 0xfe, 0x9e, 0xff,
  0x62, 0x01, 0x99, 0xff, 0x3d, 0x03, 0xa1, 0xfe, 0x87, 0xfe, 0xc3, 0x01,
  0x57, 0xfd, 0xa6, 0xff, 0x74, 0x00, 0x0c, 0x01, 0x63, 0x00, 0x5e, 0xfe,
  0xc4, 0x00, 0x35, 0x00, 0x9c, 0xff, 0xf2, 0x02, 0x0b, 0xf8, 0xc1, 0xfb,
  0x97, 0x0c, 0xa3, 0x01, 0x7b, 0xfc, 0xd5, 0xfc, 0x49, 0xfc, 0x78, 0x03,
  0xf6, 0x06, 0x77, 0xfc, 0xc6, 0xfc, 0x7e, 0x06, 0xf3, 0xfc, 0x4c, 0x00,
  0x61, 0x06, 0x97, 0x04, 0x3d, 0x00, 0xb3, 0xf8, 0x61, 0xf9, 0xba, 0xfc,
  0xf1, 0x00, 0xee, 0xfb, 0xa6, 0x02, 0x82, 0xfe, 0xbd, 0xfe, 0x86, 0x03,
  0x90, 0x06, 0x9e, 0xfb, 0x9f, 0xff, 0xad, 0x00, 0xb3, 0xfc, 0x7c, 0x04,
  0x73, 0x03, 0xec, 0x06, 0x81, 0xf7, 0x2f, 0xf5, 0x0a, 0x04, 0x5e, 0xff,
  0x14, 0xff, 0xa7, 0x03, 0x24, 0x0b, 0xe4, 0xfa, 0x54, 0x04, 0x2a, 0x02,
  0xa9, 0xf5, 0xc6, 0xfe, 0xa5, 0x07, 0xd8, 0xf6, 0x7b, 0x05, 0x9b, 0x08,
  0x1a, 0xfb, 0x4a, 0x00, 0x6e, 0xfc, 0x4b, 0xf8, 0x71, 0xf9, 0xbe, 0x09,
  0x03, 0x09, 0x86, 0xff, 0x99, 0x05, 0x90, 0xf2, 0x47, 0x02, 0x6b, 0x00,
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
};
const unsigned int vocab_temperature_len = 20564;
