IowaScaledEngineering/ckt-defect/src/ckt-defect/vocab/include/third.h

const unsigned char vocab_third[] = {
  0x00, 0x00, 0x00, 0x00, 0x00, 0x00, 0x00, 0x00, 0xfc, 0xff, 0x00, 0x00,
  0x09, 0x00, 0x00, 0x00, 0xfc, 0xff, 0x01, 0x00, 0xf9, 0xff, 0xfe, 0xff,
  0x10, 0x00, 0x01, 0x00, 0xfb, 0xff, 0xf1, 0xff, 0x11, 0x00, 0x00, 0x00,
  0xe7, 0xff, 0x0c, 0x00, 0x0c, 0x00, 0xf8, 0xff, 0x0a, 0x00, 0x10, 0x00,
  0xf0, 0xff, 0xef, 0xff, 0x05, 0x00, 0x04, 0x00, 0x03, 0x00, 0xf3, 0xff,
  0xe8, 0xff, 0x0c, 0x00, 0xf1, 0xff, 0x36, 0x00, 0x02, 0x00, 0xfc, 0xff,
  0xe9, 0xff, 0x2c, 0x00, 0xd6, 0xff, 0xeb, 0xff, 0xfd, 0xff, 0x1e, 0x00,
  0xe5, 0xff, 0xc9, 0xff, 0x5d, 0x00, 0xdd, 0xff, 0xe8, 0xff, 0xf2, 0xff,
  0x35, 0x00, 0x2c, 0x00, 0xf9, 0xff, 0xb6, 0xff, 0x6a, 0x00, 0x1c, 0x00,
  0xe8, 0xff, 0x50, 0x00, 0x8b, 0xff, 0xa6, 0xff, 0x38, 0x00, 0xfe, 0xff,
  0x99, 0xff, 0x05, 0x00, 0x85, 0x00, 0x2a, 0x00, 0xac, 0xff, 0xb4, 0xff,
  0x3c, 0x00, 0x82, 0x00, 0xf9, 0xff, 0x99, 0xff, 0xcd, 0xff, 0x53, 0x00,
  0x1a, 0x00, 0x98, 0xff, 0xcb, 0xff, 0x9d, 0x00, 0x2f, 0x00, 0x5a, 0xff,
  0x72, 0x00, 0x31, 0x00, 0xeb, 0xff, 0xe7, 0xff, 0x30, 0x00, 0xc0, 0xff,
  0xad, 0xff, 0xc1, 0xff, 0x4f, 0x00, 0x28, 0x00, 0x82, 0xff, 0x18, 0x00,
  0xb5, 0x00, 0x2b, 0x00, 0x79, 0xff, 0x86, 0xff, 0x80, 0x00, 0xd7, 0x00,
  0x93, 0xff, 0x79, 0xff, 0xdb, 0xff, 0xb1, 0x00, 0x19, 0xff, 0x28, 0x00,
  0x88, 0x00, 0x15, 0x00, 0x10, 0x00, 0xfb, 0xff, 0x30, 0xff, 0xb2, 0x00,
  0xee, 0xff, 0x1c, 0xff, 0x28, 0x00, 0x65, 0x00, 0xdc, 0xff, 0x79, 0x00,
  0x99, 0x00, 0xa0, 0xff, 0xb1, 0xff, 0xb0, 0xff, 0x4e, 0x00, 0x4e, 0x00,
  0xb0, 0xff, 0x29, 0xff, 0x24, 0x01, 0xe1, 0xff, 0x7f, 0xff, 0xac, 0x00,
  0x34, 0x00, 0xd6, 0xff, 0xc3, 0xff, 0x55, 0x00, 0x90, 0x00, 0xb1, 0xfe,
  0x41, 0x00, 0x61, 0xff, 0xbd, 0xff, 0xa5, 0x00, 0xa4, 0xff, 0xe9, 0x00,
  0x9d, 0xff, 0x41, 0xfe, 0x70, 0x01, 0x3f, 0x01, 0x52, 0xff, 0x52, 0xff,
  0x4a, 0x00, 0x74, 0x00, 0x30, 0xff, 0x80, 0xff, 0x0b, 0x01, 0x05, 0x01,
  0xe2, 0xfe, 0x78, 0x00, 0x2f, 0xff, 0xce, 0x00, 0x3c, 0x00, 0x3f, 0x00,
  0x2d, 0xff, 0x69, 0x00, 0xa9, 0xff, 0xb5, 0xff, 0x83, 0x00, 0x8e, 0x00,
  0xae, 0x00, 0xaf, 0xfe, 0xca, 0x00, 0x14, 0xff, 0x3e, 0x00, 0x05, 0xff,
  0x0e, 0x00, 0xae, 0xff, 0x36, 0xff, 0x16, 0x02, 0x4a, 0x00, 0xba, 0xff,
  0xf9, 0xfe, 0xfd, 0x00, 0xe4, 0xff, 0x0e, 0xff, 0x1a, 0x00, 0xe9, 0x00,
  0xec, 0xff, 0x2c, 0x00, 0x96, 0x00, 0xba, 0xfd, 0x69, 0xff, 0xed, 0x01,
  0x4f, 0xfe, 0xb8, 0x00, 0xb8, 0x00, 0x1b, 0xff, 0xcb, 0x02, 0x2c, 0xff,
  0xb1, 0xfd, 0xf8, 0xff, 0x5e, 0x03, 0xcf, 0xff, 0x7a, 0xfe, 0xe2, 0xfe,
  0x0b, 0x01, 0xa9, 0x02, 0xec, 0xfd, 0x5b, 0xff, 0x68, 0xfe, 0x8a, 0x02,
  0xf8, 0xfe, 0x1b, 0xfe, 0x92, 0x02, 0x45, 0x00, 0x45, 0x00, 0x30, 0xff,
  0xb5, 0xff, 0xa0, 0x00, 0x19, 0xff, 0x9f, 0x00, 0x34, 0x01, 0x4f, 0xff,
  0x8e, 0xff, 0x3b, 0x00, 0x39, 0xff, 0x78, 0xfd, 0x1c, 0xfe, 0x59, 0xff,
  0x9b, 0x04, 0x91, 0x01, 0x85, 0x00, 0x58, 0xff, 0x70, 0x01, 0x28, 0x02,
  0xf3, 0xfb, 0x89, 0xfe, 0x1d, 0xff, 0x62, 0x00, 0xe5, 0xff, 0x06, 0x02,
  0xc8, 0x00, 0x7b, 0xff, 0x08, 0x00, 0xee, 0x01, 0x6e, 0xfe, 0xed, 0xfd,
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
};
const unsigned int vocab_third_len = 19712;
