IowaScaledEngineering/ckt-defect/src/ckt-defect/vocab/include/total.h

const unsigned char vocab_total[] = {
  0x00, 0x00, 0x00, 0x00, 0x02, 0x00, 0x02, 0x00, 0xfe, 0xff, 0xfa, 0xff,
  0x09, 0x00, 0x1c, 0x00, 0x0b, 0x00, 0xf3, 0xff, 0x08, 0x00, 0x55, 0x00,
  0x8f, 0x00, 0x40, 0x00, 0xc3, 0xff, 0xd1, 0xff, 0x9c, 0xff, 0x45, 0xfe,
  0x72, 0xfc, 0x44, 0xfc, 0x25, 0x02, 0xc5, 0x07, 0x50, 0x07, 0x31, 0xfe,
  0xfc, 0xf8, 0x04, 0xfd, 0x6f, 0x04, 0xc1, 0x02, 0x87, 0xfb, 0x91, 0xfc,
  0x67, 0x03, 0xaf, 0x06, 0x12, 0x00, 0xba, 0xf8, 0xc3, 0xf8, 0xb0, 0xfe,
  0x81, 0x04, 0x5d, 0x04, 0xcd, 0x02, 0xb1, 0x01, 0x27, 0xfe, 0x6e, 0xfd,
  0x27, 0xff, 0xc9, 0x00, 0x11, 0xff, 0x01, 0x00, 0x0b, 0xff, 0xc5, 0x01,
  0x61, 0x02, 0x10, 0x00, 0xa4, 0xfd, 0x36, 0xf9, 0x14, 0xfc, 0xde, 0x02,
  0x73, 0x09, 0x1b, 0x09, 0x99, 0xff, 0xde, 0xfb, 0xc3, 0xfe, 0xaf, 0x04,
  0x46, 0x03, 0x09, 0xf2, 0x0f, 0xf5, 0x87, 0x03, 0xfb, 0x11, 0xea, 0x06,
  0xfc, 0xf6, 0xbc, 0xf2, 0x1b, 0x02, 0x1b, 0x06, 0xa3, 0xf9, 0xa7, 0xfc,
  0xb1, 0x05, 0xb9, 0x08, 0x68, 0x00, 0x99, 0xf7, 0x75, 0xfa, 0x18, 0x03,
  0x0f, 0x05, 0x1f, 0x01, 0x93, 0xf3, 0x88, 0xfe, 0xd6, 0x07, 0x54, 0x0b,
  0xc3, 0x00, 0xbe, 0xf1, 0x8e, 0xfa, 0x34, 0x08, 0xeb, 0xfb, 0x83, 0x00,
  0x8a, 0x04, 0xf8, 0x01, 0x65, 0x0d, 0x76, 0xfb, 0x30, 0xf7, 0xee, 0xff,
  0x93, 0xfd, 0x8c, 0x0a, 0x5d, 0xfd, 0xe7, 0xfb, 0xc8, 0xf9, 0xa6, 0x06,
  0x26, 0x07, 0xd6, 0x01, 0xbd, 0xf9, 0x4a, 0xfd, 0x8a, 0x01, 0x8e, 0xfb,
  0xfd, 0xfe, 0xfc, 0xf8, 0x1e, 0x09, 0xa5, 0x0f, 0xc4, 0xfa, 0x35, 0xf9,
  0x8b, 0xf7, 0xdf, 0x06, 0xe7, 0x01, 0x25, 0xfb, 0xdb, 0xfb, 0x82, 0xff,
  0xeb, 0x0c, 0x8e, 0x03, 0xd2, 0xf8, 0x64, 0xfa, 0x89, 0xfe, 0xa5, 0x01,
  0x56, 0x06, 0x74, 0xf2, 0xe3, 0x01, 0x89, 0x09, 0x95, 0x01, 0xf2, 0xf7,
  0xca, 0x00, 0xb4, 0x03, 0x4c, 0x00, 0xca, 0xf3, 0xf9, 0x07, 0x21, 0x08,
  0x81, 0x01, 0x6b, 0x01, 0x40, 0xff, 0x72, 0xfd, 0x6b, 0x00, 0x29, 0xf4,
  0x70, 0x08, 0x03, 0xfa, 0x75, 0xff, 0xde, 0x08, 0xa3, 0xff, 0x7a, 0xff,
  0xe2, 0xf9, 0xef, 0x00, 0x05, 0x05, 0xf1, 0xfe, 0xe1, 0x05, 0x33, 0xff,
  0x4d, 0xf6, 0xa7, 0xfe, 0xdd, 0x03, 0xe7, 0xf8, 0x6c, 0x01, 0xc7, 0x01,
  0xfb, 0x06, 0x62, 0xf7, 0x61, 0xff, 0xba, 0x0c, 0x47, 0xfc, 0x94, 0xff,
  0x58, 0xfb, 0x40, 0x00, 0x7c, 0x0e, 0x55, 0xed, 0xfd, 0x03, 0xa8, 0x0b,
  0xb4, 0xf4, 0x85, 0xf8, 0xd7, 0x04, 0xe9, 0x09, 0x5b, 0x01, 0xb0, 0xf5,
  0x7c, 0xff, 0x3c, 0x11, 0x39, 0xf2, 0x69, 0x00, 0x60, 0x04, 0xbe, 0xfb,
  0x32, 0x02, 0x72, 0x13, 0xc7, 0xf1, 0x95, 0xf3, 0xed, 0x07, 0x70, 0xf5,
  0x9a, 0x03, 0x6f, 0x02, 0xa1, 0xf9, 0x59, 0x00, 0xbf, 0x18, 0x6c, 0xfe,
  0x94, 0xe7, 0x9d, 0x02, 0xd9, 0xff, 0x3c, 0x08, 0x76, 0x00, 0x54, 0xfa,
  0x53, 0x08, 0x18, 0x06, 0x9c, 0xf1, 0x3b, 0xf9, 0x30, 0x01, 0x76, 0x07,
  0x65, 0x01, 0xdd, 0x04, 0xe2, 0x02, 0x8b, 0x00, 0x43, 0xfa, 0x35, 0xfb,
  0x3e, 0xff, 0xfa, 0xff, 0xfa, 0xfb, 0x21, 0x07, 0xf3, 0x06, 0x84, 0x04,
  0xae, 0x03, 0x3e, 0x04, 0x3a, 0xf7, 0x19, 0xec, 0x03, 0x00, 0x6f, 0x09,
  0x7e, 0x02, 0x67, 0x07, 0xd7, 0x04, 0x54, 0xfa, 0xe5, 0xf2, 0xc4, 0x01,
  0x1f, 0x08, 0x59, 0xec, 0x85, 0xf8, 0xbb, 0x04, 0x49, 0x14, 0x20, 0x0d,
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
};
const unsigned int vocab_total_len = 16000;
