IowaScaledEngineering/ckt-defect/src/ckt-defect/vocab/include/train.h

const unsigned char vocab_train[] = {
  0x00, 0x00, 0xff, 0xff, 0xff, 0xff, 0x01, 0x00, 0x02, 0x00, 0x02, 0x00,
  0xfe, 0xff, 0xfd, 0xff, 0x06, 0x00, 0x08, 0x00, 0x05, 0x00, 0x01, 0x00,
  0xfa, 0xff, 0xf3, 0xff, 0xfa, 0xff, 0xff, 0xff, 0x13, 0x00, 0x2b, 0x00,
  0x03, 0x00, 0xe2, 0xff, 0xd3, 0xff, 0xe6, 0xff, 0x0d, 0x00, 0x2a, 0x00,
  0x30, 0x00, 0x07, 0x00, 0xd1, 0xff, 0xbb, 0xff, 0xc8, 0xff, 0x2a, 0x00,
  0x8e, 0x00, 0xba, 0x00, 0x86, 0x00, 0xbd, 0xff, 0xac, 0xfe, 0xad, 0xfe,
  0x94, 0xff, 0x80, 0x00, 0xd1, 0x00, 0x51, 0x00, 0xbc, 0xff, 0x31, 0xff,
  0xd4, 0xff, 0x0f, 0x01, 0x00, 0x01, 0x90, 0x00, 0xf4, 0xff, 0x2a, 0xff,
  0x8b, 0xff, 0x27, 0x00, 0x1f, 0x00, 0x47, 0x00, 0xf2, 0xff, 0x64, 0xff,
  0xcc, 0xff, 0x8c, 0x00, 0x7f, 0x00, 0x39, 0x00, 0x10, 0x00, 0x5b, 0xff,
  0xb9, 0xff, 0x91, 0x00, 0xe0, 0xff, 0x98, 0xff, 0xe3, 0xff, 0xe0, 0xff,
  0x28, 0x00, 0x6d, 0x00, 0x4b, 0x00, 0xba, 0xff, 0xef, 0xff, 0xf4, 0xff,
  0x05, 0xff, 0x9d, 0xff, 0x65, 0x00, 0xe4, 0x00, 0xb3, 0x00, 0x67, 0x00,
  0x1b, 0xff, 0x42, 0xfe, 0xbd, 0xff, 0x52, 0x00, 0x40, 0x01, 0x5b, 0x02,
  0xb1, 0x00, 0x8d, 0xff, 0x96, 0xff, 0xf7, 0xfd, 0x8b, 0xfd, 0xe3, 0xff,
  0xdc, 0xff, 0xab, 0x01, 0xad, 0x02, 0x03, 0xff, 0xdb, 0xfd, 0x59, 0xff,
  0x0d, 0xff, 0x9c, 0x01, 0xe9, 0x03, 0x7f, 0x00, 0x76, 0xfd, 0xb7, 0xfd,
  0xb9, 0xfd, 0xda, 0xfe, 0x0c, 0x03, 0xcd, 0x02, 0xb9, 0x01, 0x02, 0x00,
  0x75, 0xfc, 0xda, 0xfe, 0xbf, 0x02, 0x5f, 0x02, 0xd0, 0x00, 0xd6, 0x00,
  0x81, 0xfc, 0x45, 0xfe, 0x42, 0x02, 0xa5, 0xff, 0x71, 0x00, 0xee, 0xff,
  0xc6, 0xfe, 0x07, 0xff, 0x43, 0xff, 0xa1, 0x00, 0x63, 0x01, 0x91, 0x02,
  0x02, 0x01, 0x6b, 0xfd, 0xe1, 0xfd, 0x3a, 0xfe, 0x59, 0xfe, 0x0b, 0x01,
  0xa2, 0x01, 0x46, 0x00, 0x91, 0x00, 0x44, 0xff, 0xb3, 0x01, 0xdd, 0x02,
  0xd4, 0xfe, 0x10, 0xfe, 0x54, 0xfe, 0xab, 0xfd, 0x86, 0xff, 0x0a, 0x04,
  0xb7, 0x03, 0x6d, 0x01, 0x97, 0xff, 0x8b, 0xfb, 0x54, 0xfd, 0x73, 0xff,
  0x1d, 0xff, 0x4a, 0x02, 0xf4, 0x01, 0x92, 0x00, 0x86, 0xff, 0xc3, 0xfe,
  0x31, 0x03, 0x93, 0xff, 0x38, 0xff, 0x79, 0xfe, 0x7e, 0xfe, 0x1a, 0x02,
  0x65, 0x04, 0x61, 0xfd, 0x05, 0xfa, 0xe9, 0xff, 0x05, 0x06, 0x4c, 0x02,
  0x08, 0xfe, 0xd6, 0xfc, 0x0d, 0xfa, 0xe1, 0x01, 0xbe, 0x05, 0x46, 0x00,
  0x4a, 0x03, 0xef, 0xff, 0xa0, 0xf9, 0x49, 0x02, 0xac, 0x01, 0x35, 0x03,
  0x7c, 0xff, 0xf9, 0xfd, 0x2c, 0xfe, 0x97, 0xff, 0xbb, 0xfe, 0xae, 0xfd,
  0x93, 0x05, 0x1f, 0x03, 0x4c, 0xff, 0x5c, 0x00, 0x17, 0xfb, 0xc9, 0xfd,
  0x51, 0xfb, 0x25, 0xfb, 0xcc, 0x02, 0x96, 0x0a, 0x81, 0x03, 0x28, 0xfe,
  0x76, 0xff, 0x8e, 0xf9, 0x9e, 0xfb, 0x56, 0x06, 0x96, 0x03, 0x21, 0xfe,
  0x00, 0x03, 0x39, 0xfa, 0x64, 0xf8, 0x38, 0x0c, 0x51, 0x06, 0xb1, 0xf5,
  0x7e, 0x03, 0xbe, 0x03, 0x99, 0xf6, 0x56, 0x01, 0xdd, 0xff, 0xe8, 0xf9,
  0x4e, 0x0c, 0xb4, 0x05, 0xea, 0xf3, 0xf8, 0x00, 0x71, 0x0b, 0x68, 0xfb,
  0x36, 0x05, 0xc8, 0xf9, 0x2c, 0xf4, 0x4f, 0x11, 0x42, 0xfb, 0x38, 0xfa,
  0xaf, 0x03, 0x3b, 0xff, 0x88, 0x01, 0x2a, 0xf5, 0x4a, 0x02, 0x1e, 0x11,
  0xab, 0xf8, 0xb4, 0x01, 0x90, 0xfb, 0x47, 0xf8, 0xbc, 0x05, 0xaf, 0x00,
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
};
const unsigned int vocab_train_len = 16000;
