IowaScaledEngineering/ckt-defect/src/ckt-defect/vocab/include/west.h

const unsigned char vocab_west[] = {
  0x00, 0x00, 0xfe, 0xff, 0xfd, 0xff, 0xfb, 0xff, 0xfb, 0xff, 0xf9, 0xff,
  0xfb, 0xff, 0xfb, 0xff, 0xfd, 0xff, 0xfe, 0xff, 0x01, 0x00, 0x03, 0x00,
  0x08, 0x00, 0x0c, 0x00, 0x15, 0x00, 0x19, 0x00, 0x22, 0x00, 0x26, 0x00,
  0x2e, 0x00, 0x2f, 0x00, 0x32, 0x00, 0x2e, 0x00, 0x32, 0x00, 0x2d, 0x00,
  0x2d, 0x00, 0x26, 0x00, 0x21, 0x00, 0x18, 0x00, 0x13, 0x00, 0x06, 0x00,
  0x07, 0x00, 0x00, 0x00, 0xff, 0xff, 0xf8, 0xff, 0xf8, 0xff, 0xf0, 0xff,
  0xef, 0xff, 0xe0, 0xff, 0xe3, 0xff, 0xd6, 0xff, 0xd2, 0xff, 0xcd, 0xff,
  0xc6, 0xff, 0xbd, 0xff, 0xba, 0xff, 0xa9, 0xff, 0xaf, 0xff, 0xae, 0xff,
  0xc1, 0xff, 0xc8, 0xff, 0xd3, 0xff, 0xdc, 0xff, 0xed, 0xff, 0xf6, 0xff,
  0x10, 0x00, 0x26, 0x00, 0x50, 0x00, 0x6f, 0x00, 0x97, 0x00, 0xb7, 0x00,
  0xd4, 0x00, 0xe6, 0x00, 0xfd, 0x00, 0x07, 0x01, 0x20, 0x01, 0x07, 0x01,
  0xf4, 0x00, 0xc4, 0x00, 0x96, 0x00, 0x52, 0x00, 0xff, 0xff, 0xa8, 0xff,
  0x64, 0xff, 0x11, 0xff, 0xd3, 0xfe, 0x8a, 0xfe, 0x61, 0xfe, 0x2b, 0xfe,
  0x06, 0xfe, 0xd3, 0xfd, 0xc1, 0xfd, 0xb6, 0xfd, 0xc5, 0xfd, 0xc7, 0xfd,
  0xed, 0xfd, 0x19, 0xfe, 0x6c, 0xfe, 0xb7, 0xfe, 0x24, 0xff, 0x8f, 0xff,
  0x0f, 0x00, 0x76, 0x00, 0xe6, 0x00, 0x40, 0x01, 0xac, 0x01, 0xf9, 0x01,
  0x48, 0x02, 0x74, 0x02, 0xb1, 0x02, 0xcb, 0x02, 0xde, 0x02, 0xc8, 0x02,
  0xbf, 0x02, 0x96, 0x02, 0x6e, 0x02, 0x23, 0x02, 0xe9, 0x01, 0x96, 0x01,
  0x56, 0x01, 0xf4, 0x00, 0xa5, 0x00, 0x44, 0x00, 0xf7, 0xff, 0x8f, 0xff,
  0x43, 0xff, 0xec, 0xfe, 0xb9, 0xfe, 0x79, 0xfe, 0x67, 0xfe, 0x48, 0xfe,
  0x4f, 0xfe, 0x44, 0xfe, 0x5f, 0xfe, 0x6d, 0xfe, 0x98, 0xfe, 0xae, 0xfe,
  0xdf, 0xfe, 0xf6, 0xfe, 0x2b, 0xff, 0x49, 0xff, 0x79, 0xff, 0x8b, 0xff,
  0xab, 0xff, 0xa3, 0xff, 0xb0, 0xff, 0x8e, 0xff, 0x89, 0xff, 0x67, 0xff,
  0x79, 0xff, 0x7d, 0xff, 0x9c, 0xff, 0x85, 0xff, 0x8d, 0xff, 0x72, 0xff,
  0x7d, 0xff, 0x7d, 0xff, 0xa4, 0xff, 0xc5, 0xff, 0x0d, 0x00, 0x3a, 0x00,
  0x92, 0x00, 0xc8, 0x00, 0x08, 0x01, 0x13, 0x01, 0x28, 0x01, 0x1e, 0x01,
  0x35, 0x01, 0x28, 0x01, 0x35, 0x01, 0x33, 0x01, 0x4e, 0x01, 0x4f, 0x01,
  0x5c, 0x01, 0x39, 0x01, 0x34, 0x01, 0x00, 0x01, 0xee, 0x00, 0xb9, 0x00,
  0xab, 0x00, 0x5e, 0x00, 0x2b, 0x00, 0xe0, 0xff, 0xc1, 0xff, 0x8c, 0xff,
  0x6a, 0xff, 0x34, 0xff, 0x37, 0xff, 0x13, 0xff, 0x02, 0xff, 0xd6, 0xfe,
  0xe3, 0xfe, 0xcb, 0xfe, 0xcd, 0xfe, 0xa0, 0xfe, 0xae, 0xfe, 0x91, 0xfe,
  0xa8, 0xfe, 0xa4, 0xfe, 0xe0, 0xfe, 0xdb, 0xfe, 0x0a, 0xff, 0xf7, 0xfe,
  0x17, 0xff, 0x4c, 0xff, 0x99, 0xff, 0xc1, 0xff, 0x49, 0x00, 0xc4, 0x00,
  0xa8, 0x01, 0x39, 0x02, 0xd0, 0x02, 0x5c, 0x03, 0xd7, 0x03, 0xe5, 0x03,
  0x07, 0x04, 0x1f, 0x04, 0x8a, 0x04, 0x8a, 0x04, 0x2d, 0x04, 0x97, 0x03,
  0x35, 0x03, 0xb3, 0x02, 0xf1, 0x01, 0xc3, 0x00, 0xe7, 0xff, 0x1a, 0xff,
  0x5e, 0xfe, 0x44, 0xfd, 0x24, 0xfc, 0x1a, 0xfb, 0x48, 0xfa, 0x39, 0xf9,
  0x76, 0xf8, 0xf4, 0xf7, 0x08, 0xf8, 0x0d, 0xf8, 0x42, 0xf8, 0x8a, 0xf8,
  0x3b, 0xf9, 0xec, 0xf9, 0xca, 0xfa, 0x90, 0xfb, 0xd8, 0xfc, 0x50, 0xfe,
  0x00, 0x00, 0x5b, 0x01, 0xd4, 0x02, 0x33, 0x04, 0x6d, 0x05, 0x1d, 0x06,
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
};
const unsigned int vocab_west_len = 19960;
