IowaScaledEngineering/ckt-defect/src/ckt-defect/vocab/include/westbound.h

const unsigned char vocab_westbound[] = {
  0x00, 0x00, 0xff, 0xff, 0xfd, 0xff, 0xfc, 0xff, 0xfb, 0xff, 0xf9, 0xff,
  0xfa, 0xff, 0xf9, 0xff, 0xfa, 0xff, 0xfa, 0xff, 0xfc, 0xff, 0xfd, 0xff,
  0x00, 0x00, 0x00, 0x00, 0x04, 0x00, 0x06, 0x00, 0x09, 0x00, 0x0a, 0x00,
  0x0d, 0x00, 0x0e, 0x00, 0x11, 0x00, 0x11, 0x00, 0x14, 0x00, 0x13, 0x00,
  0x15, 0x00, 0x14, 0x00, 0x16, 0x00, 0x15, 0x00, 0x17, 0x00, 0x16, 0x00,
  0x18, 0x00, 0x16, 0x00, 0x18, 0x00, 0x15, 0x00, 0x15, 0x00, 0x13, 0x00,
  0x14, 0x00, 0x10, 0x00, 0x0f, 0x00, 0x0b, 0x00, 0x0b, 0x00, 0x06, 0x00,
  0x05, 0x00, 0x01, 0x00, 0x00, 0x00, 0xfb, 0xff, 0xfa, 0xff, 0xf3, 0xff,
  0xf3, 0xff, 0xed, 0xff, 0xec, 0xff, 0xe6, 0xff, 0xe5, 0xff, 0xe1, 0xff,
  0xe2, 0xff, 0xdd, 0xff, 0xde, 0xff, 0xdb, 0xff, 0xdd, 0xff, 0xda, 0xff,
  0xdd, 0xff, 0xda, 0xff, 0xe0, 0xff, 0xe0, 0xff, 0xe7, 0xff, 0xe7, 0xff,
  0xf0, 0xff, 0xf1, 0xff, 0xfb, 0xff, 0xfc, 0xff, 0x03, 0x00, 0x06, 0x00,
  0x0f, 0x00, 0x0f, 0x00, 0x16, 0x00, 0x18, 0x00, 0x20, 0x00, 0x1d, 0x00,
  0x22, 0x00, 0x1f, 0x00, 0x23, 0x00, 0x1f, 0x00, 0x20, 0x00, 0x1a, 0x00,
  0x1f, 0x00, 0x1a, 0x00, 0x1b, 0x00, 0x11, 0x00, 0x13, 0x00, 0x0e, 0x00,
  0x0d, 0x00, 0x04, 0x00, 0x04, 0x00, 0xfe, 0xff, 0x00, 0x00, 0xf6, 0xff,
  0xf6, 0xff, 0xeb, 0xff, 0xec, 0xff, 0xe5, 0xff, 0xe7, 0xff, 0xe2, 0xff,
  0xe7, 0xff, 0xe4, 0xff, 0xea, 0xff, 0xe8, 0xff, 0xf2, 0xff, 0xf0, 0xff,
  0xf8, 0xff, 0xf7, 0xff, 0x01, 0x00, 0x02, 0x00, 0x0b, 0x00, 0x0a, 0x00,
  0x12, 0x00, 0x0d, 0x00, 0x17, 0x00, 0x12, 0x00, 0x19, 0x00, 0x14, 0x00,
  0x18, 0x00, 0x13, 0x00, 0x1b, 0x00, 0x14, 0x00, 0x18, 0x00, 0x10, 0x00,
  0x12, 0x00, 0x0a, 0x00, 0x0b, 0x00, 0x03, 0x00, 0x03, 0x00, 0xff, 0xff,
  0xfe, 0xff, 0xf7, 0xff, 0xfc, 0xff, 0xf7, 0xff, 0xf8, 0xff, 0xf0, 0xff,
  0xf7, 0xff, 0xf2, 0xff, 0xf7, 0xff, 0xeb, 0xff, 0xf1, 0xff, 0xeb, 0xff,
  0xf5, 0xff, 0xf1, 0xff, 0xf5, 0xff, 0xed, 0xff, 0xf7, 0xff, 0xf3, 0xff,
  0xf6, 0xff, 0xe9, 0xff, 0xf0, 0xff, 0xec, 0xff, 0xf5, 0xff, 0xea, 0xff,
  0xf0, 0xff, 0xea, 0xff, 0xf4, 0xff, 0xe9, 0xff, 0xe7, 0xff, 0xdd, 0xff,
  0xe1, 0xff, 0xd9, 0xff, 0xdc, 0xff, 0xd4, 0xff, 0xd8, 0xff, 0xcf, 0xff,
  0xdd, 0xff, 0xd6, 0xff, 0xde, 0xff, 0xd5, 0xff, 0xe5, 0xff, 0xe6, 0xff,
  0xf5, 0xff, 0xf0, 0xff, 0x00, 0x00, 0x07, 0x00, 0x1a, 0x00, 0x15, 0x00,
  0x23, 0x00, 0x28, 0x00, 0x3e, 0x00, 0x3c, 0x00, 0x46, 0x00, 0x40, 0x00,
  0x48, 0x00, 0x44, 0x00, 0x48, 0x00, 0x3b, 0x00, 0x3c, 0x00, 0x2f, 0x00,
  0x33, 0x00, 0x22, 0x00, 0x21, 0x00, 0x0e, 0x00, 0x14, 0x00, 0x09, 0x00,
  0x10, 0x00, 0x04, 0x00, 0x05, 0x00, 0xf6, 0xff, 0xf7, 0xff, 0xe8, 0xff,
  0xf0, 0xff, 0xe7, 0xff, 0xf6, 0xff, 0xf3, 0xff, 0x04, 0x00, 0x05, 0x00,
  0x16, 0x00, 0x18, 0x00, 0x3d, 0x00, 0x47, 0x00, 0x60, 0x00, 0x6f, 0x00,
  0xc3, 0x00, 0x16, 0x01, 0x61, 0x01, 0x8f, 0x01, 0xca, 0x01, 0xe2, 0x01,
  0xe8, 0x01, 0xa6, 0x01, 0x85, 0x01, 0x52, 0x01, 0x15, 0x01, 0x8b, 0x00,
  0x09, 0x00, 0x94, 0xff, 0x4a, 0xff, 0xc0, 0xfe, 0x34, 0xfe, 0xb1, 0xfd,
  0x6b, 0xfd, 0x0d, 0xfd, 0xbb, 0xfc, 0x6c, 0xfc, 0x69, 0xfc, 0x64, 0xfc,
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
};
const unsigned int vocab_westbound_len = 34376;
