IowaScaledEngineering/ckt-defect/src/ckt-defect/io.h

/*************************************************************************
Title:    Input/Output Functions
Authors:  Michael Petersen <railfan@drgw.net>
File:     io.h
License:  GNU General Public License v3

LICENSE:
    Copyright (C) 2026 Michael Petersen & Nathan Holmes

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
*************************************************************************/

#pragma once

// Pins
#define SDA          GPIO_NUM_15
#define SCL          GPIO_NUM_16
#define I2S_SD       GPIO_NUM_7
#define I2S_DOUT     GPIO_NUM_17
#define I2S_BCLK     GPIO_NUM_18
#define I2S_LRCLK    GPIO_NUM_8
#define SDCLK        37
#define SDMOSI       38
#define SDMISO       36
#define SDCS         39
#define SDDET        GPIO_NUM_35

#define AXLE_A1      GPIO_NUM_10
#define AXLE_A1_EN   GPIO_NUM_3
#define AXLE_A2      GPIO_NUM_11
#define AXLE_A2_EN   GPIO_NUM_9
#define AXLE_B1      GPIO_NUM_13
#define AXLE_B1_EN   GPIO_NUM_33
#define AXLE_B2      GPIO_NUM_14
#define AXLE_B2_EN   GPIO_NUM_34
#define TRKA         GPIO_NUM_12
#define TRKB         GPIO_NUM_21

#define AUX          GPIO_NUM_1

#define TP0          GPIO_NUM_4
#define TP1          GPIO_NUM_5
#define TP2          GPIO_NUM_6
#define TP3          GPIO_NUM_40
#define TP4          GPIO_NUM_41
#define TP5          GPIO_NUM_42

void ioInit(void);

void enableAuxRelay(void);
void disableAuxRelay(void);

void ioProcessInputs(void);
bool getIrA(void);
bool getAxleA1(void);
bool getAxleA2(void);
bool getIrB(void);
bool getAxleB1(void);
bool getAxleB2(void);

void setTestPoint(gpio_num_t tp);
void clrTestPoint(gpio_num_t tp);
