IowaScaledEngineering/ckt-defect/src/ckt-defect/display-lcd.cpp

#include "display-lcd.h"

DisplayLcd::DisplayLcd(TwoWire &wirePort, uint8_t i2c_addr)
	: _i2cPort(&wirePort), 
	  _i2cAddr(i2c_addr),
	  _displayControl(LCD_DISPLAYON | LCD_CURSOROFF | LCD_BLINKOFF),
	  _displayMode(LCD_ENTRYLEFT | LCD_ENTRYSHIFTDECREMENT),
	  _lastButtonState(0), // Initialize all buttons as unpressed
	  _cursorX(0),
	  _cursorY(0),
	  _backlight(false),               // Defaults to off
	  _brightnessValue(128),          // Default mid brightness (0-255 range)
	  _hardwareBrightness(0)       // 128-157 range.  Out-of-bounds flag to guarantee initial sync
{
	// Initialize cache with spaces
	for (int r = 0; r < LCD_ROWS; ++r) {
		for (int c = 0; c < LCD_COLS; ++c) {
			_cache[r][c] = ' ';
		}
	}
	init();
}

DisplayLcd::~DisplayLcd()
{
	// No terminal states or settings to restore
}

void DisplayLcd::init(void)
{
	beginTransmission();
	transmit(SPECIAL_COMMAND);                      // Send special command character
	transmit(LCD_DISPLAYCONTROL | _displayControl); // Send the display command
	transmit(SPECIAL_COMMAND);                      // Send special command character
	transmit(LCD_ENTRYMODESET | _displayMode);      // Send the entry mode command
	transmit(SETTING_COMMAND);                      // Put LCD into setting mode
	transmit(CLEAR_COMMAND);                        // Send clear display command
	endTransmission();                              // Stop transmission
	delay(5);                                      // Let things settle

	// Push initial default brightness setup over I2C
	syncBacklightHardware();}

void DisplayLcd::beginTransmission(void)
{
	_i2cPort->beginTransmission(_i2cAddr);
}

void DisplayLcd::transmit(uint8_t data)
{
	_i2cPort->write(data);
}

void DisplayLcd::endTransmission(void)
{
	_i2cPort->endTransmission();
}

void DisplayLcd::command(uint8_t cmd)
{
	beginTransmission();
	transmit(SETTING_COMMAND); // Put LCD into setting mode
	transmit(cmd);             // Send the command code
	endTransmission();
}

void DisplayLcd::specialCommand(uint8_t cmd)
{
	beginTransmission();
	transmit(SPECIAL_COMMAND); // Send special command character
	transmit(cmd);             // Send the command code
	endTransmission();
}

void DisplayLcd::clear(void)
{
	// Force immediate physical clear
	command(CLEAR_COMMAND);
	delay(5); // Extra delay after a screen clear

	// Clear local cache and reset position tracking
	for (int r = 0; r < LCD_ROWS; ++r) {
		for (int c = 0; c < LCD_COLS; ++c) {
			_cache[r][c] = ' ';
		}
	}
	_cursorX = 0;
	_cursorY = 0;
}

void DisplayLcd::refresh(void)
{
	beginTransmission();
	endTransmission();

	// 1. Force rewrite the backlight / brightness configuration
	// Set to an impossible hardware domain value to guarantee the cache mismatch triggers
	_hardwareBrightness = 0; 
	syncBacklightHardware();

	// 2. Clear the physical screen hardware and reset hardware position
	command(CLEAR_COMMAND);
	delay(5); // Settle time for a screen clear

	// FIXME: refresh custom chars

	// 3. Loop through the entire local cache and dump it directly to hardware
	for (int r = 0; r < LCD_ROWS; ++r) {
		// Reposition the physical LCD cursor to the start of this row
		gotoxySendCmd(0, r);
		
		beginTransmission();
		for (int c = 0; c < LCD_COLS; ++c) {
			// Stream the cached characters line-by-line straight into the I2C transaction
			transmit(static_cast<uint8_t>(_cache[r][c]));
		}
		endTransmission();
	}

	// 4. Align internal tracking states back to the hardware home position
	_cursorX = 0;
	_cursorY = 0;
}

// Only updates the internal cache cursor positions
void DisplayLcd::gotoxy(int x, int y)
{
	// Keep variables within LCD matrix bounds
	if (x < 0) x = 0;
	if (x >= LCD_COLS) x = LCD_COLS - 1;
	if (y < 0) y = 0;
	if (y >= LCD_ROWS) y = LCD_ROWS - 1;

	_cursorX = x;
	_cursorY = y;
}

// Only sends the command to the physical LCD screen
void DisplayLcd::gotoxySendCmd(int x, int y)
{
	if (x < 0) x = 0;
	if (x >= LCD_COLS) x = LCD_COLS - 1;
	if (y < 0) y = 0;
	if (y >= LCD_ROWS) y = LCD_ROWS - 1;

	int row_offsets[] = {0x00, 0x40, 0x14, 0x54};
	specialCommand(LCD_SETDDRAMADDR | (x + row_offsets[y]));
}

void DisplayLcd::advanceCursor(void)
{
	_cursorX++;
	if (_cursorX >= LCD_COLS) {
		_cursorX = 0;
		_cursorY++;
		if (_cursorY >= LCD_ROWS) {
			_cursorY = 0; // Wrap around to the top left
		}
	}
}

void DisplayLcd::print(char c)
{
	// Check if the hardware character matches what we want to print
	if (_cache[_cursorY][_cursorX] != c) {
		_cache[_cursorY][_cursorX] = c;
		
		// Force physical hardware to align with current cache cursor tracking before writing
		gotoxySendCmd(_cursorX, _cursorY);
		
		beginTransmission();
		transmit(static_cast<uint8_t>(c));
		endTransmission();
	}
	
	// Advance position state regardless of whether we physical wrote it
	advanceCursor();
}

void DisplayLcd::print(const char *str)
{
	if (str == nullptr) return;

	bool inTransaction = false;

	while (*str) {
		char c = *str;

		if (_cache[_cursorY][_cursorX] != c) {
			// Found a mismatch! If we aren't transmitting yet, position the hardware and start
			if (!inTransaction) {
				// Hardware relocation
				gotoxySendCmd(_cursorX, _cursorY);
				beginTransmission();
				inTransaction = true;
			}

			// Update the cache matrix and write the character into the active I2C packet
			_cache[_cursorY][_cursorX] = c;
			transmit(static_cast<uint8_t>(c));
		} 
		else {
			// This character already matches the cache. 
			// If we were actively streaming a mismatched block, send it over I2C now before we skip ahead.
			if (inTransaction) {
				endTransmission();
				inTransaction = false;
			}
		}
		
		// Internal cursor state must advance in tandem with the processed string element
		advanceCursor();
		str++;
	}

	// Clean up any remaining buffered mismatch data at the end of the string loop
	if (inTransaction) {
		endTransmission();
	}
}

void DisplayLcd::print(const std::string &str)
{
	print(str.c_str());
}

void DisplayLcd::createCustomChar(uint8_t location, const uint8_t* charmap)
{
	// FIXME: save custom characters in memory so they can be refreshed
	location &= 0x07; // OpenLCD has 8 slots available: 0-7
	
	beginTransmission();
	transmit(SETTING_COMMAND);   // Put LCD into setting mode
	transmit(27 + location);     // OpenLCD command range for custom chars is 27-34
	
	for (int i = 0; i < 8; i++) {
		transmit(charmap[i]);
	}
	
	endTransmission();
}

bool DisplayLcd::getEvent(DisplayEvent *event)
{
	if (eventQueue.isEmpty())
		return false;
		
	auto e = eventQueue.pop();
	if (!e.has_value())
		return false;
		
	*event = *e;
	return true;
}

void DisplayLcd::backlightOn(void)
{
	if (!_backlight) {
		_backlight = true;
		syncBacklightHardware();
	}
}

void DisplayLcd::backlightOff(void)
{
	if (_backlight) {
		_backlight = false;
		syncBacklightHardware();
	}
}

bool DisplayLcd::getBacklight(void) const
{
	return _backlight;
}

void DisplayLcd::setBrightness(uint8_t value)
{
	if (_brightnessValue != value) {
		_brightnessValue = value;
		syncBacklightHardware();
	}
}

uint8_t DisplayLcd::getBrightness(void) const
{
	return _brightnessValue;
}

// Caching helper logic for OpenLCD backlighting commands
void DisplayLcd::syncBacklightHardware(void)
{
	uint8_t targetPhysicalBrightness = 128; // OpenLCD backlight command address (128-157 range)

	if (_backlight) {
		// Fast 8-bit AVR approximation for (brightness * 29) / 255.
		// Maximum divergence from true division across 0-255 range is 0.11,
		// which safely truncates to the exact same integer.
		uint16_t intermediate = static_cast<uint16_t>(_brightnessValue);
		
		// intermediate * 29 -> (b * 16) + (b * 8) + (b * 4) + b
		intermediate = (intermediate << 4) + (intermediate << 3) + (intermediate << 2) + intermediate; //

		// Add half of 256 divisor to ensure clean round-to-nearest mapping
		intermediate += 128;
		
		// Extract high byte directly to handle zero-overhead register evaluation
		targetPhysicalBrightness += static_cast<uint8_t>(intermediate >> 8); //
	}

	// Safely checks physical domain registers (128 - 157) against cached properties
	if (_hardwareBrightness != targetPhysicalBrightness) {
		beginTransmission();
		transmit(SETTING_COMMAND); // Set backlight amount
		transmit(targetPhysicalBrightness);
		endTransmission();

		_hardwareBrightness = targetPhysicalBrightness; // Caches the active physical register state
	}
}

bool DisplayLcd::readKeys(void)
{
	// Request 1 byte of data containing button states from the LCD module
	if (_i2cPort->requestFrom(_i2cAddr, static_cast<uint8_t>(1)) == 1)
	{
		uint8_t currentButtonState = _i2cPort->read();
		
		// XOR reveals which bits transitioned state since our last check
		uint8_t changed = currentButtonState ^ _lastButtonState;

		if (changed)
		{
			for (int i = 0; i < 4; ++i)
			{
				// 1. Process standard lower nibble transitions (Key Down / Key Up)
				if (changed & (1 << i))
				{
					int eventNum = i + 1; // Map bit index (0-3) to button ID (1-4)
					
					// Determine whether it was a press (bit high) or release (bit low)
					DisplayEventType type = (currentButtonState & (1 << i)) 
						? DisplayEventType::KEY_PRESS 
						: DisplayEventType::KEY_RELEASE;

					DisplayEvent newEvent = {type, eventNum};
					eventQueue.push(newEvent); // Attempts to push event onto the circular buffer
				}

				// 2. Process upper nibble transitions (Key Long)
				// Check if the long press bit changed, and transitioned to HIGH
				if ((changed & (1 << (i + 4))) && (currentButtonState & (1 << (i + 4))))
				{
					// Only process if the corresponding lower nibble bit is also active (pressed)
					if (currentButtonState & (1 << i))
					{
						int eventNum = i + 1;
						DisplayEvent newEvent = {DisplayEventType::KEY_LONG, eventNum};
						eventQueue.push(newEvent);
					}
				}
			}
			// Update our saved register for the next cycle
			_lastButtonState = currentButtonState;
		}

		return true; // I2C request was successful (ACK'd)
	}

	return false; // I2C request failed (NACK'd)
}
