IowaScaledEngineering/ckt-defect/src/ckt-defect/axle.cpp

/*************************************************************************
Title:    Axle Counter Functions
Authors:  Michael Petersen <railfan@drgw.net>
File:     axle.cpp
License:  GNU General Public License v3

LICENSE:
    Copyright (C) 2026 Michael Petersen & Nathan Holmes

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
*************************************************************************/

#include <Arduino.h>

#include "common.h"
#include "io.h"
#include "axle.h"

static volatile uint32_t axleCount[NUM_TRACKS];
static volatile unsigned long firstAxleTime[NUM_TRACKS];
static volatile unsigned long currentAxleTime[NUM_TRACKS];
static volatile unsigned long entranceDeltaMicros[NUM_TRACKS];
static volatile unsigned long exitDeltaMicros[NUM_TRACKS];
static volatile uint8_t direction[NUM_TRACKS];  // 1 = 1->2, 2 = 2->1, 0 (or anything else) = unknown
static volatile uint32_t minAxleTimeMicroseconds = 5000;

enum class AxleIsrState
{
	IDLE,
	SPEED_1,
	COUNT_1,
	SPEED_2,
	COUNT_2,
};

volatile AxleIsrState axleIsrState[NUM_TRACKS] = { AxleIsrState::IDLE, AxleIsrState::IDLE };

/*
   ISR Notes:

   Capture time first thing to avoid jitter from the state machine.

   Exit time can give weird intermediate results, if the truck wheelbase is
      shorter than the sensor distance.  But, in the end, it will always
      give the delta of the last wheel (assuming no backup moves, in which
      case it's screwed up anyway).
   
   The state machines will always end up stuck in either the COUNT_1 or
      COUNT_2 states.  axleReset() should be called to clean up once
      timeout is detected in the main loop and the information is read.
*/

void IRAM_ATTR axle_A1_isr(void *arg)
{
	unsigned long time = micros();
	switch(axleIsrState[0])
	{
		case AxleIsrState::IDLE:
			axleCount[0] = axleCount[0] + 1;
			firstAxleTime[0] = time;
			currentAxleTime[0] = time;
			direction[0] = 1;
			axleIsrState[0] = AxleIsrState::SPEED_1;
			break;
		#pragma GCC diagnostic push
		#pragma GCC diagnostic ignored "-Wimplicit-fallthrough"
		case AxleIsrState::SPEED_1:
		case AxleIsrState::COUNT_1:
		#pragma GCC diagnostic pop
			if((time-currentAxleTime[0]) > minAxleTimeMicroseconds)
			{
				axleCount[0] = axleCount[0] + 1;
				currentAxleTime[0] = time;
			}
			break;
		case AxleIsrState::SPEED_2:
			entranceDeltaMicros[0] = time - firstAxleTime[0];
			axleIsrState[0] = AxleIsrState::COUNT_2;
			break;
		case AxleIsrState::COUNT_2:
			exitDeltaMicros[0] = time - currentAxleTime[0];
			break;
		default:
			axleIsrState[0] = AxleIsrState::IDLE;
	}
}

void IRAM_ATTR axle_A2_isr(void *arg)
{
	unsigned long time = micros();
	switch(axleIsrState[0])
	{
		case AxleIsrState::IDLE:
			axleCount[0] = axleCount[0] + 1;
			firstAxleTime[0] = time;
			currentAxleTime[0] = time;
			direction[0] = 2;
			axleIsrState[0] = AxleIsrState::SPEED_2;
			break;
		#pragma GCC diagnostic push
		#pragma GCC diagnostic ignored "-Wimplicit-fallthrough"
		case AxleIsrState::SPEED_2:
		case AxleIsrState::COUNT_2:
		#pragma GCC diagnostic pop
			if((time-currentAxleTime[0]) > minAxleTimeMicroseconds)
			{
				axleCount[0] = axleCount[0] + 1;
				currentAxleTime[0] = time;
			}
			break;
		case AxleIsrState::SPEED_1:
			entranceDeltaMicros[0] = time - firstAxleTime[0];
			axleIsrState[0] = AxleIsrState::COUNT_1;
			break;
		case AxleIsrState::COUNT_1:
			exitDeltaMicros[0] = time - currentAxleTime[0];
			break;
		default:
			axleIsrState[0] = AxleIsrState::IDLE;
	}
}

void IRAM_ATTR axle_B1_isr(void *arg)
{
	unsigned long time = micros();
	switch(axleIsrState[1])
	{
		case AxleIsrState::IDLE:
			axleCount[1] = axleCount[1] + 1;
			firstAxleTime[1] = time;
			currentAxleTime[1] = time;
			direction[1] = 1;
			axleIsrState[1] = AxleIsrState::SPEED_1;
			break;
		#pragma GCC diagnostic push
		#pragma GCC diagnostic ignored "-Wimplicit-fallthrough"
		case AxleIsrState::SPEED_1:
		case AxleIsrState::COUNT_1:
		#pragma GCC diagnostic pop
			if((time-currentAxleTime[1]) > minAxleTimeMicroseconds)
			{
				axleCount[1] = axleCount[1] + 1;
				currentAxleTime[1] = time;
			}
			break;
		case AxleIsrState::SPEED_2:
			entranceDeltaMicros[1] = time - firstAxleTime[1];
			axleIsrState[1] = AxleIsrState::COUNT_2;
			break;
		case AxleIsrState::COUNT_2:
			exitDeltaMicros[1] = time - currentAxleTime[1];
			break;
		default:
			axleIsrState[1] = AxleIsrState::IDLE;
	}
}

void IRAM_ATTR axle_B2_isr(void *arg)
{
	unsigned long time = micros();
	switch(axleIsrState[1])
	{
		case AxleIsrState::IDLE:
			axleCount[1] = axleCount[1] + 1;
			firstAxleTime[1] = time;
			currentAxleTime[1] = time;
			direction[1] = 2;
			axleIsrState[1] = AxleIsrState::SPEED_2;
			break;
		#pragma GCC diagnostic push
		#pragma GCC diagnostic ignored "-Wimplicit-fallthrough"
		case AxleIsrState::SPEED_2:
		case AxleIsrState::COUNT_2:
		#pragma GCC diagnostic pop
			if((time-currentAxleTime[1]) > minAxleTimeMicroseconds)
			{
				axleCount[1] = axleCount[1] + 1;
				currentAxleTime[1] = time;
			}
			break;
		case AxleIsrState::SPEED_1:
			entranceDeltaMicros[1] = time - firstAxleTime[1];
			axleIsrState[1] = AxleIsrState::COUNT_1;
			break;
		case AxleIsrState::COUNT_1:
			exitDeltaMicros[1] = time - currentAxleTime[1];
			break;
		default:
			axleIsrState[1] = AxleIsrState::IDLE;
	}
}

void axleInit()
{
	for (uint32_t i = 0; i < NUM_TRACKS; i++)
	{
		axleReset(i);
	}

	gpio_install_isr_service(0);
	gpio_isr_handler_add(AXLE_A1, axle_A1_isr, NULL);
	gpio_isr_handler_add(AXLE_A2, axle_A2_isr, NULL);
	gpio_isr_handler_add(AXLE_B1, axle_B1_isr, NULL);
	gpio_isr_handler_add(AXLE_B2, axle_B2_isr, NULL);
}

void axleSetMinAxleTime(uint32_t timeMicroseconds)
{
	minAxleTimeMicroseconds = timeMicroseconds;
}

uint32_t axleGetCount(uint32_t track)
{
	return axleCount[track];
}

// micros() returns an unsigned long
// On ESP32, unsigned long = uint32_t so these returns will be atomic
unsigned long axleGetEntranceDeltaMicros(uint32_t track)
{
	return entranceDeltaMicros[track];
}

unsigned long axleGetExitDeltaMicros(uint32_t track)
{
	return exitDeltaMicros[track];
}

unsigned long axleGetLatestAxleTime(uint32_t track)
{
	return currentAxleTime[track];
}

uint8_t axleGetDirection(uint32_t track)
{
	return direction[track];
}

void axleReset(uint32_t track)
{
	axleCount[track] = 0;
	firstAxleTime[track] = 0;
	currentAxleTime[track] = 0;
	entranceDeltaMicros[track] = 0;
	exitDeltaMicros[track] = 0;
	direction[track] = 0;
	axleIsrState[track] = AxleIsrState::IDLE;
}

void axleTerminate(void)
{
	gpio_isr_handler_remove(AXLE_A1);
	gpio_isr_handler_remove(AXLE_A2);
	gpio_isr_handler_remove(AXLE_B1);
	gpio_isr_handler_remove(AXLE_B2);
	gpio_uninstall_isr_service();
}
