IowaScaledEngineering/ckt-defect/src/ckt-defect/messages.h

/*************************************************************************
Title:    Defect Message Functions
Authors:  Michael Petersen <railfan@drgw.net>
File:     messages.h
License:  GNU General Public License v3

LICENSE:
    Copyright (C) 2026 Michael Petersen & Nathan Holmes

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
*************************************************************************/

#pragma once

#include <vector>
#include <string>

#include "configuration.h"
#include "data.h"

struct DefectMessage {
	std::string alertMsg;    // Played instantly when defect detected (e.g. words, silence, or tone)
	std::string displayMsg;  // Displayed on screen when defect detected (20 chars x 3 lines max)
	std::string detailMsg;   // Played in exit message after defect(s) detected 
	uint32_t axleRate;       // Number of axles on average for this defect
};

struct MessageBundle {
	std::string entranceMsg;                       // Triggered when train first detected
	std::vector<DefectMessage> defects;
	std::string exitCleanMsg;                      // Plays after train passes and no defect detected
	std::string exitCleanDisplayMsg;               // 
	std::string exitDefectMsg;                     // Plays after train passes and defect(s) detected
	std::string exitDefectDisplayMsg;              // 
	std::string integrityMsg;                      // Simulates a detector failure
	std::string integrityDisplayMsg;               // 
	uint32_t integrityTrainRate;                   // Number of trains on average for this defect
	std::string minAxleMsg;                        // If not enough axles are counted before timeout (default = integrity)
	std::string minAxleDisplayMsg;                 // 
	std::string tooSlowMsg;                        // If speed enabled, plays when speed is below programmed threshold
	std::string tooSlowDisplayMsg;                 // 
	std::string detectorBlockedMsg;                // If axle stops in front of detector for longer than timeout
	std::string detectorBlockedDisplayMsg;         // 
	std::string excessAlarmsMsg;
};

void printMessages(MessageBundle* msgs);
void insertNumber(std::string& str, int32_t num, uint32_t integerDigits, uint32_t fractionalDigits, bool breakDigits);
void transformMessage(const std::string& inputMessage, std::string& outputMessage, const DetectorConfiguration& cfg, const DataBundle& data, uint8_t trackNum, bool breakDigits);
void updateMessages(MessageBundle& trackMessages, const DetectorConfiguration& cfg);
void setDefaultMessages(MessageBundle& trackMessages, const DetectorConfiguration& cfg);
std::vector<std::string> getUniqueWords(const MessageBundle& msgs);
