IowaScaledEngineering/ckt-defect/src/ckt-defect/common.cpp

/*************************************************************************
Title:    Common Definitions and Functions
Authors:  Michael Petersen <railfan@drgw.net>
File:     common.cpp
License:  GNU General Public License v3

LICENSE:
    Copyright (C) 2026 Michael Petersen & Nathan Holmes

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
*************************************************************************/

#include <Arduino.h>
#include <string>
#include <algorithm> // Required for std::transform
#include <cctype>    // Required for std::tolower
#include <format>
#include <nvs.h>
#include <nvs_flash.h>
#include "bootloader_random.h"

#include "common.h"

const std::vector<std::string> trackNames = {
	"Track 1",
	"Track 2",
	"Main 1",
	"Main 2",
	"North Track",
	"South Track",
	"East Track",
	"West Track",
};

const std::vector<std::string> directionNames = {
	"Eastbound",
	"Westbound",
	"Northbound",
	"Southbound",
	"East",
	"West",
	"North",
	"South",
};

const std::vector<std::string> railNames = {
	"Left/Right",
	"East/West",
	"North/South",
};

const std::vector<std::string> ordinalTypes = {   // Corresponds with oridinal string
	"None",
	"1st",
	"1st Alarm",
	"1st Defect",
	"Alarm 1",
	"Defect 1",
};

const std::vector<std::string> ordinalStrings = {   // Corresponds with oridinal type
	"",
	"#ord",
	"#ord alarm",
	"#ord defect",
	"alarm #count",
	"defect #count",
};



void printMemoryUsage(void)
{
	Serial.printf(
		"\n[SYS]: free stack(min): %lu bytes | free heap(min): %lu bytes | used heap(cur): %lu bytes\n\n", 
		(unsigned long)(uxTaskGetStackHighWaterMark(NULL) * 4), 
		(unsigned long)xPortGetMinimumEverFreeHeapSize(), 
		(unsigned long)(ESP.getHeapSize() - ESP.getFreeHeap())
	);
}

void printNVSStats(void)
{
	nvs_stats_t nvs_stats;
	
	// Get stats for the default "nvs" partition
	esp_err_t err = nvs_get_stats(NULL, &nvs_stats);
	
	if (err == ESP_OK)
	{
		Serial.println("--- NVS Preferences Stats ---");
		Serial.print("Used Entries: ");
		Serial.println(nvs_stats.used_entries);
		Serial.print("Free Entries: ");
		Serial.println(nvs_stats.free_entries);
		Serial.print("Total Entries: ");
		Serial.println(nvs_stats.total_entries);
		Serial.print('\n');
	}
	else
	{
		Serial.println("Failed to get NVS stats");
	}
}

void toLowercase(std::string& str)
{
	std::transform(str.begin(), str.end(), str.begin(),
		[](unsigned char c){ return std::tolower(c); }
	);
}

std::string centerString(const std::string& text, int width)
{
	if (text.length() >= width)
	{
		return text; // Return original text if it's already wider than the frame
	}

	size_t total_padding = width - text.length();
	size_t left_padding = total_padding / 2;
	size_t right_padding = total_padding - left_padding;

	// Construct the centered string: [left spaces] + [text] + [right spaces]
	return std::string(left_padding, ' ') + text + std::string(right_padding, ' ');
}

std::string intToString(int32_t intVal, uint32_t integerDigits, uint32_t fractionalDigits)
{
	// Track if the original value was negative
	bool isNegative = (intVal < 0);
	
	// Convert to absolute value for string processing
	uint32_t absVal = isNegative ? static_cast<uint32_t>(-intVal) : static_cast<uint32_t>(intVal);

	// Convert the raw absolute integer to its base string representation
	std::string numStr = std::to_string(absVal);
	std::string formatted;

	// Handle leading zero if fractionalDigits is greater than or equal to the total digits
	if (fractionalDigits >= numStr.length()) {
		size_t leadingZeros = fractionalDigits - numStr.length() + 1; // +1 for the single leading '0' before '.'
		formatted.append(leadingZeros, '0');
		formatted.insert(1, 1, '.'); // Insert decimal after the first '0'
		formatted.append(numStr);
	} 
	// Normal case: Precision fits inside the number length
	else {
		formatted = numStr;
		if (fractionalDigits > 0) {
			// Insert '.' 'fractionalDigits' places from the end
			formatted.insert(formatted.length() - fractionalDigits, 1, '.');
		}
	}

	// Prepend the negative sign if applicable before evaluating integer width
	if (isNegative) {
		formatted.insert(0, 1, '-');
	}

	// Calculate the length of the integer portion currently in the string (including the sign)
	size_t currentIntLength = formatted.find('.');
	if (currentIntLength == std::string::npos) {
		currentIntLength = formatted.length();
	}

	// Pad with spaces to satisfy the integerDigits layout requirement
	if (currentIntLength < integerDigits) {
		formatted.insert(0, integerDigits - currentIntLength, ' ');
	}

	return formatted;
}


std::string getOrdinalWord(const uint8_t& num)
{
	if (1 == num) return "first";
	if (2 == num) return "second";
	if (3 == num) return "third";
	if (4 == num) return "fourth";
	if (5 == num) return "fifth";
	if (6 == num) return "sixth";
	if (7 == num) return "seventh";
	if (8 == num) return "eighth";
	if (9 == num) return "ninth";
	else return "";
}


uint32_t rollDice(void)
{
	bootloader_random_enable();
	uint32_t raw = esp_random();
	bootloader_random_disable();
	uint32_t dice = raw % (PROBABILITY_MAX);
	Serial.print("Dice: ");
	Serial.println(dice);
	return dice;
}
