IowaScaledEngineering/ckt-defect/src/ckt-defect/sound.cpp

/*************************************************************************
Title:    Sound Functions
Authors:  Michael Petersen <railfan@drgw.net>
File:     sound.cpp
License:  GNU General Public License v3

LICENSE:
    Copyright (C) 2026 Michael Petersen

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
*************************************************************************/

#include <cstring>
#include "sound.h"

int16_t sineWave[8] = {0, 12539, 23170, 30273, 32767, 30273, 23170, 12539};

Sound::~Sound()
{
}

void Sound::open(void)
{
}

int16_t Sound::getNextSample(void)
{
	return 0;
}

void Sound::close(void)
{
}

size_t Sound::available(void)
{
	if(dataSize > byteCount)
		return(dataSize - byteCount);
	else
		return 0;
}

uint32_t Sound::getSampleRate(void)
{
	return sampleRate;
}

std::string Sound::getName(void) const
{
	return soundName;
}



SdSound::SdSound(const std::string& fname, size_t numBytes, size_t offset, uint16_t sr, DWORD cluster)
{
	fileName = fname;
	
	// Extract just the basename for soundName
	soundName = fname;
	size_t lastSlash = soundName.find_last_of("/\\");
	if (lastSlash != std::string::npos)
	{
		soundName = soundName.substr(lastSlash + 1);
	}
	size_t dotPos = soundName.find('.');
	if (dotPos != std::string::npos)
	{
		soundName.erase(dotPos);
	}

	dataOffset = offset;
	dataSize = numBytes;
	sampleRate = sr;
	startCluster = cluster;
}

SdSound::~SdSound()
{
}

void SdSound::open(void)
{
	if (startCluster != 0)
	{
		FATFS *fs = NULL;
		DWORD fre_clust;

		// Get the FATFS handle for volume "0:" directly from FatFs
		if (f_getfree("0:", &fre_clust, &fs) == FR_OK && fs != NULL)
		{
			// Populate wavFile directly without directory traversal
			memset(&wavFile, 0, sizeof(FIL));
			wavFile.obj.fs = fs;
			wavFile.obj.id = fs->id;
			wavFile.obj.sclust = startCluster;
			wavFile.obj.objsize = dataSize + dataOffset;
			wavFile.flag = FA_READ;

			// Fast-seek straight to the PCM payload offset
			f_lseek(&wavFile, dataOffset);
		}
		else
		{
			// Fallback if filesystem handle query fails
			if (f_open(&wavFile, fileName.c_str(), FA_READ) == FR_OK)
			{
				f_lseek(&wavFile, dataOffset);
			}
		}
	}
	else
	{
		// Fallback for files without a cached start cluster
		if (f_open(&wavFile, fileName.c_str(), FA_READ) == FR_OK)
		{
			f_lseek(&wavFile, dataOffset);
		}
	}

	byteCount = 0;
	fileBufferLength = 0;
	fileBufferPosition = 0;
}

size_t SdSound::fileBufferAvailable(void)
{
	if(fileBufferLength > fileBufferPosition)
		return(fileBufferLength - fileBufferPosition);
	else
		return 0;
}

int16_t SdSound::getNextSample(void)
{
	size_t bytesToRead;
	UINT bytesRead = 0;

	if( (fileBufferAvailable() < 2) && available() )
	{
		// We're out of bytes (or had an odd number for some strange reason)
		// and there's more of the file to grab, so grab it
		if(available() < FILE_BUFFER_SIZE)
		{
			bytesToRead = available();
		}
		else
		{
			bytesToRead = FILE_BUFFER_SIZE;
		}

		if (f_read(&wavFile, fileBuffer, bytesToRead, &bytesRead) == FR_OK)
		{
			fileBufferLength = bytesRead;
		}
		else
		{
			fileBufferLength = 0;
		}
		fileBufferPosition = 0;
	}

	if(fileBufferAvailable() >= 2)
	{
		// We have at least 2 bytes in the local buffer
		sampleValue = *((int16_t *)(fileBuffer+fileBufferPosition));
		fileBufferPosition += 2;
		byteCount += 2;
		return sampleValue;
	}
	else
	{
		// We got called even though there was nothing to send
		return 0;
	}
}

void SdSound::close(void)
{
	f_close(&wavFile);
}






MemSound::MemSound(const std::string& name, const uint8_t *sound, size_t numBytes, uint16_t sr)
{
	soundName = name;
	dataPtr = sound;
	dataSize = numBytes;
	sampleRate = sr;
}
MemSound::~MemSound()
{
	// No need to free dataPtr since it points to const data
}
void MemSound::open(void)
{
//	Serial.print("OpenMem: ");
//	Serial.println(soundName.c_str());
	byteCount = 0;
}
int16_t MemSound::getNextSample(void)
{
	if(available() >= 2)
	{
		sampleValue = *((int16_t *)(dataPtr+byteCount));
		byteCount += 2;
		return sampleValue;
	}
	else
	{
		return 0;
	}
}
void MemSound::close(void)
{
	return;
}






ToneSound::ToneSound(size_t samples, uint16_t sr, uint8_t a)
{
	soundName = "tone";
	dataSize = samples * 2;
	sampleRate = sr;
	attenuation = a;
}
ToneSound::~ToneSound()
{
	// Do nothing
}
void ToneSound::open(void)
{
	byteCount = 0;
	invert = false;
}
int16_t ToneSound::getNextSample(void)
{
	if(available() >= 2)
	{
		sampleValue = ((invert ? -1 : 1) * sineWave[(byteCount/2) % 8]) >> attenuation;
		if(7 == ((byteCount/2) % 8))
			invert = !invert;
		byteCount += 2;
		return sampleValue;
	}
	else
	{
		return 0;
	}
}
void ToneSound::close(void)
{
	delete this;  // Danger, danger, danger!
	return;
}






SilenceSound::SilenceSound(size_t samples, uint16_t sr)
{
	soundName = "tone";
	dataSize = samples * 2;
	sampleRate = sr;
}
SilenceSound::~SilenceSound()
{
	// Do nothing
}
void SilenceSound::open(void)
{
	byteCount = 0;
}
int16_t SilenceSound::getNextSample(void)
{
	if(available() >= 2)
	{
		byteCount += 2;
	}
	return 0;
}
void SilenceSound::close(void)
{
	delete this;  // Danger, danger, danger!
	return;
}
