IowaScaledEngineering/ckt-defect/src/ckt-defect/sound.h

/*************************************************************************
Title:    Sound Functions
Authors:  Michael Petersen <railfan@drgw.net>
File:     sound.h
License:  GNU General Public License v3

LICENSE:
    Copyright (C) 2026 Michael Petersen

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
*************************************************************************/

#pragma once

#include "ff.h"
#include <string>

#define FILE_BUFFER_SIZE 2048

class Sound
{
	protected:
		size_t dataSize;
		size_t byteCount;
		uint32_t sampleRate;
		std::string soundName;

	public:
		virtual ~Sound();
		virtual void open(void);
		virtual int16_t getNextSample(void);
		virtual void close(void);
		size_t available(void);
		uint32_t getSampleRate(void);
		std::string getName(void) const;
};

class SdSound : public Sound
{
	std::string fileName;
	size_t dataOffset;
	FIL wavFile;
	DWORD startCluster;
	uint8_t fileBuffer[FILE_BUFFER_SIZE];
	size_t fileBufferLength;  // might be less than actual buffer size
	size_t fileBufferPosition;
	int16_t sampleValue;

	public:
		SdSound(const std::string& fname, size_t numBytes, size_t offset, uint16_t sr, DWORD cluster = 0);
		~SdSound();
		void open(void);
		size_t fileBufferAvailable(void);
		int16_t getNextSample(void);
		void close(void);
};

class MemSound : public Sound
{
	const uint8_t *dataPtr;
	uint8_t soundNum;
	int16_t sampleValue;

	public:
		MemSound(const std::string& name, const uint8_t *sound, size_t numBytes, uint16_t sr);
		~MemSound();
		void open(void);
		int16_t getNextSample(void);
		void close(void);
};

class ToneSound : public Sound
{
	int16_t sampleValue;
	bool invert;
	uint8_t attenuation;

	public:
		ToneSound(size_t samples, uint16_t sr, uint8_t attenuation);
		~ToneSound();
		void open(void);
		int16_t getNextSample(void);
		void close(void);
};

class SilenceSound : public Sound
{
	int16_t sampleValue;

	public:
		SilenceSound(size_t samples, uint16_t sr);
		~SilenceSound();
		void open(void);
		int16_t getNextSample(void);
		void close(void);
};
