IowaScaledEngineering/ckt-defect/src/ckt-defect/display-lcd.h

#pragma once
#include "src/menu/display.h"
#include <Wire.h>
#include <string>

// Core OpenLCD Constants
#define LCD_DEFAULT_ADDRESS 0x72
#define SPECIAL_COMMAND     254
#define SETTING_COMMAND     0x7C
#define CLEAR_COMMAND       0x2D
#define LCD_SETDDRAMADDR    0x80
#define LCD_DISPLAYCONTROL  0x08
#define LCD_ENTRYMODESET    0x04

// Flags for display on/off control
#define LCD_DISPLAYON       0x04
#define LCD_CURSOROFF       0x00
#define LCD_BLINKOFF        0x00

// Flags for display entry mode
#define LCD_ENTRYLEFT           0x02
#define LCD_ENTRYSHIFTDECREMENT 0x00

// LCD Matrix Dimensions
#define LCD_COLS            20
#define LCD_ROWS            4

class DisplayLcd : public Display
{
	public:
		DisplayLcd(TwoWire &wirePort = Wire, uint8_t i2c_addr = LCD_DEFAULT_ADDRESS);
		~DisplayLcd();

		// Display interface implementations
		void clear(void) override;
		void refresh(void);
		void gotoxy(int x, int y) override;
		void print(char c) override;
		void print(const char *str) override;
		void print(const std::string &str) override;
		
		// Custom Character Generation
		void createCustomChar(uint8_t location, const uint8_t* charmap) override;
		
		// Event Handling implementations
		bool getEvent(DisplayEvent *event) override;
		bool readKeys(void);

		// Backlight interface implementations
		void backlightOn(void) override;
		void backlightOff(void) override;
		bool getBacklight(void) const override;

		// Brightness configurations
		void setBrightness(uint8_t value);
		uint8_t getBrightness(void) const;

	private:
		TwoWire *_i2cPort;
		uint8_t _i2cAddr;
		uint8_t _displayControl;
		uint8_t _displayMode;

		// Input polling states
		DisplayEventQueue<DisplayEvent, 10> eventQueue;
		uint8_t _lastButtonState;

		// Internal Cache and Cursor tracking
		char _cache[LCD_ROWS][LCD_COLS];
		int _cursorX;
		int _cursorY;

		// Backlight tracking and caching states
		bool _backlight;
		uint8_t _brightnessValue;       // User-facing brightness (0-255 domain)
		uint8_t _hardwareBrightness;    // Actual mapped value sent via I2C (128-157 domain)

		// Internal I2C utility methods
		void init(void);
		void beginTransmission(void);
		void transmit(uint8_t data);
		void endTransmission(void);
		void command(uint8_t cmd);
		void specialCommand(uint8_t cmd);
		
		// Hardware helper to write properties to I2C if conditions change
		void syncBacklightHardware(void);

		// Hardware positioning helper
		void gotoxySendCmd(int x, int y);
		// Helper to automatically advance cursor bounds
		void advanceCursor(void);
};
