IowaScaledEngineering/ckt-defect/(commit log)

2025-06-30 Sent to fab
    [snd-defect-NPTH.drl, snd-defect.drl, snd-defect.gbl, snd-defect.gbo, snd-defect.gbp, snd-defect.gbr, snd-defect.gbs, snd-defect.gm1]
2025-12-28 Renamed to ckt-defect
    [ckt-defect.kicad_pcb, ckt-defect.kicad_sch]
2025-12-28 Copied latest code from snd-player
    [partitions.csv]
2025-12-29 Task based audio feeder
    [partitions.csv]
2026-02-12 Kicad 9 conversion; added test points
    [ckt-defect.kicad_pcb, ckt-defect.kicad_sch]
2026-03-07 Some rip-up and refactoring, with a dash of architecture
    [configuration.h]
2026-03-08 More progress
    [configuration.h]
2026-03-08 Some changes
    [configuration.h]
2026-03-08 First cut at internal vocab
2026-03-13 Some documents
    [speed.ods]
2026-03-15 Initial axle simulator
2026-03-15 Working axle simulator
2026-03-15 Axle calculator
    [axle-calculations.ods]
2026-03-15 Changed axle counters to use 3.3V supply
    [ckt-defect.kicad_pcb, ckt-defect.kicad_sch]
2026-03-15 Updated date
    [ckt-defect.kicad_pcb]
2026-03-15 Moved axles simulator over to ckt-axle project
2026-03-15 Aux relay support
2026-03-16 Changed edge cleanance
    [ckt-defect.kicad_pcb]
2026-03-16 Adjusted the 5V bus at the bottom
    [ckt-defect.kicad_pcb]
2026-03-16 Initial axle counter interrupts
2026-03-18 Added input schmitt inverters
    [ckt-defect.kicad_pcb, ckt-defect.kicad_sch]
2026-03-18 Moved logo
    [ckt-defect.kicad_pcb]
2026-03-19 Improved buffering
    [ckt-defect.kicad_pcb, ckt-defect.kicad_sch]
2026-03-19 PG 1.1
    [ckt-defect-NPTH.drl, ckt-defect.drl, ckt-defect.gbl, ckt-defect.gbo, ckt-defect.gbp, ckt-defect.gbr, ckt-defect.gbs, ckt-defect.gm1]
2026-03-21 Added PTT support to the audio driver
2026-03-21 Refactored axle counter code
2026-03-22 Changed to Kicad footprint for QFN
    [ckt-defect.kicad_pcb, ckt-defect.kicad_sch]
2026-04-14 Axle counter code fixed
    [ckt-defect.ino, io.cpp, io.h]
2026-05-23 Removed brackets from MenuNumberDial
2026-05-23 Fixed brightness value when writing I2C
    [display-lcd.cpp]
2026-05-23 Fixed hardware vs software brightness levels
    [display-lcd.cpp, display-lcd.h, display.h, menu-custom.h]
2026-05-23 Swapped +/- button on NumberDial
    [menu.cpp]
2026-05-24 Added LCD brightness handling
    [configuration.h]
2026-05-27 Added speed and axle variables
    [configuration.h]
2026-06-12 Reduced to one set of track messages
2026-06-12 Added track name string
    [configuration.h]
2026-06-12 Added track name selection
2026-06-12 Refactored track name visibility code
2026-06-12 Added milepost menu and supporting code
    [configuration.h]
2026-06-18 Changed backlight button text
2026-06-18 Added axle menu and basic speed menu
    [configuration.h]
2026-06-21 Added speed menus
    [configuration.h]
2026-06-21 Fixed padding in Bool menu
    [menu.cpp]
2026-06-21 Updated speed menus
    [configuration.h]
2026-06-21 Added detector timeout and cleaned up speed units
    [configuration.h]
2026-06-21 Better track name handling
    [configuration.h]
2026-06-21 Added temperature menus
    [configuration.h]
2026-06-21 Added load/save/print for tempreature configs
2026-06-27 Updated kicad data
2026-06-28 Added axle state machine
2026-06-28 Added main state machine, refactored some IR/axle state machine code.
2026-06-28 Refactored axle state enum
2026-06-28 Variables for direction
    [configuration.h]
2026-06-28 Added direction configuration
    [configuration.h]
2026-06-28 Added infrastructure mode configuration
    [configuration.h]
2026-07-10 Added task yield in PTT delay state to prevent UI lockup
    [audio.cpp, parser.cpp]
2026-07-10 Print configuration on startup
2026-07-11 Temperature functions
    [configuration.h]
2026-07-11 Improved parser functions and test code
    [configuration.h]
2026-07-11 Some improvements? Doesn't quite work right but checking in before debugging and making it worse
    [messages.cpp, messages.h, parser.cpp, parser.h, state-machine.cpp, state-machine.h]
2026-07-11 Record defect axle
2026-07-12 First cut at display messages
2026-07-12 Change from Axle Sensor to Axle Count
2026-07-12 Added ordinals for defect list
    [configuration.h]
2026-07-12 Added excessive alarms
    [configuration.h]
2026-08-01 Added Axle LEDs and axle enable resistors
    [ckt-defect.kicad_sch]
2026-08-01 Support docs
    [screens.ods, temperature.ods]
2026-08-01 v1.2 with axle en protection resistors, axles LEDs, and photomos instead of relay
    [ckt-defect.kicad_pcb, ckt-defect.kicad_sch]
2026-08-01 Panelized version
    [ckt-defect-array.kicad_pcb]
2026-08-02 Removed dependency on axle enable for speed menu
2026-08-02 Go straight to STANDBY from ACTIVE when exiting with no message (e.g. didn't get minimum entrance axles)
    [menu-custom.cpp]
2026-08-02 Fixed several cases where the screen would be blank after returning from the menu
    [menu-custom.cpp, menu-custom.h]
2026-08-02 Trigger direction no longer depends on direction enable
    [menu-factory.cpp]
2026-08-10 Added noise
    [configuration.h]
2026-08-10 Split out white and RTS noise
    [configuration.h]
2026-08-10 Added save/load to noise variables
    [ckt-defect.ino, configuration.cpp]
2026-08-11 Added PTT delay programming
    [configuration.h]
2026-08-11 Added rail configuration
    [configuration.h]
2026-08-12 Rail inserted into messages
2026-08-21 Added speed units and scale calculations
    [configuration.h]
2026-08-25 Added fiducials
    [ckt-defect.kicad_pcb, ckt-defect.kicad_sch]
2026-08-28 Moved SDA/SCL inboard to avoid mousebites in array
    [ckt-defect.kicad_pcb]
2026-08-28 New array
    [ckt-defect-array.kicad_pcb]
2026-08-31 PG defect detector 1.2 array
    [ckt-defect-array-NPTH.drl, ckt-defect-array.drl, ckt-defect-array.gbl, ckt-defect-array.gbo, ckt-defect-array.gbp, ckt-defect-array.gbr, ckt-defect-array.gbs, ckt-defect-array.gm1]
2026-09-01 Made speed independent of axle enable
2026-09-01 Added menu and configuration support for entrance message, alert message, and exit message options
    [configuration.h]
2026-09-01 Update tabs to get away from overhangs and delicate stuff
    [ckt-defect-array.kicad_pcb, ckt-defect.kicad_pcb]
2026-09-01 Remove previous PG - redoing 1.2 array
    [ckt-defect-array-NPTH.drl, ckt-defect-array.drl, ckt-defect-array.gbl, ckt-defect-array.gbo, ckt-defect-array.gbp, ckt-defect-array.gbr, ckt-defect-array.gbs, ckt-defect-array.gm1]
2026-09-01 Move stuff around to make room for mouse holes
    [ckt-defect.kicad_pcb]
2026-09-01 Update array
    [ckt-defect-array.kicad_pcb]
2026-09-01 More moving that !@#$!@$!@#$!@#$ ground plane out of the way
    [ckt-defect-array.kicad_pcb, ckt-defect.kicad_pcb]
2026-09-01 Finally got the array to pg
    [ckt-defect-array-NPTH.drl, ckt-defect-array.drl, ckt-defect-array.gbl, ckt-defect-array.gbo, ckt-defect-array.gbp, ckt-defect-array.gbr, ckt-defect-array.gbs, ckt-defect-array.gm1]
2026-09-04 Menu reconfiguration
    [configuration.h]
2026-09-04 Added defect configuration
    [configuration.h]
2026-09-05 Made talk on defect only apply only to exit message
    [configuration.h]
2026-09-05 Added more defects
    [configuration.h]
2026-09-05 Removed oridnal insertion (moving to messages themselves) Removed duplicate transform message on displayMessage
2026-09-05 Ordinal updates and other stuff
    [configuration.h]
2026-09-07 Moved to ard-axlesim project
    [axle-calculations.ods]
2026-09-07 Moved display test (but still broken)
    [display.h, menu-custom.h]
2026-09-07 Removed old code
    [partitions.csv]
2026-09-07 Rearranged timing configs and added msg repeat timeout
    [configuration.h]
2026-09-07 Added factory reset menu
    [menu-custom.cpp, menu-custom.h, menu-factory.cpp]
2026-09-07 Improved reset delay and method
    [menu-custom.cpp]
2026-09-08 Force write to NVM is it doesn't exist in memory
    [configuration.cpp]
2026-09-08 Moved print NVS function
2026-09-08 Fixed factory reset to re-write NVM with defaults
    [menu-custom.cpp, menu-custom.h, menu-factory.cpp]
2026-09-12 Added config support for vocab
    [configuration.h]
2026-09-12 Adjusted printouts
2026-09-12 More vocab processing
    [configuration.h]
2026-09-13 Changed from try/catch to strtol to avoid exception processing
    [parser.cpp]
2026-09-26 Added 5ms minimum axle spacing
2026-10-10 Added minimum axle time configuration
2026-10-10 Improved Makefile. Upgraded to ARD ESP32 3.3.12
2026-10-10 Added temperature display and refactored temperature enable
2026-10-10 Updated milepost and temperature message enable menus
2026-10-10 Refactored axle enable
2026-10-11 Rail name enable refactoring
2026-10-22 Button changes
2026-10-26 Split min axle message from integrity message
