IowaScaledEngineering/ckt-defect/(notices)

Notices in the files:
kicad/ckt-defect/ckt-defect.kicad_pcb:
©2026 CC BY-SA
